mgm136044/kobi-robot/media/stills/kobi_v2_gesture_demo_f1630.png

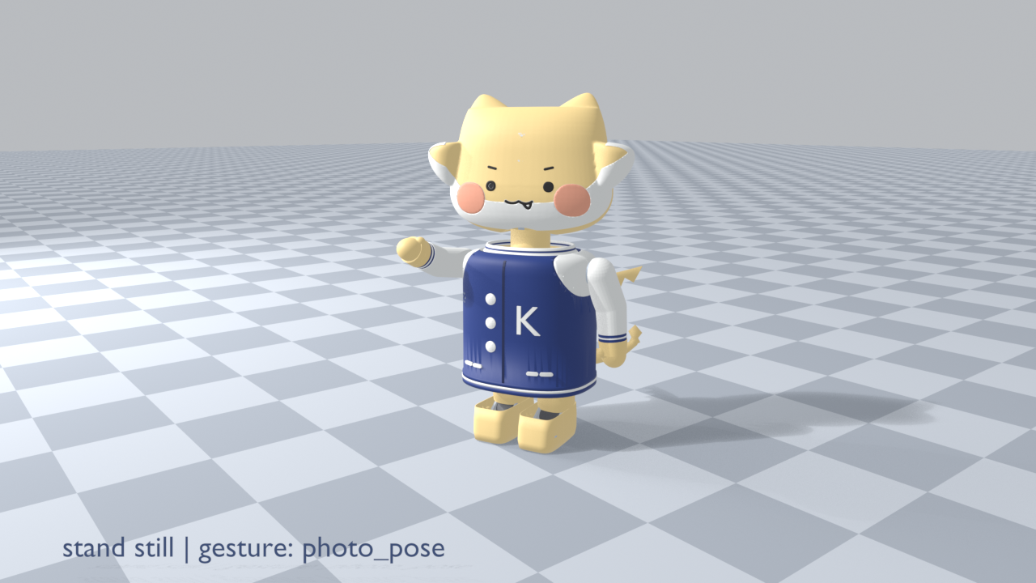
media/stills/kobi_v2_gesture_demo_f1630.png
