mgm136044/kobi-robot/README.md

# 코비(Kobi) 로봇: 소프트웨어 팀 인계 자료

코비는 키 약 0.6 m, 무게 2.78 kg의 작은 두 발 로봇입니다. 오픈소스 로봇 "Open Duck Mini v2"의 다리와 몸통 뼈대를 쓰고, 그 위에 대학 캐릭터 "코리"의 옷(외피)을 입혔습니다. 이 저장소에는 코비의 로봇 모델 파일(URDF, MuJoCo), 3D 프린트 파일, 학습된 걷기 및 몸짓 정책, 정책을 돌려 보는 도구, 시연 영상이 들어 있습니다.

이 문서는 소프트웨어 팀이 코비를 시뮬레이션에서 움직이고, 정책을 다른 소프트웨어(리타게팅, 실기 제어 등)에 연결할 수 있도록 쓴 설명서입니다. 모든 숫자는 이 저장소 안의 파일이나, 저장소 밖에 있는 개발 기록 파일에서 읽은 값이며, 각 절 끝의 "출처" 줄에 파일 이름을 적었습니다. 직접 다시 돌려서 확인한 값은 그렇게 표시했습니다.

**꼭 알아 둘 점: 이 저장소의 모든 성능 숫자는 시뮬레이션에서 잰 값입니다. 실제 로봇에서 정책을 돌린 기록은 이 저장소에 없습니다.**

## 목차

1. 용어 풀이
2. 로봇 소개
3. 폴더 지도
4. 관절 14개
5. 좌표계와 단위
6. URDF와 MuJoCo 장면 불러오기
7. 정책의 입출력 규칙
8. 도구 실행 방법
9. 최종 정책의 측정 결과
10. 알려진 문제
11. 학습 환경은 어떻게 다른가
12. LCD 얼굴 판
13. 라이선스와 출처
14. 애니메이션용 스켈레톤(리그) 파일

## 1. 용어 풀이

- **URDF**: 로봇의 뼈대(링크와 관절), 질량, 관성, 모양을 적는 XML 파일 형식입니다. 많은 로봇 소프트웨어가 읽습니다.
- **MJCF**: MuJoCo 물리 엔진이 쓰는 XML 파일 형식입니다. 이 저장소에서는 `kobi_scene.xml`이 MJCF입니다.
- **MuJoCo**: 로봇 물리 시뮬레이터입니다. 이 저장소의 도구는 MuJoCo 3.14.0으로 확인했습니다.
- **MJX**: MuJoCo를 GPU에서 대량으로 돌리게 해 주는 JAX 버전입니다. 정책은 MJX 3.3.4와 brax PPO로 학습했습니다.
- **PPO**: 강화학습 알고리즘 하나입니다.
- **ONNX**: 학습된 신경망을 프레임워크와 상관없이 실행하게 해 주는 파일 형식입니다. `onnxruntime`으로 읽습니다.
- **정책(policy)**: 관측값 101개를 받아 행동값 14개를 내놓는 신경망입니다.
- **백래시(backlash)**: 기어 사이의 헐거움 때문에 서보 축이 조금 흔들리는 현상입니다. 학습용 장면에는 이를 흉내 낸 가짜 관절이 들어 있습니다.
- **STS3215, MG90S**: 코비가 쓰는 서보 모터 모델 이름입니다. STS3215는 다리와 목, MG90S는 어깨에 씁니다.
- **홈 자세(home pose)**: 코비가 가만히 서 있는 기준 자세입니다. MJCF의 키프레임 `home`으로 정의되어 있습니다.
- **제어 주기**: 정책이 행동을 새로 내놓는 간격입니다. 코비는 초당 50번(50 Hz, 한 번에 0.02초)입니다.

## 2. 로봇 소개

- 뼈대: Open Duck Mini v2(Antoine Pirrone, Apache-2.0)의 다리와 몸통 구조에서 엉덩이 간격을 좁힌 것입니다. 자세한 변경점은 `NOTICE.md`에 있습니다.
- 외피: 3D 프린트로 만든 "코리" 캐릭터 옷(재킷, 꼬리, 날개, 머리 껍데기, 흰 얼굴, 팔 소매, 발 덮개 등)입니다.
- 무게: MJCF의 모든 몸체 질량을 합치면 2.7789782 kg입니다.
- 크기: 홈 자세에서 외형 메시(겉모양 3D 모델)를 모두 모아 재면 높이 0.595 m, 좌우 폭 0.354 m, 앞뒤 길이 0.227 m입니다(이 저장소의 MJCF로 직접 쟀습니다).
- 구동기 14개: 다리 서보 10개(STS3215), 목 서보 2개(좌우 돌리기 `neck_yaw`, 끄덕임 `neck_pitch`, STS3215), 어깨 마이크로 서보 2개(MG90S).
- 정책: MuJoCo 시뮬레이터에서 MJX와 brax PPO로 151,388,160 걸음(약 1억 5,100만 걸음) 학습했습니다. 걷기와 14가지 몸짓(목과 어깨 움직임)을 함께 합니다.

출처: `printed_face/mujoco/kobi_scene.xml`(질량 합과 크기는 직접 계산), 학습 걸음 수는 `코비_학습/TODO.md`와 개발 기록 `kobi_v2_training_results`(둘 다 저장소 밖 파일).

## 3. 폴더 지도

```
kobi-robot/
  README.md                  이 문서
  NOTICE.md                  출처, 라이선스, 우리가 바꾼 점
  LICENSES/Apache-2.0.txt    Open Duck Mini의 Apache-2.0 라이선스 원문
  printed_face/              인쇄 얼굴 판(현재 완성된 코비)
    urdf/                      kobi.urdf(메시 포함), kobi_gait.urdf(목, 어깨 고정, 메시 없음), assets/(STL 60개 + 내려받는 11개)
    mujoco/                    kobi_scene.xml, kobi_scene_backlash.xml(학습용), assets/(STL 80개 + 내려받는 28개)
    print/                     3D 프린트용 STL 96개(body, face, head, mech 폴더)와 parts_table.json, fit_coupon.stl
    blender/kobi_v7.blend      블렌더 모델(61 MB, 코리 참고 그림 이미지와 개인 경로를 지움)
    skeleton/                  애니메이션용 스켈레톤: kobi_rig.blend/.fbx/.glb, kobi_skeleton.bvh, skeleton.json, README.md(14절)
  policy/
    kobi_v2_final_151M.onnx              최종 정책
    lcd_face/                            LCD 얼굴 판 정책(ONNX 1개)과 평가 결과 JSON 5개(12절)
    polynomial_coefficients_kobi.pkl     기준 걸음 데이터(학습 때 모방 대상)
    kobi_gestures.py                     몸짓 14가지(거울 대칭 포함 22개) 정의
  tools/                     정책 재생기, 평가기, URDF 생성기와 검사기
    skeleton/                  스켈레톤 추출, 리그 생성(Blender), 검증 도구(14절)
  media/                     시연 영상 MP4 2개와 정지화면 8장
  lcd_face/                  LCD 얼굴 판(모델 7b판, 2차 공개): MuJoCo 장면, 프린트 파일, Blender 모델, 부품표 v12, 인쇄 부품 질량(mass/), 시연 영상, 조립 설명서(manual/), 소프트웨어 인계 문서(SOFTWARE_HANDOFF.md), README(12절)
```

`printed_face/mujoco/` 한 폴더에 일반 장면(`kobi_scene.xml`)과 학습용 장면(`kobi_scene_backlash.xml`)을 함께 두었습니다. 두 장면이 쓰는 메시 파일이 바이트 단위로 같고 `kobi_scene.xml`도 두 원본이 같아서, 같은 `assets/` 폴더를 같이 씁니다.

저장소 밖의 생성 파일(`out/`)은 도구를 돌리면 저장소 맨 위에 생기며 `.gitignore`로 제외했습니다.

## 4. 관절 14개

정책의 관측, 행동, MJCF의 구동기 순서가 모두 아래 표의 순서(0부터 13)입니다. URDF의 관절 순서도 같지만, 다른 도구로 읽을 때는 순서에 기대지 말고 이름으로 찾는 것이 안전합니다.

| 번호 | 이름 | 하는 일 | 움직일 수 있는 범위 (도) | 범위 (라디안) | 홈 자세 값 (라디안) | 회전축(자기 몸체 기준) | 토크 한계 (N·m) |
|---|---|---|---|---|---|---|---|
| 0 | left_hip_yaw | 왼쪽 엉덩이 비틀기 | -30 ~ 30 | -0.5236 ~ 0.5236 | 0.002 | z | 1.91 |
| 1 | left_hip_roll | 왼쪽 엉덩이 옆으로 벌리기 | -25 ~ 25 | -0.4363 ~ 0.4363 | 0.053 | z | 1.91 |
| 2 | left_hip_pitch | 왼쪽 엉덩이 앞뒤 | -70 ~ 30 | -1.2217 ~ 0.5236 | -0.9303 | z | 1.91 |
| 3 | left_knee | 왼쪽 무릎 | -90 ~ 90 | -1.5708 ~ 1.5708 | 1.3812 | z | 1.91 |
| 4 | left_ankle | 왼쪽 발목 | -90 ~ 90 | -1.5708 ~ 1.5708 | -0.4815 | z | 1.91 |
| 5 | right_hip_yaw | 오른쪽 엉덩이 비틀기 | -30 ~ 30 | -0.5236 ~ 0.5236 | -0.003 | z | 1.91 |
| 6 | right_hip_roll | 오른쪽 엉덩이 옆으로 벌리기 | -25 ~ 25 | -0.4363 ~ 0.4363 | -0.065 | z | 1.91 |
| 7 | right_hip_pitch | 오른쪽 엉덩이 앞뒤 | -30 ~ 70 | -0.5236 ~ 1.2217 | 0.9353 | z | 1.91 |
| 8 | right_knee | 오른쪽 무릎 | -90 ~ 90 | -1.5708 ~ 1.5708 | 1.3922 | z | 1.91 |
| 9 | right_ankle | 오른쪽 발목 | -90 ~ 90 | -1.5708 ~ 1.5708 | -0.4871 | z | 1.91 |
| 10 | neck_yaw | 목 좌우 돌리기 | -30 ~ 30 | -0.5236 ~ 0.5236 | 0 | z | 1.91 |
| 11 | neck_pitch | 목 끄덕임 | -10 ~ 10 | -0.1745 ~ 0.1745 | 0 | y | 1.91 |
| 12 | shoulder_left | 왼쪽 어깨 | -135 ~ 25 | -2.356 ~ 0.4363 | 0 | y | 0.20 |
| 13 | shoulder_right | 오른쪽 어깨 | -135 ~ 25 | -2.356 ~ 0.4363 | 0 | y | 0.20 |

표를 읽을 때 알아 둘 점은 다음과 같습니다.

- **왼쪽과 오른쪽 다리는 부호가 거울처럼 반대인 관절이 있습니다.** 엉덩이 앞뒤(hip_pitch)는 왼쪽이 -0.93, 오른쪽이 +0.94가 홈 자세이고, 범위도 -70~30도와 -30~70도로 서로 뒤집혀 있습니다. 엉덩이 옆으로 벌리기(hip_roll)도 부호가 반대입니다(+0.053, -0.065). 무릎은 두 다리 모두 양수(약 1.38, 1.39), 발목은 두 다리 모두 음수(약 -0.48, -0.49)입니다.
- **토크 한계 1.91 N·m는 사용자가 정한 값입니다.** STS3215 서보의 7.4 V 정지 토크 자료값이며, URDF에는 effort 1.91로 들어 있습니다. 그런데 `kobi_scene.xml` 파일 안의 구동기 힘 범위는 ±3.23 N·m로 적혀 있습니다. 학습할 때는 코드(`tools/kobi_env_mirror.py`의 `apply_torque_limits`)가 시작할 때 다리와 목을 ±1.91, 어깨를 ±0.20으로 덮어씁니다. 정책을 재생하려면 이 덮어쓰기가 필요하므로, XML만 불러서 직접 돌리면 학습 때보다 힘이 큰 로봇이 됩니다.
- **어깨의 0.20 N·m는 근거를 확인하지 못한 값입니다.** MJCF에 적힌 값을 그대로 썼고, URDF 생성기 주석에도 "source unconfirmed(출처 미확인)"라고 되어 있습니다.
- 속도 한계는 URDF에 5.24 rad/s로 들어 있습니다. 이는 학습 환경이 모터 목표값을 바꿀 수 있는 최대 속도입니다.
- 서보의 위치 제어 세기(kp)는 다리와 목이 일반 장면(`kobi_scene.xml`)에서 13.37, 학습용 장면(`kobi_scene_backlash.xml`)에서 17.11이고, 어깨는 두 장면 모두 1.0입니다. 감쇠 0.56, 마찰 손실 0.068, 전기자 관성 0.027은 다리와 목 서보 공통 값입니다.
- 학습용 장면은 다리 관절 10개마다 백래시용 가짜 관절(이름 끝이 `_backlash`, 범위 ±0.5도, 구동기 없음)이 하나씩 더 붙어 관절이 25개(구동기는 여전히 14개)입니다.

출처: `printed_face/mujoco/kobi_scene.xml`, `kobi_scene_backlash.xml`(MuJoCo 3.14.0으로 읽어 직접 출력), `printed_face/urdf/kobi.urdf`, `tools/build_urdf.py`, `tools/kobi_env_mirror.py`.

## 5. 좌표계와 단위

- **월드(세계) 좌표계**: MuJoCo 기준의 오른손 좌표계입니다. x는 로봇이 바라보는 앞쪽, y는 로봇의 왼쪽, z는 위쪽입니다. 바닥은 z = 0이고 중력은 -9.81 m/s²입니다.
- **단위**: 길이는 미터(m), 질량은 킬로그램(kg), 시간은 초(s), 각도는 라디안(rad), 토크는 N·m입니다. 속도는 m/s와 rad/s입니다. 예외로 3D 프린트용 STL(`printed_face/print/`)은 밀리미터(mm)입니다(부품표에 `size_mm`로 적혀 있습니다).
- **메시 파일의 크기 배율**: 일부 메시는 밀리미터 단위로 저장되어 있어 파일 안에 배율 0.001이 적혀 있습니다. 다른 메시는 배율 1입니다. URDF와 MJCF의 `scale` 값을 무시하지 마세요.
- **MuJoCo의 `base`와 `trunk_assembly`**: 질량이 0인 `base` 몸체가 자유 관절 `floating_base`(위치 3개, 사원수 4개)를 갖고, 그 안에 `trunk_assembly`(몸통, 1.28934 kg)가 같은 위치에 있습니다. URDF는 이 둘을 합쳐 `trunk_assembly`를 뿌리 링크로 씁니다.
- **홈 자세의 몸체 위치**: 키프레임 `home`에서 자유 관절 위치는 (0.0353725, 0, 0.206397) m, 방향은 사원수 (w, x, y, z) = (1, 0, 0, 0)입니다.
- **사원수 순서**: MuJoCo는 (w, x, y, z)입니다. ROS 등은 (x, y, z, w)이므로 변환이 필요합니다.
- **관성 측정 장치(IMU)**: 자이로(각속도)와 가속도계는 `imu` 위치점에 달려 있고, 위치는 `trunk_assembly` 기준 (-0.08, 0, 0.05) m입니다. 관측값에 들어가는 자이로와 가속도 값은 이 점의 몸체 좌표입니다.
- **발 위치점**: `left_foot`, `right_foot`(URDF에는 `left_foot_frame`, `right_foot_frame`). 정책이 발 접촉을 판단할 때는 TPU 발바닥 메시 `left_foot_bottom_tpu`, `right_foot_bottom_tpu`와 바닥 `floor`의 접촉을 봅니다.
- **몸짓 부호 약속**: `neck_yaw`가 양수이면 머리가 로봇의 왼쪽으로 돌아갑니다. `neck_pitch`가 양수이면 고개를 숙입니다. 어깨는 음수이면 팔이 앞쪽 위로 올라가고, 양수이면 뒤로 젖혀집니다(양쪽 어깨 부호 약속이 같습니다).
- **블렌더 파일의 방향**: `kobi_v7.blend` 안의 코비는 MuJoCo의 +x가 아니라 -y 방향을 바라봅니다. MuJoCo 좌표에서 블렌더 좌표로 갈 때 z축 기준 -90도 회전이 필요합니다.

출처: `printed_face/mujoco/kobi_scene.xml`, `printed_face/urdf/kobi.urdf`, `policy/kobi_gestures.py`의 머리말, `코비_학습/video/README.md`(저장소 밖).

## 6. URDF와 MuJoCo 장면 불러오기

### 6.0 처음 한 번 할 일: 업스트림 메시 내려받기

**저장소를 받은 뒤 가장 먼저 아래 명령을 한 번 실행하세요.** 이 명령 없이 URDF나 MuJoCo 장면을 열면 메시 파일이 없다는 오류가 납니다.

```
python3 tools/fetch_upstream_meshes.py
```

이 명령은 `lcd_face/mujoco/assets/`에도 같은 28개를 내려받습니다(LCD 얼굴 판 장면이 같은 메시를 씁니다). 이유는 다음과 같습니다. 뼈대 부품 메시 28개(`printed_face/mujoco/assets/`, 그 가운데 11개는 `printed_face/urdf/assets/`에도 필요)는 Open_Duck_Playground 저장소에 있는 단순화된 파일인데, 그 저장소에 라이선스가 없어서 우리가 이 저장소에 담아 다시 배포할 수 없습니다. 그래서 이 스크립트가 GitHub의 고정된 커밋(`b9be205ac64488c23504ca42e5ec790337adeec3`)에서 정확히 그 파일들만 내려받고, 스크립트 안의 SHA-256 표와 하나씩 맞춰 본 뒤에만 저장합니다. 해시가 다르면 파일을 쓰지 않습니다. 이미 맞는 파일이 있으면 건너뜁니다. 파이썬 표준 라이브러리만 쓰며 인터넷이 필요합니다. `python3 tools/fetch_upstream_meshes.py --check`는 내려받지 않고 확인만 합니다. 자세한 사정은 `NOTICE.md` 3절에 있습니다.

### 6.1 불러오기

먼저 파이썬 환경을 만듭니다(전역 설치 없이 `uv`로 임시 환경을 씁니다).

```
uv run --no-project --python 3.12 --with mujoco==3.14.0 --with numpy --with onnxruntime python -I 스크립트.py
```

MuJoCo 장면 불러오기는 다음과 같습니다.

```python
import mujoco
model = mujoco.MjModel.from_xml_path("printed_face/mujoco/kobi_scene.xml")
data = mujoco.MjData(model)
key = mujoco.mj_name2id(model, mujoco.mjtObj.mjOBJ_KEY, "home")
mujoco.mj_resetDataKeyframe(model, data, key)
mujoco.mj_forward(model, data)
```

`tools/fetch_upstream_meshes.py`를 실행한 뒤, MuJoCo 3.14.0으로 직접 불러 본 결과(이 저장소의 폴더 배치 그대로)는 다음과 같습니다.

| 파일 | 몸체 수(nbody) | 관절 수(njnt) | 구동기 수(nu) | 비고 |
|---|---|---|---|---|
| `printed_face/mujoco/kobi_scene.xml` | 18 | 15 | 14 | 자유 관절 1개 + 14개, 상태 변수(nq) 21개 |
| `printed_face/mujoco/kobi_scene_backlash.xml` | 18 | 25 | 14 | 백래시 관절 10개 추가, nq 31개 |
| `printed_face/urdf/kobi.urdf` | 21 | 14 | 0 | 자유 관절이 없음(MuJoCo가 읽으면 고정 몸체), 메시 71개 |
| `printed_face/urdf/kobi_gait.urdf` | 21 | 10 | 0 | 목과 어깨 4개가 고정되어 관절 10개, 메시 없음 |

(몸체 수 18은 `world`, `base`, 몸통, 다리 몸체 10개, 목 2개, 팔 2개, 바닥 `floor`를 센 값입니다. URDF의 21은 `world`와 링크 20개입니다.)

URDF를 쓰는 방법과 주의할 점은 다음과 같습니다.

- `printed_face/urdf/kobi.urdf`의 메시 경로는 `assets/...`처럼 URDF 파일 위치 기준 상대 경로입니다. 파일을 옮길 때는 `assets/` 폴더를 같이 옮기세요.
- `kobi_gait.urdf`는 걸음 기준 데이터를 만드는 도구(placo)용입니다. 목과 어깨를 0도에 고정해서, 걸음 생성기가 무게 중심을 맞추려고 머리와 팔을 멋대로 움직이지 못하게 했습니다.
- 충돌 모양은 TPU 발바닥 두 개뿐입니다. MJCF의 다른 충돌 모양(캡슐, 타원체)은 URDF로 표현할 수 없어 뺐습니다.
- URDF는 MJCF를 읽어서 만든 것이고, 질량, 무게 중심, 관성은 MuJoCo가 실제로 시뮬레이션하는 값과 같습니다. `tools/check_urdf.py`가 이를 확인하며, 이 저장소에서 다시 돌려 통과했습니다(`"ok": true`; 무작위 관절 각도 200가지, 전체 질량 오차 0, 링크 자세 오차 약 1e-9 m, 메시 꼭짓점 오차 약 6.6e-7 m, 관성 상대 오차 약 2.6e-9).
- 개발 기록에는 pinocchio 4.1.0으로 URDF를 읽어도 질량과 무게 중심이 같았다고 적혀 있습니다(이번에 다시 확인하지는 않았습니다).
- 모델이 바뀌면 URDF를 다시 만드세요. `tools/build_urdf.py`를 돌린 뒤 `tools/check_urdf.py`를 돌립니다. 다시 만든 URDF는 이 저장소의 파일과 한 줄(맨 위 설명 주석) 말고는 같았습니다.

출처: `tools/check_urdf.py` 실행 결과(직접 실행), `tools/build_urdf.py`, 개발 기록 `kobi_urdf_export`(저장소 밖).

## 7. 정책의 입출력 규칙

정책 파일은 `policy/kobi_v2_final_151M.onnx`입니다(SHA-256 `3d5367279866c7e718c5d3fc22e51fb144d9ae5a6d753c0b865bd96dabc6cd6b`). 입력 이름은 `obs`, 모양은 [1, 101], 자료형은 float32입니다. 출력 이름은 `continuous_actions`, 모양은 [1, 14]입니다. 관측값 정규화는 ONNX 파일 안에 들어 있으므로 바깥에서 정규화하지 않습니다. 출력은 tanh를 거친 값이라 -1에서 1 사이입니다.

이 규칙은 학습 환경의 코드를 그대로 옮긴 `tools/kobi_env_mirror.py`에서 읽었습니다. 정책을 다른 소프트웨어에 붙일 때 이 파일을 기준 문서로 삼으세요.

### 7.1 시간 간격

- 제어 주기: 0.02초(50 Hz). 정책은 이 간격으로 한 번씩 행동을 냅니다.
- 물리 시뮬레이션 간격: 0.002초(500 Hz). 제어 한 번마다 물리를 10번 진행합니다.

### 7.2 관측 벡터 101개의 배치

| 위치 | 개수 | 이름 | 뜻 |
|---|---|---|---|
| [0:3] | 3 | gyro | IMU의 각속도(rad/s), 몸체 좌표 |
| [3:6] | 3 | accelerometer | IMU의 가속도(m/s²), 몸체 좌표 |
| [6:13] | 7 | command | 명령 7개: [vx, vy, wz, 목 좌우 목표, 목 끄덕임 목표, 왼쪽 어깨 목표, 오른쪽 어깨 목표] |
| [13:27] | 14 | joint_angles_minus_home | 관절 각도에서 홈 자세 값을 뺀 것(rad), 4절 표의 순서 |
| [27:41] | 14 | joint_velocity_x0.05 | 관절 속도(rad/s)에 0.05를 곱한 것 |
| [41:55] | 14 | last_action | 지난 행동 기록 첫째 칸(아래 주의 참고) |
| [55:69] | 14 | last_last_action | 지난 행동 기록 둘째 칸 |
| [69:83] | 14 | last_last_last_action | 지난 행동 기록 셋째 칸 |
| [83:97] | 14 | motor_targets | 직전에 모터에 준 목표 각도(rad, 속도 제한을 거친 값) |
| [97:99] | 2 | foot_contacts | 왼발, 오른발 발바닥이 바닥에 닿으면 1, 아니면 0 |
| [99:101] | 2 | imitation_phase | 걸음 주기의 위상 (cos, sin) |

합계는 3 + 3 + 7 + 14 + 14 + 14 + 14 + 14 + 14 + 2 + 2 = 101입니다.

각 항목에서 놓치기 쉬운 점입니다.

- **지난 행동 기록 세 칸은 직전 행동이 아닙니다.** 학습 환경은 관측을 만든 뒤에 행동 기록을 한 칸 밀기 때문에, 제어 단계 k의 관측에는 a(k-2), a(k-3), a(k-4)가 들어 있습니다. 가장 최근 행동 a(k-1)은 들어 있지 않습니다. 업스트림(원본 Open Duck Mini 런타임)의 `mujoco_infer.py`는 a(k-1), a(k-2), a(k-3)을 넣으므로, 그 코드를 그대로 쓰면 학습 때와 어긋납니다.
- **가속도계에 1.3을 더하지 마세요.** 업스트림 런타임은 가속도 x에 +1.3을 더하는데, 학습 환경에서는 그 덧셈이 버려져 학습 관측에는 없습니다.
- **관절 각도**: 시뮬레이션에서는 다리 관절 10개의 각도에 백래시 가짜 관절의 각도를 더한 값을 씁니다. 관절 속도에는 백래시 속도를 더하지 않습니다.
- **발 접촉**: 발바닥 메시가 바닥 면과 실제로 겹칠 때(거리가 0보다 작을 때) 1입니다.
- **걸음 위상**: 제어 단계마다 한 칸씩 늘어나는 번호 i를 쓰며 한 주기가 27단계(0.54초)입니다. 값은 (cos(2πi/27), sin(2πi/27))이고, 시작할 때는 (0, 0)입니다. 위상은 명령이 0이어도 계속 돕니다.
- **관측 잡음**: 학습할 때만 넣었습니다. 각 항목에 균등 분포로 ±(크기)를 더했고 크기는 자이로 0.1, 가속도 0.05, 엉덩이 각도 0.03, 무릎 각도 0.05, 발목 각도 0.08, 목과 어깨 각도 0.05, 관절 속도 2.5입니다. 재생 도구는 기본값 0이고 `--noise-level 1.0`으로 학습 때와 같게 할 수 있습니다.
- 학습할 때는 행동이 모터에 닿기까지 0~2단계(0, 20, 40 ms) 늦어지는 경우를 무작위로 섞었습니다. 재생 도구의 기본값은 0단계입니다.

### 7.3 행동 벡터 14개와 크기 조정

행동 14개의 순서는 4절 표의 번호와 같습니다.

- **다리(번호 0~9)**: 모터 목표 각도 = 홈 자세 값 + 0.25 × 행동. 행동이 ±1이면 홈에서 ±0.25 rad(약 14도) 움직입니다.
- **목과 어깨(번호 10~13)**: 모터 목표 각도 = clip(몸짓 목표 + 보정 크기 × 행동, 관절 범위). 보정 크기는 목 좌우 0.10 rad, 목 끄덕임 0.05 rad, 어깨 둘 다 0.15 rad입니다. 정책은 몸짓 목표를 중심으로 이만큼만 미세 조정할 수 있습니다. 목과 어깨를 정책에 직접 시키는 것이 아니라, 몸짓 목표를 따라가게 하는 구조입니다.
- **속도 제한**: 위에서 계산한 목표를 이전 목표에서 최대 5.24 rad/s × 0.02 s = 0.1048 rad까지만 바꿀 수 있게 자릅니다. 14개 모두에 적용됩니다.
- 모터에는 이 최종 목표를 위치 명령으로 줍니다.

### 7.4 명령 입력

관측의 command 일곱 칸 중 앞의 세 칸이 걷기 명령입니다.

| 칸 | 뜻 | 학습 범위 | 단위 |
|---|---|---|---|
| vx | 앞으로 가는 속도(뒤로 가려면 음수) | -0.15 ~ 0.15 | m/s |
| vy | 왼쪽으로 가는 속도(오른쪽은 음수) | -0.074 ~ 0.074 | m/s |
| wz | 위에서 봤을 때 반시계 방향 회전 속도 | -1.0 ~ 1.0 | rad/s |

- 범위를 벗어난 명령은 학습한 적이 없으므로 쓰지 마세요. vy를 ±0.074로 제한한 이유는, 기준 걸음 데이터의 옆걸음 격자가 거기까지이고 더 빠르면 발 덮개끼리 부딪히기 때문입니다.
- 학습 중 걷기 명령은 10%의 확률로 모두 0(제자리)이 됩니다.
- 속도는 몸체 좌표 기준입니다.

### 7.5 몸짓 입력

command의 뒤 네 칸(번호 3~6)은 "몸짓 목표 각도"입니다. 순서는 목 좌우, 목 끄덕임, 왼쪽 어깨, 오른쪽 어깨이며 절대 각도(라디안), 홈 자세는 0입니다. 정책에는 몸짓의 이름이나 번호를 알려 주지 않고, 매 제어 단계(50 Hz)마다 그 순간의 목표 각도 네 개를 넣어 줍니다. 몸짓은 걷기 명령과 독립이라서 서 있을 때도, 걸을 때도 할 수 있습니다.

`policy/kobi_gestures.py`가 몸짓을 정의합니다. 각 몸짓은 키프레임(시간, 목 좌우, 목 끄덕임, 왼쪽 어깨, 오른쪽 어깨, 단위는 도)의 목록이고, 사이는 코사인 곡선으로 부드럽게 잇습니다. `sample()` 함수가 50 Hz 목표 각도 배열(라디안)을 만들어 줍니다. 목표는 관절 범위 안쪽 2도 이내에 두고, 최대 속도는 초당 200도로 제한했습니다.

| 이름 | 뜻 | 길이(초) |
|---|---|---|
| idle | 대기 | 2.0 |
| look_left_right | 고개 좌우 시범 | 3.0 |
| nod | 끄덕임 | 1.9 |
| shake_no | 고개 젓기("아니야") | 1.5 |
| wave_right | 인사(오른손 흔들기) | 3.2 |
| bow | 꾸벅 인사 | 1.9 |
| guide_left | 안내(왼쪽) | 3.1 |
| cheer | 응원, 파이팅 | 3.6 |
| celebrate | 축하, 만세 | 3.4 |
| photo_pose | 사진 포즈 | 3.8 |
| surprise | 놀람 | 2.0 |
| look_far | 멀리 보기 | 4.2 |
| think | 생각하기, 관찰 | 2.6 |
| like | 좋아 | 2.4 |

위 14개에 거울 대칭 8개(`look_right_left`, `shake_no_mirror`, `wave_left`, `guide_right`, `cheer_mirror`, `photo_pose_mirror`, `look_far_mirror`, `think_mirror`)를 더해 모두 22개입니다. 거울 대칭은 목 좌우 부호를 바꾸고 양쪽 어깨를 맞바꾼 것입니다. 학습할 때는 몸짓을 0.8~1.25배 속도로 재생했고, 몸짓 사이에 대기(idle)를 1~3초 끼웠습니다.

### 7.6 기준 걸음 데이터

`policy/polynomial_coefficients_kobi.pkl`은 학습 때 "이렇게 걸어라" 하고 모방하게 한 기준 걸음입니다. 파이썬 pickle 파일이므로 신뢰하는 파일만 여십시오(pickle은 열 때 코드를 실행할 수 있습니다). 이 저장소의 도구는 이 파일에서 걸음 주기(0.54초, 50 Hz, 27단계)만 읽습니다. 내용은 속도 명령 격자 180칸(앞뒤 6가지, 옆 3가지, 회전 10가지)마다 다항식 계수가 28채널 들어 있습니다(다리 관절 위치 10, 속도 10, 발 접촉 2, 월드 선속도 3, 월드 각속도 3). 앞뒤 속도 격자는 -0.148~0.222 m/s, 옆 속도 격자는 -0.074, 0, 0.074 m/s, 회전 격자는 -1.111~1.222 rad/s입니다. 이 걸음은 `kobi_gait.urdf`를 걸음 생성기(placo 기반)에 넣어 만든 것입니다.

기준 걸음의 한계로 개발 기록에는 다음 값이 있습니다. 엉덩이 앞뒤 관절 목표가 관절 범위를 넘는 비율이 두 다리에서 각각 4.7%와 8.8%이고, 180칸 중 11칸에서 발 덮개가 최대 2.5 mm 겹칩니다.

출처: `tools/kobi_env_mirror.py`(관측 배치, 행동 규칙, 상수), `policy/kobi_gestures.py`, `policy/polynomial_coefficients_kobi.pkl`(직접 열어 확인), ONNX 입출력 모양(onnxruntime으로 직접 확인), 명령 범위는 학습 환경 `joystick.py`의 설정(저장소 밖)과 `tools/schedule.py` 주석, 기준 걸음 한계는 `코비_학습/playground_kobi/CHANGES.md`(저장소 밖).

## 8. 도구 실행 방법

모든 명령은 저장소 맨 위 폴더에서 실행합니다. 6.0절의 메시 내려받기(`python3 tools/fetch_upstream_meshes.py`)를 먼저 해야 합니다. 실행에 필요한 것은 `uv`와 인터넷(처음 한 번 패키지 내려받기)뿐입니다. 파이썬 3.12, `mujoco==3.14.0`, `numpy`, `onnxruntime`을 임시 환경으로 씁니다. 이 도구들은 학습에 쓴 MJX 3.3.4가 아니라 일반 MuJoCo(C 버전) 3.14.0으로 정책을 재생하므로, 접촉 계산이 미세하게 다를 수 있습니다.

### 8.1 정책 재생기: `tools/record_policy.py`

정책을 시뮬레이션에서 돌려 몸체 자세를 파일로 저장합니다.

```
uv run --no-project --python 3.12 --with onnxruntime --with mujoco==3.14.0 --with numpy python -I tools/record_policy.py \
    --policy policy/kobi_v2_final_151M.onnx --schedule walk_demo --out out/walk_demo.npz
```

- `--schedule`로 명령 일정을 고릅니다. `preview`(16.2초, 기본값), `walk_demo`(38초: 앞으로, 돌기, 뒤로, 옆걸음), `gesture_demo`(63.5초: 몸짓 14가지를 서서 한 뒤 걸으며 손 흔들기, 끄덕이기, 환호).
- `--dry-run`을 주면 정책 없이 행동 0으로 돕니다.
- 기본 저장 위치는 `out/policy_motion.npz`입니다. `--noise-level`(기본 0), `--action-delay`(기본 0, 0~2단계)로 학습 때 조건을 흉내 낼 수 있습니다.
- 저장 파일에는 몸체 위치 `xpos`(프레임 수 × 몸체 수 × 3), 방향 `xquat`(프레임 수 × 몸체 수 × 4, 순서 w x y z), 초당 프레임 수 `fps`(50), 그리고 관측 `obs`, 행동 `actions`, 모터 목표 `motor_targets`, 명령 `commands`, 몸짓 목표 `upper_targets`가 들어 있습니다.
- 직접 확인한 결과: 기본 일정(`preview`)은 이 Mac에서 약 4초에 끝나고 810프레임(16.2초)을 저장했으며, 넘어지지 않았습니다. 같은 일정을 원본 폴더의 원본 파일로 돌린 결과와 `xpos`, `xquat`, `obs`, `actions`가 모두 정확히 같았습니다.

### 8.2 정책 평가기: `tools/evaluate_policy.py`

속도 추종 11가지, 밀기 192회, 몸짓 88회를 한꺼번에 재고 결과를 JSON으로 저장합니다.

```
uv run --no-project --python 3.12 --with onnxruntime --with mujoco==3.14.0 --with numpy python -I tools/evaluate_policy.py \
    --policy policy/kobi_v2_final_151M.onnx --tag final --workers 6 --no-motions
```

- 결과는 `out/eval_final.json`에 저장됩니다. `--quick`은 조건마다 한 번만 돌립니다. `--action-delay 1`이나 `2`로 행동 지연을 줄 수 있습니다.
- 학습 때처럼 관측 잡음 1.0, 행동 지연 0, 홈 자세에서 시작하는 결정적 출발을 기본으로 합니다. 넘어짐은 몸통이 60도보다 더 기울면 넘어진 것으로 칩니다.
- 이 Mac(Apple 실리콘)에서 346회 전체가 작업자 6개로 약 6.6초 걸렸습니다.

### 8.3 제자리 서기 검사기: `tools/stand_still_probe.py`

걷기 명령이 0일 때 발이 바닥에 얼마나 닿는지 잽니다(10절의 "제자리 걸음" 근거).

```
uv run --no-project --python 3.12 --with onnxruntime --with mujoco==3.14.0 --with numpy python -I tools/stand_still_probe.py
```

### 8.4 URDF 생성기와 검사기: `tools/build_urdf.py`, `tools/check_urdf.py`

```
uv run --no-project --python 3.12 --with mujoco==3.14.0 --with numpy python -I tools/build_urdf.py
uv run --no-project --python 3.12 --with mujoco==3.14.0 --with numpy python -I tools/check_urdf.py
```

생성기는 `printed_face/urdf/`의 파일을 덮어씁니다. 확인만 하려면 검사기만 돌리세요.

### 8.5 이 저장소에 없는 도구

블렌더로 MP4를 렌더링하는 스크립트(`animate_motion.py`, `render_motion.py`), 환경 거울이 학습 환경과 같은지 검사하는 `check_env_mirror.py`는 넣지 않았습니다. 뒤의 것은 학습 환경 소스(라이선스가 없는 업스트림을 바탕으로 한 것이라 이 저장소에 넣지 않았습니다)를 읽어야 돌아가기 때문입니다. 시연 영상은 `media/`에 이미 렌더된 것이 있습니다.

### 8.6 경로를 바꾼 곳

도구는 원본을 복사한 것이며 아래 경로 설정만 이 저장소 배치에 맞게 고쳤습니다. 계산 코드는 바꾸지 않았습니다.

- `tools/kobi_env_mirror.py`: 학습 환경 폴더의 절대 경로(내 컴퓨터 경로)를 저장소 안의 상대 경로(`printed_face/mujoco/kobi_scene_backlash.xml`, `policy/polynomial_coefficients_kobi.pkl`)로 바꿨습니다. 머리말 설명에서도 절대 경로를 뺐습니다.
- `tools/record_policy.py`: 기본 저장 위치를 저장소 맨 위의 `out/`으로 바꾸고, 머리말의 실행 예를 새 경로로 고쳤습니다.
- `tools/evaluate_policy.py`: 기본 저장 폴더를 `out/`으로 바꿨습니다.
- `tools/schedule.py`: 몸짓 정의를 `policy/kobi_gestures.py`에서 찾도록 경로를 바꿨습니다.
- `tools/build_urdf.py`, `tools/check_urdf.py`: MJCF와 URDF 위치를 `printed_face/` 아래로 바꿨습니다. `build_urdf.py`가 URDF 첫머리에 쓰는 설명 주석의 경로도 같이 고쳤습니다.
- `tools/stand_still_probe.py`와 `tools/fetch_upstream_meshes.py`는 이번에 새로 쓴 도구입니다.

출처: `tools/` 폴더의 각 파일(직접 실행), 개발 기록 `kobi_video_pipeline`(저장소 밖).

## 9. 최종 정책의 측정 결과

정책은 `policy/kobi_v2_final_151M.onnx`(학습 1억 5,138만 걸음)입니다. 1억 4,000만 걸음 정책과 같은 방식으로 비교해, "최종이 뚜렷이 나쁘지 않으면 최종을 쓴다"는 정해 둔 규칙에 따라 최종을 골랐습니다(밀기에서 넘어진 횟수가 1억 4,000만 걸음 정책 84회, 최종 77회로 우연으로 볼 만한 차이였습니다).

**측정 조건**: 시뮬레이션(MuJoCo 3.14.0, 백래시 장면), 관측 잡음 1.0, 행동 지연 0, 홈 자세에서 출발, 346회 전체. 이 표는 이 저장소의 `tools/evaluate_policy.py`로 다시 돌려서 확인했고, 개발 기록의 값과 모두 같았습니다.

### 9.1 쓰러지지 않고 따라가는가

| 시험 | 횟수 | 넘어진 횟수 |
|---|---|---|
| 속도 추종(11가지 명령, 가지마다 6회) | 66 | 0 |
| 몸짓(22가지, 서서와 0.1 m/s로 걸으며, 2회씩) | 88 | 0 |
| 밀기(아래) | 192 | 77 |

몸짓 시험에서 목과 어깨가 목표를 따라가는 오차는 22가지 몸짓 중 가장 큰 관절별 평균 오차가 0.061 rad이고, 한 순간 가장 크게 벗어난 값은 0.123 rad였습니다. 몸통 기울기는 몸짓 시험에서 최대 7.2도였습니다.

### 9.2 명령한 속도와 실제 속도

10초 동안 잰 몸체 좌표 평균 속도입니다(6회 평균).

| 명령 | 실제 vx (m/s) | 실제 vy (m/s) | 실제 wz (rad/s) |
|---|---|---|---|
| 앞으로 vx = 0.05 | 0.058 | 0.014 | -0.009 |
| 앞으로 vx = 0.10 | 0.119 | 0.015 | -0.031 |
| 앞으로 vx = 0.15 | 0.166 | 0.015 | -0.019 |
| 뒤로 vx = -0.10 | -0.102 | -0.008 | -0.015 |
| 왼쪽 옆걸음 vy = +0.074 | 0.007 | 0.087 | -0.008 |
| 오른쪽 옆걸음 vy = -0.074 | 0.008 | -0.064 | 0.030 |
| 회전 wz = +0.5 | 0.010 | 0.037 | 0.502 |
| 회전 wz = -0.5 | 0.003 | -0.025 | -0.459 |
| 회전 wz = +1.0 | 0.018 | 0.071 | 0.977 |
| 회전 wz = -1.0 | 0.009 | -0.071 | -0.953 |
| 정지 (0, 0, 0) | 0.003 | 0.013 | 0.015 |

읽는 법: 앞으로 가는 속도는 명령보다 조금 빠르게(0.10을 시키면 0.119) 걷고, 걸을 때 옆으로 약 0.015 m/s씩 흘러갑니다. 회전은 명령과 가깝습니다. 정지 명령에서도 작은 떠돌이 속도(약 0.003~0.015)가 남습니다. 회전 명령에서도 옆 속도(vy)가 최대 0.071 m/s 남는데, 원인은 확인하지 않았습니다.

### 9.3 밀었을 때 버티는가

"밀기"는 로봇 몸체의 속도를 갑자기 바꾸는 시험입니다(학습 환경의 밀기와 같은 방식). 세기 0.25, 0.5, 0.75, 1.0 m/s를 로봇이 보는 방향 기준 8방향(45도 간격)으로 줍니다. 3초 안에 넘어지지 않으면 성공입니다. 서 있을 때 96회, 0.1 m/s로 걸을 때 96회, 모두 192회입니다.

| 세기 | 서 있을 때 성공 | 걸을 때 성공 |
|---|---|---|
| 0.25 m/s | 100% | 100% |
| 0.5 m/s | 92% | 83% |
| 0.75 m/s | 58% | 29% |
| 1.0 m/s | 12% | 4% |

넘어진 횟수는 서 있을 때 33/96, 걸을 때 44/96으로 합계 77/192(약 40%)입니다. 방향에 따라 편차가 있어서, 270도 방향이 가장 약했습니다(서 있을 때 성공 42%, 걸을 때 33%). 이 시험은 일부러 아주 세게 밀기 때문에 넘어짐이 많은 것이 정상입니다. 학습에서 쓴 밀기 세기 범위는 0.1~1.0 m/s였습니다. 정책은 2.78 kg 로봇이 서 있을 때 0.5 m/s 밀기까지는 대부분 버티지만, 0.75 m/s 이상에서는 자주 넘어집니다.

### 9.4 서보 토크와 발 덮개

- 속도 추종 시험에서 무릎 서보가 토크 한계(1.91 N·m)에 닿아 있는 시간이 약 18%(왼쪽 18.3%, 오른쪽 18.0%)입니다. 엉덩이 앞뒤는 약 7~8%, 발목은 약 4~6%입니다. 무릎에는 토크 여유가 거의 없다는 뜻입니다.
- 걸을 때 발 덮개가 바닥에 닿는 비율: 앞뒤와 옆걸음에서 왼쪽 덮개 8.3%, 오른쪽 덮개 26.9%(제어 단계 기준), 회전에서 각각 10.0%, 21.1%입니다. 가장 깊게 눌린 값은 약 1.8~2.4 mm였습니다. 두 발 덮개끼리나 덮개와 반대쪽 발바닥이 부딪힌 경우는 없었습니다.

출처: 직접 다시 돌린 `tools/evaluate_policy.py` 결과와 같은 값이 `코비_학습/video/out/eval_v2_final_151M.json`(저장소 밖)에 있습니다. 개발 기록 `kobi_v2_training_results`(저장소 밖)도 같은 값을 적고 있습니다.

## 10. 알려진 문제

1. **다리 보호대가 외투 뒤판의 스위치 판에 닿습니다.** 외피의 다리 보호대(`Leg_L_guard`, `Leg_R_guard`) 뒤쪽 끝이 걷는 동안 재킷 뒤판에 붙은 스위치와 충전 단자 판(service plate)과 겹칩니다. 최종 정책으로 측정한 겹침 깊이의 상한은 다음과 같습니다. 걸을 때(앞 0.15 m/s 명령) 왼쪽 보호대가 최대 4.16 mm, 오른쪽이 최대 2.46 mm입니다. 서서 밀기 시험에서는 오른쪽 6.68 mm, 왼쪽 5.65 mm까지 나옵니다. 서 있거나 제자리에서 돌 때는 겹치지 않았습니다. 홈 자세에서는 9.1 mm 떨어져 있습니다. 겹침은 보호대를 아래로 옮기면 해소되는 것으로 계산되었습니다. 이 문제는 외피(하드웨어) 설계 판단이 필요해서 고치지 않았습니다. 스위치, 단자 기판, 전선은 모델에 들어 있지 않으므로 실제 영향은 알 수 없습니다. 이전 중간 정책(4,300만 걸음)으로 걷게 했을 때는 오른쪽이 최대 5.48 mm, 왼쪽이 2.64 mm였으므로, 어느 쪽이 더 깊이 겹치는지는 정책에 따라 달라집니다.
2. **걷기 명령이 0이어도 제자리 걸음을 합니다.** 정지 명령 10초 동안(2초 안정화 뒤, 관측 잡음 없음) 왼발바닥은 71%, 오른발바닥은 58%의 제어 단계에서만 바닥에 닿아 있었고, 두 발이 모두 닿은 시간은 29%뿐이었습니다. 발이 다시 닿는 횟수는 왼쪽 18번, 오른쪽 27번이었습니다(`tools/stand_still_probe.py`로 직접 측정, 관측 잡음 1.0에서도 비슷했음). 몸이 흘러가는 속도는 거의 0이고 쓰러지지도 않지만(9.2절), 발을 바닥에 붙이고 가만히 서 있게 하려면 정책 밖에서 별도 처리가 필요할 수 있습니다. 원인은 확인하지 못했습니다. 한 가지 짐작으로는 걸음 위상 입력이 명령이 0일 때도 계속 돌고 있기 때문일 수 있습니다.
3. **행동이 20~40 ms 늦어지면 밀기에서 더 많이 넘어집니다.** 행동 지연을 0, 1, 2단계(0, 20, 40 ms)로 주고 같은 192회 밀기를 하면 넘어진 횟수가 77, 93, 103회로 늘었습니다(서 있을 때 33, 46, 53회, 걸을 때 44, 47, 50회). 속도 추종 66회와 몸짓 88회는 지연이 있어도 넘어지지 않았습니다. 실제 로봇의 통신 및 계산 지연이 20 ms를 넘지 않게 해야 합니다. 학습은 0~2단계 지연을 섞어서 했지만 이 시험에서는 지연이 늘수록 약해졌습니다(직접 `--action-delay 1`, `2`로 확인).
4. **무릎 서보가 토크 한계에 자주 닿습니다**(18%). 실제 서보의 토크가 1.91 N·m보다 약하거나 전원 전압이 낮으면 시뮬레이션보다 더 불안정할 수 있습니다.
5. **토크 한계 설정이 파일마다 다릅니다.** 4절에서 설명했듯이 XML은 ±3.23이고 학습과 URDF는 1.91입니다.
6. **옆걸음은 ±0.074 m/s까지만 학습했습니다.** 더 빠르면 발 덮개가 서로 부딪히기 때문입니다.
7. **시뮬레이터 차이**: 학습은 MJX 3.3.4(GPU), 이 저장소의 재생은 MuJoCo C 3.14.0(CPU)입니다. 접촉 계산이 조금 다릅니다. 개발 기록에는 학습 환경(JAX)과 재생기가 1e-8까지 같다고 되어 있습니다. 이번에는 이 저장소의 도구로 속도와 넘어짐 수가 개발 기록과 같음을 다시 확인했을 뿐, MJX 학습 환경과 직접 비교하지는 않았습니다.
8. **실제 로봇 검증이 없습니다.** 서보의 실제 지연, 마찰, 전압 강하, 센서 잡음, 서보 영점은 학습에 일부 무작위로 섞었을 뿐 실기에서 확인된 값이 아닙니다.

출처: 1번은 `코비_학습/interference/out/guard_depth_*.json`과 `코비_학습/TODO.md`(저장소 밖), 2번과 3번은 이 저장소의 `tools/stand_still_probe.py`, `tools/evaluate_policy.py --action-delay`를 직접 실행한 값(3번은 `코비_학습/verify_final/eval_extra_delay*.json`과도 같음), 4번은 평가기 결과, 6번은 `코비_학습/playground_kobi/CHANGES.md`.

## 11. 학습 환경은 어떻게 다른가

학습 환경 소스(`playground_kobi`)는 이 저장소에 넣지 않았습니다. 바탕이 된 업스트림 저장소(Open_Duck_Playground)에 라이선스가 없어서 코드를 다시 배포할 수 없기 때문입니다. 업스트림 저장소는 `NOTICE.md`에 링크를 달았습니다. 우리가 업스트림과 달리 만든 부분을 말로 설명하면 다음과 같습니다.

- **로봇 모델**: 오리 로봇 대신 코비 모델(목 2개, 어깨 2개 추가, 엉덩이 간격 변경, 외피 질량 반영)을 씁니다.
- **행동 공간**: 다리 10개에 목 2개와 어깨 2개를 더해 행동이 14개, 관측이 101개입니다.
- **토크 한계**: 다리와 목 ±1.91 N·m, 어깨 ±0.20 N·m로 모델을 읽을 때 덮어씁니다.
- **몸짓**: 목과 어깨는 몸짓 보관소의 의미 있는 동작(인사, 안내, 응원 등)을 따라가게 했습니다. 몸짓은 명령 칸 3~6으로 들어오고, 정책은 그 목표 주위의 작은 보정만 합니다. 몸짓 확률 0.7, 속도 0.8~1.25배, 대기 1~3초를 무작위로 섞었습니다. 보상에 목과 어깨 목표 추종 항을 추가했습니다.
- **기준 걸음**: 코비 모델로 새로 만든 기준 걸음 데이터(`polynomial_coefficients_kobi.pkl`)를 모방 보상에 씁니다. 28채널입니다.
- **옆걸음 범위**: ±0.074 m/s로 줄였습니다.
- **종료 조건**: 몸통이 60도보다 많이 기울면 종료합니다.
- **버그 수정**: 업스트림의 몇 가지 번호 및 이름 문제(자유 관절 이름, 백래시 관절 거르기, 바닥과 몸통 번호 고정값)를 이름으로 찾도록 고쳤습니다.
- 업스트림 학습 방식은 그대로 두었습니다: PPO, 도메인 무작위화, 밀기, 행동 지연 0~2단계, 백래시.

출처: `코비_학습/playground_kobi/CHANGES.md`(저장소 밖), 개발 기록 `kobi_playground_env`(저장소 밖).

## 12. LCD 얼굴 판

인쇄한 얼굴 대신 머리 안의 5인치 HDMI 화면으로 표정을 보여 주는 코비의 모델 7b판이 `lcd_face/`에 있습니다(1차에 올렸던 6판 파일은 git 이력의 커밋 d46fc16에 있습니다). 머리 안에 Raspberry Pi 4를 두고, 카메라와 마이크는 이마에 있으며, 목에는 가는 선 7가닥만 지납니다. 폴더에는 MuJoCo 장면(`kobi_scene.xml`, `kobi_scene_backlash.xml`), 3D 프린트 파일, Blender 모델, 부품표 v12, 슬라이서로 잰 인쇄 부품 질량, 조립 설명서 PDF와 조립 영상, 시연 영상이 있고, `policy/lcd_face/`에는 이어서 학습한 정책과 평가 결과가 있습니다. 자세한 설명은 `lcd_face/README.md`를, 소프트웨어 팀이 하드웨어에서 알아야 할 것(관절 범위, 서보 번호, 핀 배치, 전원 주의, 게임패드, 질량)은 `lcd_face/SOFTWARE_HANDOFF.md`를 보세요.

꼭 알아 둘 점은 다음과 같습니다.

- **7b판 머리(모델 계산 636.2 g)는 정책이 학습한 머리 질량 범위(449.5~638.3 g)의 상한보다 2.06 g 아래입니다.** 실제 출력 설정으로 슬라이서가 계산한 추정으로는 보통 설정 589.4 g, 튼튼 설정 598.1 g이지만, 학습 때 상한 가까이의 질량은 표본이 적어(589.4 g 이상은 약 14%, 공식 (638.3 - m)² / 17408) 정책이 많이 본 질량은 아니고, 자석과 나사는 가정 값으로만 들어 있고(머리 3.6 g, 몸통의 선과 나사 60 g, 실제로 달아 확인 필요) 접착제와 마이크 커넥터는 모델에 없어서 실제 머리는 몇 g 더 무거울 수 있습니다. 7b판은 6판(머리 686.2 g)에서 껍데기 안쪽 피부를 0.9 mm로 얇게 하고 받침 부품에 구멍을 뚫어 가볍게 한 모델입니다. 정책은 인쇄 얼굴 판 정책(1억 5,100만 걸음)에서 이어서 약 6,000만 걸음 더 학습한 것이며, 6판이나 7b판 질량으로 다시 학습한 것은 아닙니다.
- 밀기 시험(192회)에서 넘어진 횟수는 3판 장면 103회, 5판 108회, 6판 105회, 7b판 108회입니다. 속도 추종 66회와 몸짓 88회는 네 장면 모두 넘어지지 않았습니다. 인쇄 얼굴 판 장면의 77회(9.3절)보다는 많습니다. 7b판 값은 이 저장소의 파일로 다시 돌려 확인하지는 않았습니다.
- 이 숫자도 모두 시뮬레이션 값입니다. LCD 얼굴 판 실물과 실기 시험 기록은 없습니다.
- 통풍구의 효과, 카메라 리본의 접점 면(A형, B형), 짧은 HDMI 케이블의 플러그 방향, 마이크 선 분리 커넥터(모델에 없음)는 아직 확인하지 못했습니다(`lcd_face/README.md` 3절).
- 이 폴더는 2차 공개입니다. 조립 설명서 PDF(`lcd_face/manual/`, 그림은 6판 모델이고 7b판에도 맞음)와 바로잡은 조립 영상(`lcd_face/manual/kobi_assembly_v6h.mp4`, 이 영상도 6판 모델 렌더이며 첫 2.5초 자막에 그렇게 적혀 있음)도 들어 있습니다. 1차에 뺐던 6판 조립 영상은 엉덩이 서보 순서가 틀린 것이었습니다.

출처: `lcd_face/README.md`, `policy/lcd_face/eval/`(1차 공개 때 이 저장소의 `tools/evaluate_policy.py`와 6판 장면(커밋 d46fc16)으로 6판 결과를 다시 돌려 같은 값을 확인했습니다. 7b판 결과는 원본 작업 폴더에서 돌린 JSON입니다).

## 13. 라이선스와 출처

자세한 내용은 `NOTICE.md`에 있습니다. 요약하면 다음과 같습니다.

- 뼈대 모델(다리와 몸통 구조, 이에서 만든 URDF와 MJCF)은 Antoine Pirrone(apirrone)의 Open Duck Mini v2에서 왔으며 Apache-2.0입니다. 라이선스 원문은 `LICENSES/Apache-2.0.txt`에 있습니다.
- 코리 캐릭터의 권리는 원 소유자(대학교)에게 있습니다.
- 뼈대 부품 메시 일부(`printed_face/mujoco/assets/`와 `lcd_face/mujoco/assets/`의 같은 28개)는 라이선스가 없는 Playground 저장소의 파일이라 이 저장소에 담지 않았고, `tools/fetch_upstream_meshes.py`로 내려받습니다(`NOTICE.md` 3절).
- 우리가 만든 파일에는 별도 오픈소스 라이선스를 붙이지 않았습니다. 따로 밝히지 않은 한 모든 권리가 유보됩니다. 이는 임시 표시이며 소유자가 바꿀 수 있습니다.
- 라이선스가 없는 업스트림 저장소(Open_Duck_Playground, Open_Duck_reference_motion_generator, Open_Duck_Mini_Runtime)의 코드는 넣지 않았습니다.

## 14. 애니메이션용 스켈레톤(리그) 파일

리타게팅과 애니메이션 팀을 위해, MuJoCo 모델에서 자동으로 뽑은 뼈대 파일을 `printed_face/skeleton/`에 넣었습니다. Blender 원본(`kobi_rig.blend`), FBX(`kobi_rig.fbx`), glTF 바이너리(`kobi_rig.glb`), 뼈대만 있는 BVH(`kobi_skeleton.bvh`), 숫자 원본(`skeleton.json`)입니다. 관절 14개는 정책 행동 번호 0~13과 같은 이름의 뼈에 대응하고, 각 관절은 자기 뼈의 로컬 Z축을 중심으로 돌며, 모든 각도가 0인 자세가 기준 자세입니다. 홈 자세는 `home` 동작에 따로 들어 있습니다.

- 파일별 사용처, 뼈 이름과 부모 구조, 좌표축 규칙(Blender는 Z 위, glTF는 Y 위, FBX 설정), 단위, 동작, 검증 오차, 다시 만드는 명령은 `printed_face/skeleton/README.md`에 있습니다.
- 우리가 만든 겉모양 메시 60개만 넣었습니다. 라이선스가 없는 업스트림 메시 28개(13절)의 모양은 어느 파일에도 들어 있지 않습니다.
- 만든 파일은 Blender 5.2.2에서 다시 읽어 MuJoCo 계산과 비교해 검증했습니다(뼈 머리 위치 최대 오차 7e-7 m 이하). Maya, Unity, MotionBuilder에서 직접 열어 본 것은 아닙니다.
- 도구는 `tools/skeleton/`(`extract_skeleton.py`, `build_rig.py`, `verify_rig.py`)에 있습니다. LCD 얼굴 판 MJCF(`lcd_face/mujoco/kobi_scene.xml`)로도 같은 도구에 그 경로를 주어 만들 수 있을 것으로 보이지만, 이번에 시도하지 않았습니다(12절).
