mgm136044/kobi-robot/lcd_face/README.md

# lcd_face: LCD 얼굴 판 (모델 7b판)

인쇄한 얼굴 대신 머리 안의 화면으로 표정을 보여 주는 코비입니다. 이 폴더에는 그 모델(MuJoCo 장면, Blender 파일), 3D 프린트 파일, 부품표(v12), 슬라이서로 잰 인쇄 부품 질량, 머리 질량이 늘어난 모델에 맞춰 이어서 학습한 정책과 평가 결과, 시연 영상, 조립 설명서가 들어 있습니다. 인쇄 얼굴 판(`../printed_face/`)과 같은 뼈대(다리, 몸통, 어깨)를 쓰고 머리만 다릅니다.

**소프트웨어 엔지니어(모션 리타게팅, 걷기 정책 학습, 실기 런타임)는 먼저 `SOFTWARE_HANDOFF.md`를 보세요.** 관절 범위, 서보 번호, 핀 배치, 전원 주의, 게임패드, 질량을 한곳에 모았습니다.

**이 폴더는 2차 공개입니다.** 1차(커밋 d46fc16)에는 모델 6판과 부품표 v11이 있었고, 2차에서 머리를 가볍게 한 **모델 7b판**, **부품표 v12**, 조립 설명서 PDF(`manual/`)로 바꿨습니다. 조립 영상 `manual/kobi_assembly_v6h.mp4`도 `manual/`에 있습니다(이 영상도 6판 모델 렌더이며 첫 2.5초 자막에 그렇게 적혀 있음, 8절). 6판 파일(모델, 부품표 v11, 6판 질량 표)은 이 폴더에서 빠졌고 git 이력의 커밋 d46fc16에 그대로 있습니다. 1차에서 올린 6판 정책 평가 JSON은 비교용으로 `../policy/lcd_face/eval/`에 남겼습니다.

**꼭 알아 둘 점 세 가지입니다.**

1. 이 폴더의 모든 성능 숫자는 시뮬레이션에서 잰 값입니다. LCD 판 실물을 만들었거나 실제 로봇에서 정책을 돌린 기록은 이 저장소에 없습니다.
2. 7b판 머리는 모델 계산(속이 꽉 찬 PLA)으로 636.2 g이라 정책이 학습할 때 본 머리 질량 범위(449.5~638.3 g)의 상한보다 2.06 g 아래이고, 실제 출력 설정으로 슬라이서가 계산한 추정(보통 설정 P1)은 589.4 g입니다. 다만 학습 때 589.4 g 이상이 나온 표본은 약 14%뿐이라 정책이 많이 본 질량은 아닙니다. 정책은 이 7b판 질량으로 다시 학습한 것이 아닙니다(3절과 4절).
3. 시연 영상(걷기, 몸짓)은 7b판이 아니라 더 가벼운 3판 머리(561.8 g) 장면에서 만든 것입니다(8절). 조립 설명서(`manual/`)의 그림은 6판 모델로 그렸고, 조립 순서와 그림은 7b판에도 그대로 맞습니다(8절).

## 목차

1. LCD 얼굴 판은 무엇인가
2. 모델 7b판과 검증 상태
3. 알려진 문제와 아직 확인하지 못한 것
4. 정책과 평가 결과
5. 폴더 지도
6. 시작하기
7. 인쇄 파일 쓰는 법
8. 영상, 부품표, 질량, 조립 설명서
9. 라이선스와 출처
10. 이 폴더에 넣지 않은 것과 손본 파일

## 1. LCD 얼굴 판은 무엇인가

- **머리 안에 Raspberry Pi 4(3GB)가 들어 있습니다.** 카메라, 마이크, 스피커, Wi-Fi, 얼굴 화면을 이 Pi 4가 맡습니다. 몸통의 Pi Zero 2 W는 걷기, 서보, IMU(몸 기울기 센서)를 맡습니다.
- **얼굴은 5인치 HDMI 화면(800x480) 하나입니다.** 눈, 눈썹, 입을 화면에 그려서 표정을 바꿉니다. 인쇄 얼굴 판의 눈, 눈썹, 입, 송곳니 부품은 이 판의 인쇄 목록에 없습니다(볼 홍조는 계속 인쇄합니다). 화면과 Pi 4는 머리 안의 30 cm 짧은 HDMI 케이블로 잇습니다.
- **카메라와 마이크는 이마에 있습니다.** 카메라 모듈 3 Wide와 INMP441 마이크를 머리 껍데기 오른쪽 반쪽에 달았고, 증폭기(MAX98357A)와 5 V 변환기도 머리 안에 있습니다.
- **목을 지나는 선은 가는 7가닥 묶음뿐입니다.** 7.4 V 전원 2가닥(22 AWG), UART 3가닥, 스피커 2가닥(28 AWG)이며, 머리 안에서 JST SM 7핀 분리 커넥터로 끊을 수 있습니다. 화면 신호(HDMI)는 목을 지나지 않습니다.
- 부품끼리는 나사 없이 자석, 다월(맞춤 핀), 스냅핏으로 잇는다는 인쇄 얼굴 판의 규칙을 그대로 따릅니다.

이렇게 바꾼 이유는 앞선 판에서 Pi 4를 몸통에 두고 1 m HDMI 케이블이 목과 몸통을 지나게 했더니 엉덩이 쪽 간섭과 비틀림이 풀리지 않았기 때문입니다(`bom/` 부품표 머리말).

출처: `bom/코비_BOM_오픈덕미니v2_LCD_v12_20261104.md`, 7b판 모델 README(저장소 밖). 이 절의 내용(Pi 4, 화면, 카메라, 목 선 7가닥)은 6판과 7b판이 같습니다.

## 2. 모델 7b판과 검증 상태

7b판은 6판에서 이어진 7판의 변형입니다. 머리를 가볍게 하려고 껍데기 안쪽 피부만 얇게 했고 바깥면과 부품 특징은 그대로입니다. 아래 두 표는 6판에서 한 일(7b판도 그대로 물려받음)과 7b판에서 바뀐 것입니다.

**7b판에서 6판과 달라진 것.**

| 항목 | 6판 | 7b판 |
|---|---|---|
| 머리 껍데기(`A_HeadShell`) | 안쪽 벽 1.2 mm | 안쪽 피부만 0.9 mm로 얇게 함. 바깥면은 그대로이고, 특징 꼭짓점 둘레 5 mm와 이음 면(x=0) 둘레 5 mm는 1.2 mm 그대로 |
| 머리 틀(`Head_frame_LCD`) | 구멍 없음 | 가로판에 폭 2 mm x 길이 55 mm 구멍 4개(팔 구멍은 없음) |
| 파이 받침(`Pi4_head_bracket`) | 구멍 없음 | 쟁반 밑면에 구멍 1개(64 x 23 mm, 깊이 1.4 mm) |
| 화면 받침(`LCD_mount`) | 창 없음 | 가운데 판에 둥근 창 3개 |
| 머리 질량(꽉 찬 PLA 계산) | 686.2 g | 636.2 g(49.98 g 감소) |
| 로봇 전체 | 3012.1 g | 2962.1 g |

감소분 49.98 g의 내역은 껍데기 43.41 g(280.98에서 237.57 g), 머리 틀 1.62 g(32.56에서 30.94 g), 파이 받침 2.55 g(22.24에서 19.69 g), 화면 받침 2.39 g(17.36에서 14.97 g)입니다. 케이블, 선, 산 부품(LCD 162.5 g, 파이 4 등)의 질량은 바꾸지 않았습니다.

**6판에서 한 일(7b판도 그대로).** 6판은 5판에 대한 독립 검증이 찾은 문제를 고친 판입니다. 5판에서 6판으로 바뀐 것은 다음과 같습니다.

| 항목 | 6판에서 한 일 |
|---|---|
| 카메라 기둥 위치 | 공식 도면대로 고침(구멍 두 줄 x -33.9, -46.4 mm). 5판은 7.3 mm 어긋나 있었음 |
| 마이크 방향 | 바닥 구멍형 마이크라서 기판 구멍 쪽이 소리관을 보도록 뒤집음 |
| 조립 순서 | 오른쪽 반쪽에 카메라와 마이크를 달고 선을 접어 둔 채 끼운 다음, 열린 왼쪽으로 손을 넣어 선을 꽂고 왼쪽 반쪽을 끼움. 150 mm 리본이 91 mm에서 팽팽해지는 문제를 피함 |
| 빠진 배선 | 마이크 6가닥, 증폭기 5가닥, UART 3가닥, 7핀 커넥터에서 변환기와 증폭기로 가는 4가닥을 모델에 넣고 틈을 쟀음. 모두 1 mm 이상 |
| 통풍구 | 뒤쪽 위 2 x 12 mm 구멍 6개와 턱 밑 흡입구 2개, 열린 면적 합계 192 mm2 |
| 짧은 HDMI 케이블 | 20 cm에서 30 cm(Coms BS359)로 바꾸고, 남는 약 105 mm는 반지름 20 mm 이상의 고리로 말아 둠 |
| 목 분리 커넥터 | JST-XH에서 JST SM 7핀 일체형 짝으로 바꿈 |

**모델의 질량(`mujoco/sim_report.json`, 7b판).** 로봇 전체 2962.1 g, 머리 636.2 g(6판 686.2 g, 5판 673.6 g, 3판 561.8 g)입니다. 이 폴더의 두 MJCF의 몸체 질량(`inertial mass`)을 XML에서 읽어 더하면 2962.1 g이고 머리 몸체는 0.636237 kg입니다(MuJoCo로 불러서 확인한 것은 아니고 XML을 직접 읽은 값입니다). 머리 무게중심은 머리 몸체 좌표에서 (17.5, 2.3, 28.3) mm입니다. 서 있기 시험에서 안 넘어지고(앞뒤 여유 46.9 mm와 56.3 mm), 목 끄덕임 서보 토크 최대는 0.1384 N·m로 예산 0.25 N·m 안입니다. 인쇄 부품은 63개, 합계 1260.6 g입니다(`print/parts_table_full.json`).

**검증 상태.** 7b판은 6판에서 통과한 검사 14개(상속 검사)와 검증 21개가 모두 통과했고, 새로 넣은 껍데기 두께 검사(`skin_check`)와 받침 구멍 검사(`support_check`)도 통과했습니다. 여유 폭 검사(`keepout_check`)는 꼭짓점 기준 5 mm(최소 5.04 mm)와 "표면 기준 0.95 mm 이하" 두 항목이 통과했지만, 한 항목은 통과하지 못했습니다. 특징 면의 표면에서 재면 0.05 mm 이상 얇아진 곳이 3.10 mm 거리부터 시작합니다(4.97 mm 거리의 꼭짓점 하나가 0.267 mm 얇아짐). 표면 기준 5 mm를 글자 그대로 지키려면 가중치를 바꾼 새 판이 필요합니다(질량 차이 약 0.04 g, 추정). 평범한 구역 6,000점의 껍데기 두께는 최소 0.879 mm, 중앙값 0.901 mm, 최대 0.9253 mm입니다. 6판은 작업자와 다른 독립 검증 에이전트(2026-11-03)가 모델을 읽기 전용으로 내보내 다시 쟀고 결론은 **치명 문제 없음**이었으며, 5판에서 지적된 카메라 기둥, 조립 순서, 마이크 방향, 빠진 배선이 고쳐진 것을 확인했습니다. 7b판의 여유 폭 수치도 2026-11-04 독립 검증(Opus)에서 6판과 꼭짓점을 1대1로 비교해 다시 쟀고, 위 한 항목은 그 검증이 찾은 것입니다. 6판 검증에서 남은 중대 2건 가운데 머리 질량 문제는 7b판에서 모델 값 기준으로 범위 안으로 들어왔고(3절), 나머지 한 건은 7b판에도 그대로입니다.

- 카메라 영상이 세로로 찍힙니다. 공식 도면에서 102도 시야는 보드의 25 mm 폭 방향이고 67도는 23.862 mm 방향인데, 모델은 25 mm 폭을 세로로 세웠습니다. 그래서 로봇의 가로 시야가 67도, 세로 시야가 102도입니다. 소프트웨어로 영상을 90도 돌려도 이 시야는 그대로입니다. 가로 영상이 필요하면 보드를 돌려 달아야 합니다. 카메라 위치와 방향은 7b판에서 바뀌지 않았습니다.

경미한 지적도 있습니다(Pi 전원선과 이더넷 단자 모서리 0.91 mm, 카메라 리본과 HDMI 플러그 사이 1.10 mm, 갈고리가 보드를 0.2 mm만 걸어 잡음 등). 검증 보고서와 검사 스크립트는 이 저장소에 넣지 않았습니다(10절).

출처: 7b판 모델 README 0절, 1절, 2절, 3절, 6절과 `report.json`(`mass`, `neck_torque`, `standing_test`, `print_files`), 6판 모델 README와 독립 검증 보고서(모두 저장소 밖), `mujoco/sim_report.json`, `mujoco/kobi_scene.xml`(이 폴더), `print/parts_table_full.json`(이 폴더, 63개 합 1260.6 g을 직접 더함).

## 3. 알려진 문제와 아직 확인하지 못한 것

1. **머리 질량은 학습 범위 안이지만 상한 가까이입니다.** 정책이 학습한 무작위 머리 질량 범위는 학습 식(기본 543.9 g x U(0.9, 1.1) + U(-40, +40) g)으로 계산하면 449.5~638.3 g입니다(앞선 판의 문서에 있던 "약 454~642 g"은 학습 코드 주석의 근사값이었습니다). 6판 머리는 모델 계산(속이 꽉 찬 PLA)으로 686.2 g이라 상한보다 47.9 g 무거웠습니다. 사용자는 정책을 다시 학습하지 않고 머리를 가볍게 하기로 정했고(2026-11-04), 그 결과가 7b판입니다. 7b판 머리는 모델 계산으로 636.2 g(상한보다 2.06 g 아래, 하한 449.5 g보다 186.7 g 위)이고, 슬라이서로 잰 실제 출력은 보통 설정(P1) 589.4 g, 튼튼 설정(P2) 598.1 g으로 상한보다 각각 48.9 g, 40.2 g 가볍습니다(`mass/`, `SOFTWARE_HANDOFF.md` 9절). **범위 안이라고 해서 학습한 질량은 아닙니다.** 학습 질량은 사다리꼴 분포라서 질량 m(558.3 g 이상) 이상인 학습 표본의 비율은 (638.3 - m)의 제곱 / 17,408입니다. 이 식으로 589.4 g(P1)은 약 14%, 598.1 g(P2)은 약 9%, 636.2 g(모델 값)은 약 0.02%입니다. 자석과 나사는 모델에 가정 값으로만 들어 있고(머리 3.6 g, 몸통의 선과 나사 60 g, 실제로 달아 확인 필요) 접착제와 마이크 SM 6핀 커넥터는 모델에 없어서 실제 머리는 몇 g 더 무거울 수 있습니다. 슬라이서 추정이 실제와 10% 어긋나 출력 부품이 10% 무거워도 머리는 약 621.6 g(589.4 + 321.5 x 0.1)으로 상한 안입니다. 정책을 이 질량으로 다시 학습하지 않았고, 시뮬레이션 밀기 시험의 넘어짐은 7b판 장면에서도 6판과 같은 수준이었습니다(4절).
2. **7b판 껍데기와 받침의 강도는 재어 보지 않았습니다.** 0.9 mm 껍데기와 구멍 뚫린 머리 틀, 파이 받침, 화면 받침의 강도는 계산하지도 출력해 보지도 않았습니다. 파이 받침의 새 구멍 천장은 64 x 23 mm 면을 23 mm 다리 놓기(브리징)로 출력해야 하고 이것도 해 보지 않았습니다. 시험 조각 두 개(`print/test_coupons/`)를 먼저 뽑아 0.9 mm 설정을 확인하세요(7절). 슬라이서는 0.9 mm 벽에서 벽 수를 스스로 줄이므로 껍데기의 슬라이서 질량 추정은 6판의 1.2 mm보다 불확실합니다. 껍데기 반쪽 하나를 저울로 달아 보는 것이 가장 좋습니다(`mass/README.md`).
3. **통풍구의 효과는 시험하지 않았습니다.** 닫힌 PLA 머리 안에서 Pi 4가 얼마나 뜨거워지는지는 실물을 만들어 재야 압니다. 192 mm2 구멍으로 충분한지는 모릅니다. 팬이나 방열 보강이 필요할 수 있어 부품표에는 선택 품목으로 팬이 있습니다.
4. **카메라 리본의 접점 면(A형인지 B형인지)을 모릅니다.** 카메라 모듈 3 단자의 접점 면은 공식 도면에도 없습니다. 그래서 부품표에서 둘 다 사도록 했습니다.
5. **짧은 HDMI 케이블(Coms BS359)의 플러그 방향이 확인되지 않았습니다.** 판매 페이지에는 마이크로 쪽이 "아래로 꺾임"이라고만 있습니다. 실제 플러그 크기, 꺾이는 방향이 Pi 4 단자에 맞는지는 실물로 확인해야 합니다. 케이블 질량(18 g)은 20 cm 케이블의 1.5배로 가정한 값입니다.
6. **마이크 선 분리 커넥터는 모델에 없습니다.** 부품표 v7이 모델을 바꾸지 않고 독립 검증에서 나온 "마이크 선을 끊을 수 있는 커넥터"를 더했고, v8부터는 목 7핀과 바꿔 꽂히지 않도록 SM 6핀 커넥터로 바꿨습니다. 이 커넥터의 크기와 질량은 7b판 모델이나 위의 머리 질량에 반영되어 있지 않습니다.
7. 그 밖에 실물이 있어야 정해지는 것: 실제 INMP441 모듈의 구멍과 패드 위치(시험 조각 2개를 `print/test_coupons/`에 두었으니 머리 전체를 뽑기 전에 먼저 출력), 카메라 렌즈 몸체 높이, SM 케이블의 실제 길이와 굵기, 변환기와 증폭기 패드 위치, 목 선 묶음의 비틀림 수명, 갈고리와 기둥이 반복 분리에서 부러지지 않는지, PLA 머리 안 Wi-Fi 수신 세기입니다. 6판 README의 14절에 10개로 모아 두었습니다(저장소 밖).
8. 이 판은 URDF를 만들지 않았습니다. `tools/build_urdf.py`로 `mujoco/kobi_scene.xml`에서 만들 수 있을 것으로 보이지만 이번에 시도하지 않았습니다.

## 4. 정책과 평가 결과

**정책 파일: `../policy/lcd_face/2026_11_03_143411_61931520.onnx`** (884,177바이트, SHA-256 `24ecbee41edb3ef6411ba7ef7a1effb042d0cf8486480cc6b6433a86422a3565`)

- 인쇄 얼굴 판의 최종 정책(`../policy/kobi_v2_final_151M.onnx`, 1억 5,100만 걸음)에서 이어서 약 6,000만 걸음을 더 학습했고, 파일 이름의 마지막 숫자 61,931,520이 체크포인트의 걸음 수입니다. 학습 환경은 머리 질량을 449.5~638.3 g 범위(학습 식으로 계산한 값)에서 무작위로 바꾸도록 고친 것입니다.
- 입력(관측 101개)과 출력(행동 14개)의 규칙은 인쇄 얼굴 판 정책과 같습니다(`../README.md` 7절). 같은 도구(`tools/evaluate_policy.py`)로 읽히고 돌아갑니다.

**측정 조건.** 시뮬레이션(MuJoCo 3.14.0, 백래시 장면), 관측 잡음 1.0, 행동 지연 0, 홈 자세에서 출발, 346회입니다. 방법은 `../README.md` 9절과 같습니다. 밀기 시험은 192회로, 서 있을 때 96회와 0.1 m/s로 걸을 때 96회에 속도 변화 0.25, 0.5, 0.75, 1.0 m/s를 8방향으로 주고 3초 안에 넘어졌는지 봅니다.

| 장면(머리 질량) | 정책 | 밀기에서 넘어짐 (192회 중) | 서 있을 때 / 걸을 때 | 속도 추종 넘어짐 (66회 중) | 몸짓 넘어짐 (88회 중) |
|---|---|---|---|---|---|
| 3판(561.8 g) | LCD 이어서 학습 정책 | **103** | 51 / 52 | 0 | 0 |
| 5판(673.6 g) | LCD 이어서 학습 정책 | **108** | 52 / 56 | 0 | 0 |
| 6판(686.2 g) | LCD 이어서 학습 정책 | **105** | 54 / 51 | 0 | 0 |
| **7b판(636.2 g, 이 폴더의 모델)** | LCD 이어서 학습 정책 | **108** | 52 / 56 | 0 | 0 |
| 3판(561.8 g) | 옛 151M 정책 | 102 | 50 / 52 | 0 | 0 |

읽는 법은 다음과 같습니다.

- **걷기 속도를 따라가는 시험(66회)과 몸짓 시험(88회)에서는 다섯 줄 모두 한 번도 넘어지지 않았습니다.** 7b판 장면에서도 서서 걷고 몸짓을 하는 보통 동작은 시뮬레이션에서 안 넘어졌습니다.
- **일부러 아주 세게 미는 시험에서는 넘어짐이 많습니다.** 192회 중 102~108회(약 53~56%)입니다. 7b판 장면의 108회는 6판 105회, 5판 108회와 같은 수준입니다. 머리가 가벼워졌다고 눈에 띄게 좋아지지도 나빠지지도 않았고(정책 하나에 시드 3개이며 통계 검정은 하지 않았고, 반복 횟수가 적어 이 차이가 우연을 넘는 것인지는 이번 표만으로 알 수 없습니다), 이전 판의 7판 장면에서는 105회였습니다(7b판 모델 README 7절).
- **이어서 학습한 정책이 옛 정책보다 낫다는 증거는 이 표에 없습니다.** 같은 3판 장면에서 새 정책 103회, 옛 정책 102회로 차이가 없습니다. 옛 정책은 3판 장면에서만 재 보았고, 머리가 더 무거운 5판, 6판, 7b판에서는 재 보지 않아서 두 정책을 무거운 머리에서 견주는 값은 없습니다.
- 참고로 인쇄 얼굴 판 장면에서 옛 정책의 밀기 넘어짐은 77회였습니다(`../README.md` 9.3절). LCD 판 장면에서는 어느 정책이든 100회를 넘습니다. 이유는 따져 보지 않았습니다(머리 질량 말고도 장면의 다른 점이 있습니다).

7b판 줄의 값은 `eval_ft61931520_on_v7b.json`에서 읽었습니다(밀기 넘어짐 108 = 서 있을 때 52 + 걸을 때 56, 속도 추종 66회와 몸짓 88회에서 넘어짐 0). 이 JSON은 원본 작업 폴더에서 아래 3단계 명령과 같은 방식으로 돌린 결과 파일이며, 이 저장소의 파일만으로 7b판을 다시 돌려 보는 일은 아직 하지 않았습니다. 6판 줄은 1차 공개 때 이 저장소의 파일만으로 다시 돌려 같은 값이 나오는 것을 확인했습니다.

출처: `../policy/lcd_face/eval/`의 JSON 5개(아래 5절 지도), 학습 기록(저장소 밖, 학습 명령과 체크포인트 걸음 수 `runs/kobi_lcd_ft/jobs/provenance.txt`, 머리 질량 범위는 학습 환경 `randomize.py` 주석), 3판과 5판 머리 질량은 각 판의 `sim_report.json`(저장소 밖).

## 5. 폴더 지도

```
kobi-robot/
  lcd_face/                              이 폴더
    README.md                              이 문서
    SOFTWARE_HANDOFF.md                    소프트웨어 팀 인계 문서(관절, 서보 번호, 핀, 전원, 질량)
    mujoco/                                MuJoCo 모델(7b판)
      kobi_scene.xml                         일반 장면
      kobi_scene_backlash.xml                평가에 쓴 백래시 장면(이 7b판 장면은 평가에만 썼고, 학습은 머리 543.9 g의 별도 모델에서 함)
      sim_report.json                        머리와 로봇 질량 요약
      assets/                                STL 57개 + 내려받는 28개(6절). 6판과 다른 것은 kobi_A_HeadShell.stl, kobi_Pi4_head_bracket.stl 둘
    print/                               3D 프린트 파일(7b판)
      body/ face/ head/ mech/                바뀌었거나 새로 생긴 부품의 STL 18개(반쪽 파일 포함). 6판과 다른 STL은 head/ 3개, mech/ 3개와 시험 조각 2개
      parts_table.json                       바뀐 부품 12개의 크기, 질량, 출력 방향
      parts_table_full.json                  7b판 인쇄 부품 63개 전체의 크기와 질량(합계 1260.6 g)
      test_coupons/                          시험 조각 2개(카메라 고정부, 마이크 고정부)와 coupons_build.json
      extra/                                 63개 밖의 좁은 엉덩이 판 2개(kori_roll_to_pitch_left/right_print_mm.stl)와 SHA256SUMS.txt
    blender/kobi_v7_lcd_v7b.blend        7b판 Blender 모델(22 MB, 개인 경로와 코리 참고 그림을 지움)
    bom/                                 부품표 v12: .md, .csv, 사진/(표 그림 PNG)
    mass/                                인쇄 부품 질량(슬라이서 측정, 7b판): parts.csv(63개), parts_changed_v7b.csv(바뀐 부품의 6판·7판·7b판 비교), bodies.csv, skeleton_parts.csv, settings/, README.md
    media/                               영상 2개(3판 걷기, 3판 몸짓)와 stills/(정지화면 8장)
    manual/                              조립 설명서 PDF(v6h, 111쪽, 51 MB)와 조립 영상 kobi_assembly_v6h.mp4
  policy/lcd_face/                       LCD 판 정책
    2026_11_03_143411_61931520.onnx        이어서 학습한 정책
    eval/                                  평가 JSON 5개(3판, 5판, 6판, 7b판 장면의 새 정책과 3판 장면의 옛 정책)
  printed_face/ policy/ tools/ media/      인쇄 얼굴 판과 공용 도구(`../README.md` 3절)
```

평가 JSON은 `eval_ft_2026_11_03_143411_61931520_on_v3.json`, `eval_ft_2026_11_03_143411_61931520_on_v5.json`, `eval_ft61931520_on_v6.json`, `eval_ft61931520_on_v7b.json`, `eval_old151M_on_v3.json`입니다. 모두 `tools/evaluate_policy.py`가 만든 파일 형식이며, 쓴 장면 파일 경로는 JSON 안의 `settings.xml`에 있습니다(3판, 5판 장면은 이 저장소에 없고, 6판 장면은 커밋 d46fc16에만 있습니다. 7b판 JSON의 `lcd_variant_v7b/sim/xmls/...` 경로는 `lcd_face/mujoco/`와 같은 파일입니다).

## 6. 시작하기

모든 명령은 저장소 맨 위 폴더에서 실행합니다.

**1단계. 업스트림 메시를 한 번 내려받습니다.** 인쇄 얼굴 판과 마찬가지로 라이선스가 없는 Open_Duck_Playground의 단순화 메시 28개는 이 저장소에 넣지 않았습니다(9절).

```
python3 tools/fetch_upstream_meshes.py
```

이 명령은 `lcd_face/mujoco/assets/`에도 같은 28개를 내려받습니다(고정된 커밋에서 받고, 스크립트에 적힌 SHA-256과 맞을 때만 저장합니다). `--check`를 주면 내려받지 않고 확인만 합니다. 이 폴더를 준비하면서 실제로 내려받아 28개가 모두 해시와 맞는 것을 확인했습니다. LCD 장면이 쓰는 업스트림 메시는 인쇄 얼굴 판과 같은 28개이고, 해시도 같았습니다.

**2단계. 장면을 불러옵니다.**

```python
import mujoco
model = mujoco.MjModel.from_xml_path("lcd_face/mujoco/kobi_scene.xml")
data = mujoco.MjData(model)
key = mujoco.mj_name2id(model, mujoco.mjtObj.mjOBJ_KEY, "home")
mujoco.mj_resetDataKeyframe(model, data, key)
mujoco.mj_forward(model, data)
```

몸체 수와 관절 수는 1차 공개 때 MuJoCo 3.14.0으로 불러 본 값입니다(7b판도 구조가 같습니다). 질량 합 2962.1 g은 두 XML의 질량을 더한 값이고, 바이트 단위로 같은 XML을 mujoco 3.14.0으로 불러 만든 7b판 `sim_report.json`의 값과 같습니다.

| 파일 | 몸체 수 | 관절 수 | 구동기 수 | 상태 변수 | 질량 합 |
|---|---|---|---|---|---|
| `lcd_face/mujoco/kobi_scene.xml` | 18 | 15 | 14 | 21 | 2962.1 g |
| `lcd_face/mujoco/kobi_scene_backlash.xml` | 18 | 25 | 14 | 31 | 2962.1 g |

관절 14개의 번호, 이름, 순서는 인쇄 얼굴 판과 같습니다(`../README.md` 4절). 인쇄 얼굴 판 장면과 다른 점은 직접 비교해 확인했습니다.

- 머리 몸체(`kobi_head`)의 질량이 0.403 kg에서 0.636 kg으로, 무게중심과 관성이 새 머리에 맞게 바뀌었습니다. 머리 겉모양 메시도 화면, 화면 테두리, Pi 4와 받침, 카메라 렌즈로 바뀌었습니다(인쇄 얼굴 판의 눈, 눈썹, 입, 송곳니 메시는 없음).
- 몸통 본체의 질량이 1.289 kg에서 1.238 kg으로, 목 링크가 0.0803 kg에서 0.0819 kg으로 바뀌었습니다.
- `home` 자세의 엉덩이 앞뒤, 무릎, 발목 값이 인쇄 얼굴 판과 조금 다릅니다(가장 큰 차이 0.0219 rad, 약 1.3도). 무게중심이 앞으로 옮겨 간 것에 맞춘 값입니다. 목과 어깨 값은 같습니다(모두 0). 이 폴더의 정책 평가는 이 `home` 자세에서 출발합니다.

**3단계(선택). 정책을 평가합니다.** 아래는 7b판 장면에서 새 정책을 346회 평가합니다(작업자 4개, 이 Mac에서 약 7초).

```
uv run --no-project --python 3.12 --with onnxruntime --with mujoco==3.14.0 --with numpy python -I tools/evaluate_policy.py \
    --policy policy/lcd_face/2026_11_03_143411_61931520.onnx --xml lcd_face/mujoco/kobi_scene_backlash.xml \
    --tag lcd_v7b --workers 4 --no-motions
```

결과는 `out/eval_lcd_v7b.json`에 저장됩니다. `tools/kobi_env_mirror.py`의 기본 장면은 인쇄 얼굴 판이라서, LCD 장면으로 돌릴 때는 꼭 `--xml`을 주세요.

## 7. 인쇄 파일 쓰는 법

7b판 인쇄 부품은 63개(1260.6 g, 꽉 찬 PLA 계산)입니다. 이 가운데 인쇄 얼굴 판과 달라진 12개(바뀐 6개와 새 6개, 합계 580.3 g)만 `print/`에 있고, 나머지 51개는 `../printed_face/print/`의 같은 이름 파일을 그대로 씁니다. 51개가 원래 인쇄 파일(`print_v8`)과 바이트 단위로 같음을 확인했습니다.

- **바뀐 부품 6개**: `Arm_L_mitten`, `Arm_R_mitten`, `Neck`, `Face_WhiteFace`, `A_HeadShell`(머리 껍데기, 통풍구와 카메라, 마이크 구멍), `Top_plate`.
- **새 부품 6개**: `Face_LCD_bezel`, `Head_frame_LCD`, `LCD_mount`, `LCD_mount_pin`, `Neck_gap_shield`, `Pi4_head_bracket`.
- **반쪽 파일**: 머리 껍데기, 흰 얼굴, 화면 테두리는 `_L`과 `_R` 반쪽 파일이 따로 있습니다. 한 덩어리(`_whole`)로는 프린터 판(256 mm)에 안 들어가는 부품(머리 껍데기는 가로 348 mm)이 있어서, 반쪽 파일은 판에 들어가게 나눈 것입니다. 반쪽 파일은 부품 질량 합계에 다시 세지 않습니다.
- **인쇄 목록의 기준은 `print/parts_table_full.json`(63개)입니다.** 다만 조립 설명서는 63개 밖의 출력물도 요구합니다. 좁은 엉덩이 판 2개(`print/extra/`, 설명서 기준 PLA로 각 약 48.7 g), 맞춤 시험 조각(`../printed_face/print/fit_coupon.stl`), 시험 조각 2개(`print/test_coupons/`)입니다. `../printed_face/print/`에는 있지만 이 목록에 없는 파일이 있습니다. 눈, 눈썹, 입, 송곳니(`Face_Eye`, `Face_Brow`, `Face_Mouth`, `Face_Fang`)는 화면이 대신합니다. `Head_frame`, `Head_pad`, `Pi4_bracket`도 목록에 없고, 머리 안 구조는 새 `Head_frame_LCD`와 `Pi4_head_bracket`이 맡습니다. 주의: `print/parts_table.json`의 `files.removed_from_print_set`(42개)에는 볼 홍조, 날개, 다리 판, 어깨 연결부처럼 63개 목록에 그대로 있는 부품도 들어 있어서, 그 목록은 믿지 말고 `parts_table_full.json`을 보세요.
- **시험 조각을 먼저 뽑으세요.** `print/test_coupons/`의 `camera_mount_coupon.stl`(4.05 g)와 `mic_mount_coupon.stl`(2.74 g)은 카메라와 마이크 고정부만 떼어 낸 것입니다(7b판 껍데기에서 다시 잘랐고, 기둥과 갈고리는 6판과 같고 가장자리 피부만 0.9 mm입니다). 실제 모듈의 구멍 위치가 도면 값과 맞는지, 갈고리가 부러지지 않는지, 0.9 mm 설정이 되는지 확인한 다음 머리 전체를 뽑는 순서를 권합니다.
- **7b판 머리 부품 출력 권장(실제로 출력해 확인한 값이 아닙니다).** 0.9 mm 피부는 0.4 mm 노즐에서 선 너비 0.45 mm로 둘레 2줄입니다. 껍데기 반쪽(`A_HeadShell_L`, `A_HeadShell_R`)은 이음 면을 침대에 놓고(왼쪽은 x가 위, 오른쪽은 -x가 위), 평범한 벽은 둘레 2줄, 특징 둘레 5 mm 띠와 이음 띠, 기둥과 탭은 가변 선 너비(Arachne 계열)를 켜거나 둘레를 3줄로 올립니다. 바닥과 천장 층은 3층(0.6 mm) 이하여야 0.9 mm 벽에 들어갑니다. 머리 틀은 가로판을 침대에 놓고 둘레 3줄로 하며 55 x 2 mm 구멍은 얇은 벽 감지와 갭 채움을 끕니다. 파이 받침은 바닥판을 침대에 놓고 새 구멍 천장의 23 mm 다리 놓기에 속도와 냉각을 맞추며, 처지면 구멍 가운데에 2 mm 리브를 넣거나 지지대를 켭니다. 슬라이서 질량 추정은 P1 바깥 벽 0.42 mm 설정이라 0.9 mm 벽에서는 슬라이서가 줄 수를 스스로 줄입니다. 출처: 7b판 모델 README 10절.

## 8. 영상, 부품표, 질량, 조립 설명서

**영상(`media/`).** `코비_LCD_v3_걷기_새정책.mp4`(38초)와 `코비_LCD_v3_몸짓_새정책.mp4`(63.5초)는 이어서 학습한 정책으로 **LCD 3판 장면**(머리 561.8 g)을 돌려 만든 1280x720 영상입니다. 6판이나 7b판 장면이 아닙니다(6판 모델의 렌더가 아니라서 이번 모델 교체로 틀려진 것은 없습니다). 3판 머리 모양은 7b판과 다르며, 정책의 학습 범위 안의 질량입니다. 정지화면 8장(걷기 4장, 몸짓 4장)은 `media/stills/`에 있고 이 두 영상에서 뽑은 것입니다. 1차에서 뺀 옛 6판 조립 영상(`kobi_assembly_v6.mp4`)은 엉덩이 서보를 다는 순서가 틀린 것이었고, 바로잡은 최신 조립 영상은 `manual/kobi_assembly_v6h.mp4`입니다(아래 조립 설명서 항목).

**부품표(`bom/`).** `코비_BOM_오픈덕미니v2_LCD_v12_20261104.md`와 같은 이름의 `.csv`, 표를 그림으로 만든 `사진/코비_BOM_LCD_v12_표_20261104.png`입니다. 모델은 7b판이고, 국내 판매처 기준 2026-11-02~04 가격입니다. v11은 이 폴더에서 빠졌고 git 이력(커밋 d46fc16)에 있습니다.

- **금액.** 부품 합계 2,228,890원(로봇 1대 조립분 1,241,531원과 여분 987,359원), 배송비 추정 30,200원을 더한 총액 2,259,090원, 예산 2,280,000원에서 남는 금액 20,910원입니다. 표는 63행이고, 그중 54행이 합계에 들어가며 9행은 선택 품목(합계에서 뺌)입니다. 서보 STS3215는 22개(로봇 12개와 여분 10개)입니다.
- **v7에서 v12까지 바뀐 것.** v8은 조립 설명서 검증을 반영해 마이크 선 분리 커넥터를 SM 6핀으로 바꾸고 빠진 부품(Pi Zero 핀 헤더, M2.5 너트, 머리 가지 퓨즈)을 더했습니다. v9는 주문일(2026-11-04)의 판으로 구입처를 모두 정했고 Pi Zero 2 W를 살 수 있는 아이씨뱅큐로 바꿨습니다. v10은 사용자 결정으로 공유기, Xbox 컨트롤러, 레깅스 원단을 사지 않기로 했습니다(선택 품목으로 남김, 대신할 방법은 `SOFTWARE_HANDOFF.md` 8절). v11은 여분 Pi Zero도 아이씨뱅큐에서 사서 Pi Zero 둘 다 아이씨뱅큐에서 사고, 남는 예산으로 서보 2개를 더했습니다. **v12는 v11과 사는 부품, 수량, 단가, 판매처, 금액이 모두 같고(총액 차이 0원)** 모델을 7b판으로 바꿔 출력 부품 4개(`A_HeadShell`, `Head_frame_LCD`, `Pi4_head_bracket`, `LCD_mount`)의 질량, 출력 부품 합계(1,310.6 g에서 1,260.6 g), 필라멘트 계산, 모델 수치 인용, 시험 조각 질량을 고쳤습니다. 필라멘트 롤 수는 그대로입니다. 위험 17(머리 질량)은 학습 범위 449.5~638.3 g과 7b판 머리(모델 636.2 g, 슬라이서 약 589.4 g)로 다시 썼고, 5V 모듈(행 16)과 앰프(행 34)의 자리를 오른쪽 받침에서 머리 받침 왼쪽(+x) 트레이로 바로잡았고, 위험 31(여분 서보 번호)도 고쳤습니다. 1차의 v11에 남아 있던 옛 학습 범위 근사값(약 454~642 g)은 v12에서 바로잡혔습니다.
- 이 부품표는 작업 폴더 이름(`코비_3D/...`, `코비_BOM/...`, `코비_학습/...`, `코비_조립설명서/...`)으로 자료와 옛 판 부품표를 가리키는데, 그 폴더들은 이 저장소에 없습니다.

**인쇄 부품 질량(`mass/`).** OrcaSlicer로 인쇄 부품 63개를 실제 출력 설정(P1: 벽 3겹, 속채움 15%, P2: 벽 4겹, 속채움 25%)으로 잘라 질량을 읽은 표입니다. MuJoCo 모델의 인쇄 부품 질량은 속이 꽉 찬 PLA 값이라, 머리 전체가 636.2 g(모델), 589.4 g(P1), 598.1 g(P2)로 나오고, 로봇 전체는 2962.1 g(모델), 2771.1 g(P1), 2813.1 g(P2)입니다(6판은 머리 686.2 / 635.1 / 644.4 g, 로봇 3012.1 / 2816.7 / 2859.4 g). 7b판에서 바뀐 인쇄 부품 4개와 시험 조각 2개만 새로 잘랐고 나머지는 6판 측정값을 그대로 썼습니다. 관성과 무게중심은 다시 계산하지 않았고 질량만 바꾼 표입니다. 읽는 법은 `mass/README.md`와 `SOFTWARE_HANDOFF.md` 9절에 있습니다.

**조립 설명서(`manual/`).** `코비_조립설명서_LCD_v6h_20261104.pdf`(111쪽, A4, 51 MB)는 모델 7b판과 부품표 v12를 기준으로 쓴 설명서입니다. 설명서 안의 그림은 6판 모델로 그린 것이고, 7b판은 껍데기 안쪽 피부와 받침 부품 구멍만 달라서 그림과 조립 순서가 그대로 맞습니다(그림에는 7b판의 새 구멍이 그려져 있지 않습니다). 조립 영상 `manual/kobi_assembly_v6h.mp4`가 같은 폴더에 함께 있습니다. 설명서는 스스로를 "초안"이라고 적고 있고, 실물로 확인해야 하는 것은 「정할 것」과 「실물로 확인」으로 표시했습니다.

설명서는 작업 폴더 이름으로 파일을 가리킵니다. 이 저장소에서는 다음 위치에 해당합니다.

| 설명서의 경로 | 이 저장소의 위치 |
|---|---|
| `코비_3D/lcd_variant_v7b/print/` | `lcd_face/print/` |
| `코비_3D/lcd_variant_v7b/kobi_v7_lcd_v7b.blend` | `lcd_face/blender/kobi_v7_lcd_v7b.blend` |
| `코비_3D/print_v8/` | `printed_face/print/` |
| `코비_3D/slicer_weights_v7b_20261104/` | `lcd_face/mass/` |
| `코비_BOM/코비_BOM_오픈덕미니v2_LCD_v12_20261104.md` | `lcd_face/bom/` 같은 이름 |
| `코비_조립설명서/print_extra/` | `lcd_face/print/extra/` |
| `코비_3D/print_v8/fit_coupon.stl` | `printed_face/print/fit_coupon.stl` |

6판 모델 폴더(`코비_3D/lcd_variant_v6/`)의 README와 검사 결과를 가리키는 곳, 설계 문서 번호(S03b, W11 등)는 이 저장소에 없는 자료입니다.

## 9. 라이선스와 출처

인쇄 얼굴 판과 같은 방식을 따릅니다. 자세한 내용은 `../NOTICE.md`에 있습니다.

- **Open Duck Mini v2(Antoine Pirrone, Apache-2.0)**: 다리와 몸통 뼈대 형상은 이 오픈소스 로봇에서 왔습니다. 이 폴더의 `mujoco/kobi_scene.xml`, `mujoco/kobi_scene_backlash.xml`, `mujoco/assets/`의 뼈대 부품 메시, `blender/kobi_v7_lcd_v7b.blend` 안의 Open Duck 뼈대 물체들이 같은 출처에 기대고 있습니다. 라이선스 원문은 `../LICENSES/Apache-2.0.txt`, 변경 표시는 `../NOTICE.md` 1절에 있습니다.
- **라이선스가 없는 업스트림 메시는 넣지 않았습니다.** Open_Duck_Playground의 단순화 메시 28개는 `tools/fetch_upstream_meshes.py`로 내려받습니다(6절). `.gitignore`에 그 경로가 있어서 내려받아도 저장소에 올라가지 않습니다. 내려받는 파일 이름과 해시는 그 스크립트에 있습니다.
- **코리 캐릭터**: 캐릭터와 그 모양의 권리는 원 소유자(대학교)에게 있습니다. 이 폴더의 외피 부품, 화면에 띄우는 얼굴 그림(`blender/` 파일 안에 포함), 영상, 조립 설명서 PDF와 조립 영상(`manual/`)에 그 캐릭터 모양이 들어 있으므로 공개나 재사용 전에 허락 범위를 확인해야 합니다. 캐릭터 원본 그림 파일은 넣지 않았습니다.
- **우리가 만든 파일**(모델 수정분, 프린트 파일, 정책, 영상, 이 문서 등)에는 별도 오픈소스 라이선스를 붙이지 않았고 모든 권리가 유보됩니다(임시 표시, `../NOTICE.md` 5절).

## 10. 이 폴더에 넣지 않은 것과 손본 파일

**넣지 않은 것.**

- 6판과 7b판 모델을 만들고 검사한 스크립트, 검사 결과 JSON(`checks/`), 독립 검증 보고서와 검사 스크립트, 렌더 그림(`renders/`), MuJoCo 모델 생성용 중간 파일(`.part` 파일, `parts.json` 등). 필요하면 작업 폴더에서 따로 가져와야 합니다.
- 6판 파일(모델 `kobi_v7_lcd_v6.blend`, 6판 MuJoCo 장면과 STL, 부품표 v11, 6판 질량 표 `parts.csv`, `bodies.csv`, `README.md`)은 2차에서 7b판으로 바꾸면서 이 폴더에서 뺐습니다. git 이력의 커밋 d46fc16에 있습니다. 모델 7판(7b판의 앞 단계)은 올리지 않았습니다.
- 질량 측정에 쓴 스크립트와 실행 기록(7b판 `scripts/`, `raw/`). 작업 컴퓨터의 절대 경로가 들어 있어 `mass/`에는 표와 설정만 넣었습니다.
- 인쇄 얼굴 판과 같은 URDF(3절 7번).

**이 폴더에 넣으면서 손본 파일.** 원본은 그대로 두고 복사본만 고쳤고, 모델과 데이터 값은 바꾸지 않았습니다.

- `blender/kobi_v7_lcd_v7b.blend`: 1차의 6판 파일과 같은 방법으로, 원본 복사본을 헤드리스 Blender 5.2.2로 열어 외부 파일을 가리키던 코리 참고 그림 이미지 1개를 지웠고, 화면 그림(`kori_face_800x480.png`, 파일 안에 포함됨)과 렌더 출력의 개인 컴퓨터 경로를 지웠습니다. 새 경로로 저장한 뒤 남은 옛 경로 조각이 없는지 압축을 푼 바이트에서 찾아 0건을 확인했고, 한 덩어리로 다시 압축해서 원본(64 MB, 174조각으로 나뉜 압축)보다 작아졌습니다(22 MB). 물체 303개, 메시 295개, 모든 꼭짓점 위치와 물체 변환 행렬은 원본과 같음을 Blender 5.2.2로 비교했습니다. 글꼴 하나의 상대 경로(`Library/Fonts/KoPubWorld-Batang-Medium.otf`)가 남아 있지만 개인 폴더 이름은 없습니다(1차 파일과 같습니다).
- `../policy/lcd_face/eval/*.json`(7b판 파일 `eval_ft61931520_on_v7b.json` 포함): 평가를 돌린 컴퓨터의 절대 경로가 `settings.xml`에 있어서 앞부분(사용자 폴더)을 잘랐습니다. 나머지 숫자는 그대로입니다.
- `bom/*.md`, `bom/*.csv`, `bom/사진/*.png`: 판매자 휴대전화 번호 1건(자석 행의 "결제 전 문의 010-...")을 "결제 전 판매처에 문의"로 바꿨고, 그림 파일은 그 번호 부분을 흰색으로 가렸습니다(그림은 메타데이터 없는 RGB PNG로 새로 저장했고 번호 자리 밖의 픽셀은 같습니다). 2차(v12)부터는 한 판매처의 대표 전화번호(Pi 4 대안 행)도 지웠습니다. 그 밖의 내용은 그대로입니다. 작성자 이름과 판매처 링크는 그대로 두었습니다.
- `mass/README.md`: 7b판 슬라이서 README와 1차의 측정 방법 설명을 합쳐 새로 썼고, 작업 컴퓨터의 절대 경로와 임시 폴더 경로를 평범한 설명으로 바꿨습니다. `mass/parts.csv`는 1차의 63개 표에서 7b판으로 바뀐 부품 4개 행의 숫자만 7b판 값으로 바꾼 것입니다(`mass/README.md`).
- `manual/*.pdf`: 파일은 원본 그대로 복사했습니다(바이트 단위로 같음).
- `media/stills/*.png`: Blender가 넣은 텍스트 정보(원본 파일 경로, 날짜, 장면 이름 등)를 지웠습니다. 그림 픽셀은 그대로입니다.
