mgm136044/kobi-robot/lcd_face/SOFTWARE_HANDOFF.md

# 소프트웨어 팀 인계 문서: LCD 얼굴 판 코비 (2차, 모델 7b판)

이 문서는 코비의 소프트웨어를 맡는 세 팀(모션 리타게팅, 걷기 정책 학습, 실기 런타임)이 하드웨어에서 알아야 할 것을 한곳에 모은 것입니다. 쉬운 말로 썼고, 숫자마다 어느 파일에서 읽었는지 적었습니다. 출처 표기는 두 가지입니다. 저장소 안 파일은 저장소 맨 위 폴더 기준 경로로, 저장소 밖 파일은 "저장소 밖 설계 문서"로 적었습니다(저장소 밖 문서는 이 저장소에 없으므로, 필요하면 하드웨어 담당에게 요청해야 합니다).

**이 문서의 단계.** 지금은 2차입니다. 1차(커밋 d46fc16)는 모델 6판과 부품표 v11 기준이었고, 2차에서 머리를 가볍게 한 **모델 7b판**, **부품표 v12**, 조립 설명서 PDF(`lcd_face/manual/`)와 조립 영상으로 바꿨습니다. 6판 파일은 git 이력의 커밋 d46fc16에 있습니다(10절). 이 문서의 숫자는 모두 시뮬레이션 값이거나 설계 문서의 값이고, 실물 로봇에서 잰 값은 없습니다.

## 목차

1. 한눈에 보기
2. 관절 14개와 움직일 수 있는 범위
3. 서보 번호(ID)와 통신
4. 어깨 서보(MG90S)
5. 컴퓨터 2대의 핀 배치
6. 목 7핀 커넥터와 마이크 6핀 커넥터
7. 전원 경로와 전압 주의
8. 게임패드와 명령 보내는 길
9. 질량과 정책
10. 확정된 것, 2차에서 바뀐 것, 남은 것
11. 이 문서에서 확인하지 못한 것

## 1. 한눈에 보기

- **하드웨어 구성.** 몸통의 Raspberry Pi Zero 2 W가 걷기, 서보, 기울기 센서(IMU), 발 스위치를 맡고, 머리 안의 Raspberry Pi 4가 카메라, 마이크, 스피커, 얼굴 화면을 맡습니다. 두 컴퓨터는 UART(직렬 통신) 3가닥으로 이어집니다. 출처: `lcd_face/README.md` 1절, 설계 문서 배선 표 W11.
- **정책 파일.** `policy/lcd_face/2026_11_03_143411_61931520.onnx`입니다. 관측 101개를 받아 행동 14개를 냅니다. 입출력 규칙은 인쇄 얼굴 판과 같아 저장소 맨 위의 `README.md` 7절을 그대로 따릅니다. 출처: `lcd_face/README.md` 4절.
- **모델 파일.** `lcd_face/mujoco/kobi_scene.xml`(일반), `lcd_face/mujoco/kobi_scene_backlash.xml`(평가용 백래시 장면. 이 7b판 장면은 평가에만 썼고, 정책 학습은 머리 543.9 g의 별도 모델에서 했습니다). 메시 28개는 처음에 `python3 tools/fetch_upstream_meshes.py`로 내려받아야 열립니다. 출처: `lcd_face/README.md` 6절.
- **가장 중요한 주의.** 7b판 머리 질량은 모델 계산(꽉 찬 PLA)으로 636.2 g이라 정책이 학습한 범위(449.5~638.3 g)의 상한 바로 아래이고, 실제 출력(슬라이서 보통 설정)으로는 약 589.4 g입니다. 범위 안이지만 학습 때 이 근처 질량의 표본은 적었습니다. 9절에 정확한 범위와 비율을 적었습니다.

## 2. 관절 14개와 움직일 수 있는 범위

정책의 관측, 행동, MuJoCo 구동기(actuator)의 순서는 모두 아래 표의 번호(0부터 13)입니다. 다른 도구에서 읽을 때는 순서보다 이름으로 찾는 것이 안전합니다. 출처: 범위와 홈 자세는 `lcd_face/mujoco/kobi_scene.xml`의 관절 정의와 `home` 키프레임, 각도 환산(라디안에 180/π)은 이 문서에서 계산했습니다.

| 번호 | 이름 | 범위(도) | 범위(라디안) | 7b판 모델의 홈(라디안) | 서보 |
|---|---|---|---|---|---|
| 0 | left_hip_yaw | -30 ~ 30 | -0.5236 ~ 0.5236 | 0.002 | STS3215, ID 20 |
| 1 | left_hip_roll | -25 ~ 25 | -0.4363 ~ 0.4363 | 0.053 | STS3215, ID 21 |
| 2 | left_hip_pitch | -70 ~ 30 | -1.2217 ~ 0.5236 | -0.9093 | STS3215, ID 22 |
| 3 | left_knee | -90 ~ 90 | -1.5708 ~ 1.5708 | 1.3820 | STS3215, ID 23 |
| 4 | left_ankle | -90 ~ 90 | -1.5708 ~ 1.5708 | -0.5034 | STS3215, ID 24 |
| 5 | right_hip_yaw | -30 ~ 30 | -0.5236 ~ 0.5236 | -0.003 | STS3215, ID 10 |
| 6 | right_hip_roll | -25 ~ 25 | -0.4363 ~ 0.4363 | -0.065 | STS3215, ID 11 |
| 7 | right_hip_pitch | -30 ~ 70 | -0.5236 ~ 1.2217 | 0.9143 | STS3215, ID 12 |
| 8 | right_knee | -90 ~ 90 | -1.5708 ~ 1.5708 | 1.3930 | STS3215, ID 13 |
| 9 | right_ankle | -90 ~ 90 | -1.5708 ~ 1.5708 | -0.5090 | STS3215, ID 14 |
| 10 | neck_yaw | -30 ~ 30 | -0.5236 ~ 0.5236 | 0 | STS3215, ID 32 |
| 11 | neck_pitch | -10 ~ 10 | -0.1745 ~ 0.1745 | 0 | STS3215, ID 30 |
| 12 | shoulder_left | -135 ~ 25 | -2.356 ~ 0.4363 | 0 | MG90S, PWM(번호 없음) |
| 13 | shoulder_right | -135 ~ 25 | -2.356 ~ 0.4363 | 0 | MG90S, PWM(번호 없음) |

읽는 법과 주의는 다음과 같습니다.

- **왼쪽과 오른쪽 다리는 hip_pitch의 범위와 홈 부호가 서로 뒤집혀 있습니다**(왼쪽 -70~30도에 홈 -0.9093, 오른쪽 -30~70도에 홈 +0.9143). hip_roll도 홈 부호가 반대입니다. 리타게팅할 때 좌우를 같은 부호로 가정하면 안 됩니다. 출처: `lcd_face/mujoco/kobi_scene.xml`.
- **목 끄덕임(neck_pitch)은 위아래로 겨우 ±10도입니다.** 사람이나 캐릭터의 고개 숙임을 그대로 옮기면 거의 항상 한계에 걸립니다. 출처: 같은 파일.
- **홈 자세 값은 판마다 조금씩 다릅니다**(예: 왼쪽 hip_pitch가 인쇄 얼굴 판 -0.9303, 6판 모델 -0.9106, 7b판 모델 -0.9093). 위 표의 홈은 7b판 모델 파일의 값입니다(1차의 6판 모델과는 hip_pitch와 ankle이 최대 0.0013 rad 다릅니다). **정책이 학습할 때 쓴 홈은 이것이 아니라 학습용 모델(저장소 밖)의 홈**이고, 아래 표처럼 7b판 모델과 최대 약 0.0025 rad 다릅니다. 관측의 "관절 각도 - 홈"과 다리 행동의 "홈 + 0.25 x 행동"은 학습용 모델의 홈 기준이므로, 런타임은 아래 학습용 홈 값을 써야 합니다. 출처: `lcd_face/README.md` 6절, `lcd_face/mujoco/kobi_scene.xml`의 `home` 키프레임, 학습용 모델(저장소 밖)의 `home` 키프레임, 차이는 이 문서에서 계산했습니다. 참고: `tools/kobi_env_mirror.py`는 불러온 모델의 `home` 키프레임을 읽는 것으로 보여(160~162행), 7b판 장면으로 평가하면 학습 때와 최대 0.0025 rad 다른 홈에서 평가한 셈일 수 있습니다(직접 실행해 확인하지는 않았습니다).

| 번호 | 이름 | 학습용 모델의 홈(라디안) | 7b판 모델의 홈(라디안) | 차이(학습용 - 7b판) |
|---|---|---|---|---|
| 0 | left_hip_yaw | 0.002 | 0.002 | 0 |
| 1 | left_hip_roll | 0.053 | 0.053 | 0 |
| 2 | left_hip_pitch | -0.906761 | -0.909286 | +0.002525 |
| 3 | left_knee | 1.38197 | 1.38204 | -0.00007 |
| 4 | left_ankle | -0.505834 | -0.503379 | -0.002455 |
| 5 | right_hip_yaw | -0.003 | -0.003 | 0 |
| 6 | right_hip_roll | -0.065 | -0.065 | 0 |
| 7 | right_hip_pitch | 0.911761 | 0.914286 | -0.002525 |
| 8 | right_knee | 1.39297 | 1.39304 | -0.00007 |
| 9 | right_ankle | -0.511443 | -0.508988 | -0.002455 |
| 10~13 | neck_yaw, neck_pitch, shoulder_left, shoulder_right | 0 | 0 | 0 |

(목과 어깨의 "홈"은 0이지만, 정책의 목과 어깨 행동은 홈이 아니라 몸짓 목표를 중심으로 합니다. 아래 "정책의 어깨 행동" 설명과 저장소 맨 위 `README.md` 7.3절을 보세요.)

- **구동기의 힘 범위.** XML에는 다리와 목이 ±3.23 N·m, 어깨가 ±0.2 N·m로 적혀 있습니다. 학습 환경은 모델을 읽을 때 다리와 목을 ±1.91 N·m로 덮어씁니다(저장소 맨 위 `README.md` 4절, `tools/kobi_env_mirror.py`). XML만 읽어 직접 돌리면 학습 때보다 힘이 센 로봇이 됩니다. 위치 제어 세기(kp)는 다리와 목이 일반 장면 13.37, 백래시 장면 17.11이고, 어깨는 kp 1, 속도 감쇠 항 0.03(구동기 `biasprm 0 -1 -0.03`), 관절 damping 0.01입니다. 출처: `lcd_face/mujoco/kobi_scene.xml`, `lcd_face/mujoco/kobi_scene_backlash.xml`.
- **MuJoCo 장면이 서로 다른 점.** 백래시 장면은 다리 관절 10개마다 백래시용 가짜 관절이 붙어 관절이 25개(구동기는 14개)입니다. 출처: `lcd_face/README.md` 6절 표.
- **모양이 같은 인쇄 얼굴 판의 스켈레톤 파일**(`printed_face/skeleton/`)은 관절 14개의 이름과 순서가 같아 리타게팅에 참고할 수 있습니다. 다만 LCD 판 전용 스켈레톤은 만들지 않았습니다. 출처: 저장소 맨 위 `README.md` 14절.

## 3. 서보 번호(ID)와 통신

- **ID 배정.** 오른다리 10~14, 왼다리 20~24(각 다리는 엉덩이 요, 엉덩이 롤, 엉덩이 피치, 무릎, 발목 순서), 목 피치 30, 목 요 32입니다. 목 요 32는 원본 오리 런타임의 `head_yaw` 번호이고, 코비의 `neck_yaw`가 여기에 대응합니다. 출처: 설계 문서 조립 설명서 S03b(서보 설정). 원본 오리 런타임 v2의 `rustypot_position_hwi.py`(공개 저장소의 `v2` 가지, 2026-11-04에 열어 확인)에도 같은 번호가 있습니다(왼다리 20~24, 오른다리 10~14, neck_pitch 30, head_yaw 32). 원본에는 head_pitch 31, head_roll 33도 있지만 코비에는 그 서보가 없습니다. **원본 런타임의 관절 순서(왼다리, 목과 머리, 오른다리)는 이 정책의 순서(왼다리, 오른다리, 목, 어깨)와 다릅니다.** 순서에 기대지 말고 이름으로 대응시켜야 합니다. 출처: 위 원본 파일, 2절 표.
- **서보 종류.** FEETECH STS3215(ST-3215-C001, 7.4 V판) 22개를 삽니다. 12개는 로봇에 쓰고(다리 10, 목 2) 10개가 여분입니다. 출처: `lcd_face/bom/코비_BOM_오픈덕미니v2_LCD_v12_20261104.md` 부품표 1번. 정지 토크는 6 V에서 16.5, 7.4 V에서 19.5 kg·cm, 정지 전류는 각각 2 A와 2.5 A입니다. 출처: 저장소 밖 설계 문서(조립 설명서 내용 메모, 서보 데이터시트 값).
- **연결 방법.** 서보 12개가 직렬 버스(한 가닥 선에 사슬로 연결) 하나로 Waveshare Bus Servo Adapter (A) 보드에 이어지고, 이 보드가 Pi Zero 2 W의 마이크로 USB로 이어집니다. 통신 속도는 1,000,000 bps이고, 보드의 점퍼는 USB로 쓸 때 B 위치입니다. 출처: 설계 문서 배선 표 W05, W06. 원본 런타임의 기본 포트는 `/dev/ttyACM0`, 속도는 1,000,000입니다(위 원본 파일).
- **ID를 쓰는 방법.** 원본 런타임 저장소의 `scripts/configure_motor.py --id 20`처럼 서보를 한 개씩만 연결하고 씁니다. 새 서보의 번호는 1입니다. 출처: 설계 문서 조립 설명서 S03b.
- **아직 안 정해진 것.** 코비 14관절과 서보 번호의 대응표를 원본 런타임 설정에 옮기는 방법은 확정되지 않았습니다. 설계 문서는 그 전에 원본의 `check_motors`와 `find_soft_offsets` 스크립트를 돌리지 말라고 적었습니다. 서보 영점이 서보 가운데 값 2048과 같은지, 코비용 하드웨어 런타임(14관절)과 보정 절차는 설계 문서 부록 "정할 것 목록" 2번과 3번에 열려 있습니다. 엉덩이 피치 서보를 어느 방향으로 달아야 영점이 맞는지는 S08에서 실물로 확인할 것입니다. 좌우 다리의 부호와 오프셋을 정하는 규칙은 설계 문서에 따로 정해져 있지 않으므로 소프트웨어 팀이 정해야 합니다. 출처: 설계 문서 S03b, S08, 부록 2번과 3번.

## 4. 어깨 서보(MG90S)

- **PWM 신호 핀.** 왼쪽 어깨 GPIO 12(40핀 헤더의 물리 32번), 오른쪽 어깨 GPIO 13(물리 33번)입니다. 둘 다 Pi Zero 2 W이고 50 Hz 펄스를 씁니다. 출처: 설계 문서 배선 표 W09(설계 문서가 정한 값). 주의: 물리 13번은 GPIO 27(오른발 스위치)이므로, GPIO 13과 물리 13을 혼동하면 안 됩니다. 출처: 설계 문서 S04 주의.
- **중립.** 펄스 폭 1.5 ms가 서보의 가운데이고, 이때 팔이 -55도(앞쪽 위로 55도)에 놓이도록 조립합니다. -55도는 어깨 범위 -135~25도의 한가운데입니다. 출처: 설계 문서 W09, `lcd_face/mujoco/kobi_scene.xml`의 어깨 범위.
- **전원.** 어깨 서보 전원은 팔 서보용 5 V 모듈에서 따로 받습니다. 신호선만 Pi Zero가 줍니다. 출처: 설계 문서 W09, W17.
- **정해지지 않은 것.** 펄스 폭 범위(후보 0.5~2.5 ms)와 양 끝점, 펄스가 길어질 때 팔이 앞위 중 어느 쪽으로 가는지(반대면 신호 부호를 뒤집어야 함), 소프트웨어 PWM의 흔들림(pigpio 같은 하드웨어 방식 검토). 출처: 설계 문서 S12, S22, 부록의 정할 것.
- **정책의 어깨 행동은 각도가 아닙니다.** 모터 목표 = clip(몸짓 목표 + 0.15 rad x 행동, 관절 범위)이고(목은 좌우 0.10 rad, 끄덕임 0.05 rad), 다리는 학습용 홈 + 0.25 x 행동입니다. 출처: 저장소 맨 위 `README.md` 7.3절. 그 목표 각도(-135~25도)를 MG90S의 펄스 폭으로 바꾸는 식은 아직 정해지지 않았습니다.

## 5. 컴퓨터 2대의 핀 배치

두 컴퓨터 모두 40핀 헤더를 씁니다. 번호는 칩 쪽 GPIO 번호가 아니라 헤더의 위치(물리 번호)입니다. 출처: 설계 문서 40핀 헤더 표(두 보드가 같은 배치).

**Pi Zero 2 W (몸통).**

| 물리 핀 | 용도 |
|---|---|
| 2 | 몸통 5 V 모듈의 +5 V(전원 입력) |
| 6 | 몸통 5 V 모듈의 접지 |
| 8, 10 | UART TXD(GPIO 14)와 RXD(GPIO 15). 목 커넥터 2번(송신)과 6번(수신)으로 감 |
| 20 | UART 신호 접지(목 커넥터 5번) |
| 1, 3, 5, 9 | 기울기 센서 BNO055: 3.3 V, SDA(GPIO 2), SCL(GPIO 3), 접지 |
| 13, 15, 14 | 발 스위치: 오른발 GPIO 27(13번), 왼발 GPIO 22(15번), 공통 접지(14번) |
| 32, 33 | 어깨 서보 PWM: GPIO 12, GPIO 13 |

**Pi 4 (머리).**

| 물리 핀 | 용도 |
|---|---|
| 2, 6 | 머리 5 V 변환기에서 오는 +5 V와 접지(Pi 4의 유일한 전원 입력) |
| 4 | 앰프(MAX98357A)의 VIN 5 V |
| 8, 10, 14 | UART TXD(GPIO 14), RXD(GPIO 15), 접지. 목 커넥터 6번(Pi 4 송신), 2번(수신), 5번(접지)으로 감 |
| 12 | I2S 비트 클록(GPIO 18). 앰프 BCLK와 마이크 SCK가 한 단자 |
| 35 | I2S 좌우 클록(GPIO 19). 앰프 LRC와 마이크 WS가 한 단자 |
| 38 | I2S 데이터 입력(GPIO 20). 마이크 SD |
| 40 | I2S 데이터 출력(GPIO 21). 앰프 DIN |
| 39 | 앰프 접지 |
| 17, 34, 30 | 마이크 3.3 V, 마이크 접지, 마이크 L/R(접지에 묶어 왼쪽 채널) |

- UART는 3.3 V 신호이고 두 컴퓨터의 송신과 수신을 엇갈려 잇습니다. **통신 속도, 메시지 형식, 직렬 콘솔 끄기는 아직 정하지 않았습니다.** 두 컴퓨터 사이에서 정책 결과, 센서 값, 명령을 주고받는 규약은 소프트웨어 팀이 정해야 합니다. 출처: 설계 문서 W11, 40핀 표 아래 주.
- 헤더에서 핀 번호가 겹치지 않는 것을 설계 문서가 확인했습니다(UART 8, 10, 20은 기울기 센서 1, 3, 5, 9, 발 스위치 13, 14, 15, 어깨 32, 33과 안 겹침). 출처: 설계 문서 S17 미확인 항목.
- 기울기 센서가 앞으로 기울 때 값이 어느 방향으로 변하는지는 실물로 확인할 항목으로 남아 있습니다(관측의 gyro와 accelerometer 부호에 영향). 출처: 설계 문서 S09 미확인 항목(S24a에서 시험).
- 거리 센서(VL53L1X)의 핀은 아직 문서에 없습니다. 출처: 설계 문서 W10.

## 6. 목 7핀 커넥터와 마이크 6핀 커넥터

머리를 몸통에서 떼려면 머리 안의 커넥터를 끊습니다. 목을 지나는 선은 7가닥뿐입니다. 출처: 설계 문서 W11, W18, W20, S17.

**목 JST SM 7핀(몰드에 새겨진 칸 번호 기준).**

| 핀 | 신호 |
|---|---|
| 1 | 스피커 + |
| 2 | Pi Zero 송신 → Pi 4 수신 |
| 3 | 전원 접지 |
| 4 | 스위치 뒤 배터리 + (7.4 V, 머리 5 V 변환기로 감) |
| 5 | 신호 접지 |
| 6 | Pi 4 송신 → Pi Zero 수신 |
| 7 | 스피커 - |

**마이크 SM 6핀 분리 커넥터(v8부터).**

| 핀 | 신호 |
|---|---|
| 1 | 3.3 V |
| 2 | 접지 |
| 3 | L/R(접지에 묶음) |
| 4 | SD(데이터) |
| 5 | WS(좌우 클록) |
| 6 | SCK(비트 클록) |

- 마이크 쪽은 작은 플러그(SMP, 파란 표시), Pi 쪽은 리셉터클(SMR)이라 목의 7핀 플러그가 이 6핀에 들어가지 않게 했습니다. 출처: 설계 문서 W21.
- 스피커 두 가닥은 어느 쪽도 접지에 잇지 않습니다. 출처: 설계 문서 W20.
- 몰드에 새겨진 칸 번호가 위 순서와 같은지는 실물에서 통전으로 확인해야 합니다. 마이크 커넥터는 모델에 없는 부품입니다. 출처: 설계 문서 S17 미확인 항목, W21.
- 목 커넥터의 접점 정격: JST 원본은 접점당 3 A인데 이 제품은 호환품이라 정격을 확인하지 못했습니다. 머리 가지의 최대 전류는 설계 문서의 계산으로 약 3.5 A입니다. 출처: 설계 문서 W18.

## 7. 전원 경로와 전압 주의

**전원이 흐르는 순서.** 18650 셀 2개(직렬, 2S) → 보호회로(BMS) → 토글 스위치 → XT30 → 7.4 V 공급선 → 가지(서보 보드, 몸통 5 V 모듈 2개, 머리 가지). 머리 가지는 5 A 퓨즈를 거쳐 목 7핀 커넥터의 3번, 4번으로 머리 5 V 변환기에 갑니다. 팩 전압은 6~8.4 V(완충 8.4 V)입니다. 출처: 설계 문서 W01, W02, W04, W17, W18, W23.

**소프트웨어가 알아야 할 서보 전원 사실.**

- Waveshare Bus Servo Adapter (A)는 입력 전압을 조정하지 않고 서보에 그대로 보냅니다. 보드의 제어 회로는 USB 5 V로 켜집니다. 위키의 "입력 9~12.6 V"는 12 V 서보용 값이고, 제조사 문서는 5~8.4 V도 된다고 답합니다. 보드 최대 전류는 5 A입니다. 출처: `lcd_face/bom/코비_BOM_오픈덕미니v2_LCD_v12_20261104.md` 위험 32.
- 전원은 극성 반대 보호가 있는 **나사 단자**로 넣고, 원형 DC 잭은 쓰지 않습니다(보호가 없어서). 출처: 위 BOM 위험 32.
- STS3215 7.4 V판의 사용 전압은 4~7.4 V인데 완충 팩은 8.4 V입니다. 서보의 과전압 보호가 힘을 풀 수 있어서, 7.4 V와 완충 8.4 V에서 서보 12개의 응답과 전압 오류를 책상에서 먼저 시험해야 합니다. 서보 안의 전압 관련 기록 칸(아래 표)은 **제3자 자료에서 가져왔고 실물로 확인하라고 표시된 값**입니다. 출처: 위 BOM 위험 32, 설계 문서 S03b.
- **걷기 전에 지킬 규칙(조립 설명서 v6h, 숫자는 설명서가 정한 값).** (1) 가득 충전한 8.4 V 팩으로는 S03b 전압 시험 c(8.4 V에서 서보 12개 응답 100번, 0x41 비트 0이 1이 되지 않고 힘이 풀리지 않음)의 결과가 나오기 전에 걷기 시험을 하지 않습니다. 시험 c에서 보호가 작동하면 선택지는 두 가지(매번 팩이 약 8.0 V 아래로 내려온 뒤 시작하기, 팀이 정한 뒤 0x0E 올리기)이고 아직 정해지지 않았습니다. (2) 첫 걷기 시험에서는 서보 전압 0x3E를 1초에 50번(50 Hz) 이상 기록하고, 서보 사슬 전압의 최솟값이 약 6 V보다 높고 보호회로(BMS)가 전원을 끊지 않아야 합니다. 출처: 설계 문서 S03b 시험 c와 e, S24.

| 서보 메모리 주소 | 뜻(제3자 자료, 실물로 확인할 것) |
|---|---|
| 0x3E | 현재 전압(0.1 V 단위) |
| 0x41 | 상태(비트 0이 전압 이상) |
| 0x0E | 최대 입력 전압 한계(단위는 0x0F와 같은 0.1 V로 "보이지만" 확인 못 함). **팀이 정하기 전에는 바꾸지 마세요.** 올리면 7.4 V용 서보를 정격 위에서 쓰게 됩니다(설명서 S03b의 열린 결정) |
| 0x0F | 최소 입력 전압 한계(기본 40, 곧 4.0 V) |
| 0x13 | 힘이 풀리는 조건(비트 0이 전압 보호) |

- **팩이 6.4 V(셀당 3.2 V)까지 내려가면 멈추고 충전하라**는 값은 조립 설명서를 쓰는 쪽이 정한 값이며 설명서 v6h에 들어 있습니다. 서보 메모리를 읽는 방법은 설명서에서 아직 "정할 것"이지만, 원본 오리 런타임 v2에는 `scripts/check_voltage.py`가 있습니다(공개 저장소의 `v2` 가지, 2026-11-04에 열어 확인). 이 스크립트는 pypot의 `FeetechSTS3215IO`로 `/dev/ttyACM0`(1,000,000 bps)를 열고 서보의 현재 전압(0.1 V 단위 값에 0.1을 곱해 V로)을 **한 번 읽어 출력**합니다. 그런데 코비에 없는 ID 31과 33도 함께 읽으므로 **쓰기 전에 ID 목록을 코비에 맞게 고쳐야 합니다.** 이 스크립트가 50 Hz 연속 기록을 하는 것은 아닙니다. 출처: 설계 문서 S03b, S24, 위 원본 파일.
- 전원 스위치는 교류 125 V 3 A 정격만 있고 직류 정격이 없습니다. 모든 부하 전류가 이 스위치를 지나므로, 선을 만지거나 커넥터를 꽂을 때는 스위치가 아니라 **XT30을 뽑아** 전원을 끊습니다. 출처: BOM 위험 33.

**머리(Pi 4) 합격 기준.** 설계 문서의 값입니다. 머리 5 V 변환기는 고정 5 V 모듈이라 맞추는 나사가 없습니다.

| 항목 | 기준 | 출처 |
|---|---|---|
| 변환기 무부하 출력 | 5.00~5.20 V | 설계 문서 S03a, S04 |
| Pi 4 핀 2와 6 사이(부하 중) | 4.90~5.20 V | 설계 문서 S24a |
| 전원 부족 기록 `vcgencmd get_throttled` | 0x0 | 설계 문서 S24a, S24 |
| CPU 온도 | 75도 미만. 머리 껍데기를 닫고 찬 상태에서 켜서 영상과 카메라를 동시에 돌리면서 15분 이상, 온도가 안정될 때까지 지켜봄 | 설계 문서 S24 |

## 8. 게임패드와 명령 보내는 길

- **Xbox 컨트롤러는 사지 않습니다**(사용자 결정, 2026-11-04). 걷기 명령과 운영자 정지에 쓰던 것이라 대신할 방법이 필요합니다. 공유기와 레깅스 원단도 사지 않습니다. 출처: BOM 위험 34.
- 원본 오리 런타임 v2의 `xbox_controller.py`는 `pygame.joystick.Joystick(0)`, 곧 처음 연결된 게임패드를 읽습니다(공개 저장소의 `v2` 가지, 2026-11-04에 열어 확인). 그래서 갖고 있는 게임패드가 블루투스로 Pi Zero 2 W에 붙는다면 동작할 수 있습니다. 다만 코드가 읽는 번호는 Xbox 컨트롤러 기준(축 0~3은 스틱, 4와 5는 트리거, 버튼 0, 1, 3, 4, 6, 7, 십자 키 1개)이라 **다른 게임패드는 버튼 번호가 달라 설정을 고쳐야 할 수 있습니다.** 출처: 위 원본 파일, BOM 위험 34.
- 안 되면 노트북에서 Wi-Fi로 걷기 명령(vx, vy, wz)과 정지 명령을 보내는 길을 소프트웨어 팀이 만들어야 합니다. 정책이 학습한 명령 범위는 vx -0.15~0.15 m/s, vy -0.074~0.074 m/s, wz -1~1 rad/s입니다. 출처: BOM 위험 34, 저장소 맨 위 `README.md` 7.4절.
- **물리적으로 확실한 전원 차단은 XT30을 뽑는 것뿐입니다.** 게임패드나 Wi-Fi 정지는 모두 소프트웨어 정지입니다. 출처: BOM 위험 33, 34.
- 공유기 없이 행사장 Wi-Fi를 쓰면 접속 제한이나 혼잡으로 끊길 수 있어 휴대폰 핫스팟을 예비로 두라고 적혀 있습니다. 출처: BOM 위험 34.

## 9. 질량과 정책

### 9.1 질량이 두 가지로 있습니다

MuJoCo 모델의 인쇄 부품 질량은 부피에 PLA 밀도(1.24 g/cm3)를 곱한 "속이 꽉 찬(솔리드)" 값입니다. 실제 출력은 벽 몇 겹에 성근 속채움이라 더 가볍습니다. 그래서 OrcaSlicer로 인쇄 부품 63개를 실제 설정으로 잘라 질량을 읽었습니다(`lcd_face/mass/`). 설정은 두 가지입니다.

- **P1 "보통"**: 벽 3겹, 속채움 15%(자이로이드 무늬).
- **P2 "튼튼"**: 벽 4겹, 속채움 25%.

오리 뼈대(업스트림) 부품의 질량은, 업스트림 문서(`docs/sim2real.md`와 `print_guide.md`)에 따르면 이미 PLA 15% 속채움을 반영한 슬라이서 추정값입니다(업스트림 문서가 그렇게 적었다는 뜻이고, 여기서 직접 재거나 몸통 질량에서 그 몫을 떼어 확인하지는 못했습니다). 그런데 코비가 새로 만든 인쇄 부품(머리, 외피 등)은 솔리드로 계산되어 있습니다. 그래서 P1로 바꾸면 두 쪽의 기준이 같아집니다. **관성(회전하기 어려운 정도)과 무게중심은 다시 계산하지 않았습니다.** 질량만 바꾼 표입니다. 가장 간단한 근사는 새 몸체 질량에 비례해 관성도 줄이는 것입니다. 출처: `lcd_face/mass/README.md` 1절, 7절.

| MuJoCo 몸체 | XML(솔리드) | P1 | P2 | 인쇄 부품 수 |
|---|---|---|---|---|
| trunk_assembly(몸통) | 1237.7 g | 1122.7 g | 1149.0 g | 36 |
| kobi_head(머리, 전자부품 포함) | 636.2 g | 589.4 g | 598.1 g | 9 |
| kobi_neck_link | 81.9 g | 78.7 g | 79.9 g | 2 |
| kobi_arm_left | 71.2 g | 62.5 g | 64.9 g | 6 |
| kobi_arm_right | 71.2 g | 62.4 g | 65.0 g | 6 |
| foot_assembly(왼발) | 113.8 g | 110.0 g | 110.3 g | 1 |
| foot_assembly_2(오른발) | 114.3 g | 110.4 g | 110.8 g | 1 |
| knee_and_ankle_assembly_2(왼쪽 종아리) | 98.1 g | 97.8 g | 97.8 g | 1 |
| knee_and_ankle_assembly_4(오른쪽 종아리) | 98.1 g | 97.7 g | 97.8 g | 1 |
| 로봇 전체 | 2962.1 g | 2771.1 g | 2813.1 g | 63 |

나머지 몸체 6개(엉덩이 롤 2개, 롤-피치 2개, 무릎 2개)는 인쇄 부품이 없어 그대로입니다. 표는 모델 7b판 기준입니다(1차의 6판은 머리 686.2 / 635.1 / 644.4 g, 로봇 3012.1 / 2816.7 / 2859.4 g). 출처: `lcd_face/mass/bodies.csv`, `lcd_face/mass/README.md` 6절. 부품별 값은 `lcd_face/mass/parts.csv`(7b판에서 바뀐 부품의 6판, 7판, 7b판 비교는 `parts_changed_v7b.csv`), 오리 뼈대 부품의 참고용 슬라이스는 `lcd_face/mass/skeleton_parts.csv`(몸체 질량에는 반영 안 함), 쓴 설정은 `lcd_face/mass/settings/`입니다.

한계: 슬라이서 추정은 실제 저울값과 5~10% 어긋날 수 있습니다. 머리 반쪽 하나와 윗판 하나만 실제로 달아 보면 보정 비율을 얻을 수 있습니다. 출처: `lcd_face/mass/README.md` 7절. 특히 7b판 껍데기는 안쪽 피부가 0.9 mm라 슬라이서가 벽 수를 줄여 채우므로 6판의 1.2 mm보다 추정이 불확실합니다.

### 9.2 정책이 학습한 머리 질량 범위

학습 환경은 머리 질량을 `기본 543.9 g x U(0.9, 1.1) + U(-40, +40) g`로 무작위로 바꿨습니다(U는 구간 안 균등 분포). 이 식으로 계산하면 449.5~638.3 g입니다. 같은 환경이 무게중심도 축마다 ±5 mm 흔들고, 다른 몸체 질량은 x0.9~1.1, 몸통은 ±100 g 바꿉니다. 출처: 저장소 밖 설계 문서(학습 환경 `randomize.py`와 학습용 모델 XML의 머리 질량 0.543889 kg), 계산은 이 문서에서 했습니다.

앞선 문서에 있던 "약 454~642 g"은 학습 코드 주석의 근사값이어서, 이 저장소의 `lcd_face/README.md`, 루트 `README.md`, `lcd_face/mass/README.md`는 449.5~638.3 g으로 고쳤습니다. 부품표도 v12의 위험 17에서 449.5~638.3 g으로 바로잡혔습니다(1차의 v11에는 옛 근사값 약 454~642 g이 남아 있었습니다).

**"범위 안"이라고 해서 학습한 질량은 아닙니다.** 범위 전체에 표본이 고르게 있는 것이 아니라 사다리꼴 분포입니다. 기본값에 곱하는 항(0.9~1.1배)이 폭 108.8 g(= 543.9 x 0.2)이고 더하는 항(±40 g)이 폭 80 g이라서, 두 균등 분포를 더하면 다음 모양이 됩니다.

- 449.5~529.5 g: 표본이 직선으로 늘어나는 구간(폭 80 g)
- 529.5~558.3 g: 표본이 가장 많고 평평한 구간(폭 28.8 g)
- 558.3~638.3 g: 표본이 직선으로 줄어드는 구간(폭 80 g)

그래서 질량 m(558.3 g 이상)보다 무거운 학습 표본의 비율은 **(638.3 - m)의 제곱 / 17,408**입니다(17,408 = 2 x 108.8 x 80). 난수 200만 개로 뽑아 확인한 값과 같았습니다.

| 머리 | 질량 | 학습 범위 상한(638.3 g)과의 차이 | 학습 표본 중 이 질량 이상의 비율 |
|---|---|---|---|
| 6판, 솔리드 | 686.2 g | +47.9 g(범위 밖) | 0% |
| 6판, 슬라이서 P1 | 635.1 g | -3.2 g(범위 끝자락) | 약 0.06%(사실상 학습하지 않음) |
| 6판, 슬라이서 P2 | 644.4 g | +6.1 g(범위 밖) | 0% |
| 7판 초안(올리지 않음), P1 | 582.7 g | -55.6 g | 약 18% |
| **7b판, 솔리드(모델 값)** | 636.2 g | -2.1 g | 약 0.02% |
| **7b판, 슬라이서 P1** | 589.4 g | -48.9 g | 약 14% |
| **7b판, 슬라이서 P2** | 598.1 g | -40.2 g | 약 9% |

출처: 6판, 7판 초안, 7b판 질량은 모두 `lcd_face/mass/bodies.csv`(열 이름 "6판 body mass P1 g", "7판 body mass P1 g", "7b판 body mass P1 g" 등)와 `lcd_face/mass/README.md` 1절이고, 차이와 비율은 이 문서에서 계산했습니다. 슬라이서 추정이 실제와 10% 어긋나 출력 부품이 10% 무거워도 7b판 머리는 약 621.6 g으로 상한 안입니다(`lcd_face/mass/README.md` 7절).

**모델과 슬라이서 질량에 들어 있지 않은 것.** 자석과 나사는 가정 값으로만 들어 있습니다(머리 3.6 g, 몸통의 선과 나사 60 g). 접착제와 마이크 SM 6핀 분리 커넥터는 모델에 없습니다. 그래서 실제 머리는 위 표의 값보다 몇 g 더 무거울 수 있습니다. 부품을 받으면 저울로 재서 고쳐야 합니다. 출처: `lcd_face/mass/README.md` 7절, `lcd_face/README.md` 3절 5번.

**머리의 무게중심.** 머리 몸체 좌표계(머리 몸체의 `inertial pos`)에서의 질량 중심은 7b판에서 (17.5, 2.3, 28.3) mm입니다(6판은 (16.0, 2.4, 28.9) mm). 출처: `lcd_face/mujoco/kobi_scene.xml`의 `kobi_head` 몸체(0.0175271, 0.00231551, 0.0282727 m). `lcd_face/mujoco/sim_report.json`의 `blender_head_com_mm` (2.3, 39.5, 463.3) mm는 Blender 세계 좌표의 값이라 몸체 좌표가 아니고, 같은 파일의 `head_subtree_com_world_mm` (-39.5, 2.3, 471.8) mm는 MuJoCo 세계 좌표의 값입니다(어느 자세에서 쟀는지는 파일에 없습니다). 서로 좌표계가 다르니 섞어 쓰지 마세요.

정책을 다시 학습할지는 이 표를 보고 정하면 됩니다. 정책은 6판이나 7b판 질량으로 학습한 것이 아닙니다(학습 범위 449.5~638.3 g).

학습용 모델은 몸통 질량도 7b판과 다릅니다. 학습용 XML의 몸통(`trunk_assembly`)은 1294.3 g, 7b판은 1237.7 g으로 56.6 g 가볍고, 이 차이는 학습 때 몸통 무작위화(링크 질량 x0.9~1.1 다음에 ±100 g, `LINK_MASS_SCALE_RANGE` (0.9, 1.1)와 `TORSO_MASS_OFFSET_KG_RANGE` (-0.1, 0.1)) 범위 안입니다. 머리 무게중심은 7b판 (17.5, 2.3, 28.3) mm, 학습용 모델 (19.3, 0.4, 27.8) mm로 축마다 2 mm 아래로 다르고, 학습 때 머리 무게중심 흔들기(`HEAD_COM_JITTER_M` 0.005, 즉 ±5 mm) 안입니다. 7b판으로 다시 학습한다면 이 저장소의 `lcd_face/mujoco/kobi_scene_backlash.xml`에 학습 때 쓴 홈 자세를 적용해 쓰거나, 하드웨어 담당에게 학습용 XML(이 저장소에 없음)을 요청하세요.

### 9.3 정책 파일과 평가

- **`policy/lcd_face/2026_11_03_143411_61931520.onnx`**(884,177바이트). 인쇄 얼굴 판 최종 정책(1억 5,100만 걸음)에서 약 6,000만 걸음 더 학습했고, 파일 이름의 61,931,520이 체크포인트 걸음 수입니다. 출처: `lcd_face/README.md` 4절.
- **평가 결과**(`policy/lcd_face/eval/`의 JSON 5개). 시뮬레이션(MuJoCo 3.14.0, 백래시 장면, 관측 잡음 1.0, 행동 지연 0, 346회)에서 일부러 세게 미는 시험 192회 중 넘어진 횟수는 3판 머리(561.8 g) 103회, 5판(673.6 g) 108회, 6판(686.2 g) 105회, **7b판(636.2 g) 108회**입니다(7b판은 서 있을 때 52, 걸을 때 56). 걷기 속도 추종 66회와 몸짓 88회는 네 장면 모두 한 번도 넘어지지 않았습니다. 7b판 JSON은 이 저장소의 파일로 다시 돌려 확인하지는 않았습니다. 이어서 학습한 정책이 옛 정책보다 낫다는 증거는 이 표에 없습니다(3판 장면에서 103회 대 102회). 출처: `lcd_face/README.md` 4절.
- 평가를 다시 돌리는 명령과 읽는 법은 `lcd_face/README.md` 4절과 6절에 있습니다. 실물 로봇에서 정책을 돌린 기록은 없습니다.

## 10. 확정된 것, 2차에서 바뀐 것, 남은 것

**확정(1차에서 올렸고 2차에서도 같음).**

- 관절 14개의 이름, 순서, 범위(2절). 모델 7b판에서도 관절 구조는 같습니다. 홈 자세 값은 7b판 모델에서 hip_pitch, knee, ankle이 6판과 조금 달라졌고(최대 0.0013 rad) 2절 표에 7b판 값을 적었습니다.
- 서보 ID와 통신 방식(3절), 어깨 PWM 핀과 중립(4절), 두 컴퓨터의 핀 배치(5절), 목 7핀과 마이크 6핀의 핀 순서(6절). 단, 설계 문서가 "실물로 확인" 또는 "정할 것"으로 표시한 항목은 각 절에 적었습니다.
- 부품표 v12(`lcd_face/bom/`): 부품 합계 2,228,890원, 배송비 추정 포함 총액 2,259,090원, 63행(합계에 넣는 행 54, 선택 품목 9). 서보 22개. 사는 부품과 금액은 1차의 v11과 같습니다. 출처: `lcd_face/bom/코비_BOM_오픈덕미니v2_LCD_v12_20261104.md`, `.csv`.

**2차에서 바뀐 것.**

- **모델이 6판에서 7b판으로 바뀌었습니다.** 머리 껍데기 안쪽 피부를 0.9 mm로 얇게 하고(특징 둘레 5 mm와 이음 둘레 5 mm는 그대로), 머리 틀, 파이 받침, 화면 받침에 구멍을 뚫었습니다. 머리 질량은 모델 686.2 g에서 636.2 g, 로봇 전체는 3012.1 g에서 2962.1 g이 되었고, 슬라이서 추정 머리는 보통 설정 589.4 g입니다(9절). 사는 부품에는 영향이 없습니다. 출처: `lcd_face/README.md` 2절, 7b판 모델 README(저장소 밖).
- 바뀐 파일: `lcd_face/blender/kobi_v7_lcd_v7b.blend`, `lcd_face/mujoco/`의 두 장면과 `sim_report.json`과 STL 2개, `lcd_face/print/`의 껍데기, 머리 틀, 파이 받침, 화면 받침, 시험 조각 2개와 `print/test_coupons/coupons_build.json`, 부품 표 JSON 2개, 새로 들어온 `print/extra/`(좁은 엉덩이 판 2개), `lcd_face/mass/`(7b판 질량), `lcd_face/bom/`(v12), `policy/lcd_face/eval/eval_ft61931520_on_v7b.json`(새 파일).
- 조립 설명서 PDF(`lcd_face/manual/코비_조립설명서_LCD_v6h_20261104.pdf`)와 조립 영상(`lcd_face/manual/kobi_assembly_v6h.mp4`, 이 영상도 6판 모델 렌더이며 첫 2.5초 자막에 그렇게 적혀 있음)이 `lcd_face/manual/`에 들어왔습니다. 설명서의 그림은 6판 모델이고 조립 순서와 그림은 7b판에도 맞습니다. 설명서가 스스로 "초안"이라고 적었으니 실물과 대조하며 쓰세요. 이 문서 7절의 전원 규칙(팩 6.4 V 정지 기준, 8.4 V 시험 c 전 걷기 금지, 0x3E 50 Hz 기록, 여분 서보 10개)은 설명서 v6h에 그대로 들어 있습니다.
- 1차에서 부품표 v11의 위험 17에 남아 있던 옛 학습 범위(약 454~642 g, 44.2 g)는 v12에서 449.5~638.3 g으로 바로잡혔습니다.
- 1차의 6판 파일(모델, 6판 MuJoCo 장면, 6판 인쇄 STL, 부품표 v11, 6판 질량 표)은 이 폴더에서 빠졌고 git 이력의 커밋 d46fc16에 있습니다.

**남은 것.** 정책을 7b판 머리 질량으로 다시 학습하지 않았습니다(학습 범위 안이지만 589.4 g 이상인 표본은 약 14%). 0.9 mm 껍데기와 구멍 뚫린 받침의 실제 강도, 파이 받침 구멍 천장의 23 mm 다리 놓기, 슬라이서 질량의 실제 저울 대조는 모두 재어 보지 않았습니다(`lcd_face/README.md` 3절).

## 11. 이 문서에서 확인하지 못한 것

- 코비 14관절과 서보 번호의 대응을 런타임 설정으로 옮기는 방법, 서보 영점과 보정 절차(3절, 설계 문서 부록 2번과 3번). 좌우 다리의 부호와 오프셋 규칙은 설계 문서에도 없습니다.
- UART 속도와 메시지 형식, 두 컴퓨터가 주고받는 내용(5절). 어깨 PWM의 펄스 범위와 방향(4절).
- 서보 메모리 주소(7절 표)의 출처 주소와 0x0E의 단위. 완충 8.4 V에서 서보 과전압 보호가 걸리는지(S03b 시험 c의 결과가 아직 없음). `check_voltage.py`를 코비에 맞게 고쳐 실제로 돌려 본 기록도 없습니다.
- 보드 최대 5 A, 서보 정지 전류 2.5 A(서보 하나), 머리 가지 약 3.5 A의 실제 걷기 전류는 잰 적이 없습니다.
- 머리 합격 기준 중 "변환기를 5.10 V로 맞춘다"는 상담 메모가 있으나, 설명서(v6c와 v6h 모두)는 고정 5 V 모듈이라 맞추는 곳이 없다고 적혀 있어 이 문서에는 5.00~5.20 V(무부하)만 넣었습니다.
- 통풍구가 충분한지, 카메라 리본의 접점 면(A형, B형), 짧은 HDMI 케이블의 플러그 방향은 실물이 있어야 정해집니다(`lcd_face/README.md` 3절).
- 인쇄 부품 합계는 `lcd_face/print/parts_table_full.json`이 1260.6 g, `lcd_face/mass/`의 솔리드 합이 1259.9 g으로 0.7 g 다릅니다(원인은 확인하지 않았습니다. 부품마다 반올림한 값 때문일 수 있습니다).
