mgm136044/kobi-robot/lcd_face/mass/settings/applied_settings_P1_from_gcode_header.txt

layer_height = 0.2
initial_layer_print_height = 0.2
wall_loops = 3
top_shell_layers = 5
bottom_shell_layers = 4
top_shell_thickness = 0
bottom_shell_thickness = 0
sparse_infill_density = 15%
sparse_infill_pattern = gyroid
line_width = 0.42
outer_wall_line_width = 0.42
inner_wall_line_width = 0.45
sparse_infill_line_width = 0.45
internal_solid_infill_line_width = 0.45
top_surface_line_width = 0.42
initial_layer_line_width = 0.45
nozzle_diameter = 0.4
filament_diameter = 1.75
filament_density = 1.24
filament_flow_ratio = 0.98
enable_support = 0
brim_type = no_brim
skirt_loops = 0
enable_prime_tower = 0
printable_area = 0x0,256x0,256x256,0x256
printable_height = 256
gcode_flavor = marlin
detect_thin_wall = 0
only_one_wall_top = 0
only_one_wall_first_layer = 0
ensure_vertical_shell_thickness = ensure_all
ironing_type = no ironing
seam_position = aligned
spiral_mode = 0
