mgm136044/kobi-robot/lcd_face/media/stills/v3_ft61931520_gesture_demo_f0525.png

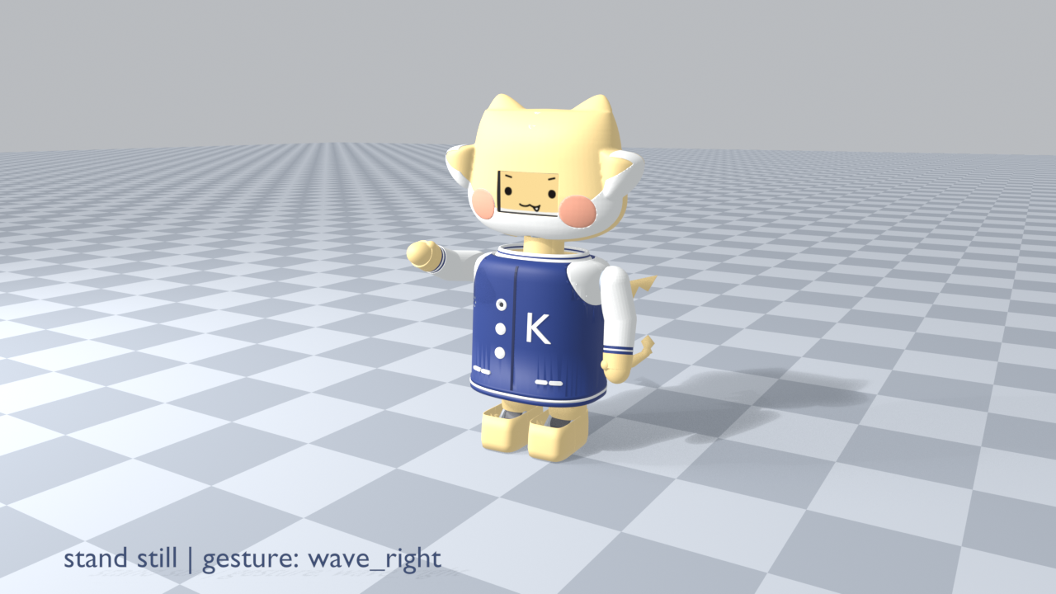
lcd_face/media/stills/v3_ft61931520_gesture_demo_f0525.png
