mgm136044/kobi-robot/lcd_face/media/stills/v3_ft61931520_walk_demo_f0250.png

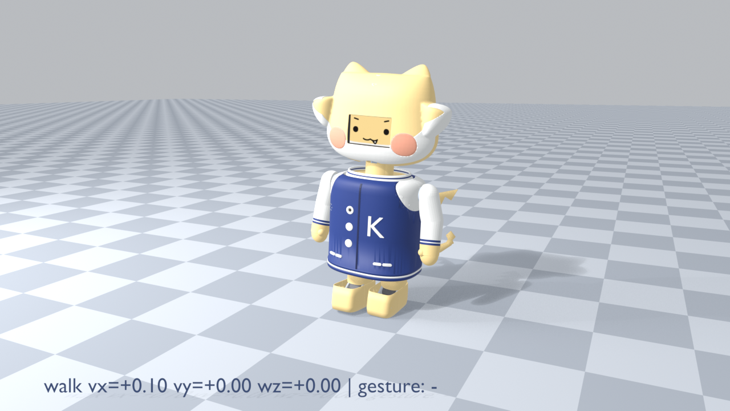
lcd_face/media/stills/v3_ft61931520_walk_demo_f0250.png
