mgm136044/kobi-robot/media/stills/kobi_v2_gesture_demo_f0525.png

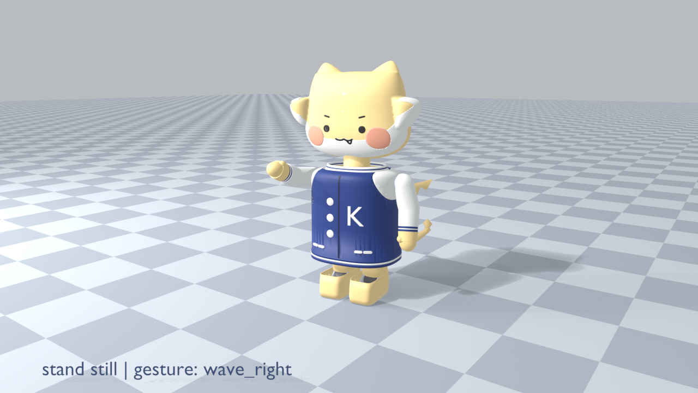
media/stills/kobi_v2_gesture_demo_f0525.png
