mgm136044/kobi-robot/media/stills/kobi_v2_gesture_demo_f1220.png

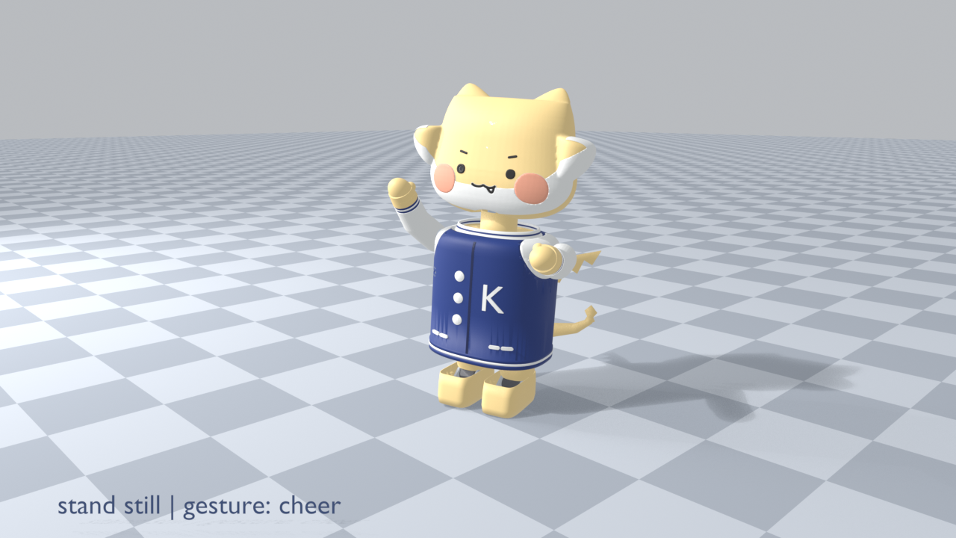
media/stills/kobi_v2_gesture_demo_f1220.png
