mgm136044/kobi-robot/media/stills/kobi_v2_walk_demo_f0250.png

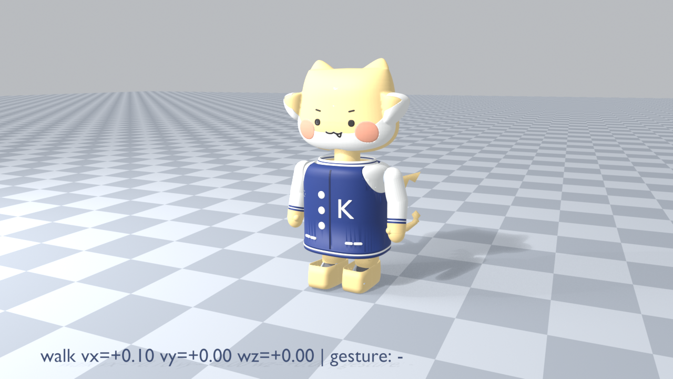
media/stills/kobi_v2_walk_demo_f0250.png
