mgm136044/kobi-robot/lcd_face/bom/코비_BOM_오픈덕미니v2_LCD_v11_20261104.md

# 코비 BOM LCD 얼굴 판 v11 (주문용, 모델 6판, Pi 4를 머리에, 설명서 검증 반영, HDMI 화면, 여분 늘림, Open Duck Mini v2 뼈대 + 코리 외피, 국내 판매처 전용)

- 작성: 민경민 (하드웨어 담당)
- 기준: 2026-11-02에 판매 페이지에서 직접 확인한 가격. 화면 전원선(28AWG), HDMI 화면, Pi 4 3GB, 짧은 HDMI 선, 카메라 리본, 7핀 분리 커넥터, 팬은 2026-11-03, Pi Zero 2개, 2핀 커넥터, 마커, 마이크 고리 재료는 2026-11-04 판매 페이지의 값이다. 이 판에는 구입처나 가격을 정하지 않은 행이 없다. 단가는 부가세 포함(엘레파츠·디바이스마트 별도가는 1.1을 곱함, 네이버 표시가는 그대로)
- 모델: 이 판은 `코비_3D/lcd_variant_v6/`(LCD 6판 모델)를 바탕으로 한다. 6판은 5판을 독립 검증해 나온 문제(카메라 기둥 위치, 껍데기를 여는 순서, 마이크 방향, 빠진 머리 안 배선)를 고치고 통풍구를 낸 판이다. 부품표 v7은 모델을 바꾸지 않고, 6판 독립 검증에서 나온 마이크 선 분리 커넥터와 조립 주의를 더한 판이다. 부품표 v8은 조립 설명서 독립 검증에서 나온 커넥터 바꿔 꽂힘 위험과 빠진 부품(Pi Zero 핀 헤더, M2.5 너트, 머리 가지 퓨즈)을 고친 판이다. 부품표 v9는 주문하는 날(2026-11-04)의 판으로, 구입처를 정하지 못한 행을 모두 정하고 Pi Zero를 오늘 살 수 있는 곳으로 바꿨다. 부품표 v10은 같은 날 사용자 결정으로 공유기, Xbox 컨트롤러, 레깅스 원단을 사지 않기로 한 판이다(세 행은 선택 품목으로 남김). 부품표 v11은 같은 날 여분 Pi Zero도 오늘 사고 남는 예산으로 서보 2개를 더한 판이다. 머리를 가볍게 하는 모델 7판(껍데기 0.9mm)은 출력물만 바꾸므로 사는 부품에는 영향이 없다. LCD 3판은 1m HDMI 선이 목과 몸통을 지났고, 4판(꺾인 플러그로 고친 모델, 부품표는 만들지 않음)에서도 엉덩이 쪽 간섭과 비틀림이 풀리지 않았다. 그래서 사용자 결정으로 Pi 4를 머리 안으로 옮겼다. 화면과 Pi 4는 머리 안의 30cm 선으로 잇고, 카메라·마이크·앰프·5V 모듈도 머리에 있으며, 목에는 가는 전선 7가닥 묶음만 지난다. 출력물끼리 나사 없이 자석·다월·핀·스냅핏으로 잇는 규칙은 그대로다(설계 문서 4-9). LCD 10판 부품표 `코비_BOM_오픈덕미니v2_LCD_v10_20261104.md`와 `.csv`, LCD 9판·8판·7판·6판·5판·3판·2판·1판 부품표, 인쇄 얼굴 판 BOM `코비_BOM_오픈덕미니v2_20261102.md`는 그대로 있다.
- 범위: 로봇 1대. 예산이 약 2,280,000원(배송비 포함)이라 이 판은 망가질 수 있는 부품의 여분을 넉넉히 넣었다. 각 행의 '그중 여분' 칸이 로봇에 들어가지 않고 남는 수량이다. 시나리오 1-2(코비 2대 경주)는 로봇이 2대 있어야 해서 이 수량으로는 할 수 없다. 2대 기준 판은 `2대기준_20261102/`에 있다. 학교 예산은 국내 구매만 가능해서 엘레파츠, 디바이스마트와 국내 판매자만 넣었다. 구매 대행과 해외 직구 상품은 넣지 않았고, 환율이나 해외 가격은 어느 합계에도 쓰지 않았다.
- 수량과 금액에서 "가정", "예상"으로 표시한 값은 실측 후 고친다.

## 요약

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

묶음별 부품 금액과 그중 여분 금액은 다음과 같다.

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

## 구매 전에 볼 위험

### 재고와 납기

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

### 사양

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

### 증빙

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

### 머리에 Pi 4를 넣은 판(LCD 5·6판)에서 생긴 위험

17. **머리가 걷기 정책이 학습한 범위보다 무겁다.** 6판 모델에서 머리 쪽은 686.2g, 로봇 전체는 3,012.1g이다. 5판 673.6g에 머리 안 선과 커넥터 약 13g이 더해졌다(LCD 3판 모델은 561.8g). 새로 이어 학습한 걷기 정책은 머리 무게를 약 454~642g 사이로 흔들며 배웠는데, 6판 머리는 그 위를 44.2g 넘는다. 시뮬레이션에서 센 밀기 192번 가운데 넘어진 횟수는 6판 장면 105번, 5판 장면 108번, LCD 3판 장면 103번이었고, 걷기 따라가기 66번과 몸짓 88번은 세 장면 모두 한 번도 넘어지지 않았다. 범위를 약 720g까지 넓혀 다시 학습할지, 머리를 44.2g 넘게 줄일지는 사용자가 정한다. 부품을 받으면 저울로 재서 모델을 고친다.
18. **머리 안이 더울 수 있다.** 6판 머리에는 뒤쪽 위 2 x 12mm 구멍 6개와 턱 밑 흡입구 2개(열린 면적 192mm²)를 냈다. 반쪽 이음, 자석 탭, 다월, 흰 얼굴 무늬, 카메라와 마이크는 건드리지 않았고 껍데기는 0.29g 가벼워졌다. Pi 4 둘레의 빈 공기는 337.1cm³(88.7%)이고, 머리 안 발열을 5~8W로 잡으면 닫힌 머리 안 공기가 주변보다 약 12~20K 높아진다는 대략 계산(5판 검증)이 있다. 구멍이 작아 이 통풍구로 몇 도 내려가는지는 모른다. 조립 뒤 머리를 닫고 부하를 걸어 Pi 4 온도와 속도 제한 여부를 재고, 뜨거우면 선택 품목인 30mm 팬을 단다.
19. **머리 안 5V 3A 모듈 하나가 Pi 4, 화면, 앰프를 함께 먹인다.** Pi 4는 최대 약 3A, 화면은 제조사 표기 235mA, 앰프는 소리가 클 때 최대 약 0.6A를 쓸 수 있어 순간 합이 3A를 넘을 수 있다. 전압이 떨어지면 여분 5V 모듈 하나를 앰프 전용으로 돌리거나 5A 모듈로 바꾼다. 배터리 사용 시간도 그만큼 줄어든다.
20. **짧은 HDMI 선은 모델로는 들어가지만 실물 확인이 남았다.** 5판 모델은 20cm 선을 가정했지만, 국내에서는 15·20cm 수-수 선도, 위로 꺾인 수-수 선도 찾지 못해 Coms BS359 30cm(마이크로 쪽 아래로 꺾임)를 넣었다. 6판 모델은 이 선을 경로 231.3mm와 플러그 안쪽 64.2mm로 놓아 4.5mm가 남고, 가장 짧은 경로보다 긴 약 106mm는 머리 안 오른쪽 위에 고리로 말았다(최소 휨 반지름 20.1mm, 껍데기 이마 안쪽과 1.67mm). 오른쪽 껍데기 반쪽을 끼우고 뺄 때 선과 걸리지 않는다. 실물로 확인할 것은 셋이다. '아래로 꺾임'이 Pi 4에 꽂았을 때 선이 기판에서 멀어지는 쪽인지(반대면 선이 기판 쪽으로 눌린다), 양끝이 수 플러그인지(사진으로만 봤다), 플러그 크기와 안쪽 길이(가정값)다. 방향이 맞지 않으면 대신 쓸 국내 제품을 아직 찾지 못했다. 6판 검증에서 이 고리를 묶어 둘 자리가 모델에 없다는 점도 나왔다. 선 길이가 ±10mm 다르면 고리 반지름이 약 2mm 변하므로, 받침 쪽 한 곳에 케이블 타이로 가볍게 묶는다(자리는 실물로 정한다).
21. **카메라 리본의 종류(A형·B형)를 아직 모른다.** 리본은 카메라 보드 뒤 단자에서 한 번 굽고 한 번 접혀 Pi 4 카메라 단자에 위에서 꽂힌다(6판 필요 길이 136.0mm, 150mm에서 14.0mm 남음). 양끝 접점이 같은 면(A형)이어야 하는지 반대 면(B형)이어야 하는지는 카메라 모듈 3 단자의 접점 면을 봐야 정해진다(공식 도면에도 접점 방향이 없다). 그래서 둘 다 5개 묶음으로 산다. 해외 재고 상품이라 평균 발송 9영업일이고 결제 뒤 취소가 안 되므로 서보와 함께 먼저 주문한다.
22. **목을 지나는 선 묶음은 계산만 했다.** 7가닥(7.4V 두 가닥은 22AWG, UART 세 가닥과 스피커 두 가닥은 28AWG)을 모델은 지름 3.6mm 묶음으로 넣었고, 목 안내물 고리 구멍은 4.8mm다. 가장 작은 굽힘 반지름은 머리 안 호에서 10.0mm, 머리와 목 사이 자유 고리에서 35.7mm다. 6판에서는 머리 안 납땜 구간 25mm가 더해져 모델 경로가 336.3mm가 됐고, 머리를 좌우 30도씩 돌릴 때 비틀림은 이 경로에 퍼진다고 보면 1m당 119.1도다. 가는 실리콘 전선의 한계로 둔 1m당 360도는 잰 값이 아니라 가정이다. 몸통에서 가장 가까운 움직이는 부품(어깨 커플러)과는 29.2mm 떨어진다(5판 측정, 몸통 구간은 그대로). 실제 묶음 굵기, 고리에 눌러 넣을 수 있는지, 반복 비틀림 수명은 실물로 시험한다. 28AWG 롤은 주문 상품이라 결제 뒤 취소가 안 된다.
23. **7핀 분리 커넥터는 호환품이다.** 6판 모델은 JST SM 7핀 공식 도면 크기(짝 맞춘 상태 19.7 x 20.5 x 7.5mm)로 짝을 받침 앞 오른쪽(로봇 기준, -x) 칸에 세웠고, 목 쪽 플러그를 -x로 당기면 걸림 없이 빠진다. 다만 플러그를 잡으러 들어가는 자리는 고정 부품과 0.45mm로 좁다(모델의 지름 15mm 막대 기준). 사는 것은 NW3 호환품이라 크기와 정격(JST 원본은 접점당 3A)을 받아서 확인한다. 목 쪽 22AWG 꼬리는 머리 안에서 짧게 잘라 목 묶음 전선에 납땜하고 열수축 튜브로 싼다(7가닥을 그대로 목에 보내면 묶음이 고리 구멍보다 굵어질 수 있다). 머리 전체 전력이 7.4V 한 쌍으로 지나는데, Pi 4·화면·앰프가 모두 최대일 때 5V 쪽 약 3.8A(19W)를 효율 90%, 방전 말기 6V로 나누면 약 3.5A가 되어 접점 정격을 넘을 수 있다(계산값, 평소에는 이보다 훨씬 작다). 처음 켤 때 커넥터 온도를 확인한다. 모델에는 플러그의 잠금 팔(약 3mm)과 리셉터클의 잠금 돌기(약 2mm)가 없다. 반대쪽 면이 칸 바닥에 닿으므로 잠금 팔이 위(+z)를 보게 놓는다.
24. **머리 안 Wi-Fi 세기를 모른다.** PLA 머리는 금속이 아니지만 Pi 4 가까이에 5V 모듈과 전선이 있다. 조립 뒤 머리를 닫고 공유기와의 신호 세기와 영상 전송이 끊기지 않는지 본다.
25. **카메라와 마이크는 시험 조각으로 먼저 맞춰 본다.** 5판 독립 검증에서 카메라 기둥이 공식 도면과 7.3mm 어긋난 것이 나와 6판에서 도면 위치로 고쳤다. 카메라 모듈 3 Wide는 시야 반각 60도가 필요하고, 모델은 렌즈 앞 소자 가장자리 기준으로 기준 깊이 66도, 0.5mm 더 깊으면 62도다. 렌즈 통 전체 가장자리로 재면 0.5mm 깊을 때 53도라, 렌즈를 깊게 앉히는 오차는 0.5mm 안으로 지켜야 한다. 렌즈 통은 껍데기 구멍에 3.0mm 걸리고 둘레 틈은 0.20mm다. 마이크는 바닥 구멍형이라 6판에서 기판을 뒤집었는데, 실제 모듈의 구멍 위치와 패드 자리는 모른다. 그래서 머리 전체를 뽑기 전에 기둥·갈고리·구멍만 있는 시험 조각 2개(카메라 4.12g, 마이크 2.76g)를 먼저 뽑아 실제 보드를 끼워 본다. 6판 검증에서 두 가지가 더 나왔다. 갈고리가 보드를 0.2mm만 걸어 잡아 출력 오차와 비슷하므로, 시험 조각에서 헐거우면 순간접착제나 테이프로 보탠다. 또 카메라 보드의 25mm 폭이 세로로 서 있어 영상이 세로로 찍힌다(가로 67도, 세로 102도, 3판부터 같음). 키 작은 로봇이 가까운 사람 얼굴을 담기에는 세로 시야가 유리하다는 Codex 의견에 따라 그대로 두고 소프트웨어에서 90도 돌린다. 가로 시야가 꼭 필요하면 보드를 돌린 새 모델이 필요하다.
26. **머리 받침 자석 4쌍이 Pi 4를 붙잡는지 모른다.** Pi 4와 열판은 약 50g이고, 머리가 빨리 끄덕이거나 넘어질 때 지름 5mm 자석 4쌍과 다월 2개가 받침째 이것을 붙잡아야 한다. 모델 검사는 당기는 힘을 보지 못하므로, 받침을 끼운 머리 틀을 손으로 흔들어 먼저 시험한다.
27. **화면 해상도와 얼굴 크기.** 화면이 저절로 800x480으로 켜지는지 모른다. 제조사 설명서의 config.txt 설정(hdmi_cvt 등)은 지금 Raspberry Pi OS(Bookworm)의 기본 화면 방식에서는 듣지 않는다. 화면이 해상도 정보를 스스로 알려 주면 그대로 켜지고, 아니면 부팅 설정(cmdline.txt의 video= 항목)으로 해상도를 정해 줘야 하니 조립 전에 책상에서 먼저 켜 본다. 눈·눈썹·입은 원화의 82% 크기로 그리며(LCD 2·3판과 같음), 켜지는 영역 108 x 64.8mm 안에 좌우 7.46mm, 위 5.06mm, 아래 2.86mm 여유가 남는다.
28. **머리 껍데기는 정해진 순서로만 열고 닫을 수 있다.** 카메라와 마이크가 오른쪽 껍데기 반쪽에 붙어 있어서, 리본이나 마이크 선을 Pi 4에 꽂은 채로는 오른쪽 반쪽이 리본 91mm, 마이크 선 43~52mm(6판 README 52mm, 6판 검증 43mm)까지만 움직인다(빼는 데는 122mm가 필요). 그래서 오른쪽 반쪽을 먼저 끝까지 끼운 뒤 열린 왼쪽으로 손을 넣어 리본과 마이크 선을 꽂고, 마지막에 왼쪽 반쪽을 끼운다. 분해는 왼쪽 반쪽부터 거꾸로 한다. 모델에서는 지름 15mm 막대가 카메라 단자 래치(틈 9.1mm)와 GPIO(6.4mm)에 닿았지만, 실제 손가락이나 핀셋으로 래치를 들 수 있는지는 해 봐야 안다. 6판 검증에서 더 나온 것이 있다. 마이크와 앰프가 핀 12·35를 함께 써서 두 선을 한 단자에 이으면 오른쪽 반쪽이 앰프에 묶이므로, 마이크 선 중간에 분리 커넥터(E 묶음의 SM 6핀 행)를 넣고 반쪽을 빼기 전에 먼저 뽑는다. 목 7핀과 바꿔 꽂히지 않도록 반쪽 방향을 정했고(그 행의 비고), 처음 켜기 전에 목 7.4V 선과 Pi 신호 핀 사이가 끊겨 있는지 잰다. 손가락은 HDMI 선을 넘어 65~72mm 깊이까지 들어가야 하고, 반쪽 아래쪽 GPIO 핀(2~17번)은 위에서 30~33mm 내려가야 닿는다. 리본의 45도 접힘은 머리 안에서 접기 어려워 작업대에서 미리 접는다. microSD 카드를 바꾸려면 양쪽 반쪽을 떼야 한다. 6판 모델 README는 Pi 4를 받침에서 들어 올려야 한다고 했지만, 6판 검증은 카드 자리 바깥을 막는 부품이 없어 들지 않고 뺄 가능성이 크다고 봤다(슬롯 위치는 실물로 확인). 여분 카드(위 microSD 행)는 미리 구워 둔다.

### 여분을 늘린 판에서 볼 것

29. **예산에서 남는 금액은 20,910원이다.** 가격은 2026-11-02~04 값이고 배송비 일부(아이씨뱅큐 등)는 가정값이다. 11판은 남는 돈 대부분으로 서보 2개를 더 샀고, 남은 금액은 아이씨뱅큐 배송비(가정)와 가격 변동을 받아 낼 몫이다. 주문 직전에 가격이 올라 예산을 넘으면 여분을 줄인다. 줄이는 순서는 Pi 4 여분(디바이스마트에서 1~2일이면 다시 살 수 있음, 151,800원), 서보 여분 2개(81,400원), 카메라 여분(56,100원)이다.
30. **서보는 한 번에 같은 상품으로 산다.** 같은 STS3215라도 전압과 기어비가 다른 판(C001, C044, C046 등)이 팔린다. 여분도 처음 주문에 같은 상품(ST-3215-C001, 7.4V)으로 함께 사야 다리마다 성질이 같다. 받으면 라벨을 확인한다.
31. **여분도 받자마자 한 번씩 켜 본다.** 여분을 상자에 둔 채로 두면 불량을 고장 난 뒤에야 안다. 서보는 ID를 미리 써 두고, microSD는 같은 이미지를 구워 두고, 보드와 화면은 한 번씩 켜 본다.

### 조립 설명서 검증에서 생긴 위험

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

### 9판 뒤 사용자 결정으로 생긴 위험

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

## 1. 자료 출처

- 제작자 원본 부품표(구글 시트, 합계 398.1유로): https://docs.google.com/spreadsheets/d/1gq4iWWHEJVgAA_eemkTEsshXqrYlFxXAPwO515KpCJc
- HDMI 화면: Waveshare 5inch HDMI LCD 자료 https://www.waveshare.com/wiki/5inch_HDMI_LCD (치수 도면, STEP 모델, 전류 235mA), 디바이스마트 판매 페이지 https://www.devicemart.co.kr/goods/view?no=16122791
- 짧은 HDMI 선: 엘레파츠 Coms BS359 판매 페이지 https://www.eleparts.co.kr/goods/view?no=6712688 (30cm, 마이크로 쪽 아래로 꺾임, 외경 표기 없음). 15·20cm와 위로 꺾인 수-수 선을 찾지 못한 것은 2026-11-03 엘레파츠·디바이스마트 조사 결과다(15·20cm 제품은 모두 HDMI 암 - 마이크로 수 젠더형).
- 카메라 리본: 엘레파츠 GUOCONN 15핀 1.0mm 150mm A형 https://www.eleparts.co.kr/goods/view?no=18512164 , B형 https://www.eleparts.co.kr/goods/view?no=18579625 (최소 주문 5개, 해외 재고).
- 7핀 분리 커넥터: 디바이스마트 NW3 SM 7핀 https://www.devicemart.co.kr/goods/view?no=1342794 , 정격 참고는 JST SM 자료 https://www.jst-mfg.com/product/pdf/eng/eSM.pdf (접점당 3A, 28~22AWG).
- Pi 4 3GB: 디바이스마트 https://www.devicemart.co.kr/goods/view?no=16063616 (방열판 포함 표기). 2GB 재고는 2026-11-03 엘레파츠·디바이스마트·메카솔루션·아이씨뱅큐 페이지로 확인했다.
- 공식 문서: Raspberry Pi 4 기계 도면 https://datasheets.raspberrypi.com/rpi4/raspberry-pi-4-mechanical-drawing.pdf , Camera Module 3 제품 요약서 https://datasheets.raspberrypi.com/camera/camera-module-3-product-brief.pdf
- 화면 전원선 판매 페이지: 엘레파츠 [SME] 실리콘 전선 AWG28 30m https://www.eleparts.co.kr/goods/view?no=16742931 (28AWG, 외경 0.83mm, 주문 상품)
- LCD 6판 모델: `코비_3D/lcd_variant_v6/`(README.md, report.json, print/parts_table.json, print/test_coupons/). 머리 안 배치와 틈, 짧은 HDMI 선과 리본 경로, 머리 안 배선, 목 묶음, 카메라 시야, 통풍구, 질량은 이 폴더의 모델 계산값이다. 5판 독립 검증은 `코비_3D/lcd_variant_v5/verification_v1/REPORT.md`, 6판 독립 검증은 `코비_3D/lcd_variant_v6/verification_v1/REPORT.md`이고, 카메라 방향과 마이크 선 분리 방법은 Codex 상담(2026-11-03)에서 정했다. 조립 설명서 독립 검증은 `코비_조립설명서/verification_v1/findings.json`이고, 서보 보드 입력 전압은 Waveshare 위키 https://www.waveshare.com/wiki/Bus_Servo_Adapter_(A) 다. 핀 헤더·너트·퓨즈·SM 6핀·직류 스위치는 2026-11-03~04 판매 페이지 조사 값이다. 센 밀기 넘어짐 횟수는 `코비_학습/runs/kobi_lcd_ft/eval/`의 6판·5판·3판 장면 평가 결과다.
- 여분 수량의 2차 의견: Codex(외부 모델) 상담, 2026-11-03. 고장률을 잰 자료가 아니라 판단이다.
- 9판 구입처: 2026-11-04 01:25~02:05 판매 페이지 조사(디바이스마트 no=1342790, 35192, 13004344, 15548740, 아이씨뱅큐 P016555267). 서보 보드 회로도 https://files.waveshare.com/wiki/Bus-Servo-Adapter-(A)/Bus%20Servo%20Adapter%20(A)-Sch.pdf , 문서 https://docs.waveshare.com/Bus_Servo_Adapter_A 와 FAQ, 서보 데이터시트 https://core-electronics.com.au/attachments/uploads/sts3215-smart-servo-datasheet-translated.pdf , 원본 저장소 이슈 https://github.com/apirrone/Open_Duck_Mini/issues/51
- Tnkr 조립 가이드: https://tnkr.ai/open-duck-mini/open-duck-mini-v2
- 하드웨어 저장소: https://github.com/apirrone/Open_Duck_Mini , 런타임 저장소: https://github.com/apirrone/Open_Duck_Mini_Runtime
- Growbotics 부품표는 구매처 칸이 비어 있고 베어링을 688ZZ로 적어(원본 링크 상품은 6804ZZ) 참고만 했다.
- 출력 부품 질량: `코비_BOM/scripts/lcd_v6_data/parts_table_lcd_v6.json`(LCD 6판 모델 빌드의 부품표 `print/parts_table_full.json`을 복사한 것. 모델 계산값이고 실물 저울 측정이 아님. PLA 밀도 1.24g/cm³, 벽 안쪽 채움 없음 기준). 출력 대상 63개, 합계 1,310.6g이다. 이 표에는 반쪽 파일(머리 껍데기, 흰 얼굴, 테두리의 L/R 반쪽)이 없고 부품마다 한 번만 있다. 이 가운데 머리 셸과 얼굴 부품 5개가 346.2g이고, 나머지 외피·기구 58개가 964.4g이다(부품마다 0.1g으로 반올림한 값을 더했다).
- 접합 부품 수와 자석 자리: `코비_3D/scripts`의 각 접합 코드(build_face_mount.py, build_mech.py, joint_jacket.py, joint_feet.py)와 같은 실행 기록의 RETENTIONREPORT·MECHRETENTION 줄. 화면 설치대 못(LCD_mount_pin)은 `코비_3D/lcd_variant_v3/scripts/build_lcd.py`, 머리 안 Pi 4 받침의 자석과 다월은 `코비_3D/lcd_variant_v6/scripts/head_params.py`(5판과 같은 값)다.

## 2. 부품표

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

### A. 서보·서보 제어

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

### B. 보드·센서

| 번호 | 품목 | 수량(1대 기준) | 그중 여분 | 판매처 | 단가(부가세 포함, 원) | 금액(원) | 납기 | 링크 | 비고 |
|---:|---|---:|---:|---|---:|---:|---|---|---|
| 4 | **[오늘 주문]** Raspberry Pi Zero 2 W 핀 헤더 납땜판, 상품명 SparkFun Zero 2 W with Headers (걷기·서보·IMU·발 스위치·ToF 담당) | 2 | 1 | 아이씨뱅큐 | 50,600 | 101,200 | 배송 1주 이내(국내 재고 표시, 2026-11-04) | [링크](https://www.icbanq.com/P016555267) | 로봇당 1개 + 여분 1개(11판에서 여분도 오늘 함께 사기로 함, 사용자 결정 2026-11-04). 걷기를 맡는 보드라 타면 로봇이 서지 못한다. 국내 다른 판매처가 모두 품절이라(위험 1) 오늘 살 수 있는 이 상품을 골랐다(사용자 결정 2026-11-04). 핀 헤더가 납땜되어 있어 납땜하지 않는다. 5V는 몸통 5V 모듈에서 핀 2로, 접지는 핀 6으로 넣는다(Codex 권고). 46,000원(부가세 별도)에 1.1을 곱한 값. 남은 수량 숫자와 배송비는 페이지에서 확인하지 못해, 2개가 한 번에 되는지 결제할 때 본다. 1개만 되면 여분은 아래 디바이스마트 2WH(선택 품목)로 산다 |
| 5 | Raspberry Pi Zero 2 WH 핀 헤더 포함 (선택, 아이씨뱅큐에서 2개를 못 살 때의 여분) | 1 | 0 | 디바이스마트 | 29,700 | (29,700) 선택, 합계 제외 | 일시 품절, 2026-11-13 입고 예정 | [링크](https://www.devicemart.co.kr/goods/view?no=15548740) | 선택 품목, 합계에서 뺌. 11판에서 여분도 아이씨뱅큐에서 오늘 사기로 해(사용자 결정 2026-11-04) 쓰지 않는다. 아이씨뱅큐에서 1개만 살 수 있으면 입고 뒤 이것을 여분으로 산다. 따로 주문하면 66,000원 미만이라 배송비가 붙는다 |
| 6 | 핀 헤더 2x20 2.54mm 곧은형 (선택, 헤더 없는 Zero 2 W를 살 때만) | 10 | 0 | 디바이스마트 | 242 | (2,420) 선택, 합계 제외 | 평균 준비 3~4일 | [링크](https://www.devicemart.co.kr/goods/view?no=1360971) | 선택 품목, 합계에서 뺌. 9판부터 두 Pi Zero가 모두 핀 헤더가 납땜된 판이라 필요 없다. 헤더 없는 Zero 2 W(디바이스마트 27,500원)를 사게 될 때만 함께 산다(최소 주문 10개). 페이지에 Raspberry Pi Zero W용으로 적혀 있고 Zero 2 W는 같은 40핀 자리다(추정). 220원(부가세 별도)에 1.1을 곱한 값 |
| 7 | Raspberry Pi 4 Model B 3GB (머리 안, 카메라·마이크·스피커·Wi-Fi·얼굴 화면 담당) | 2 | 1 | 디바이스마트 | 151,800 | 303,600 | 평균 준비 1~2일 | [링크](https://www.devicemart.co.kr/goods/view?no=16063616) | 로봇당 1개 + 여분 1개. 5·6판에서 머리 틀 위의 출력 받침(Pi4_head_bracket)에 M2.5 나사 4개로 앉는다. 2GB 판은 국내 어디서도 확실한 재고가 없어(2026-11-03: 엘레파츠 no=9003502 품절, 디바이스마트 no=12234533 재고 확보 중, 메카솔루션 품절, 아이씨뱅큐 한정 수량) 3GB 판으로 바꿨다. 메모리만 크고 단자와 크기는 같다. 행사 당일 이 보드가 타면 얼굴·카메라·음성이 모두 멈추고, 머리 안 강압 모듈과 바로 이어져 배선 실수 한 번에 탈 수 있어 여분을 넣었다. 디바이스마트 페이지 표기로 방열판 포함 |
| 8 | microSD 32GB SanDisk Ultra | 4 | 2 | USB하우스(네이버) | 15,200 | 60,800 | 11/4 도착 확률 96% | [링크](https://smartstore.naver.com/usb-house/products/13393298543) | 보드 2개에 1개씩 + 여분 2개. 배터리가 갑자기 끊기면 카드 내용이 깨질 수 있어, 미리 구워 둔 여분 카드로 바로 바꾼다. 네이버 표시가를 그대로 씀. 정품 여부는 사진으로 확인 불가 |
| 9 | BNO055 9축 IMU 모듈 GY-BNO055 | 3 | 2 | 원메이커스(네이버) | 12,700 | 38,100 | 오늘 출발 | [링크](https://smartstore.naver.com/wonmaker/products/13665262549) | 로봇당 1개 + 여분 2개. 몸통 안에 있어 넘어질 때 직접 부딪히지는 않지만, 복제 모듈일 수 있어 받자마자 불량인 것이 섞일 수 있다. 배송비 3,000원 별도. 정품급 대안은 엘레파츠 온시스텍 73,700원(대안 표) |
| 10 | 마이크로 스위치 오므론 SS-5 (핀 플런저, 발 접지 감지) | 8 | 4 | 부품하우스(네이버) | 1,200 | 9,600 | 11/4 도착 확률 94% | [링크](https://smartstore.naver.com/parts_house/products/11990799594) | 로봇당 4개 + 여분 4개. 걸음마다 눌리고 넘어질 때 발에서 충격을 받는다. 레버 없는 핀형이라 발 부품 모양에 맞는지 확인. 레버형 SS-5GL2는 1,400원 |
| 11 | ToF 거리 센서 VL53L1X (CJMCU-531) | 2 | 1 | 엘레파츠 | 19,580 | 39,160 | 24시간 이내 발송 | [링크](https://www.eleparts.co.kr/goods/view?no=9644476) | 로봇당 1개 + 여분 1개. 근접 안전 정지용. 없어도 걷기와 표정은 되지만, 싼 호환 모듈이라 받자마자 불량인 경우에 대비했다 |
| 12 | 쿨링 팬 5V 30x30x7mm SZH-AT002 (선택, 머리 안 Pi 4) | 1 | 0 | 디바이스마트 | 2,310 | (2,310) 선택, 합계 제외 | 평균 준비 4~5일 | [링크](https://www.devicemart.co.kr/goods/view?no=1361327) | 6판 머리에는 뒤쪽 위 2 x 12mm 구멍 6개와 턱 밑 흡입구 2개(열린 면적 192mm²)가 생겼지만 실제로 몇 도 내려가는지는 모른다. Pi 4 둘레 빈 공기는 337.1cm³다. 먼저 머리를 닫고 부하를 걸어 온도를 재고, 뜨거울 때만 단다(위험 18). 그래서 합계에서 뺐다. 5V 0.20A, 2선과 2핀 하우징(상품 사진 라벨 기준) |

### C. 전원

| 번호 | 품목 | 수량(1대 기준) | 그중 여분 | 판매처 | 단가(부가세 포함, 원) | 금액(원) | 납기 | 링크 | 비고 |
|---:|---|---:|---:|---|---:|---:|---|---|---|
| 13 | 18650 셀 삼성SDI 30Q 3000mAh (보호회로 내장) | 6 | 4 | 메가캐논 신아씨엔씨(네이버) | 7,700 | 46,200 | 11/4 도착 확률 95% | [링크](https://smartstore.naver.com/sacnc/products/652769727) | 로봇당 2개 + 여분 4개(옛 판과 같음). 두 쌍을 번갈아 충전해 쓰고 한 쌍이 남는다. 보호회로 때문에 셀이 조금 길어 홀더에 들어가는지 확인 필요. 옵션 2종(플랫/돌출)은 추가금 없음. 4개 이상 200원 할인 문구는 장바구니에서 확인 못 해 반영하지 않음 |
| 14 | 18650 2직렬 홀더 (스위치·전선 포함) | 2 | 1 | 디바이스마트 | 1,210 | 2,420 | 평균 준비 1~2일 | [링크](https://www.devicemart.co.kr/goods/view?no=14497608) | 로봇당 1개 + 여분 1개 |
| 15 | 2S 보호회로 8A (40x16mm) | 2 | 1 | 디바이스마트 | 1,320 | 2,640 | 평균 준비 3~4일 | [링크](https://www.devicemart.co.kr/goods/view?no=15743420) | 로봇당 1개 + 여분 1개. 납땜 중 과열이나 단락으로 망가지기 쉽다 |
| 16 | 5V 3A 강압 모듈 네오틱스 NP-DCDC-5V3A (입력 5~28V) | 6 | 3 | 엘레파츠 | 5,500 | 33,000 | 약 3일 | [링크](https://www.eleparts.co.kr/goods/view?no=17775271) | 로봇당 3개(머리 안 Pi 4·화면·앰프용, 몸통 Zero용, 팔 서보용) + 여분 3개. 5·6판에서 첫 번째 모듈은 머리 받침 오른쪽 칸에 앉고, 목을 지나는 7.4V 두 가닥을 받아 Pi 4(GPIO 핀 2·6), 화면(micro USB), 앰프를 먹인다. 셋의 순간 전류가 3A를 넘을 수 있어 모자라면 여분 하나를 앰프 전용으로 돌린다(위험 19). 입력 7V부터인 SZH-PWSD-016은 방전 말기(약 6V)에 부적합해 쓰지 않음. 5V 고정이라 Pi 4 권장 5.1V에는 못 미치므로 전압 강하 측정 필요 |
| 17 | 소형 토글 스위치 SPDT 3A (전원) | 2 | 1 | 디바이스마트 | 1,243 | 2,486 | 약 1일 | [링크](https://www.devicemart.co.kr/goods/view?no=10983) | 로봇당 1개 + 여분 1개. 정격은 교류 125V 3A 기준이고 직류 정격이 없어 서보 전류를 끊기에는 약하다(위험 33). 배선을 만지거나 커넥터를 꽂을 때는 이 스위치가 아니라 XT30을 뽑아 전원을 끊는다 |
| 18 | 직류 정격 전원 스위치 VCC VRS-1 (DC 14V 20A, 락커, 선택) | 1 | 0 | 엘레파츠 | 2,700 | (2,700) 선택, 합계 제외 | 평균 발송 4.5일(24시간 이내 발송 표시도 있음) | [링크](https://www.eleparts.co.kr/goods/view?no=17737895) | 선택 품목, 합계에서 뺌. 위 토글 스위치를 직류 정격이 확인된 것으로 바꾸고 싶을 때의 후보다(페이지 표기 DC 14V 20A, AC 125V 16A). 둥근 손잡이 지름이 약 20mm라 재킷 뒤판 서비스 판의 스위치 구멍을 바꿔야 해서 지금 모델에는 넣지 않았다 |
| 19 | USB-C 2S 8.4V 충전 모듈 2A | 2 | 1 | 디바이스마트 | 6,820 | 13,640 | 평균 준비 3~4일 | [링크](https://www.devicemart.co.kr/goods/view?no=15742534) | 로봇당 1개 + 여분 1개. 충전 단자는 꽂고 뽑을 때마다 힘을 받는다 |
| 20 | DC 5.5x2.1 플러그 (선택) | 4 | 0 | 디바이스마트 | 539 | (2,156) 선택, 합계 제외 | 평균 준비 1~2일 | [링크](https://www.devicemart.co.kr/goods/view?no=4581) | 선택 품목, 합계에서 뺌. 9판에서 서보 보드 전원을 극성 반대 보호가 있는 나사 단자로 넣기로 해(위험 32, 조립 설명서) 쓰는 곳이 없다. 원형 DC 잭으로 바꿀 일이 생길 때만 산다. 납땜형인지 페이지에 없음 |
| 21 | XT30 커넥터 암수 한 쌍 | 2 | 1 | 디바이스마트 | 1,100 | 2,200 | 평균 준비 1~2일 | [링크](https://www.devicemart.co.kr/goods/view?no=1153502) | 로봇당 1쌍 + 여분 1쌍 |
| 22 | 인라인 퓨즈 홀더 ATO(표준 블레이드) 방수형 SZH-FU005 (머리로 가는 7.4V 가지) | 2 | 1 | 디바이스마트 | 1,870 | 3,740 | 평균 준비 1주일 | [링크](https://www.devicemart.co.kr/goods/view?no=12170196) | 로봇당 1개 + 여분 1개. 머리로 가는 7.4V 가지를 스위치 뒤 배전점에서 나눌 때 그 시작에 넣는다(Codex 권고). 사진상 양쪽에 빨간 전선이 달린 방수 캡형이며 전선 굵기와 길이는 페이지에 없다. ATO 표준 크기 전용이라 미니 퓨즈는 맞지 않는다. 모델에는 없는 부품이라 몸통 안 자리는 실물로 정한다 |
| 23 | ATO 블레이드 퓨즈 32V 5A (10개) | 10 | 9 | 디바이스마트 | 110 | 1,100 | 평균 준비 1~2일 | [링크](https://www.devicemart.co.kr/goods/view?no=11509) | 로봇당 1개, 최소 주문 10개라 9개가 남는다. 머리 쪽 최대 전류는 계산으로 약 3.5A(위험 23)라 5A를 쓴다. 3A ATO는 디바이스마트에서 찾지 못했다 |
| 24 | 2핀 전선 연결 커넥터 NW3 SM 2핀-2핀 암수 케이블 20cm (전원 스위치·USB-C 선용) | 4 | 2 | 디바이스마트 | 550 | 2,200 | 평균 준비 2~3일 | [링크](https://www.devicemart.co.kr/goods/view?no=1342790) | 로봇당 2벌(전원 스위치 선, USB-C 충전 모듈 선) + 여분 2벌. 재킷 뒤판을 선이 걸리지 않게 완전히 떼려고 쓴다. 이 선들은 뒤판을 뗄 때 끌려가지 않도록 약 150mm의 여유가 있어야 한다. 목 7핀·마이크 6핀과 같은 SM 계열이라 잠금 걸쇠가 있고 압착 공구가 필요 없다. 전선은 AWG22, 옵션은 SM-F/M-20cm 하나다. 한 벌이 암·수 각 1개인지와 20cm가 한쪽 길이인지는 페이지 문구로만 판단해 받아서 확인한다. 정격 전류는 페이지에 없다(JST 원본 SM은 접점당 3A). 두 벌(스위치 선, 충전 선)이 같은 모양이라 서로 바꿔 꽂힐 수 있으니 색 표시를 다르게 하고 꽂기 전에 확인한다. 500원(부가세 별도)에 1.1을 곱한 값 |
| 25 | **[주문 상품]** [SME] 실리콘 전선 AWG28 30m 미니롤 (목 묶음 가는 선 5가닥과 화면 전원선, 적·흑 각 1롤) | 2 | 0 | 엘레파츠 | 14,520 | 29,040 | 평균 발송 2영업일(주문 상품) | [링크](https://www.eleparts.co.kr/goods/view?no=16742931) | 6판에서 쓰는 곳은 세 군데다. (1) 목을 지나는 7가닥 묶음 가운데 UART 3가닥(송신, 수신, 접지)과 스피커 2가닥(+, -)이다. 모델 경로 약 336mm에 몸통 자유 꼬리 약 150mm를 더해 한 가닥 약 0.5m다. (2) 머리 안 I2S 선이다. 마이크 6가닥과 앰프 5가닥을 각각 170mm로 잘라 Pi 4 GPIO의 듀퐁 단자까지 보낸다(모델 v6 README 7절). (3) 머리 안 강압 모듈 5V 출력에서 화면 micro USB 플러그까지 두 가닥, 양끝 포함 약 79mm다. 이 상품은 28AWG, 도체 0.12mm x 7가닥, 외경 0.83mm(페이지 표기)다. 30m 미니롤은 색 하나씩이라 적·흑 2롤이 최소이고, 필요한 길이는 약 4.5m라 크게 남는다(끊어지면 다시 잘라 쓰므로 여분을 따로 사지 않는다). 색이 둘뿐이라 가닥마다 양끝에 번호 표시를 붙여 구분한다. 주문 상품이라 결제 뒤 취소와 단순 변심 반품이 안 된다. 13,200원(부가세 별도)에 1.1을 곱한 값. 같은 엘레파츠 주문에 넣는다 |
| 26 | 18650 2구 충전기 메가캐논 M2-PLUS | 1 | 0 | 디바이스마트 | 17,710 | 17,710 | 평균 준비 2~3일 | [링크](https://www.devicemart.co.kr/goods/view?no=15826853) | 셀을 로봇 밖에서 충전. 1대 운용 기준 1개(망가지는 부품이 아니라 여분 없음) |

### D. 카메라·음성·화면

| 번호 | 품목 | 수량(1대 기준) | 그중 여분 | 판매처 | 단가(부가세 포함, 원) | 금액(원) | 납기 | 링크 | 비고 |
|---:|---|---:|---:|---|---:|---:|---|---|---|
| 27 | 카메라 Raspberry Pi Camera Module 3 Wide | 2 | 1 | 엘레파츠 | 56,100 | 112,200 | 24시간 이내 발송 | [링크](https://www.eleparts.co.kr/goods/view?no=12391455) | 로봇당 1개 + 여분 1개. 리본 단자가 약하고 렌즈가 머리 앞에 있어 앞으로 넘어질 때 충격을 받는다. 5·6판에서 머리 이마 오른쪽(오른쪽 껍데기 반쪽 안, 껍데기 구멍 뒤)에 기둥 4개와 갈고리 2개로 끼운다. 함께 오는 200mm 리본은 머리 안에서 너무 길어 쓰지 않고, 아래 150mm 리본(필요 길이 136.0mm)으로 Pi 4의 카메라 단자에 위에서 꽂는다. 6판에서 보드를 받치는 기둥을 공식 도면 위치로 고쳤고(5판은 7.3mm 어긋났음), 머리를 뽑기 전에 기둥·갈고리·렌즈 구멍만 있는 시험 조각(4.12g)으로 실제 보드가 맞는지 먼저 본다 |
| 28 | LCD Waveshare 5inch HDMI LCD 800x480 (얼굴 화면) | 2 | 1 | 디바이스마트 | 73,150 | 146,300 | 약 1주일 | [링크](https://www.devicemart.co.kr/goods/view?no=16122791) | 로봇당 1개 + 여분 1개. 눈·눈썹·입을 보여 주는 얼굴 화면이고 머리 맨 앞의 유리라서 앞으로 넘어지면 가장 먼저 깨질 수 있다. 표시 영역 108 x 64.8mm, 기판 121.11 x 89.37mm(귀퉁이 귀 포함), 무게 152g(제조사 표기). HDMI 단자가 위쪽 긴 변에 오도록 그대로 달아 화면을 돌릴 필요가 없다. 바로 뒤 머리 안의 Pi 4 micro HDMI 0번 단자와 아래 짧은 HDMI 선으로 잇고, 5V는 화면 뒷면 오른쪽 가장자리의 전원 전용 micro USB 단자로 머리 안 강압 모듈에서 받는다(GPIO 헤더는 설치판이 1.5mm 뒤에 있어 쓰지 않음, 제조사 표기 235mA). 터치는 쓰지 않는다. 기판 네 귀퉁이 구멍(지름 3mm)에 아래 M3 육각 서포트를 세워 설치대에 고정한다. 구성품은 화면, HDMI 연결 부품, 터치펜, 나사 4개이고 서포트는 들어 있지 않다(판매 페이지 상세 설명, 2026-11-03) |
| 29 | **[방향 확인]** HDMI 선 Coms BS359 마이크로 HDMI(아래로 꺾임) - HDMI 30cm (머리 안, 화면과 Pi 4 사이) | 2 | 1 | 엘레파츠 | 4,680 | 9,360 | 평균 발송 3.5일(페이지 표시) | [링크](https://www.eleparts.co.kr/goods/view?no=6712688) | 로봇당 1개 + 여분 1개. 선이 머리 밖으로 나가지 않아 목에서 비틀리지 않는다. 화면 쪽은 곧은 HDMI 플러그, Pi 4 쪽은 꺾인 마이크로 플러그가 필요하다. 곧은 마이크로 플러그는 몸체와 보호관이 앞으로 약 35mm 나와 화면 설치판에 부딪힌다. 국내 엘레파츠·디바이스마트에서 15·20cm 수-수 선과 위로 꺾인 수-수 선을 찾지 못해(2026-11-03 조사) 가장 짧은 이 30cm 선을 넣었다. 6판 모델은 이 선을 경로 231.3mm(플러그 안쪽 64.2mm 별도)로 놓고, 가장 짧은 경로보다 긴 약 106mm를 머리 안 오른쪽 위에 고리로 말았다(최소 휨 반지름 20.1mm, 껍데기와 1.67mm). '아래로 꺾임'이 Pi 4에 꽂았을 때 기판에서 멀어지는 쪽(위)인지와 양끝이 수 플러그인지는 사진으로만 봤으니 주문 전에 판매처에 묻는다(위험 20). 외경과 플러그 크기는 페이지에 없다 |
| 30 | **[취소 불가]** 카메라 리본 15핀 1.0mm 150mm A형(양끝 접점 같은 면) GUOCONN, 5개 묶음 | 5 | 4 | 엘레파츠 | 287 | 1,435 | 평균 발송 9영업일, 해외 재고 | [링크](https://www.eleparts.co.kr/goods/view?no=18512164) | 6판 모델의 필요 길이는 136.0mm라 150mm에서 14.0mm가 남는다. A형과 B형(양끝 접점이 반대 면) 가운데 어느 쪽이 맞는지는 카메라 모듈 3 단자의 접점 면을 봐야 알 수 있어(모델 v6 README 5절, 미확인. 공식 도면에도 접점 방향이 없음) 둘 다 산다. 둘 중 한 개만 로봇에 쓰고, 이 표는 A형 1개를 조립분으로 셌다(B형이면 두 행의 여분이 바뀌며 금액 차이는 3원). 최소 주문과 판매 단위가 5개다. 해외 재고 상품이라 결제 뒤 취소가 안 된다. 낱개 260.91원(부가세 별도)에 1.1을 곱해 반올림한 값 |
| 31 | **[취소 불가]** 카메라 리본 15핀 1.0mm 150mm B형(양끝 접점 반대 면) GUOCONN, 5개 묶음 | 5 | 5 | 엘레파츠 | 290 | 1,450 | 평균 발송 9영업일, 해외 재고 | [링크](https://www.eleparts.co.kr/goods/view?no=18579625) | 위 A형 행에 적은 까닭으로 함께 산다. 이 표는 A형을 조립분으로 셌으므로 이 행은 모두 여분이다. 최소 주문과 판매 단위가 5개, 해외 재고라 결제 뒤 취소가 안 된다. 낱개 263.64원(부가세 별도)에 1.1을 곱해 반올림한 값 |
| 32 | 화면 전원 케이블 Coms SP327 USB-A 수 - 마이크로 5핀 수 20cm 충전 전용 (잘라서 씀) | 3 | 2 | 엘레파츠 | 2,550 | 7,650 | 평균 발송 3.5일(페이지 표시) | [링크](https://www.eleparts.co.kr/goods/view?no=2923164) | 로봇당 1개 + 여분 2개. 화면의 전원 전용 micro USB 단자에 꽂는 플러그로 쓴다. USB-A 쪽을 잘라 플러그 뒤에 짧게 남긴 선의 5V·접지에 위 28AWG 두 가닥(머리 안 강압 모듈에서 오는 약 82mm)을 납땜하고 수축 튜브로 싼다. 0.65mm 간격 단자에 직접 납땜하는 조립형 플러그(엘레파츠 HIROSE ZX40, 2,510원, 덮개 별매)보다 쉽다. 선 굵기와 가닥 수는 페이지에 없어 받아서 확인한다 |
| 33 | I2S 마이크 INMP441 모듈 | 2 | 1 | 디바이스마트 | 8,250 | 16,500 | 평균 준비 2~3일 | [링크](https://www.devicemart.co.kr/goods/view?no=15366644) | 로봇당 1개 + 여분 1개. 머리 이마의 카메라 옆에 껍데기 기둥과 갈고리로 끼운다. 바닥 구멍형 마이크라 6판에서 기판을 뒤집어 기판 구멍이 있는 면이 껍데기 소리관(속 지름 2mm)을 보게 했다(5판 방향은 반대였을 가능성이 큼). 실제 모듈의 구멍 위치는 시험 조각(2.76g)으로 먼저 확인한다(위험 25). 페이지에 '호환 모델, 리비전 변경 가능' 안내 |
| 34 | I2S 앰프 MAX98357A | 2 | 1 | 엘레파츠 | 2,200 | 4,400 | 24시간 이내 발송 | [링크](https://www.eleparts.co.kr/goods/view?no=18016038) | 로봇당 1개 + 여분 1개. 5·6판에서 머리 받침 오른쪽 칸(강압 모듈 옆)에 앉고, 스피커 두 가닥만 목을 지나 몸통으로 간다. I2S 5가닥은 Pi 4 GPIO로 간다 |
| 35 | 스피커 40mm 3W 4옴 | 2 | 1 | 디바이스마트 | 2,090 | 4,180 | 평균 준비 3~4일 | [링크](https://www.devicemart.co.kr/goods/view?no=15960340) | 로봇당 1개 + 여분 1개. 몸통의 스피커 받침에 그대로 둔다. 얇은 진동판이 찢어지거나 선이 끊어지기 쉽다 |

### E. 출력물·체결·접착

| 번호 | 품목 | 수량(1대 기준) | 그중 여분 | 판매처 | 단가(부가세 포함, 원) | 금액(원) | 납기 | 링크 | 비고 |
|---:|---|---:|---:|---|---:|---:|---|---|---|
| 36 | PLA+ 노랑 1kg 1.75mm (머리 쉘·발·꼬리·날개·목·손·다리) | 2 | 1 | 삼디가게(네이버) | 19,000 | 38,000 | 11/4 도착 확률 91% | [링크](https://smartstore.naver.com/3d-gage/products/11021438704) | 부품 질량 544g, 여유 30% 더해 708g으로 1롤 + 여분 1롤. 1롤에는 292g만 남는데, 앞으로 넘어질 때 가장 먼저 깨질 머리 쉘이 281g이라 한 번 다시 뽑으면 바닥나서 여분을 더했다. 머리를 뽑기 전에 카메라·마이크 시험 조각 2개(합 6.9g, 위 질량에는 넣지 않음)를 먼저 뽑는다 |
| 37 | **[색 불일치]** PLA+ 파랑 1kg 1.75mm (재킷 앞·뒤 판·주머니·앞섶·소매 끝 고리) | 1 | 0 | 삼디가게(네이버) | 19,000 | 19,000 | 확인 못 함 | [링크](https://smartstore.naver.com/3d-gage/products/11021419865) | 부품 질량 287g, 여유 30% 더해 373g. 1롤에 627g이 남아 재킷 판을 다시 뽑을 몫이 되므로 여분 롤을 사지 않았다. 코리 재킷은 네이비인데 파랑으로 대체(색 차이). 국내에서 네이비를 못 찾음 |
| 38 | PLA+ 흰색 1kg 1.75mm (소매·얼굴 흰 부분·줄무늬·단추·K·칼라) | 1 | 0 | 삼디가게(네이버) | 19,000 | 19,000 | 확인 못 함 | [링크](https://smartstore.naver.com/3d-gage/products/11021437505) | 부품 질량 212g, 여유 30% 더해 276g. 1롤에 724g이 남아 소매와 흰 얼굴을 다시 뽑을 몫이 되므로 여분 롤을 사지 않았다. 칼라(23.6g)는 흰색-남색-흰색을 한 부품으로 출력하는 안이라 남색 띠는 같은 부품에서 필라멘트를 바꿔 쓴다. 한 부품 또는 세 부품은 결정 대기이며, 계산에는 칼라 전체를 흰색으로 넣었다 |
| 39 | PLA+ 검정 1kg 1.75mm (화면 테두리 + 오리 뼈대·기구 부품·핀·다월) | 2 | 1 | 삼디가게(네이버) | 19,000 | 38,000 | 확인 못 함 | [링크](https://smartstore.naver.com/3d-gage/products/11021418775) | 화면 테두리 9g + 기구 부품과 오리 뼈대(다리·몸통 하부) 747g, 여유 30% 더해 983g으로 1롤 + 여분 1롤. 기구는 안쪽이라 색이 상관없어 검정으로 합침. 1롤에는 17g만 남아 다리 뼈대나 발목 부품이 부러지면 다시 뽑을 몫이 없어서 여분을 더했다 |
| 40 | PLA+ 분홍 1kg 1.75mm (볼 홍조) | 1 | 0 | 삼디가게(네이버) | 19,000 | 19,000 | 확인 못 함 | [링크](https://smartstore.naver.com/3d-gage/products/11021434688) | 부품 질량 11g뿐이라 한 롤이 크게 남아 여분이 따로 필요 없다. 더 작은 분홍 필라멘트는 국내 판매처에서 못 찾음 |
| 41 | TPU 95A 1.75mm 1kg (발바닥 등, 목 서보 고정 패드) | 1 | 0 | 와리뷰(네이버) | 32,400 | 32,400 | 11/4 도착 확률 97% | [링크](https://smartstore.naver.com/wareview/products/12226265575) | 한 롤. 목 요 서보를 위에서 누르는 두께 0.8mm 패드(로봇당 4개)도 이 롤로 출력한다. 발바닥이 닳아도 같은 롤로 다시 뽑을 만큼 남는다고 보고 여분을 사지 않았다(발바닥 질량은 모델에서 따로 세지 않음) |
| 42 | M3 황동 열압입 인서트 5x5 (100개) | 100 | 0 | 쉽다이(네이버) | 60 | 6,000 | 오늘 출발, 평균 2일 이내 | [링크](https://smartstore.naver.com/shipdiy/products/12116196132) | 개당 60원. 상품이 100개 묶음이고 필요한 개수를 코비 모델에서 센 적이 없어 줄이지 않았다(남는 것이 여분 몫). 오리 뼈대 자체 조립용 수량으로 옛 판 그대로이며, 코비 외피·기구 접합에는 쓰지 않는다. '5x5'가 외경 5mm x 길이 5mm인지 페이지에 명시가 없고, 원본 규격은 외경 5.7 x 길이 4.6mm라 구매 전 확인 |
| 43 | M3 소켓 볼트 12종 세트 (이노공구 W101) | 1 | 0 | 디바이스마트 | 13,750 | 13,750 | 평균 준비 3~4일 | [링크](https://www.devicemart.co.kr/goods/view?no=16034645) | 오리 뼈대 조립과 배터리 고정, 화면을 육각 서포트에 붙이는 볼트 8개(로봇당)에 쓴다. 상세 이미지 기준으로 둥근머리 육각렌치 볼트(스테인리스) 길이 5, 6, 7, 10, 12, 15, 20, 25, 30, 40, 45, 50mm가 10개씩 들어 있다. 화면 앞 나사는 M3x6 4개(기판 1.6mm를 지나 서포트에 4.4mm 들어감)이고, 모델이 정한 뒤 나사 8mm는 세트에 없어 M3x7 4개를 쓴다(출력 판 2.4mm를 지나 4.6mm 들어감). 두 나사가 들어가는 길이를 합쳐 9.0mm라 15mm 서포트 안에 6.0mm가 남아 서로 닿지 않는다(모델 치수로 계산). M3x10도 닿지는 않지만(합 12.0mm) 서포트 나사산이 끝까지 나 있는지 몰라 짧은 쪽을 쓴다. 코비 모델에서 배터리를 잡는 것은 오리 원래의 M3 나사와 인서트이고, 모델의 배터리 받침 Battery_mount는 이를 대신하는 가짜 부품이라 출력하지 않는다. 오리 뼈대에 M3x6을 얼마나 쓰는지는 세지 않아, 모자라면 같은 길이를 더 산다 |
| 44 | M3 암암 육각 서포트 15mm 스틸 [아성] PS3-S15F (화면 기판 고정) | 8 | 4 | 엘레파츠 | 99 | 792 | 24시간 이내 발송 | [링크](https://www.eleparts.co.kr/goods/view?no=6934) | 로봇당 4개 + 여분 4개. 화면 기판 네 귀퉁이와 출력한 설치판 사이에 세우고 앞은 M3x6, 뒤는 M3x7 볼트(위 W101 세트)로 조인다. 양쪽이 암나사인 15mm짜리다(페이지 표기: 육각, 스틸, 암-암, M3, 15mm). 낱개 판매이고 최소 주문 4개. 90원(부가세 별도)에 1.1을 곱한 값. 모델은 황동으로 보고 개당 1.9g을 넣었는데 스틸도 무게가 비슷하다. 육각 폭은 페이지에 없어 받아서 잰다. 같은 길이라도 한쪽이 수나사인 제품(엘레파츠 Coms BB266)은 맞지 않는다 |
| 45 | M2·M2.5 소형 나사 세트 (스텐, 12종 240개) | 1 | 0 | 엘레파츠 | 9,900 | 9,900 | 24시간 이내 발송 | [링크](https://www.eleparts.co.kr/goods/view?no=7690851) | Pi Zero 보드 구멍 4개와 Pi 4 보드 구멍 4개에 M2.5 나사를 쓴다(로봇당 8개. 모델의 구멍 개수 기준, Pi 4는 머리 받침 기둥에 길이 6mm). 머리 안 강압 모듈과 앰프를 받침에 고정할 M2 나사 4개도 여기서 쓴다(양면 테이프로 대신할 수 있음, 실물에서 정함). 서보 혼 나사는 서보에 딸려 오는 것을 쓴다. 제목은 M2-M3. 십자 나사이고 M2.5가 들어 있는지·길이 구성은 확인 못 함. M2만 필요하면 둥근머리 800개(no=12633577) 7,700원 |
| 46 | **[가격 확인]** 스텐 육각 너트 M2.5 (100개 팩) 동화볼트 | 1 | 0 | 엘레파츠 | 3,850 | 3,850 | 24시간 이내 발송 | [링크](https://www.eleparts.co.kr/goods/view?no=10140148) | Pi Zero는 위판의 뚫린 구멍에 M2.5 나사로 달아 너트가 필요하다(Pi 4는 받침 기둥의 2.2mm 구멍에 나사가 스스로 나사산을 내며 들어감, 모델 head_params). 위 나사 세트에는 너트가 들어 있다는 표기가 없다. 상품명은 100개 팩인데 가격 칸에 개당 3,500원(부가세 별도)이라 적혀 있어 결제 전에 팩 가격인지 확인한다. 설명서 독립 검증에서 빠졌다고 나온 부품 |
| 47 | 네오디뮴 원형 자석 지름 5mm x 두께 2mm N35, 니켈-구리-니켈 도금 (낱개) | 100 | 26 | 좋은자석 | 50 | 5,000 | 주문 후 3~7일(주말·공휴일 제외) | [링크](https://nicemagnet.com/product/n35-%EB%84%A4%EC%98%A4%EB%94%94%EC%9B%80-%EA%B0%95%EB%A0%A5-%EC%9B%90%ED%98%95%EC%9E%90%EC%84%9D-5mm-x-2t/65/) | 로봇 1대 104개(자석 자리 52쌍) + 여분 약 25% = 130개가 필요하다. 사용자가 이미 30개를 갖고 있어(2026-11-02, 캘리퍼 실측 5.0 x 2.0mm) 100개만 산다(옛 판과 같음). 그중 여분 칸의 26개는 산 것에서 로봇에 쓰고 남는 수다. 개당 50원이라 깨지면 다시 사도 부담이 작아 늘리지 않았다. 판매처 표시 등급 N35, 공차 ±0.03(상세 이미지에만 있고 단위가 없어 결제 전 판매처에 문의). 모델의 자석 칸은 공차 ±0.05mm로 계산했다. 접합 부위별 개수는 설계 문서 4-9. 대안: 정신자석 D5X2T 개당 60원(배송 3,000원, 5만원 이상 무료). 극 방향은 마커로 표시해 맞추고 순간접착제로 칸에 고정 |
| 48 | 순간접착제 록타이트 401 20g (자석·다월 고정, 얼굴 부품 부착) | 2 | 1 | 디바이스마트 | 4,400 | 8,800 | 평균 준비 2~3일 | [링크](https://www.devicemart.co.kr/goods/view?no=9108) | 한 병 + 여분 한 병. 자석을 홈에 고정하고 다월은 한쪽 부품에 고정한다. 자석 104개와 다월 14개를 붙이는 데 쓰고 PLA 얼굴 부품 부착에도 쓴다. 한 병으로 충분한지 재 보지 않았고, 깨진 출력물을 고칠 때도 써서 한 병을 더 넣었다. 틈이 크면 젤형이 낫지만 디바이스마트 젤형은 찾지 못함 |
| 49 | 유성 마커 모나미 네임펜F 1.0mm (자석 극 표시용) | 1 | 0 | 디바이스마트 | 1,210 | 1,210 | 평균 준비 2~3일 | [링크](https://www.devicemart.co.kr/goods/view?no=35192) | 자석을 칸에 넣기 전 서로 끌어당기는 면을 정해 같은 쪽에 표시하는 용도. 디바이스마트 주문에 함께 넣어 배송비가 늘지 않는다. 색은 흑색·청색·빨강 중 고른다(흑색 권장). 페이지에 유성 표기는 없고, 네임펜이 유성 마커라는 것은 일반 판매 설명에 따른 것이다. 1,100원(부가세 별도)에 1.1을 곱한 값 |
| 50 | 나사 고정제 록타이트 243 10ml | 1 | 0 | 헨켈 록타이트 온라인몰(네이버) | 8,200 | 8,200 | 확인 못 함 | [링크](https://smartstore.naver.com/loctite_kr/products/12105840752) | 금속 나사에만 사용 |
| 51 | 볼 베어링 6804ZZ | 6 | 2 | 베어링스토어(네이버) | 1,550 | 9,300 | 11/4 도착 확률 96% | [링크](https://smartstore.naver.com/bearingstore/products/11471428883) | 로봇당 4개(기존 3개 + 목 요 축 1개) + 여분 2개. 모델의 목 요 축 베어링은 6804ZZ 1개(바깥지름 32mm, 안지름 20mm, 두께 7mm)이고, 이를 받치는 Yaw_bridge는 위판과 한 번에 출력한다. 넘어질 때 머리 쪽 충격이 이 베어링에 실린다 |
| 52 | 노란 신축 원단 ITY 폴리스판 (다리 레깅스, 선택) | 2 | 0 | 원단대장(네이버) | 5,800 | (11,600) 선택, 합계 제외 | 11/4 도착 확률 93% | [링크](https://smartstore.naver.com/wondandaejang/products/12350477659) | 선택 품목, 합계에서 뺌. 사용자 결정(2026-11-04)으로 사지 않는다. 레깅스를 만들지 않거나 갖고 있는 천을 쓴다. 레깅스가 없으면 오리 다리 뼈대가 그대로 보인다(위험 34). 사게 되면 로봇당 1개 + 여분 1개로 본 수량이고, 판매 단위(길이)와 폭은 페이지에서 확인하지 못했다 |
| 53 | **[사양 의심]** USB 케이블 micro-B 수 - USB-C 수 15cm (Zero 2 W - 서보 보드) | 2 | 1 | 디바이스마트 | 2,640 | 5,280 | 평균 준비 1주일 | [링크](https://www.devicemart.co.kr/goods/view?no=10918532) | 로봇당 1개 + 여분 1개. 제목은 15cm, 사양란은 25cm. 일반 케이블은 micro-B쪽 ID핀이 접지되지 않아 Pi 쪽 OTG 호스트로 동작하지 않을 수 있음 |
| 54 | 소켓 점퍼 케이블 40P 암-암 20cm (Pi 4 GPIO 쪽 단자: 전원, UART, I2S) | 1 | 0 | 디바이스마트 | 935 | 935 | 평균 준비 1~2일 | [링크](https://www.devicemart.co.kr/goods/view?no=1321192) | 6판 모델에서 Pi 4 GPIO에 꽂는 단자는 14자리(핀 2, 4, 6, 8, 10, 12, 14, 17, 30, 34, 35, 38, 39, 40)에 16가닥이다(모델 v6 README 7절의 배치). 핀 12(I2S 비트 클록)와 35(좌우 클록)는 마이크와 앰프가 함께 쓰므로, 앰프 선과 마이크 선 분리 커넥터의 Pi 쪽 선 두 가닥을 한 단자에 함께 납땜해 갈래를 만든다(마이크 쪽은 커넥터에서 떨어진다). 한 팩 40가닥을 반으로 자르면 단자 달린 끝이 80개라 압착 공구 없이 충분하고 나머지가 여분이다. 단자 쪽만 잘라 전선에 납땜하고 수축 튜브로 싼다. 선 굵기는 페이지에 없음 |
| 55 | **[크기 확인]** 7핀 분리 커넥터 케이블 NW3 SM 7핀-7핀 암수 (목 묶음을 머리에서 끊는 곳) | 2 | 1 | 디바이스마트 | 1,760 | 3,520 | 평균 준비 2~3일 | [링크](https://www.devicemart.co.kr/goods/view?no=1342794) | 로봇당 1벌 + 여분 1벌. 목을 지나는 7가닥(7.4V 두 가닥, UART 세 가닥, 스피커 두 가닥)을 머리 안에서 이 커넥터로 끊어, 머리를 뗄 때 플러그만 뽑으면 된다. 압착 공구 없이 쓰려고 선이 달린 SM 짝 케이블을 골랐다. 6판 모델은 JST SM 공식 도면의 크기(짝 맞춘 상태 19.7 x 20.5 x 7.5mm)로 이 짝을 받침 앞 오른쪽(로봇 기준, -x) 칸에 세웠고, 목 쪽 플러그를 -x로 당기면 걸림 없이 빠진다. 호환품이라 실제 크기는 받아서 맞춰 본다(위험 23). 머리 쪽 선은 길이에 맞춰 잘라 UART(GPIO), 강압 모듈 입력, 앰프 출력에 바로 잇는다. 딸린 전선은 22AWG라 7가닥을 그대로 목에 보내면 묶음이 굵어지므로, 머리 안에서 짧게 잘라 목 묶음 전선에 납땜한다. JST 원본 SM의 정격은 접점당 3A, 전선 28~22AWG이며 이 제품은 호환품이다. 30·80·100cm가 같은 가격이다. 몸통 쪽(배터리가 나오는 쪽)은 소켓 접점이 든 플러그(SMP), 머리 쪽은 핀 접점이 든 리셉터클(SMR)로 둔다. 핀 1부터 스피커+, Zero 송신(Pi 4 수신), 전원 접지, 배터리+(스위치 뒤), 신호 접지, Pi 4 송신(Zero 수신), 스피커-로 배터리+를 가운데 4번에 둔다(Codex 권고). 잘라 잇기 전에 몰드에 새겨진 칸 번호로 확인하고 통전을 잰다 |
| 56 | **[재고 확인]** 마이크 선 분리 커넥터 NW3 SM 6핀-6핀 암수 (오른쪽 껍데기 반쪽을 떼기 전에 뽑음) | 2 | 1 | 디바이스마트 | 1,430 | 2,860 | 평균 준비 2~3일, 30cm 품절(50·100cm 재고, 2026-11-04) | [링크](https://www.devicemart.co.kr/goods/view?no=1342793) | 로봇당 1벌 + 여분 1벌. 마이크 선 6가닥 중간에 넣어 오른쪽 껍데기 반쪽을 떼기 전에 뽑는다. 핀 12·35의 갈래는 커넥터의 Pi 쪽(고정된 쪽)에서 앰프 선과 한 단자로 묶는다. v7에서 목과 같은 7핀을 골랐더니, 조립 설명서 독립 검증이 머리 안에서 두 커넥터를 바꿔 꽂으면 배터리 7.4V가 Pi 4 신호 핀으로 들어간다고 지적해 6핀으로 바꿨다. 같은 SM 계열이지만 마이크 쪽에 작은 플러그(SMP), Pi 쪽에 리셉터클(SMR, 핀 접점)을 두면 7.4V가 실린 목의 몸통 쪽 7핀 플러그(폭 18mm)는 이 6핀 리셉터클(안쪽은 6핀 플러그 폭 15.5mm에 맞고 바깥 폭 18mm)에 일부도 들어가지 못한다. 핀 1부터 3.3V, 접지, L/R, SD, WS, SCK(Codex 권고). 두 커넥터에 다른 색 표시를 하고, 처음 켜기 전에 목 7.4V 선과 Pi 핀 12·17·35·38 사이가 끊겨 있는지 멀티미터로 잰다(위험 28). 페이지 맨 위 버튼이 품절로 보여 주문 전에 옵션 재고를 확인하고, 주문 제작 상품이라 모양과 색이 바뀔 수 있다는 안내가 있다. 딸린 22AWG 꼬리는 짧게 잘라 납땜한다. 모델에는 없는 부품이라 자리와 손이 닿는지는 실물로 맞춘다 |
| 57 | 케이블 타이 2.5 x 100mm 검정 (100개) 티테크놀로지 T-C2510B | 1 | 0 | 엘레파츠 | 438 | 438 | 평균 발송 2.5일 | [링크](https://www.eleparts.co.kr/goods/view?no=9100003) | 몸통 안 묶음 자유 꼬리와 배선을 정리한다. 목 안내물 구간과 머리-목 사이 자유 고리는 머리가 돌 때 움직여야 하므로 묶지 않는다. 100개 묶음 |
| 58 | 열수축 튜브 190세트 (1.5·3·6mm, 100mm, 흑·적) | 1 | 0 | 엘레파츠 | 5,280 | 5,280 | 24시간 이내 발송 | [링크](https://www.eleparts.co.kr/goods/view?no=8170310) | 28AWG 화면 전원선과 점퍼 단자·micro USB 선의 납땜 이음, 7핀 커넥터 꼬리와 목 묶음 전선의 이음 7곳(모델의 납땜 구간 25mm), I2S 선과 점퍼 단자의 이음을 싼다. 1.5mm와 3mm가 이 용도다. 5,280원은 13% 할인가라 할인이 끝나면 6,050원이 된다 |
| 59 | 22AWG 실리콘 전선 6색 36m 세트 | 1 | 0 | 엘레파츠 | 22,880 | 22,880 | 24시간 이내 발송 | [링크](https://www.eleparts.co.kr/goods/view?no=7695156) | 몸통 배선에 적·흑 합계 약 10m가 필요하다. 5·6판에서는 목 묶음의 7.4V 두 가닥(한 가닥 약 0.5m)과 머리 안 강압 모듈에서 Pi 4 GPIO 핀 2·6으로 가는 두 가닥(6판 모델 양끝 포함 약 169mm)도 이 전선이다(36m라 다시 배선할 몫이 남는다). 화면 전원선과 묶음의 UART·스피커 선은 위 28AWG 행이 맡는다. 22AWG 실리콘 전선은 피복 포함 지름이 보통 1.2mm를 넘고 이 세트의 외경은 페이지에서 확인하지 못해, 목 묶음 굵기(모델 3.6mm)는 받아서 다시 잰다 |
| 60 | **[재질 확인]** 마이크 소리관 고리 재료 써멀패드 0.5mm 100x100mm 티테크놀로지 T-TP05 (안지름 2mm·바깥지름 5mm로 오려 씀) | 1 | 0 | 디바이스마트 | 1,320 | 1,320 | 평균 준비 3~4일 | [링크](https://www.devicemart.co.kr/goods/view?no=13004344) | 6판 모델에서 마이크 소리관 끝과 기판 사이에 0.3mm 틈이 있어, 이 판에서 고리를 오려 틈을 막는다. 0.5mm 패드가 눌려 0.3mm가 되며 출력 오차를 받아 낸다. 한 장에서 고리가 수십 개 나와 여분은 따로 세지 않았다. 재질·경도·점착 여부는 페이지에 없어, 패드가 마이크를 밀어내지 않고 소리가 막히지 않는지 마이크 시험 조각으로 먼저 본다(모델 v6 README 6절). 1,200원(부가세 별도)에 1.1을 곱한 값. 맞지 않으면 대안 표의 0.3mm 실리콘 시트를 쓴다 |
| 61 | 나선 케이블 랩 4mm 25m (선택) | 1 | 0 | 캐롯베이(네이버) | 27,860 | (27,860) 선택, 합계 제외 | 확인 못 함 | [링크](https://smartstore.naver.com/rrottee/products/13581517060) | 약한 후보(간이 사업자, 가격 높음). 몸통 안 배선 정리용이며 없어도 조립 가능. 목 구간의 묶음은 머리가 돌 때 움직여야 하므로 감지 않는다. 합계에서 뺌 |

### F. 행사 운용

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

## 3. 판매처별 배송비 추정

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

## 4. 외피 출력 필라멘트 계산

`parts_table.json`의 부품 63개를 색으로 나눠 1대 합계에 여유 30%(실패와 지지대)를 더하고 1kg 롤 수를 올림으로 셌다. 오리 뼈대(다리·몸통 하부) 인쇄분은 옛 판의 근거(로봇당 약 500g)를 썼다. 이 표는 1대 질량 합계가 1,310.6g이며, 부품표 합계 1,310.6g과 같다(오리 뼈대 인쇄분 제외). 여분 롤은 깨진 부품을 다시 뽑을 몫이다.

| 색 | 포함 부품 | 1대 질량(g) | 여유 30% 포함(g) | 필요한 롤 수 | 여분 롤 |
|---|---|---:|---:|---:|---:|
| 노랑 | A_HeadShell, Neck, Foot_L_cover, Foot_R_cover, Leg_L_guard, Leg_R_guard, Tail_body, Wing_R, Wing_L, Arm_R_mitten, Arm_L_mitten | 544.4 | 708 | 1 | 1 |
| 파랑(네이비 대체) | Jacket_pocket_R0, Jacket_pocket_R1, Jacket_pocket_L0, Jacket_pocket_L1, Jacket_placket, Jacket_front, Jacket_back, Arm_R_cuff, Arm_R_cuff_top, Arm_L_cuff, Arm_L_cuff_top | 287.3 | 373 | 1 | 0 |
| 흰색 | Face_WhiteFace, Collar_ring, Jacket_button_0, Jacket_button_1, Jacket_button_2, Jacket_K, Jacket_hem_stripe_front, Jacket_hem_stripe_back, Jacket_raglan_L_front, Jacket_raglan_L_back, Jacket_raglan_R_front, Jacket_raglan_R_back, Arm_R_sleeve, Arm_R_cuff_stripe, Arm_L_sleeve, Arm_L_cuff_stripe | 212.1 | 276 | 1 | 0 |
| 검정(화면 테두리) | Face_LCD_bezel | 8.9 | 12 | 1 | - |
| 분홍 | Face_Blush_R, Face_Blush_L | 10.7 | 14 | 1 | 0 |
| 기구 부품 + 오리 뼈대(아무 색) | Foot_L_dowel_a, Foot_L_dowel_b, Foot_R_dowel_a, Foot_R_dowel_b, Seam_pin_L_round, Seam_pin_L_slot, Seam_pin_R_round, Seam_pin_R_slot, Shoulder_coupler_R, Shoulder_coupler_L, Top_plate, Yaw_lock_pin, Plate_leg_R, Plate_leg_L, Neck_yaw_yoke, Neck_gap_shield, Board_keeper_pin, Speaker_bracket, LCD_mount, LCD_mount_pin, Head_frame_LCD, Pi4_head_bracket, 오리 뼈대 인쇄분 500g(옛 판 근거) | 747.2 | 971 | 1 (검정 롤에 합침) | - |
| 검정 롤 합산 | 화면 테두리 + 기구 + 뼈대 | | 983 | 1 | 1 |

- 여분 롤은 노랑과 검정에만 넣었다. 노랑 1롤에는 292g만 남는데 머리 쉘이 281g이라 한 번 다시 뽑으면 바닥난다. 검정 1롤에는 17g만 남아 다리 뼈대를 다시 뽑을 몫이 없다. 파랑은 627g, 흰색은 724g이 남아 재킷 판과 소매를 다시 뽑을 수 있다.
- 분류 규칙에 없던 이름은 이렇게 정했다. 줄무늬(Jacket_hem_stripe_front, Jacket_hem_stripe_back)는 흰색, 꼬리 몸통(Tail_body)은 노랑으로 봤다. 소매 끝 고리 세 개(Arm_*_cuff, Arm_*_cuff_top은 파랑, Arm_*_cuff_stripe는 흰색)와 손(Arm_*_mitten, 노랑)은 팔마다 따로 출력한다. 칼라(Collar_ring, 23.6g)는 흰색-남색-흰색을 한 부품으로 출력하는 안이라 남색 띠를 따로 떼지 않고 전부 흰색으로 계산했다(결정 대기: 한 부품(필라멘트 교체) 또는 세 부품. 어느 쪽이든 재료 양은 같다). 어깨 연결부·위판·목 요크·목 닫는 고리(Neck_gap_shield)·위판 다리(Plate_leg)·머리 틀(Head_frame)·머리 안 Pi 4 받침(Pi4_head_bracket)·스피커 브래킷과 출력 핀·다월(Foot_*_dowel_*, Seam_pin_*, Yaw_lock_pin, Board_keeper_pin, 화면 설치대 못 LCD_mount_pin)은 기구 부품(아무 색)으로 봤다. 배터리 받침(Battery_mount)은 모델의 가짜 부품이라 출력하지 않아 표에 없다.
- LCD 5판에서 바뀐 출력 부품: 새로 든 것 없음, 빠진 것 없음, 질량이 바뀐 것 A_HeadShell 281.7g → 281.1g, Pi4_head_bracket 22.3g → 22.2g. 머리 껍데기는 카메라 기둥·갈고리를 옮기고 마이크 자리를 뒤집고 통풍구를 내서, 받침은 SM 커넥터 칸을 고쳐서 바뀌었다. 부품 수는 63개 그대로이고 합계는 1,311.3g에서 1,310.6g이 됐다. 이와 별도로 카메라·마이크 시험 조각 2개(`print/test_coupons/`, 합 6.9g)를 머리보다 먼저 뽑는다. 목의 선 묶음 고리 3벌은 목(Neck)과 한 번에 출력한다. 카메라와 마이크의 기둥·갈고리는 머리 껍데기와 한 번에 출력한다. 반쪽 파일(머리 껍데기, 흰 얼굴, 테두리 L/R)은 합계에 따로 세지 않는다.

## 5. 대안과 참고 (합계에 넣지 않음)

| 대상 | 대안과 가격 | 이유와 한계 | 링크 |
|---|---|---|---|
| 서보 STS3215 22개 | 모터킹(네이버) 37,000원 x 22 = 814,000원 + 배송 무료(10만원 이상) | 엘레파츠보다 81,400원 쌈. 빠른 배송이지만 '간이 사업자' 표시라 세금계산서가 안 나올 수 있음 | [링크](https://smartstore.naver.com/motorking/products/12905334619) |
| MG90S 정품 | 아이씨팩토리 13,200원 x 5 = 66,000원 + 배송 3,000원 | 호환품(4,400원)보다 비쌈. 정품이 필요할 때만 | [링크](https://icfactory.co.kr/product/detail.html?product_no=331) |
| BNO055 정품급 | 엘레파츠 온시스텍 OSTSen-B055 73,700원 x 2 = 147,400원 | 복제 위험을 피하려면. 배송 평균 2일 | [링크](https://www.eleparts.co.kr/goods/view?no=4299296) |
| Pi Zero 2개를 모두 11/13 디바이스마트 2WH로 | 29,700원 x 2 = 59,400원(이 판보다 20,900원과 아이씨뱅큐 배송비만큼 쌈) | 오늘 살 수 없고 입고일이 예정일일 뿐이라 쓰지 않았다(사용자 결정 2026-11-04). 엘레파츠 2W·2WH, 메카솔루션, 이듀이노는 품절 | [링크](https://www.devicemart.co.kr/goods/view?no=15548740) |
| 2핀 커넥터 대안 | 엘레파츠 Amass JST(M&F) 연장 케이블 세트 1,100원 x 4 = 4,400원 | 24시간 이내 발송이지만 사진상 잠금 걸쇠가 없는 마찰식이고 선 길이·굵기·정격이 페이지에 없다 | [링크](https://www.eleparts.co.kr/goods/view?no=3819922) |
| 마이크 고리 재료 대안 | 디바이스마트 Secraft 실리콘 시트 0.3mm 50x25mm 3장(한쪽 접착) 6,600원 | 설계 틈 0.3mm와 두께가 같고 접착면이 있지만 5,280원 비싸다 | [링크](https://www.devicemart.co.kr/goods/view?no=16081831) |
| 네이비에 가까운 PLA | 옥션 '뱀부랩 필라팜' Bambu Lab PLA Matte 다크 블루 20,900원 + 배송 3,000원 | 페이지에 해외·대행 문구는 없으나 실제 색과 정품 여부는 사진으로 확인하지 못함 | [링크](https://itempage3.auction.co.kr/DetailView.aspx?itemno=F502521803) |
| 5V 강압 모듈 대안 | 디바이스마트 SZH-EKBD-066(입력 6~40V, USB 출력) 1,300원(별도) = 1,430원 | 싸지만 입력 하한 6V가 방전 말기 전압과 같아 여유가 없음 | [링크](https://www.devicemart.co.kr/goods/view?no=1342939) |
| 짧은 HDMI 선, 곧은 플러그 | 디바이스마트 SZH-CAB19 마이크로 HDMI - HDMI 50cm 2,750원 | 싸지만 Pi 4 쪽이 곧은 플러그라 몸체와 보호관이 앞으로 약 35mm 나와 화면 설치판에 부딪힌다(모델 v5 README 4절). 쓰지 않는다 | [링크](https://www.devicemart.co.kr/goods/view?no=12497784) |
| 짧은 HDMI 선, 얇은 선 | 11번가 개인 판매자 초박형 마이크로 HDMI - HDMI 30cm(외경 3.2mm 표기) 20,800원 | 회원 전용 상품이고 개인 판매자라 증빙과 반품이 불확실하다. 꺾인 플러그가 아니라 BS359의 방향이 맞지 않을 때도 대안이 되지 못한다 | [링크](https://www.11st.co.kr/products/9727846428) |
| Pi 4 4GB | 레오콤 155,001원(재고 표시 있음, 방열판 없음, 전화 02-3211-1077). 엘레파츠·디바이스마트·아이씨뱅큐 4GB는 183,700원 | 3GB가 품절되면 쓴다. 레오콤은 방열판을 따로 사야 한다(디바이스마트 RBP-001 770원) | - |
| 7핀 커넥터 대신 XH 호환 2핀 + 5핀 | 엘레파츠 Adafruit 4872(2핀) + 4875(5핀) 각 1,700원 = 3,400원 | 모델이 가정한 XH 계열이지만 딸린 전선이 26AWG라 7.4V 전원 쌍에 병목이 되고, 평균 발송 6.5일에 해외 재고 안내가 있다 | [링크](https://www.eleparts.co.kr/goods/view?no=13195195) |
| 화면 전원 플러그 조립형 | 엘레파츠 HIROSE ZX40-B-5S-UNIT 2,510원 + 덮개(위·아래, 10개 묶음) | 선 없이 플러그만 사는 방법. 단자 간격이 0.65mm라 28AWG 납땜이 까다롭고 덮개를 따로 사야 한다 | [링크](https://www.eleparts.co.kr/goods/view?no=17566035) |

## 6. 옛 판에서 달라진 점

- LCD v11 (2026-11-04, 주문용, 모델은 6판 그대로): LCD v10 총액 2,159,790원에서 2,259,090원이 됐다(차이 99,300원). 사용자 결정으로 여분 Pi Zero도 오늘 아이씨뱅큐에서 사고(+50,600원, 디바이스마트 2WH 29,700원은 선택 품목으로 돌리고 그 2차 주문 배송비 3,000원은 없어짐), 남는 예산으로 서보 STS3215 2개(81,400원)를 더해 서보 여분이 10개가 됐다. 위험 1·29를 다시 썼다.
- LCD v10 (2026-11-04, 주문용, 모델은 6판 그대로, `코비_BOM_오픈덕미니v2_LCD_v10_20261104.md`, 그대로 둠): LCD v9 총액 2,277,030원에서 2,159,790원이 됐다(차이 -117,240원). 사용자 결정으로 공유기(42,840원), Xbox 컨트롤러(59,800원), 레깅스 원단(11,600원)을 사지 않기로 해 선택 품목으로 돌렸고, 원단대장 배송비 3,000원도 없어졌다. 대신할 것은 위험 34에 적었다.
- LCD v9 (2026-11-04, 주문용, 모델은 6판 그대로, `코비_BOM_오픈덕미니v2_LCD_v9_20261104.md`, 그대로 둠): LCD v8 총액 2,251,076원에서 2,277,030원이 됐다(차이 25,954원). Pi Zero 2 W를 아이씨뱅큐 핀 헤더 납땜판 1개(50,600원)와 디바이스마트 2WH 여분 1개(29,700원, 11/13 입고 뒤)로 바꾸고(+25,300원), 아이씨뱅큐 배송비 3,000원과 여분을 따로 사는 디바이스마트 2차 주문 배송비 3,000원(둘 다 가정)을 더했다. 2핀 커넥터는 디바이스마트 SM 2핀(4벌 2,200원, -1,800원), 마커는 모나미 네임펜F(1,210원, -290원), 마이크 고리 재료는 써멀패드 0.5mm(1,320원, 이제 합계에 듦)로 정했다. 핀 헤더(2,420원)와 DC 플러그(2,156원)는 선택 품목으로 돌렸다. 위험 1·29·32를 다시 썼고, 가격을 정하지 않았던 마이크 고리 위험(8판 34번)은 없어졌다.
- LCD v8 (2026-11-04, 모델은 6판 그대로, 조립 설명서 독립 검증 반영, `코비_BOM_오픈덕미니v2_LCD_v8_20261104.md`, 그대로 둠): LCD v7 총액 2,240,626원에서 2,251,076원이 됐다(차이 10,450원). 마이크 선 분리 커넥터를 SM 7핀에서 6핀으로 바꾸고(목 커넥터와 바꿔 꽂히는 위험), Pi Zero 핀 헤더, M2.5 너트, 머리 가지 퓨즈 홀더와 5A 퓨즈를 더했다. 직류 정격 스위치는 선택 품목으로 넣었다. 목 7핀과 마이크 6핀의 핀 순서와 반쪽 방향을 적고, 위험 32(서보 보드 입력 전압)와 33(스위치 정격과 퓨즈)을 새로 넣었다.
- LCD v7 (2026-11-03, 모델은 6판 그대로, 6판 독립 검증 반영, `코비_BOM_오픈덕미니v2_LCD_v7_20261103.md`, 그대로 둠): LCD v6 총액 2,237,106원에서 2,240,626원이 됐다(차이 3,520원). 마이크 선 분리 커넥터(SM 7핀 짝, 6핀만 사용) 2벌을 더하고 핀 12·35 갈래를 커넥터의 Pi 쪽으로 옮겨, 오른쪽 껍데기 반쪽이 앰프에 묶이지 않게 했다. 위험 20·23·25·28에 검증 결과(HDMI 고리 묶을 자리, SM 잠금 팔 방향, 세로 영상과 갈고리 걸림 0.2mm, 손이 닿는 깊이와 microSD)를 더했다.
- LCD v6 (2026-11-03, 5판 독립 검증 반영, `코비_BOM_오픈덕미니v2_LCD_v6_20261103.md`, 그대로 둠): LCD v5 총액 2,237,106원에서 2,237,106원이 됐다(차이 0원). 산 부품은 그대로이고, 가격을 정하지 않은 마이크 소리관 고리 행(합계 제외)을 더했다. 카메라 기둥 위치, 마이크 방향, 머리 안 I2S·UART 배선, 통풍구, 30cm HDMI 선 고리, SM 7핀 크기를 6판 모델에 넣어 행의 비고와 위험 17~27을 다시 썼고, 28(껍데기 여는 순서와 microSD)을 새로 넣었다. 머리 질량은 673.6g에서 686.2g이 됐다.
- LCD v5 (2026-11-03, Pi 4를 머리에, `코비_BOM_오픈덕미니v2_LCD_v5_20261103.md`, 그대로 둠): LCD v3 총액 2,189,811원에서 2,237,106원이 됐다. 차이는 47,295원이다. Pi 4를 2GB(119,900원)에서 3GB(151,800원)로 바꿔 2개에 63,800원이 늘었다. 1m HDMI 선 3개(30,600원)와 선 고정 받침(1,670원)을 빼고, 30cm 꺾인 HDMI 선 2개(9,360원), 카메라 리본 150mm A·B형 5개씩(2,885원), 7핀 분리 커넥터 2벌(3,520원)을 더했다. 30mm 팬(2,310원)은 선택 품목이라 합계에 넣지 않았다. 출력 부품은 Pi 4 브래킷이 머리 받침으로, 렌즈 단추가 평범한 단추로 바뀌었다. 위험 4·7·9·11·13을 고치고 17~27을 5판에 맞게 다시 썼다. LCD 4판 모델(꺾인 플러그로 고친 판)은 부품표를 만들지 않았다.
- LCD v3 (2026-11-03, `코비_BOM_오픈덕미니v2_LCD_v3_20261103.md`, 그대로 둠): LCD v2 총액 1,416,043원에서 2,189,811원이 됐다. 차이는 773,768원이다. 화면을 Raspberry Pi Touch Display 2(68,200원)에서 Waveshare 5인치 HDMI(73,150원)로, 50cm FFC 리본 2개(3,960원)를 HDMI 선 Coms IF700 1m(10,200원)로 바꾸고, 화면 고정용 M3 육각 서포트, 화면 전원 플러그용 케이블(SP327), 듀퐁 점퍼, 선 고정 받침과 케이블 타이, 수축 튜브를 더했다. 나머지 차이는 여분이다. 여분은 모두 865,809원어치이고, 서보 8개, Pi 4·Pi Zero·화면·카메라·서보 드라이버 각 1개, HDMI 선 2개, 전원·음성 부품 각 1~3개, 노랑·검정 PLA 각 1롤 등이다. 리본을 사지 않아 디바이스마트 공식스토어 배송비 2,700원이 없어졌다. 위험 9·17~25는 HDMI 판에 맞게 다시 썼고 26~30은 새로 넣었다.
- LCD v2 (2026-11-03, `코비_BOM_오픈덕미니v2_LCD_v2_20261103.md`, 그대로 둠): LCD v1 총액 1,387,003원에서 1,416,043원이 됐다. 목 안내물 홈에 들어갈 가는 화면 전원선(28AWG 2롤)을 더했다.
- LCD v1 (2026-11-03, `코비_BOM_오픈덕미니v2_LCD_20261103.md`, 그대로 둠): 인쇄 얼굴 판 총액 1,318,803원에서 1,387,003원이 됐다. 차이는 5인치 화면 68,200원이다.
- 1대 기준으로 변경(2026-11-03): 인쇄 얼굴 판의 2대 기준 총액 2,417,296원에서 1,318,803원으로 줄었다. 그 판의 수량은 로봇 1대 필요량에 2대 기준 여분의 절반(올림)을 더한 것이었다.
- 더 앞선 판의 변경(보드 구성, 셀, 자석 크기, 모델 v8~v11 반영)은 LCD 2판 문서 6절에 그대로 있다.

## 7. 금액에 넣지 않은 것

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
