mgm136044/kobi-robot/lcd_face/mass/parts_changed_v7b.csv

part | file (7b판 print/) | body | 6판 solid g | 6판 P1 g | 6판 P2 g | 7판 solid g | 7판 P1 g | 7판 P2 g | 7b판 solid g | 7b판 P1 g | 7b판 P2 g | 7b판 P1/solid | 7b판 P2/solid | 7b판-6판 solid g | 7b판-6판 P1 g | 7b판-6판 P2 g | 7b판-7판 P1 g | 7b판-7판 P2 g | 7b판 support g (P1) | 7판 support g (P1) | 6판 support g (P1) | notes
A_HeadShell (두 반쪽 합) | head/A_HeadShell_L.stl + _R.stl | kobi_head | 280.984 | 248.828 | 253.633 | 231.159 | 200.034 | 204.858 | 237.571 | 206.308 | 211.139 | 0.868 | 0.889 | -43.412 | -42.520 | -42.494 | 6.274 | 6.281 | 519.519 | 516.333 | 504.899 | 안쪽 피부 1.2 -> 0.9 mm, 특징 둘레 5 mm(7판 2 mm)와 이음 둘레 5 mm(7판 3 mm)는 1.2 mm 그대로
Head_frame_LCD | mech/Head_frame_LCD.stl | kobi_head | 32.559 | 25.838 | 28.092 | 29.934 | 24.814 | 26.671 | 30.936 | 25.244 | 27.218 | 0.816 | 0.880 | -1.624 | -0.594 | -0.873 | 0.430 | 0.548 | 36.010 | 36.106 | 36.010 | 가로판 구멍 4개(55 x 2 mm, 팔 구멍 없음). 7판은 66 mm 4개 + 팔 구멍 2개
Pi4_head_bracket | mech/Pi4_head_bracket.stl | kobi_head | 22.236 | 15.557 | 17.413 | 19.687 | 15.316 | 16.743 | 19.687 | 15.316 | 16.743 | 0.778 | 0.850 | -2.549 | -0.242 | -0.670 | 0.000 | 0.000 | 1.008 | 1.008 | 0.094 | 쟁반 밑면 구멍(7판과 같음)
LCD_mount | mech/LCD_mount.stl | kobi_head | 17.362 | 15.893 | 16.126 | 14.970 | 13.625 | 13.858 | 14.970 | 13.625 | 13.858 | 0.910 | 0.926 | -2.391 | -2.268 | -2.268 | 0.000 | 0.000 | 29.340 | 29.340 | 27.926 | 가운데 판에 창 3개(7판과 같음)
camera_mount_coupon (시험 조각, 로봇 질량 아님) | test_coupons/camera_mount_coupon.stl | - | 4.117 | 3.826 | 3.888 | 3.895 | 3.624 | 3.686 | 4.047 | 3.765 | 3.827 | 0.930 | 0.946 | -0.069 | -0.061 | -0.061 | 0.141 | 0.141 | 1.356 | 1.364 | 1.349 | 시험 조각. 6판·7판 파일은 7판 슬라이스 때 같은 설정으로 잘랐음
mic_mount_coupon (시험 조각, 로봇 질량 아님) | test_coupons/mic_mount_coupon.stl | - | 2.756 | 2.607 | 2.605 | 2.649 | 2.512 | 2.510 | 2.739 | 2.596 | 2.593 | 0.948 | 0.947 | -0.016 | -0.011 | -0.011 | 0.083 | 0.083 | 0.823 | 0.801 | 0.797 | 시험 조각. 6판·7판 파일은 7판 슬라이스 때 같은 설정으로 잘랐음
