mgm136044/kobi-robot/lcd_face/bom/사진/코비_BOM_LCD_v12_표_20261104.png

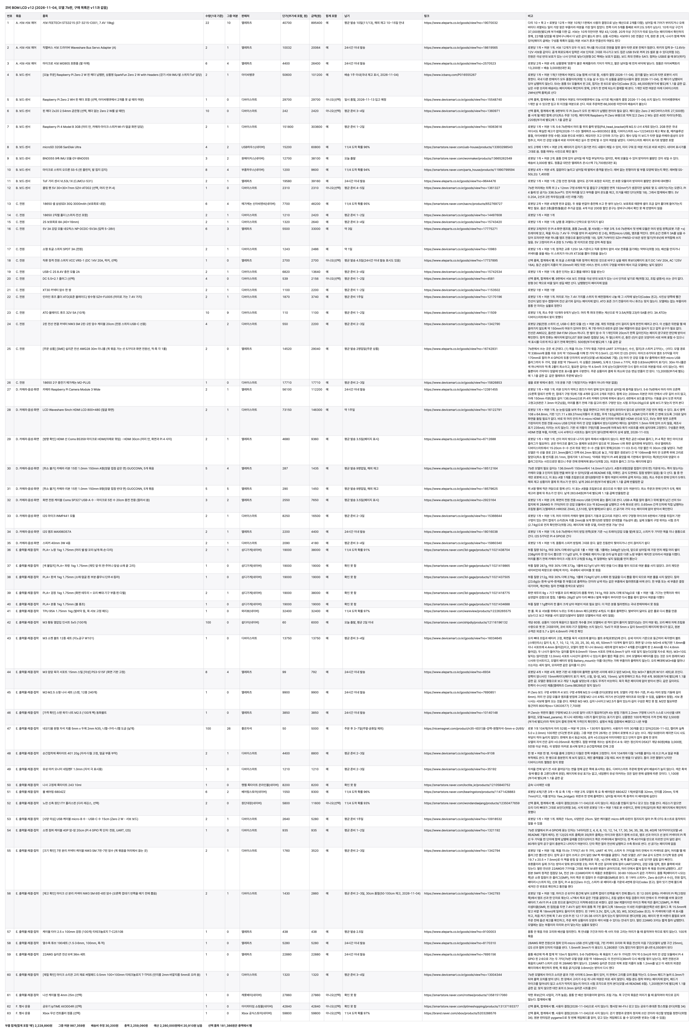
lcd_face/bom/사진/코비_BOM_LCD_v12_표_20261104.png
