mgm136044/kobi-robot/lcd_face/print/head/A_HeadShell_whole.stl

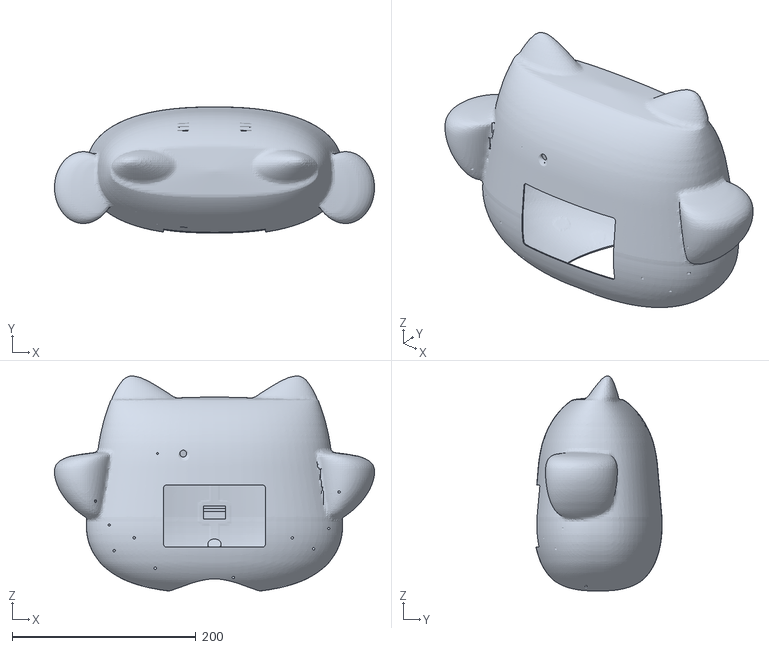
[picture p18: CAD file, 2026-11-03]
lcd_face/print/head/A_HeadShell_whole.stl
348.1 x 137.1 x 233.9
