mgm136044/kobi-robot/lcd_face/mujoco/assets/kobi_Pi4_head_bracket.stl

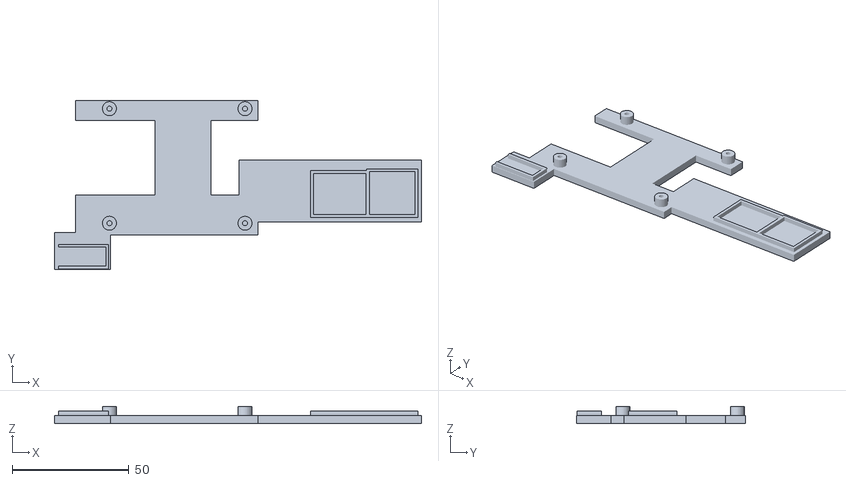
[picture p19: CAD file, 2026-11-03]
lcd_face/mujoco/assets/kobi_Pi4_head_bracket.stl
157.0 x 72.3 x 7.40
