mgm136044/kobi-robot/lcd_face/print/body/Arm_L_mitten.stl

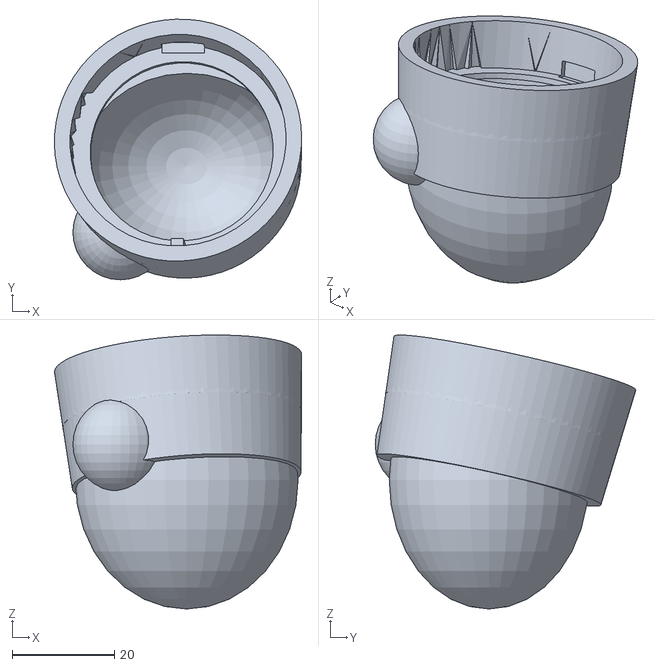
[picture p20: CAD file, 2026-11-03]
lcd_face/print/body/Arm_L_mitten.stl
48.5 x 51.1 x 53.7
