mgm136044/kobi-robot/lcd_face/print/extra/kori_roll_to_pitch_left_print_mm.stl

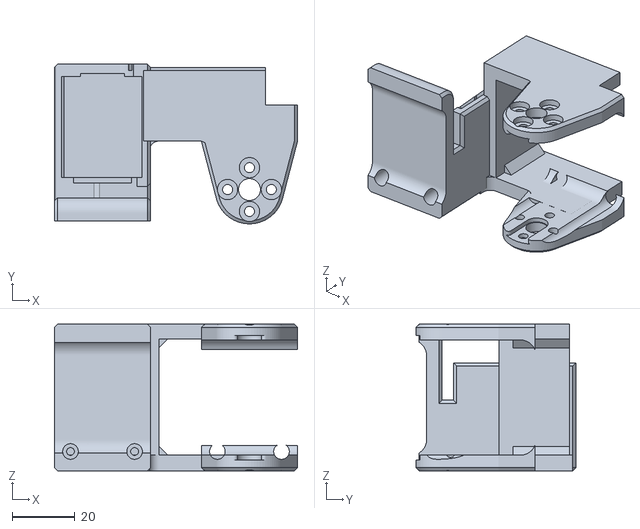
[picture p21: CAD file, 2026-11-03]
lcd_face/print/extra/kori_roll_to_pitch_left_print_mm.stl
77.7 x 51.1 x 46.9
