mgm136044/kobi-robot/lcd_face/print/face/Face_LCD_bezel_R.stl

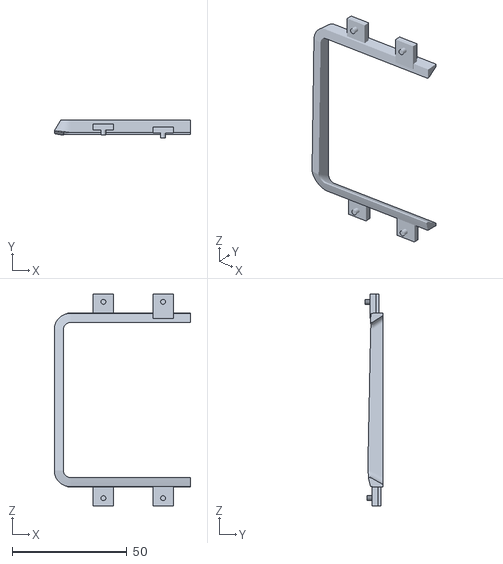
[picture p22: CAD file, 2026-11-03]
lcd_face/print/face/Face_LCD_bezel_R.stl
59.3 x 7.73 x 92.2
