mgm136044/kobi-robot/lcd_face/print/head/A_HeadShell_L.stl

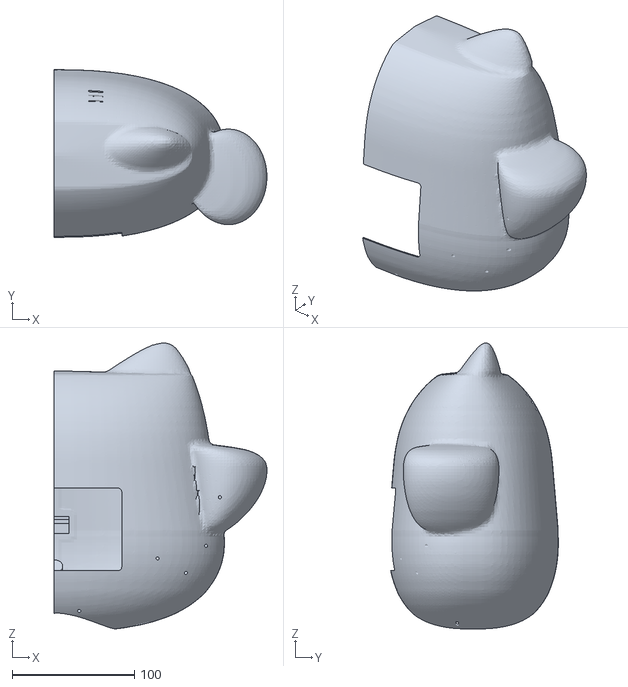
[picture p23: CAD file, 2026-11-03]
lcd_face/print/head/A_HeadShell_L.stl
174.0 x 137.1 x 233.9
