mgm136044/kobi-robot/lcd_face/print/mech/Head_frame_LCD.stl

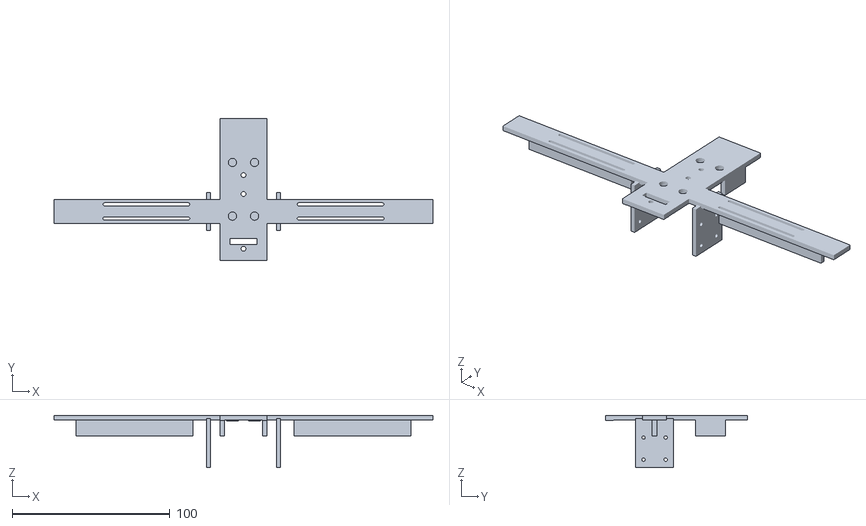
[picture p24: CAD file, 2026-11-03]
lcd_face/print/mech/Head_frame_LCD.stl
240.0 x 89.7 x 33.0
