mgm136044/kobi-robot/lcd_face/print/test_coupons/camera_mount_coupon.stl

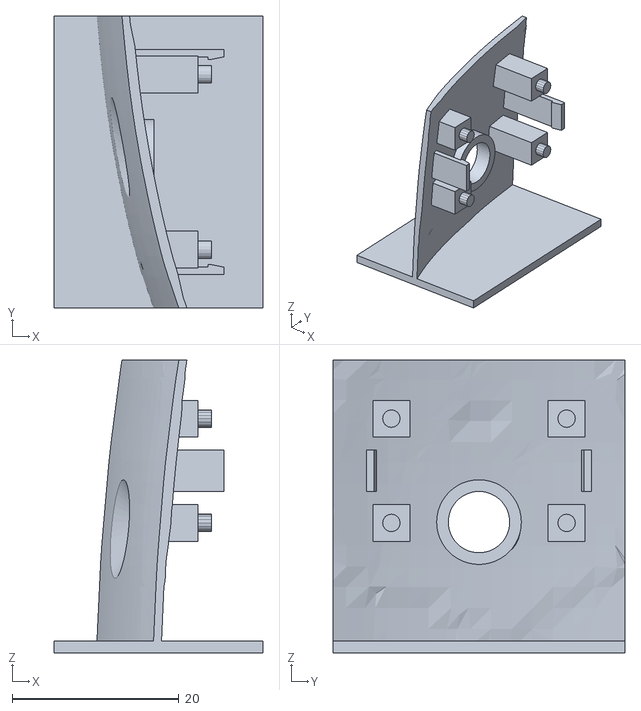
[picture p25: CAD file, 2026-11-03]
lcd_face/print/test_coupons/camera_mount_coupon.stl
25.0 x 35.0 x 35.1
