mgm136044/kobi-robot/printed_face/mujoco/assets/kobi_Tail_1.stl

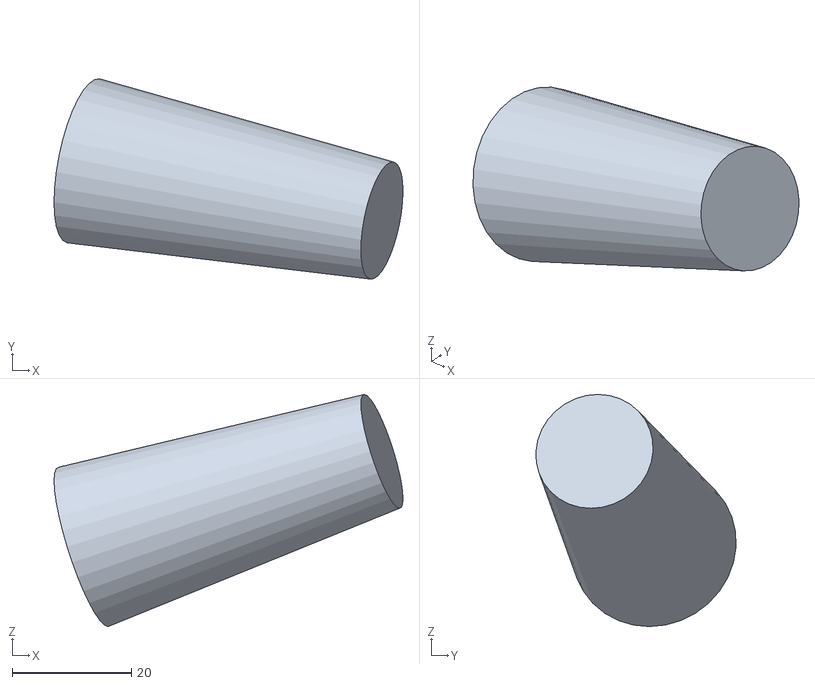
[picture p26: CAD file, 2026-11-03]
printed_face/mujoco/assets/kobi_Tail_1.stl
58.5 x 33.5 x 38.9
