mgm136044/kobi-robot/printed_face/print/body/Jacket_front.stl

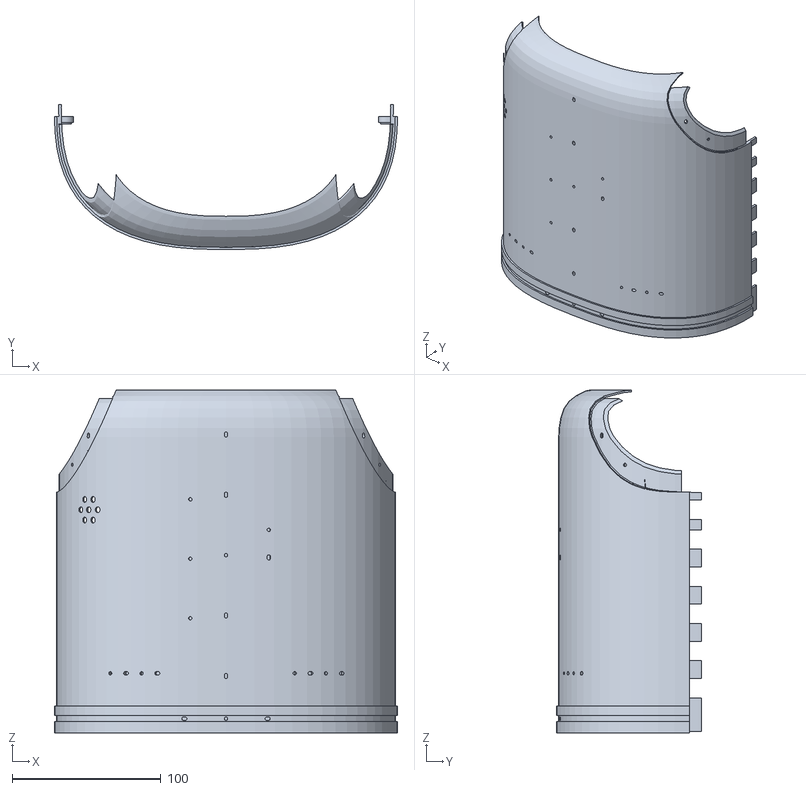
[picture p27: CAD file, 2026-11-03]
printed_face/print/body/Jacket_front.stl
230.7 x 97.6 x 230.4
