mgm136044/kobi-robot/printed_face/print/face/Face_Mouth.stl

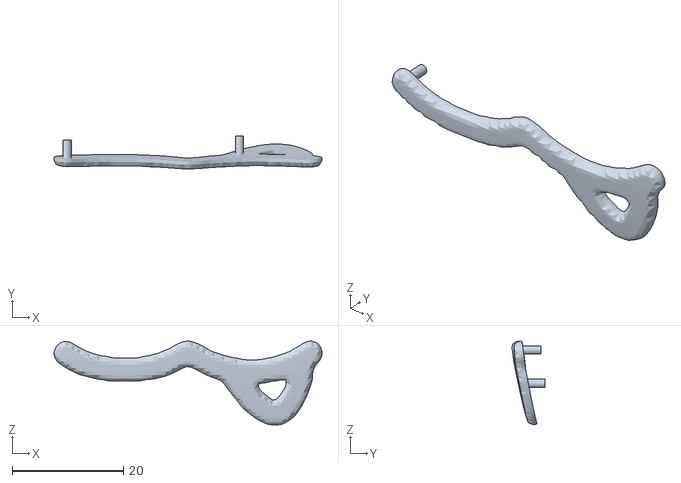
[picture p28: CAD file, 2026-11-03]
printed_face/print/face/Face_Mouth.stl
48.2 x 5.96 x 15.1
