mgm136044/kobi-robot/printed_face/print/fit_coupon.stl

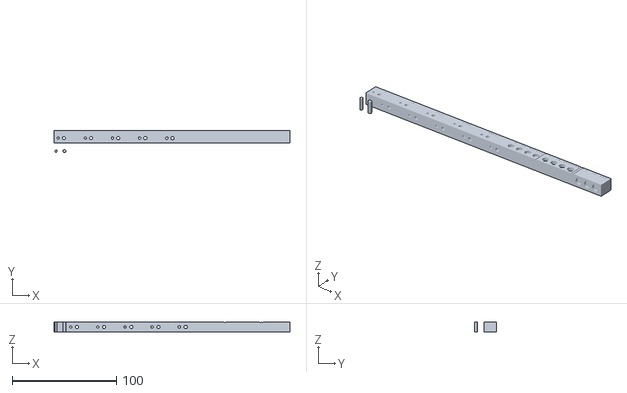
[picture p29: CAD file, 2026-11-03]
printed_face/print/fit_coupon.stl
226.0 x 21.5 x 10.0
