mgm136044/kobi-robot/printed_face/print/mech/Head_pad_left.stl

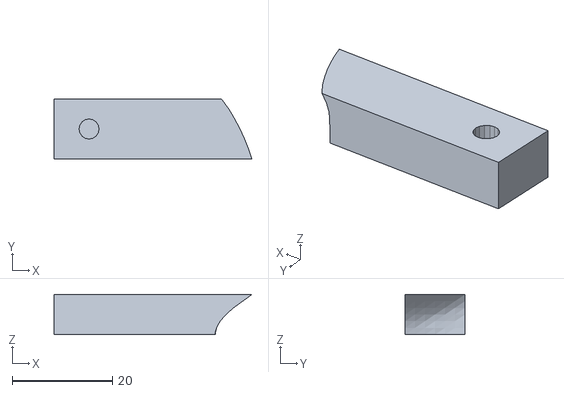
[picture p30: CAD file, 2026-11-03]
printed_face/print/mech/Head_pad_left.stl
39.5 x 12.0 x 8.00
