mgm136044/kobi-robot/printed_face/urdf/assets/kobi_Face_Fang.stl

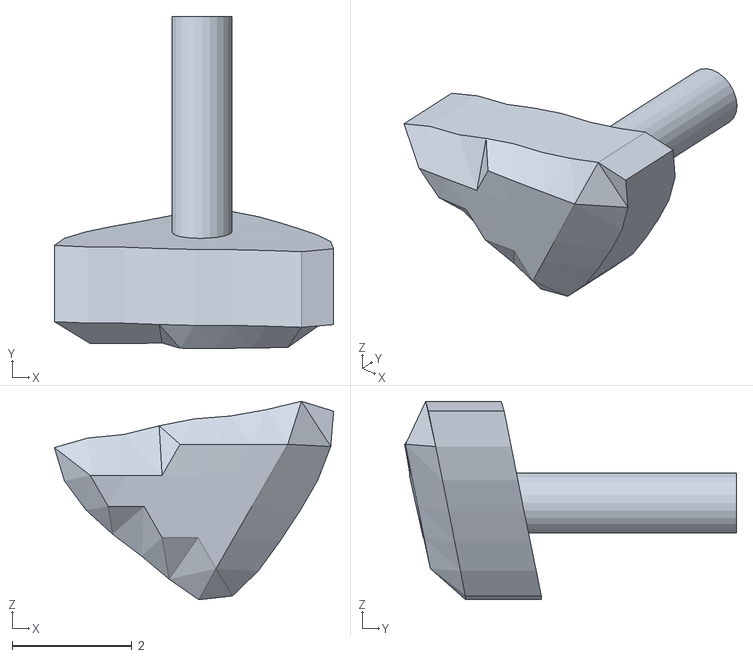
[picture p31: CAD file, 2026-11-03]
printed_face/urdf/assets/kobi_Face_Fang.stl
4.67 x 5.55 x 3.32
