mgm136044/kobi-robot/lcd_face/print/body/Neck.stl

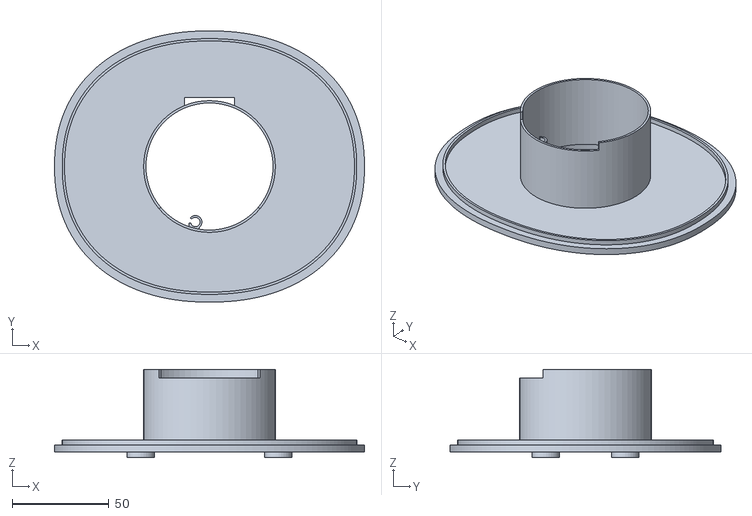
[picture p32: CAD file, 2026-11-03]
lcd_face/print/body/Neck.stl
160.0 x 140.0 x 45.5
