mgm136044/kobi-robot/lcd_face/print/mech/LCD_mount.stl

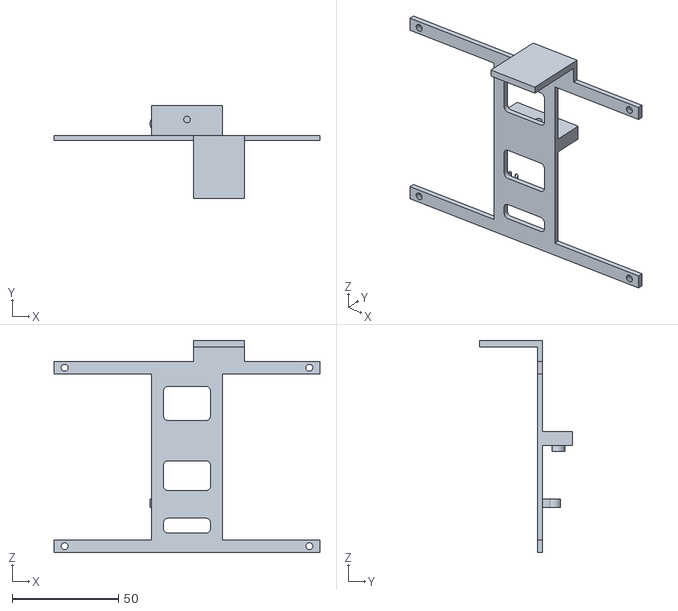
[picture p34: CAD file, 2026-11-03]
lcd_face/print/mech/LCD_mount.stl
125.1 x 43.6 x 99.7
