mgm136044/kobi-robot/lcd_face/print/test_coupons/mic_mount_coupon.stl

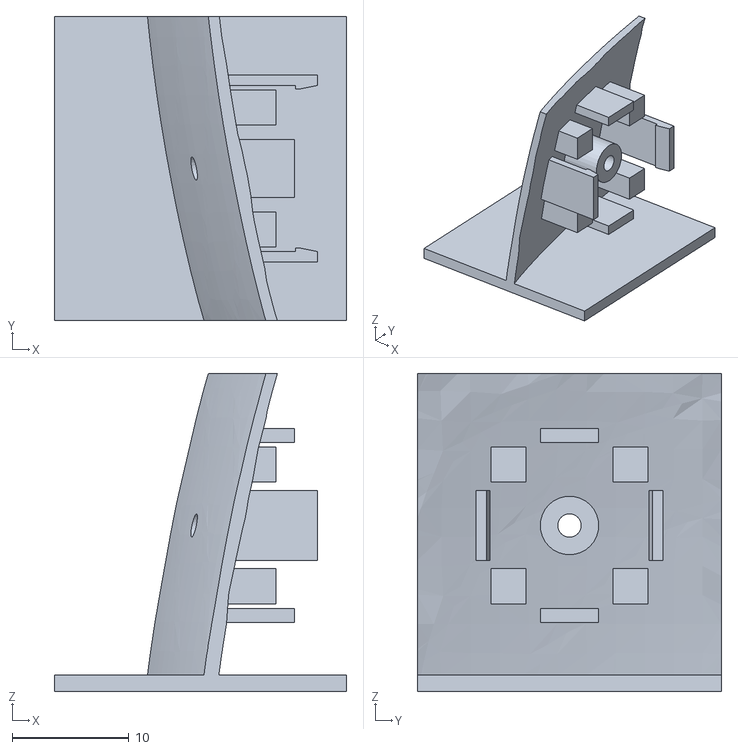
[picture p35: CAD file, 2026-11-03]
lcd_face/print/test_coupons/mic_mount_coupon.stl
25.0 x 26.0 x 27.2
