mgm136044/kobi-robot/printed_face/mujoco/assets/kobi_Jacket_hem_rib.stl

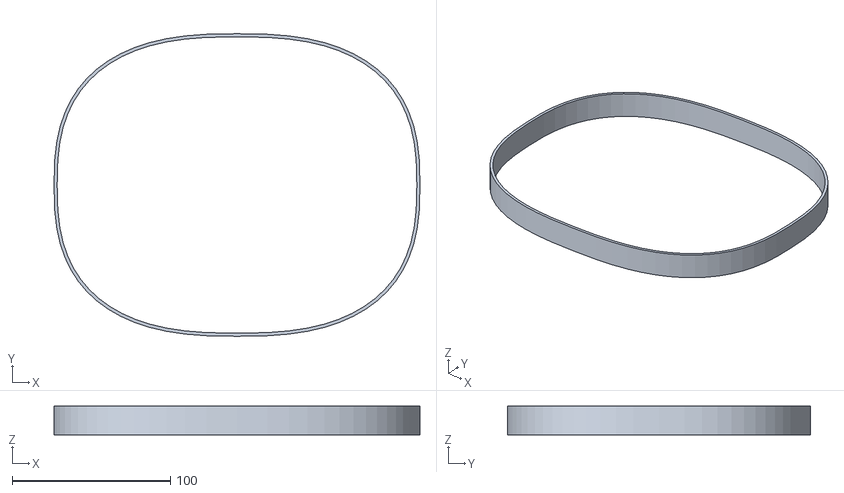
[picture p36: CAD file, 2026-11-03]
printed_face/mujoco/assets/kobi_Jacket_hem_rib.stl
231.0 x 191.0 x 18.0
