mgm136044/kobi-robot/printed_face/print/face/Face_Eye_L.stl

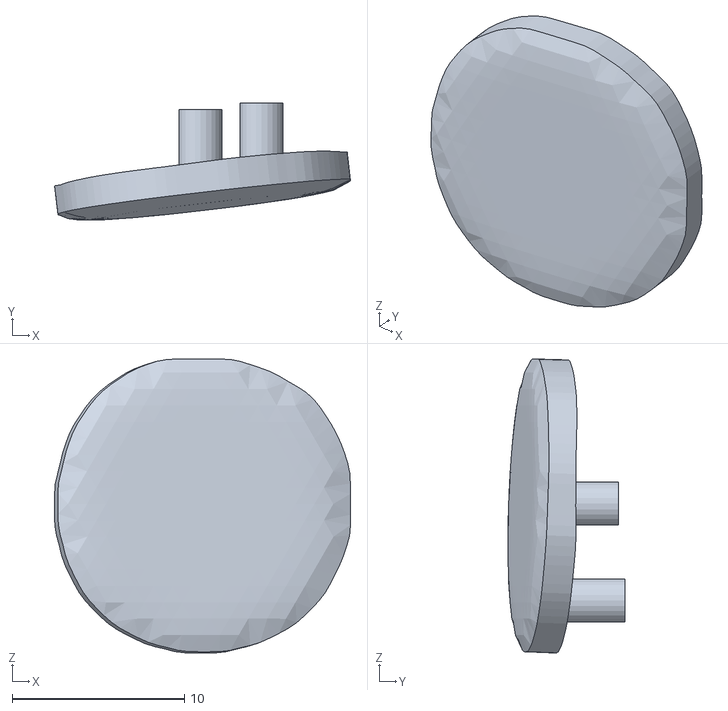
[picture p37: CAD file, 2026-11-03]
printed_face/print/face/Face_Eye_L.stl
17.2 x 6.81 x 17.1
