mgm136044/kobi-robot/printed_face/print/mech/Pi4_bracket.stl

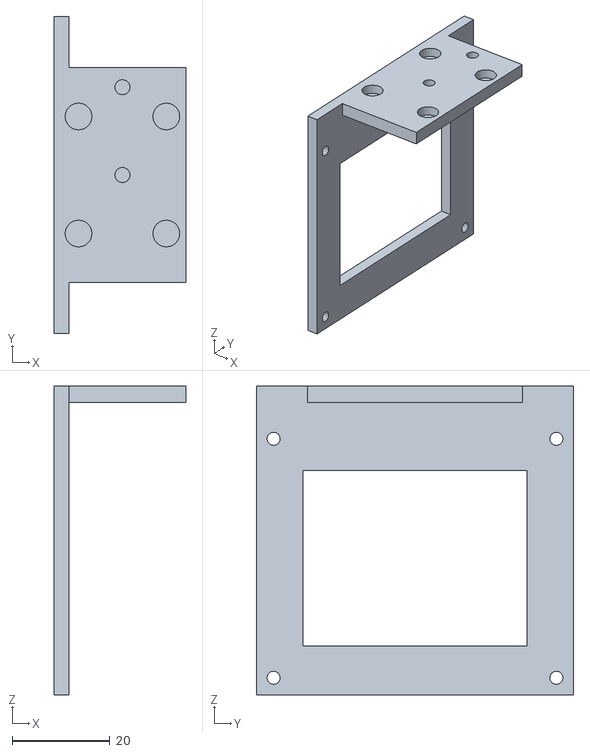
[picture p38: CAD file, 2026-11-03]
printed_face/print/mech/Pi4_bracket.stl
27.0 x 65.0 x 63.3
