mgm136044/kobi-robot/printed_face/urdf/assets/kobi_Face_Eye_R.stl

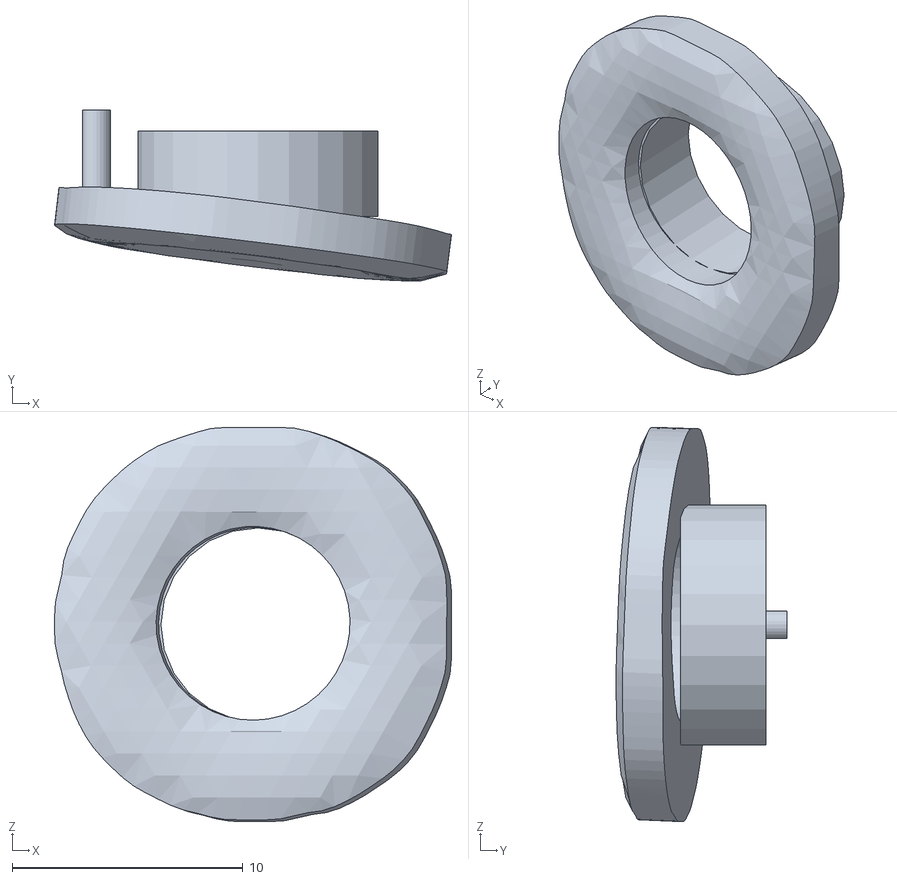
[picture p39: CAD file, 2026-11-03]
printed_face/urdf/assets/kobi_Face_Eye_R.stl
17.2 x 7.41 x 17.1
