mgm136044/kobi-robot/printed_face/mujoco/assets/kobi_Jacket_body.stl

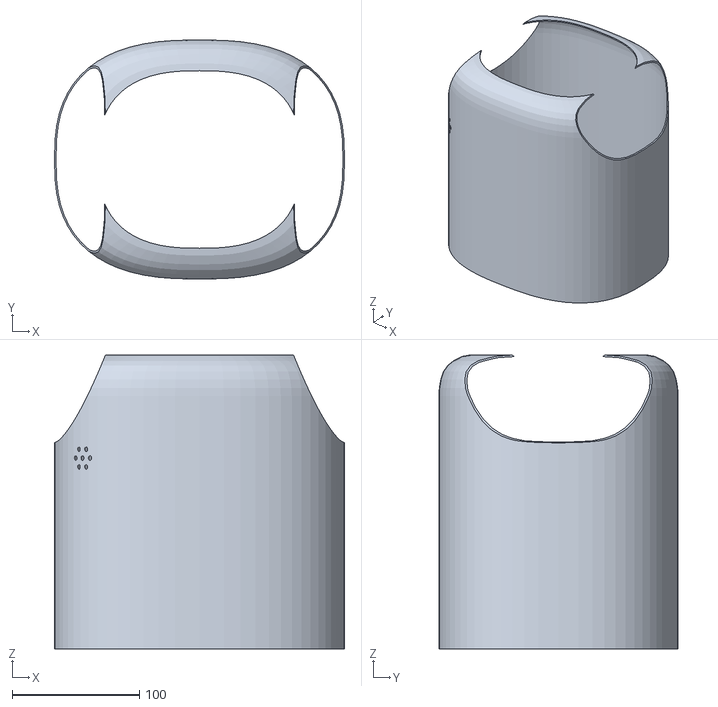
[picture p40: CAD file, 2026-11-03]
printed_face/mujoco/assets/kobi_Jacket_body.stl
228.0 x 188.0 x 231.0
