mgm136044/kobi-robot/printed_face/print/body/Jacket_raglan_L.stl

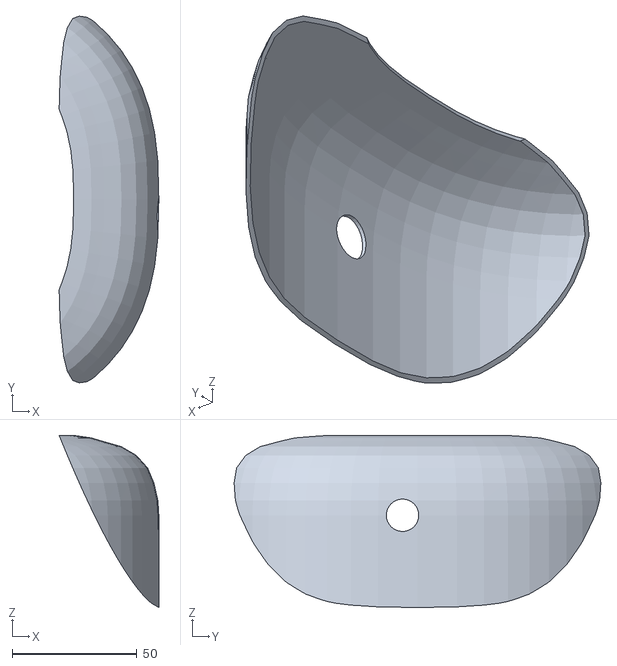
[picture p41: CAD file, 2026-11-03]
printed_face/print/body/Jacket_raglan_L.stl
40.0 x 147.1 x 69.0
