mgm136044/kobi-robot/printed_face/print/face/Face_WhiteFace_R.stl

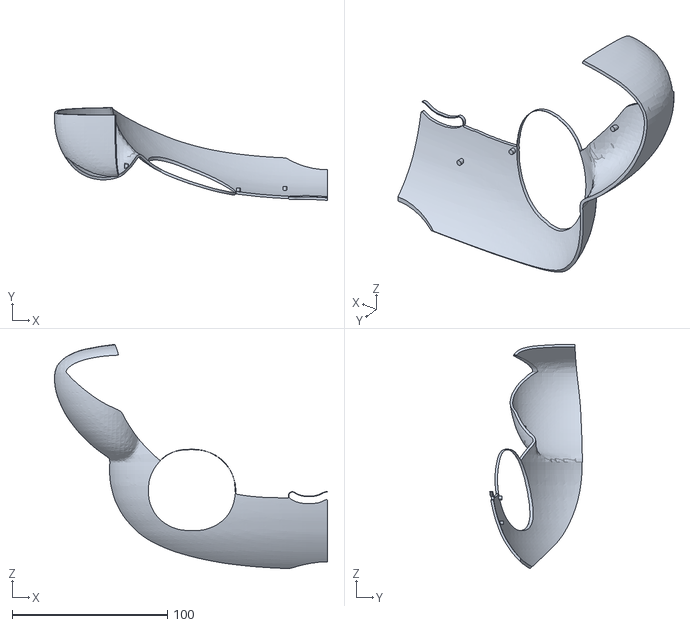
[picture p42: CAD file, 2026-11-03]
printed_face/print/face/Face_WhiteFace_R.stl
175.8 x 59.6 x 144.4
