mgm136044/kobi-robot/printed_face/print/mech/Jacket_rib_back_R.stl

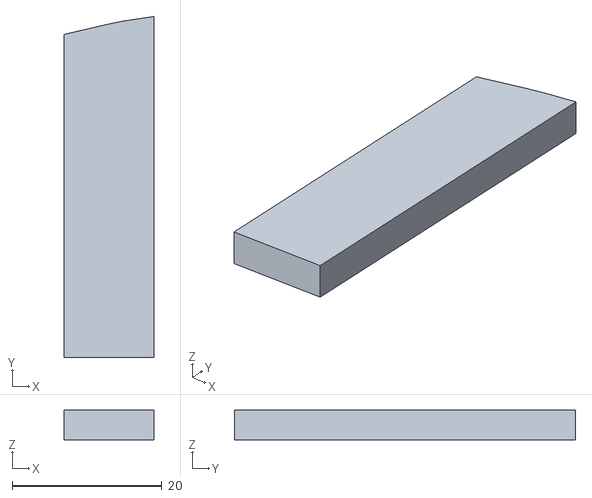
[picture p43: CAD file, 2026-11-03]
printed_face/print/mech/Jacket_rib_back_R.stl
12.0 x 45.6 x 4.00
