mgm136044/kobi-robot/lcd_face/mujoco/assets/kobi_Face_WhiteFace.stl

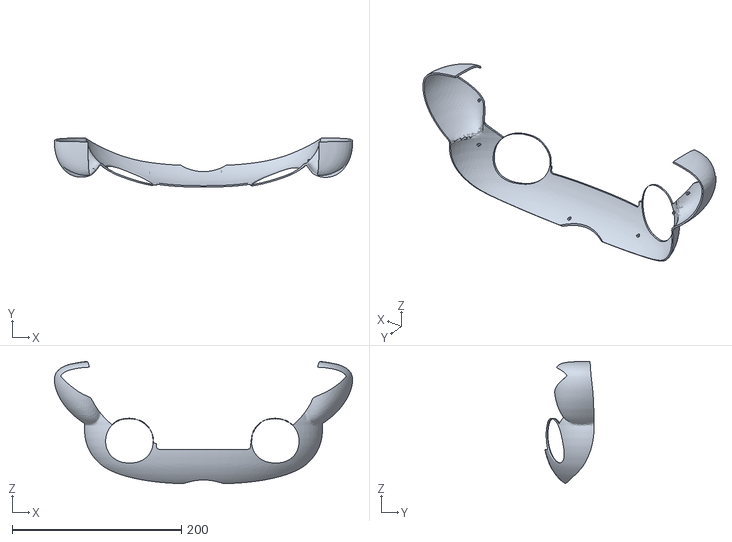
[picture p44: CAD file, 2026-11-03]
lcd_face/mujoco/assets/kobi_Face_WhiteFace.stl
351.7 x 58.2 x 144.4
