mgm136044/kobi-robot/lcd_face/print/face/Face_WhiteFace_L.stl

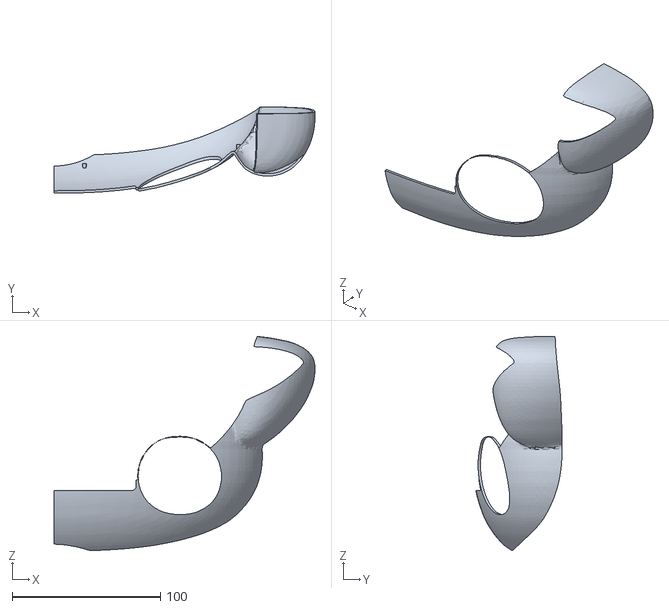
[picture p45: CAD file, 2026-11-03]
lcd_face/print/face/Face_WhiteFace_L.stl
175.8 x 58.2 x 144.4
