mgm136044/kobi-robot/lcd_face/print/mech/LCD_mount_pin.stl

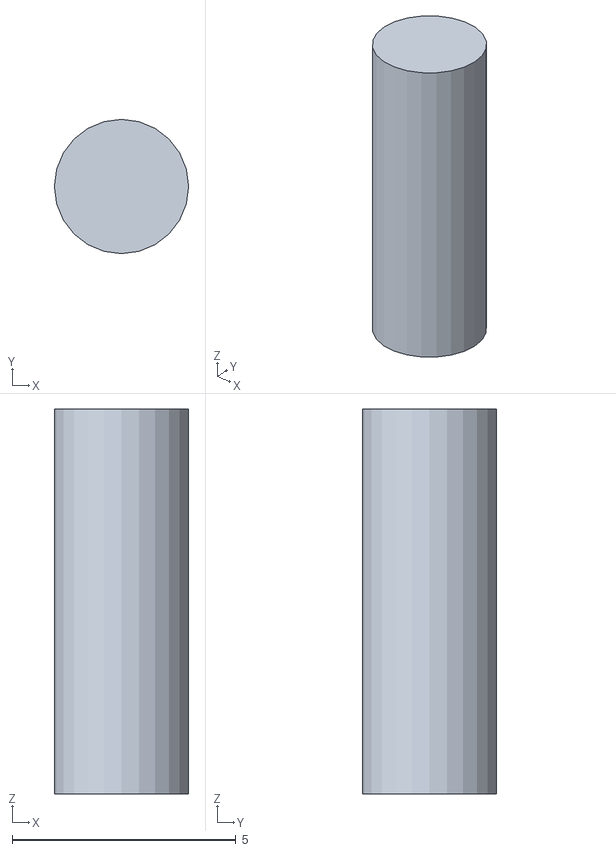
[picture p46: CAD file, 2026-11-03]
lcd_face/print/mech/LCD_mount_pin.stl
3.00 x 3.00 x 8.60
