mgm136044/kobi-robot/printed_face/mujoco/assets/kobi_Root_pin_wing_R.stl

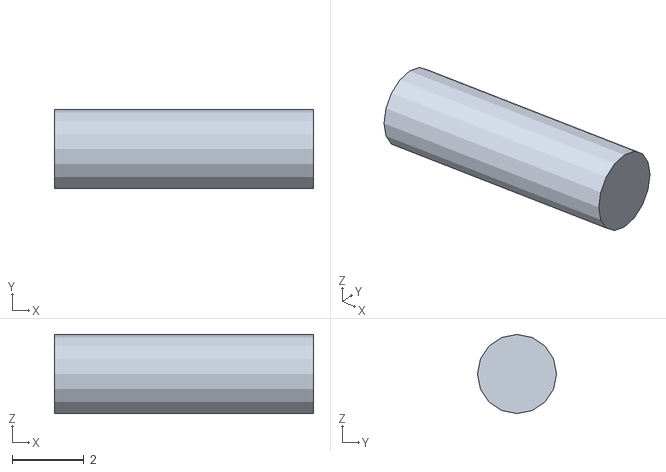
[picture p47: CAD file, 2026-11-03]
printed_face/mujoco/assets/kobi_Root_pin_wing_R.stl
7.20 x 2.20 x 2.20
