mgm136044/kobi-robot/printed_face/print/body/Collar_rib.stl

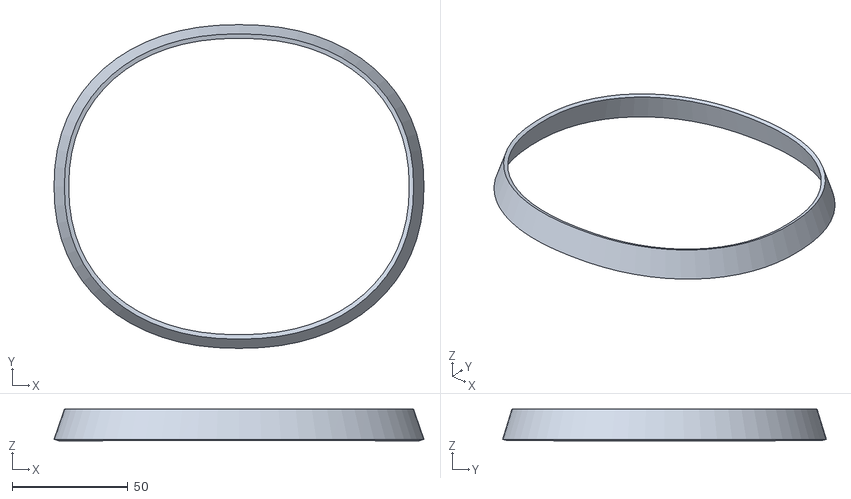
[picture p48: CAD file, 2026-11-03]
printed_face/print/body/Collar_rib.stl
160.0 x 140.0 x 13.7
