mgm136044/kobi-robot/printed_face/print/mech/Jacket_rib_front_R.stl

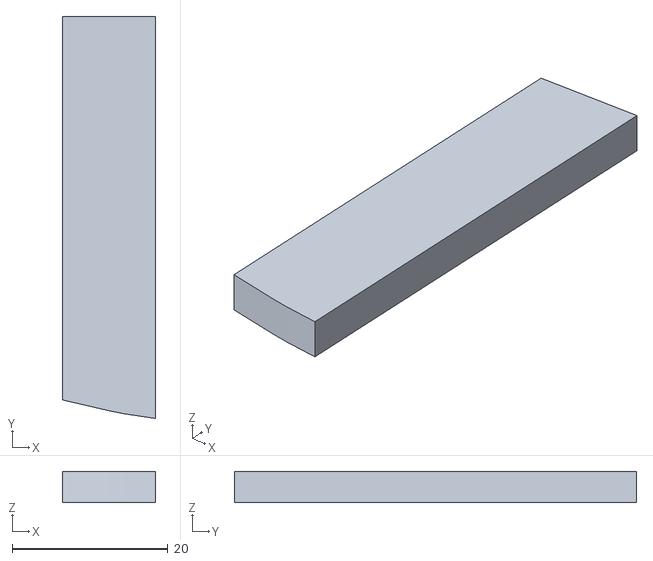
[picture p49: CAD file, 2026-11-03]
printed_face/print/mech/Jacket_rib_front_R.stl
12.0 x 51.6 x 4.00
