mgm136044/kobi-robot/printed_face/urdf/assets/kobi_Face_Mouth_R.stl

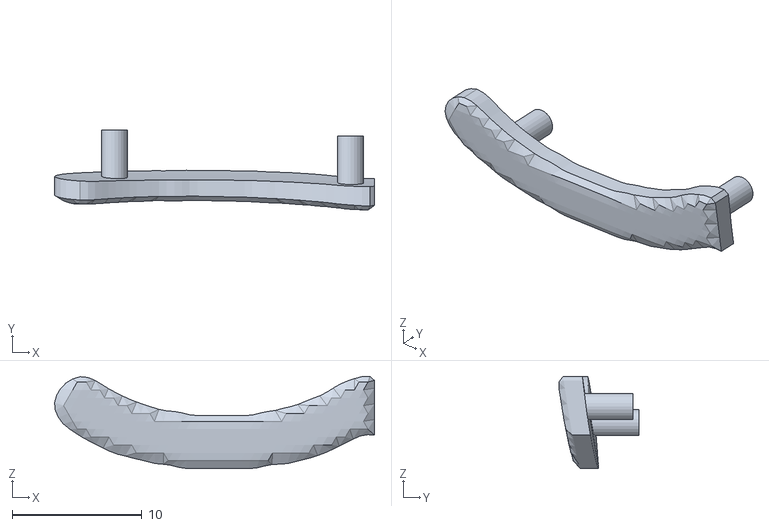
[picture p50: CAD file, 2026-11-03]
printed_face/urdf/assets/kobi_Face_Mouth_R.stl
24.6 x 6.18 x 7.10
