mgm136044/kobi-robot/lcd_face/print/mech/Top_plate.stl

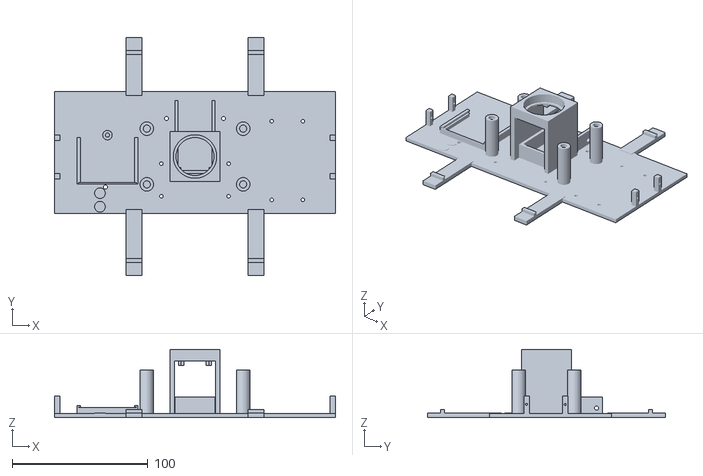
[picture p51: CAD file, 2026-11-03]
lcd_face/print/mech/Top_plate.stl
207.0 x 175.0 x 50.2
