mgm136044/kobi-robot/printed_face/print/body/Jacket_pocket_R1.stl

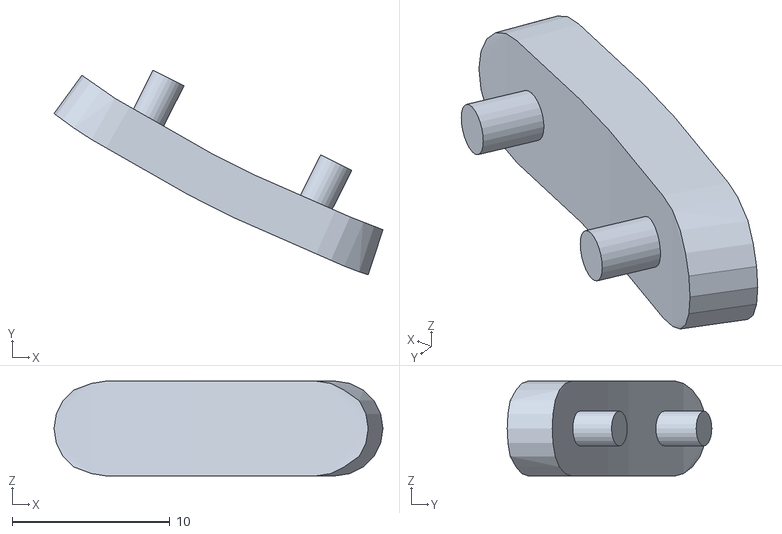
[picture p52: CAD file, 2026-11-03]
printed_face/print/body/Jacket_pocket_R1.stl
20.8 x 13.0 x 6.00
