mgm136044/kobi-robot/printed_face/print/face/Face_Brow_L.stl

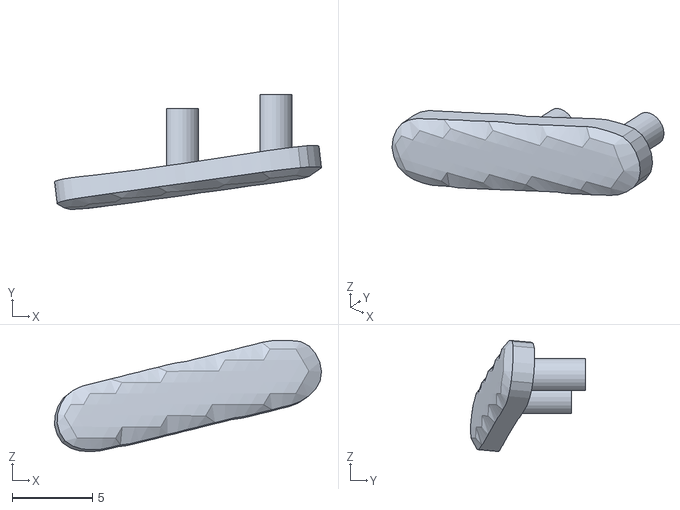
[picture p53: CAD file, 2026-11-03]
printed_face/print/face/Face_Brow_L.stl
16.6 x 7.16 x 6.91
