mgm136044/kobi-robot/printed_face/print/mech/Service_bracket.stl

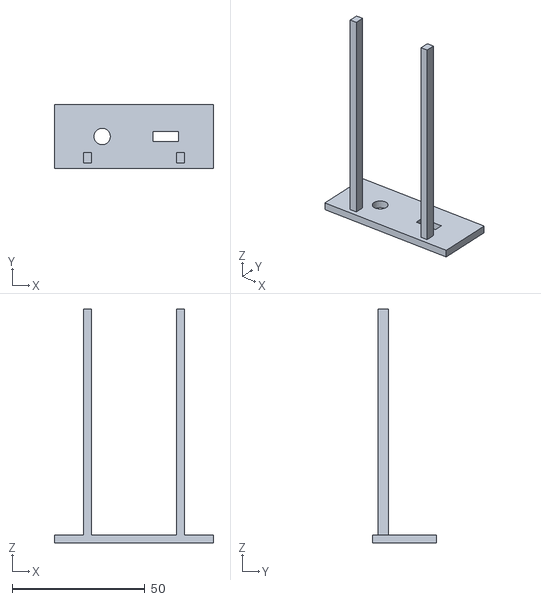
[picture p54: CAD file, 2026-11-03]
printed_face/print/mech/Service_bracket.stl
60.0 x 24.0 x 88.2
