mgm136044/kobi-robot/printed_face/urdf/assets/kobi_Face_Mouth_L.stl

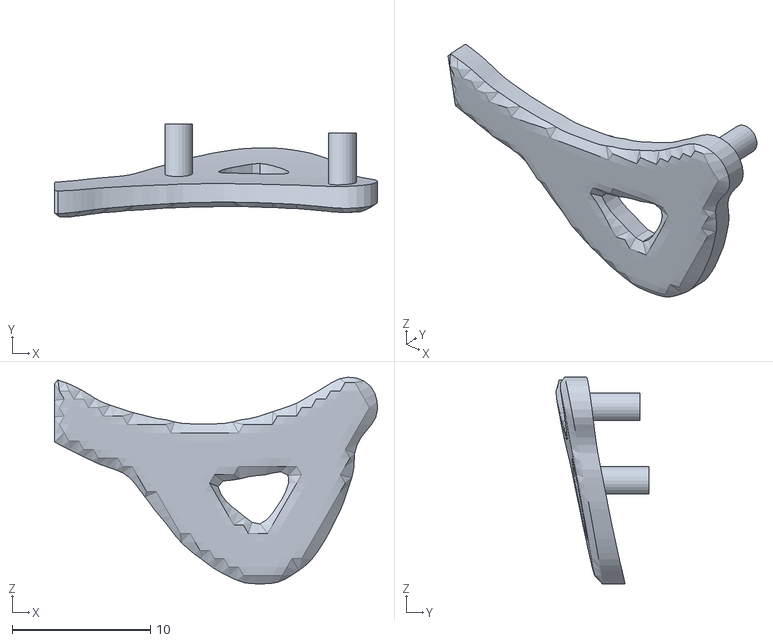
[picture p55: CAD file, 2026-11-03]
printed_face/urdf/assets/kobi_Face_Mouth_L.stl
23.3 x 6.73 x 14.9
