mgm136044/kobi-robot/lcd_face/mujoco/assets/kobi_Pi4_head.stl

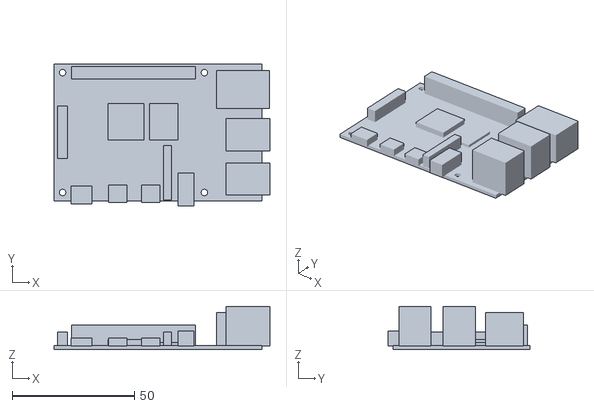
[picture p56: CAD file, 2026-11-03]
lcd_face/mujoco/assets/kobi_Pi4_head.stl
88.3 x 58.0 x 17.6
