mgm136044/kobi-robot/lcd_face/print/face/Face_LCD_bezel.stl

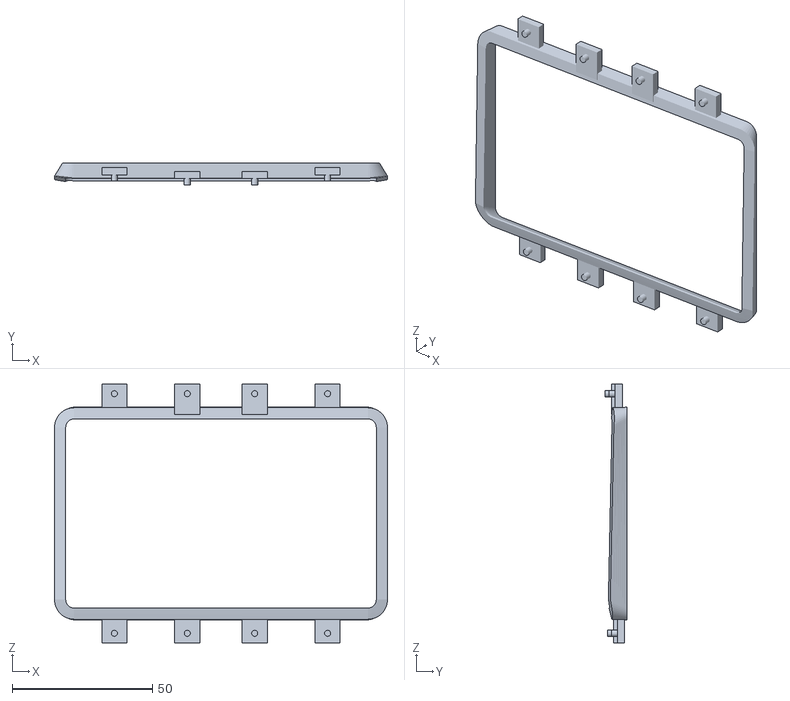
[picture p57: CAD file, 2026-11-03]
lcd_face/print/face/Face_LCD_bezel.stl
118.7 x 7.73 x 92.2
