mgm136044/kobi-robot/lcd_face/print/mech/Neck_gap_shield.stl

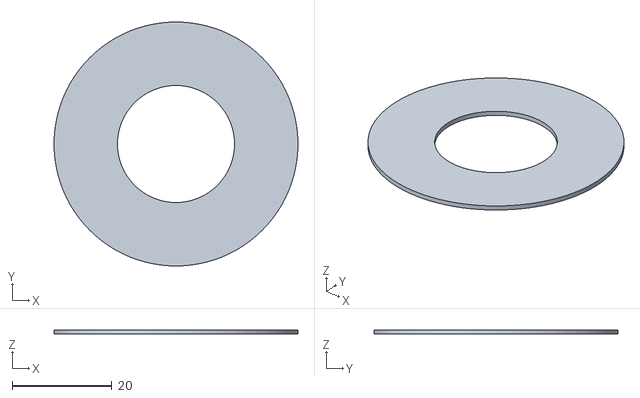
[picture p58: CAD file, 2026-11-03]
lcd_face/print/mech/Neck_gap_shield.stl
49.0 x 49.0 x 0.9
