mgm136044/kobi-robot/printed_face/print/body/Jacket_pocket_L0.stl

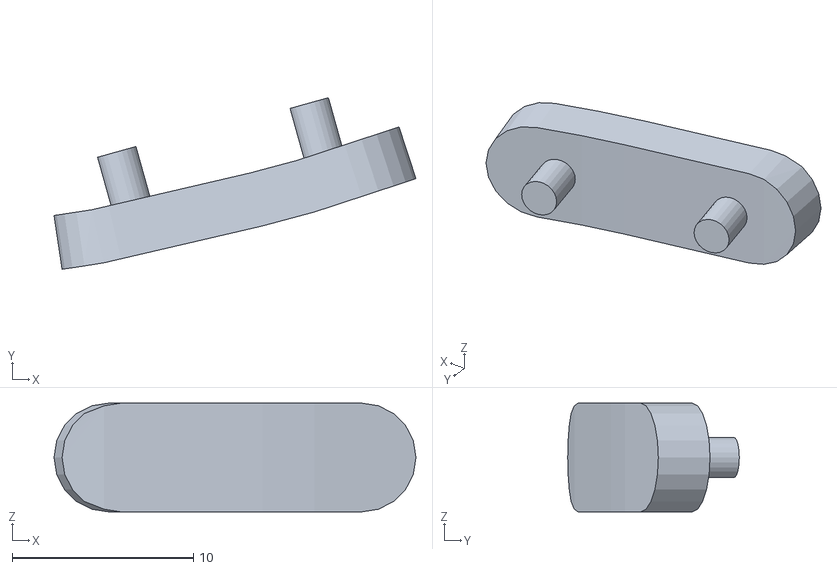
[picture p59: CAD file, 2026-11-03]
printed_face/print/body/Jacket_pocket_L0.stl
20.0 x 9.47 x 6.00
