mgm136044/kobi-robot/printed_face/print/mech/Head_pad_back.stl

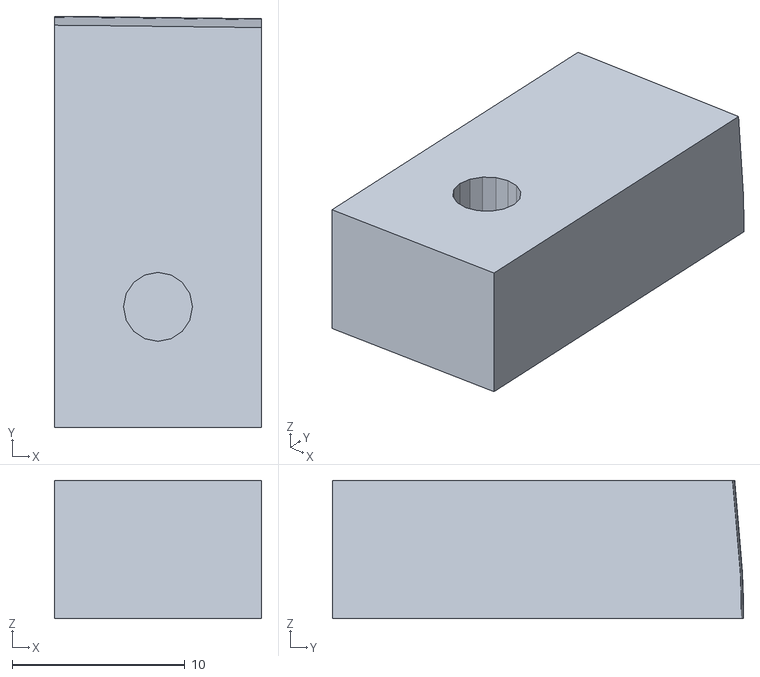
[picture p60: CAD file, 2026-11-03]
printed_face/print/mech/Head_pad_back.stl
12.0 x 23.8 x 8.00
