mgm136044/kobi-robot/printed_face/urdf/assets/kobi_Camera_lens.stl

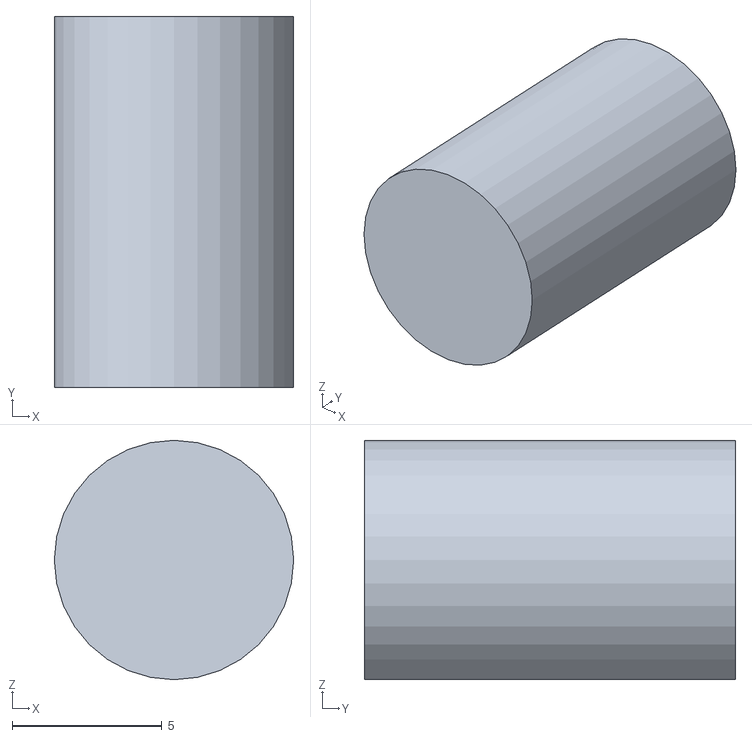
[picture p61: CAD file, 2026-11-03]
printed_face/urdf/assets/kobi_Camera_lens.stl
8.00 x 12.4 x 8.00
