mgm136044/kobi-robot/lcd_face/mujoco/assets/kobi_LCD_module.stl

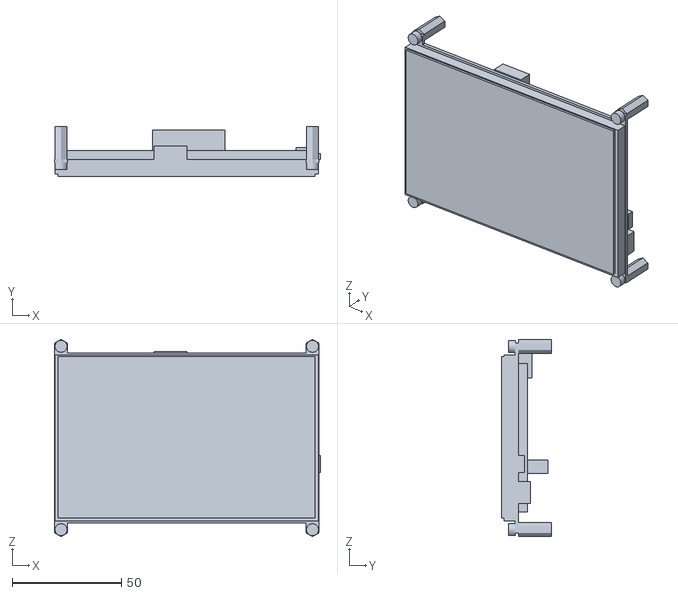
[picture p62: CAD file, 2026-11-03]
lcd_face/mujoco/assets/kobi_LCD_module.stl
121.8 x 22.8 x 90.3
