mgm136044/kobi-robot/printed_face/mujoco/assets/kobi_Tail_joint_1.stl

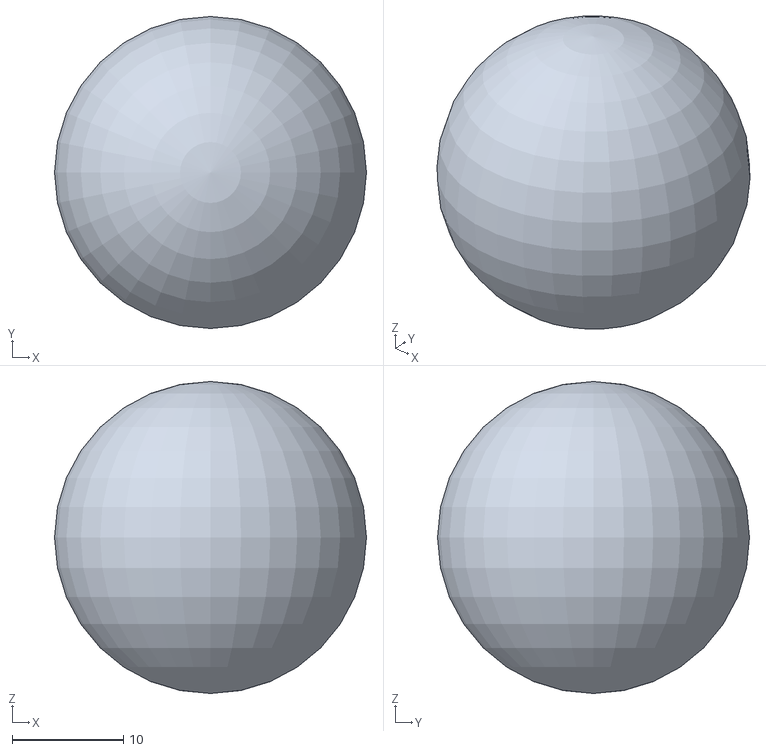
[picture p63: CAD file, 2026-11-03]
printed_face/mujoco/assets/kobi_Tail_joint_1.stl
28.0 x 28.0 x 28.0
