mgm136044/kobi-robot/printed_face/print/body/Arm_R_sleeve.stl

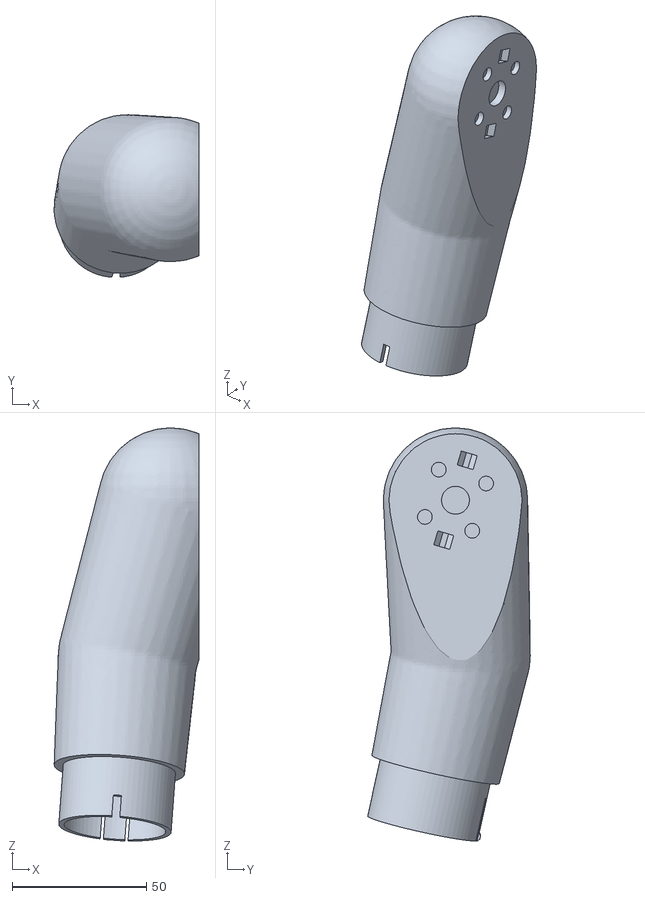
[picture p64: CAD file, 2026-11-03]
printed_face/print/body/Arm_R_sleeve.stl
53.9 x 60.6 x 153.9
