mgm136044/kobi-robot/printed_face/print/face/Face_WhiteFace.stl

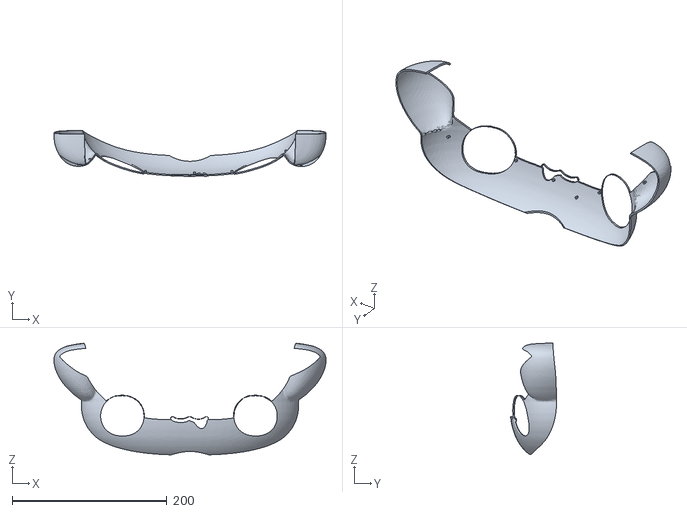
[picture p65: CAD file, 2026-11-03]
printed_face/print/face/Face_WhiteFace.stl
351.7 x 59.6 x 144.4
