mgm136044/kobi-robot/printed_face/print/mech/Yaw_lock_pin.stl

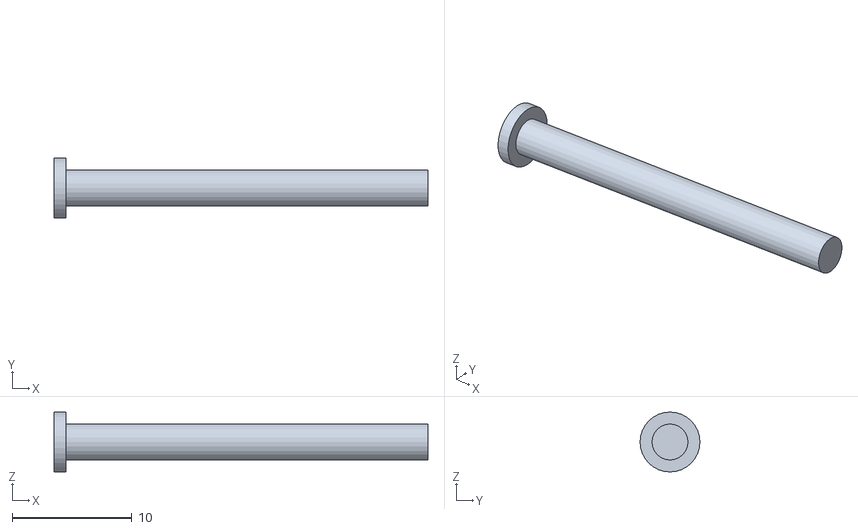
[picture p66: CAD file, 2026-11-03]
printed_face/print/mech/Yaw_lock_pin.stl
31.2 x 5.00 x 5.00
