mgm136044/kobi-robot/printed_face/urdf/assets/kobi_Face_Brow_R.stl

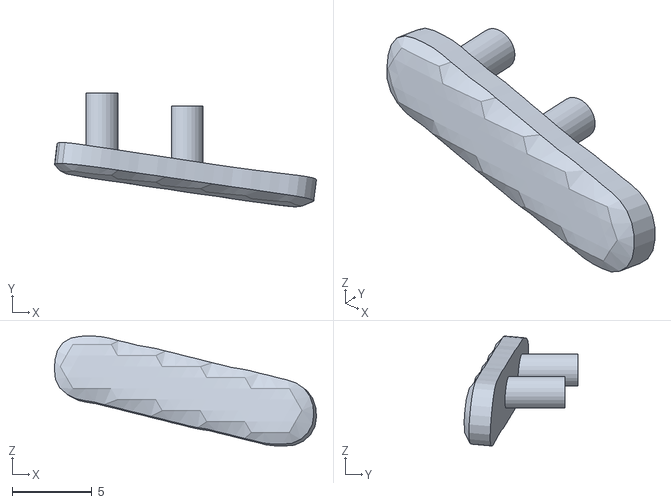
[picture p67: CAD file, 2026-11-03]
printed_face/urdf/assets/kobi_Face_Brow_R.stl
16.5 x 7.16 x 6.91
