mgm136044/kobi-robot/printed_face/print/body/Tail_body.stl

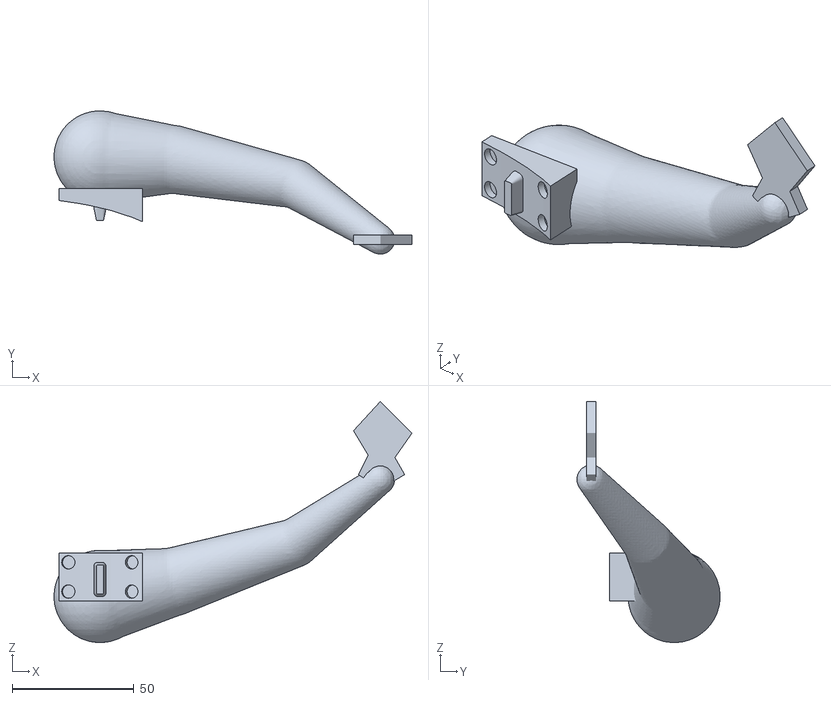
[picture p68: CAD file, 2026-11-03]
printed_face/print/body/Tail_body.stl
146.9 x 58.7 x 98.9
