mgm136044/kobi-robot/printed_face/print/mech/Battery_mount.stl

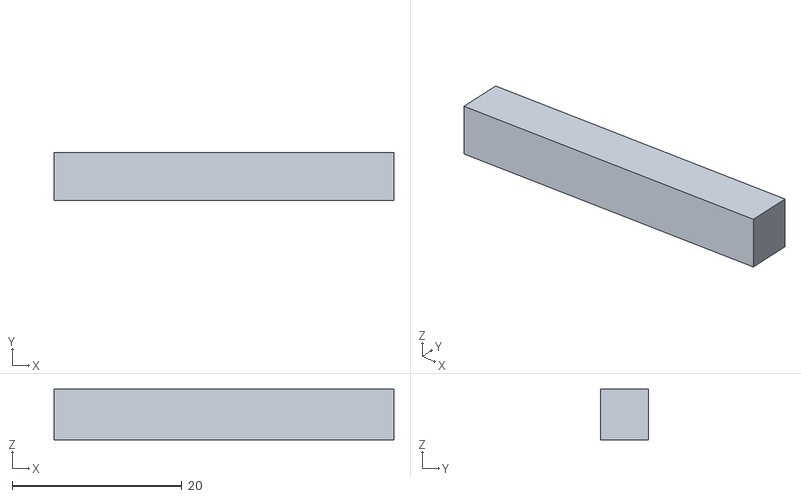
[picture p69: CAD file, 2026-11-03]
printed_face/print/mech/Battery_mount.stl
40.0 x 5.60 x 6.00
