mgm136044/kobi-robot/printed_face/print/mech/Speaker_bracket.stl

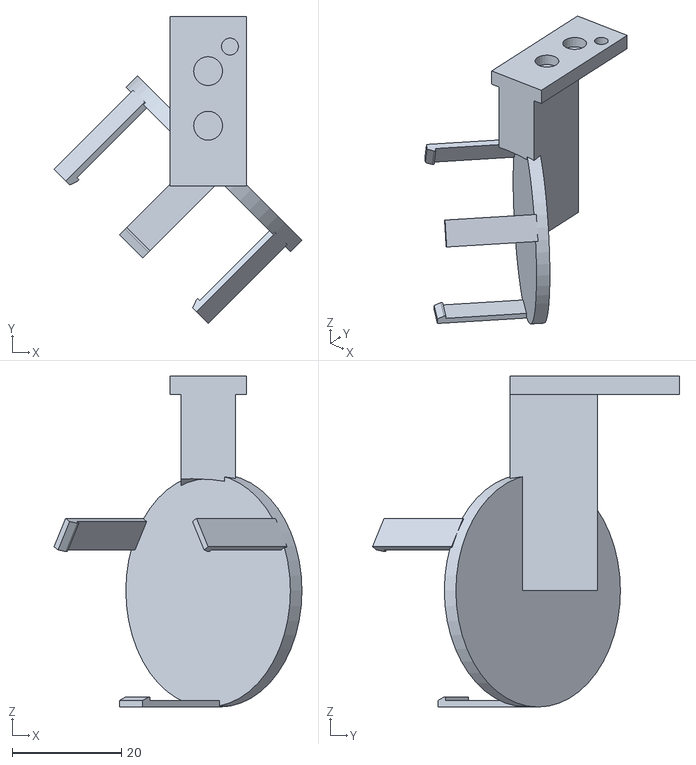
[picture p70: CAD file, 2026-11-03]
printed_face/print/mech/Speaker_bracket.stl
45.4 x 56.2 x 60.6
