mgm136044/kobi-robot/lcd_face/mujoco/assets/kobi_Camera_lens_head.stl

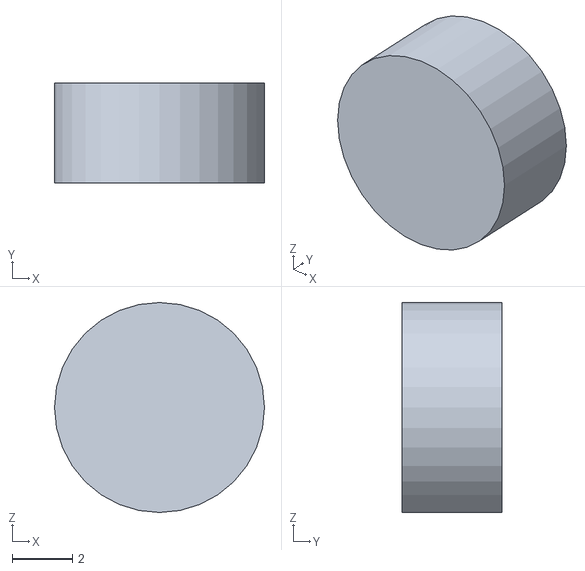
[picture p71: CAD file, 2026-11-03]
lcd_face/mujoco/assets/kobi_Camera_lens_head.stl
6.95 x 3.30 x 6.95
