mgm136044/kobi-robot/lcd_face/mujoco/assets/kobi_Seam_pin_R_slot.stl

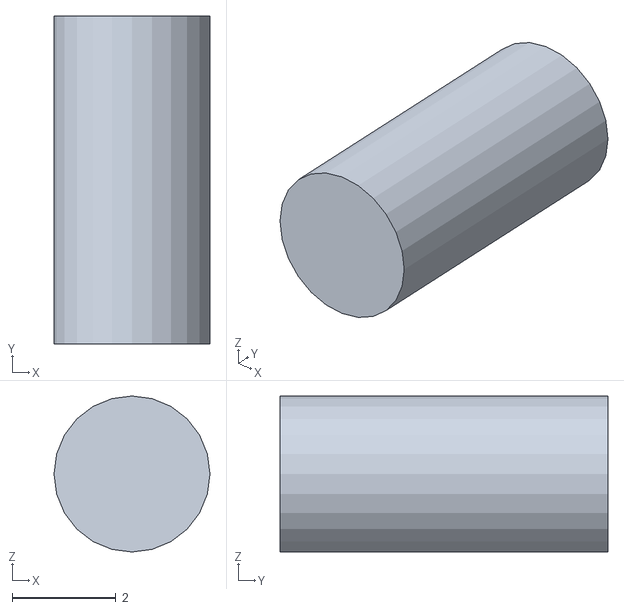
[picture p72: CAD file, 2026-11-03]
lcd_face/mujoco/assets/kobi_Seam_pin_R_slot.stl
3.00 x 6.30 x 3.00
