mgm136044/kobi-robot/printed_face/mujoco/assets/kobi_Jacket_hem_stripe.stl

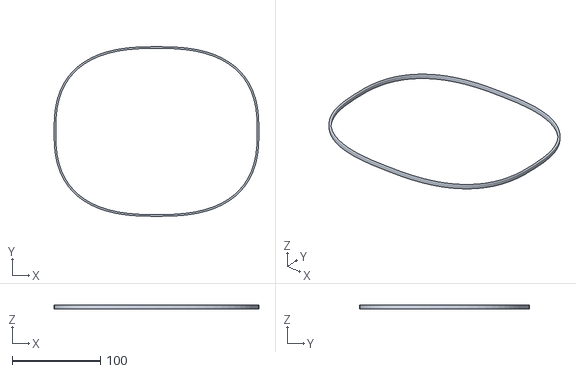
[picture p73: CAD file, 2026-11-03]
printed_face/mujoco/assets/kobi_Jacket_hem_stripe.stl
232.4 x 192.4 x 4.00
