mgm136044/kobi-robot/lcd_face/mujoco/assets/kobi_Arm_L_cuff.stl

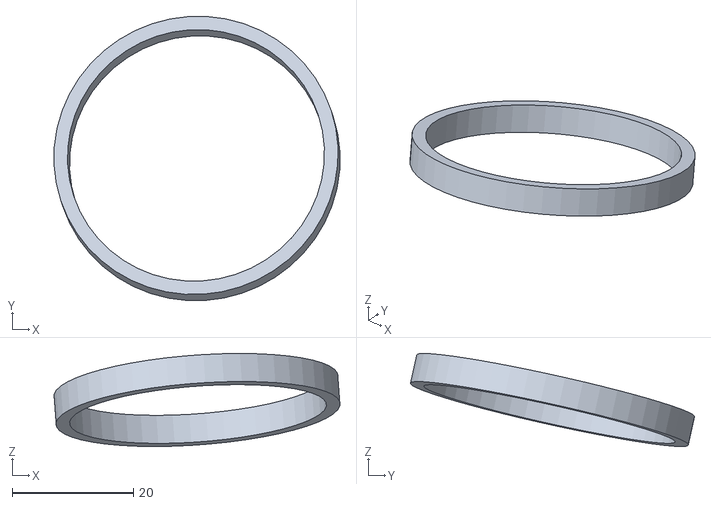
[picture p74: CAD file, 2026-11-03]
lcd_face/mujoco/assets/kobi_Arm_L_cuff.stl
47.2 x 46.8 x 15.3
