mgm136044/kobi-robot/printed_face/mujoco/assets/kobi_Tail_joint_2.stl

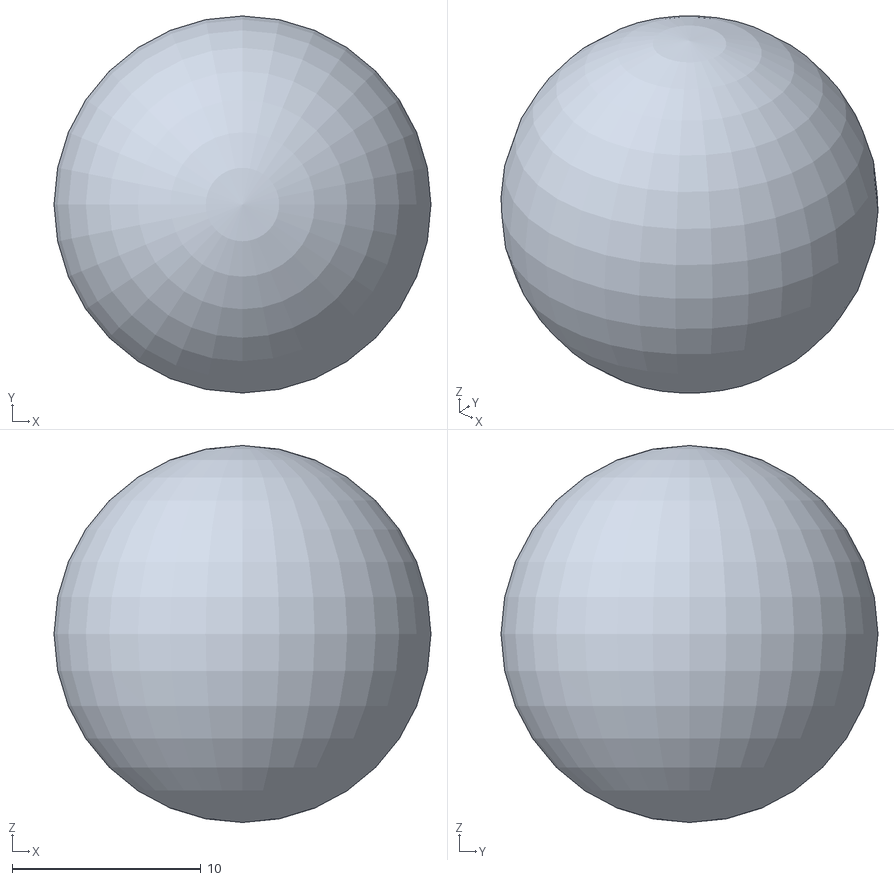
[picture p75: CAD file, 2026-11-03]
printed_face/mujoco/assets/kobi_Tail_joint_2.stl
20.0 x 20.0 x 20.0
