mgm136044/kobi-robot/printed_face/print/body/Collar_stripe.stl

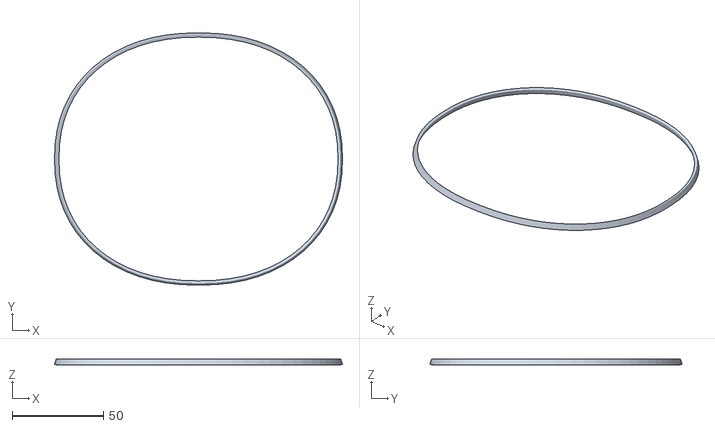
[picture p76: CAD file, 2026-11-03]
printed_face/print/body/Collar_stripe.stl
157.8 x 138.2 x 3.49
