mgm136044/kobi-robot/lcd_face/mujoco/assets/kobi_Foot_R_cover.stl

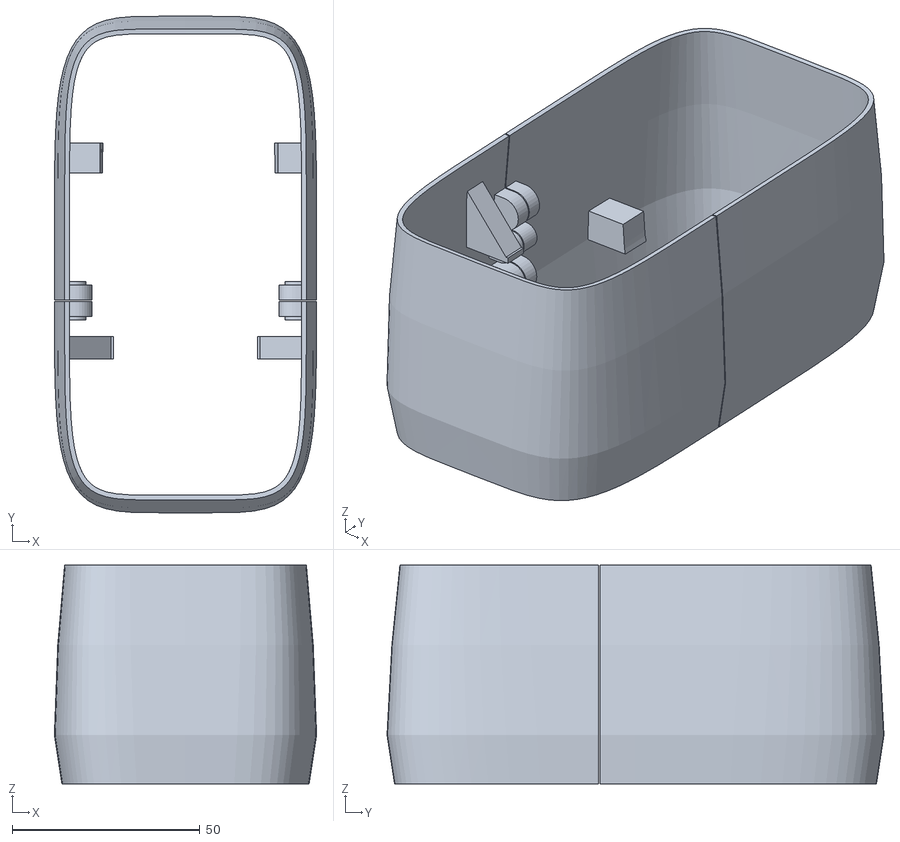
[picture p77: CAD file, 2026-11-03]
lcd_face/mujoco/assets/kobi_Foot_R_cover.stl
69.9 x 132.4 x 58.3
