mgm136044/kobi-robot/printed_face/mujoco/assets/kobi_Tail_tip.stl

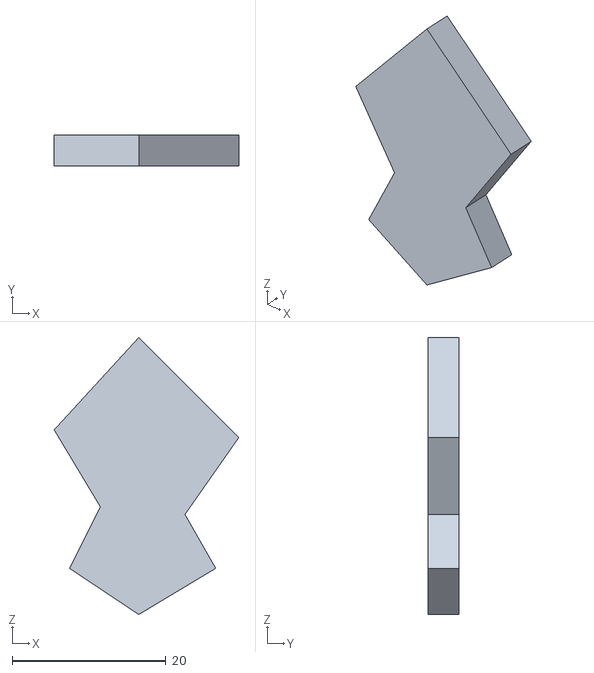
[picture p78: CAD file, 2026-11-03]
printed_face/mujoco/assets/kobi_Tail_tip.stl
24.0 x 4.00 x 36.0
