mgm136044/kobi-robot/printed_face/print/mech/Switch_tab.stl

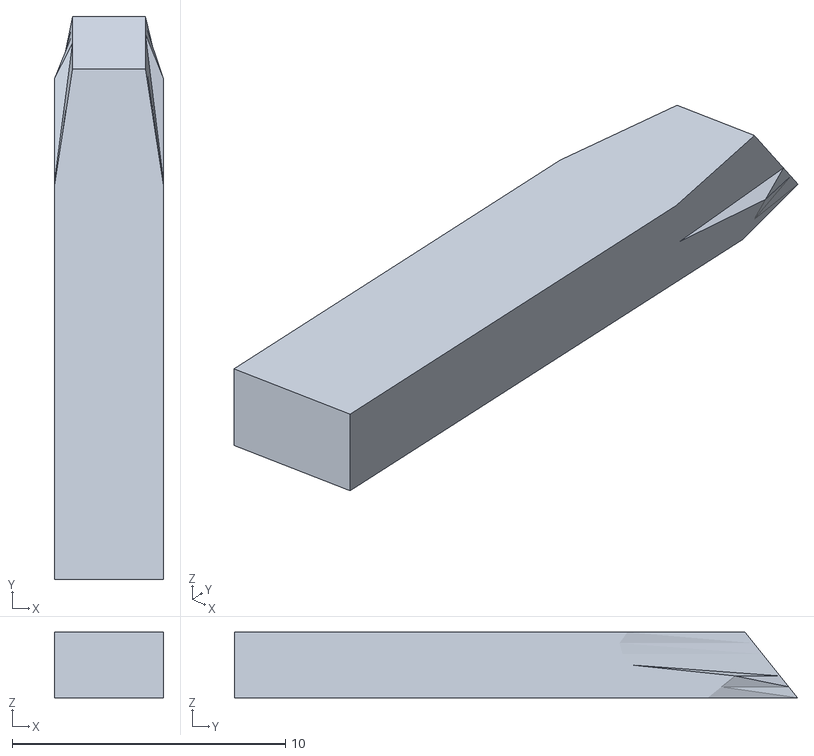
[picture p79: CAD file, 2026-11-03]
printed_face/print/mech/Switch_tab.stl
4.00 x 20.6 x 2.40
