mgm136044/kobi-robot/lcd_face/mujoco/assets/kobi_Jacket_K.stl

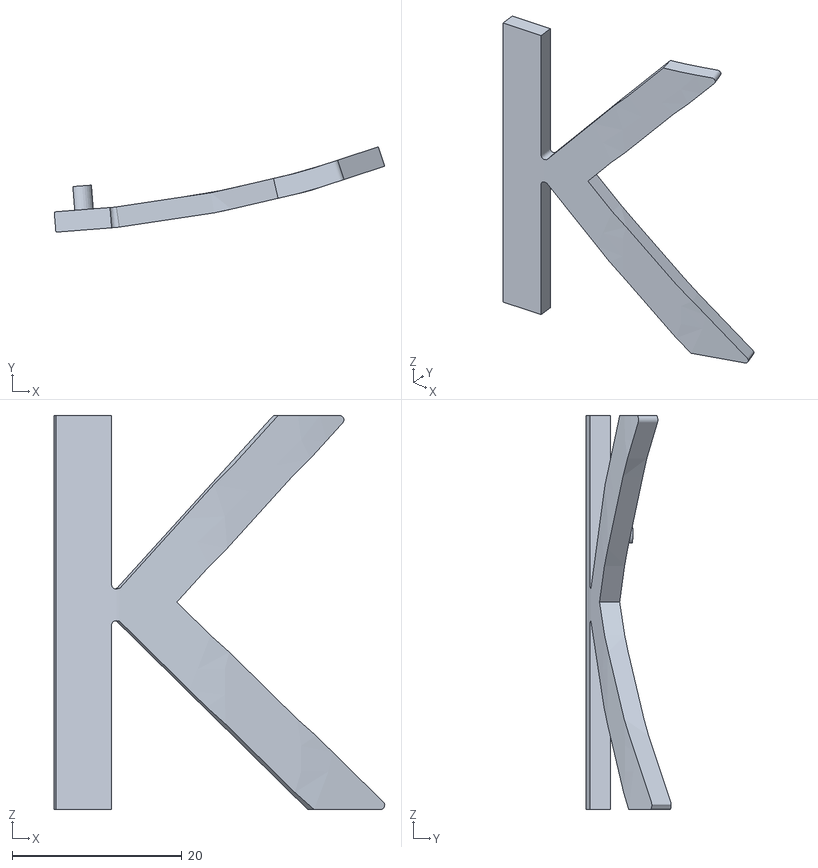
[picture p80: CAD file, 2026-11-03]
lcd_face/mujoco/assets/kobi_Jacket_K.stl
38.9 x 10.1 x 46.4
