mgm136044/kobi-robot/printed_face/print/mech/Top_plate.stl

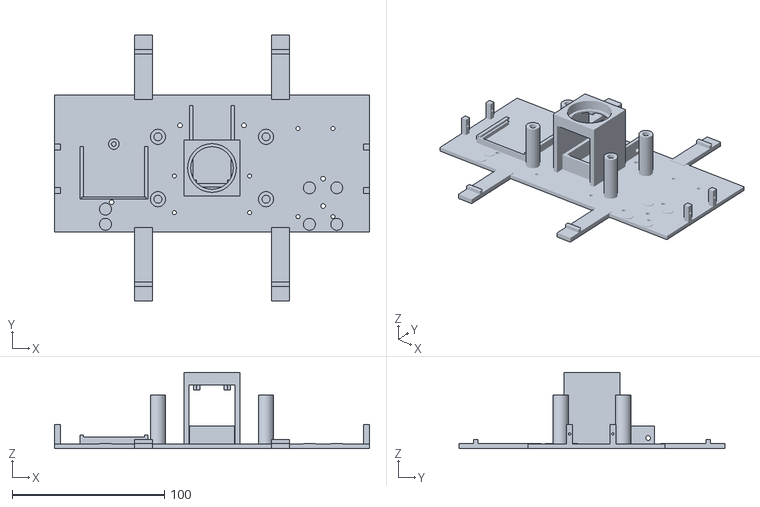
[picture p81: CAD file, 2026-11-03]
printed_face/print/mech/Top_plate.stl
207.0 x 175.0 x 50.2
