mgm136044/kobi-robot/printed_face/print/mech/Yaw_bridge.stl

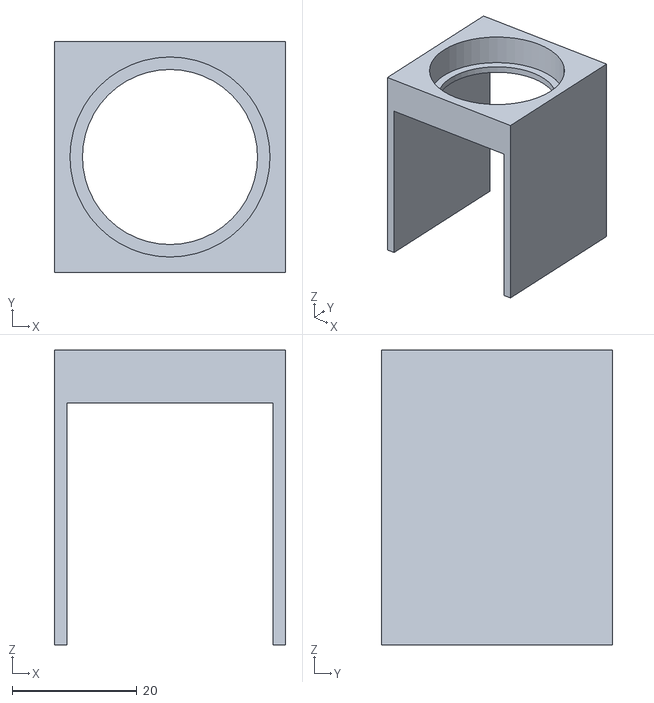
[picture p82: CAD file, 2026-11-03]
printed_face/print/mech/Yaw_bridge.stl
37.0 x 37.0 x 47.2
