mgm136044/kobi-robot/lcd_face/mujoco/assets/kobi_Collar_ring.stl

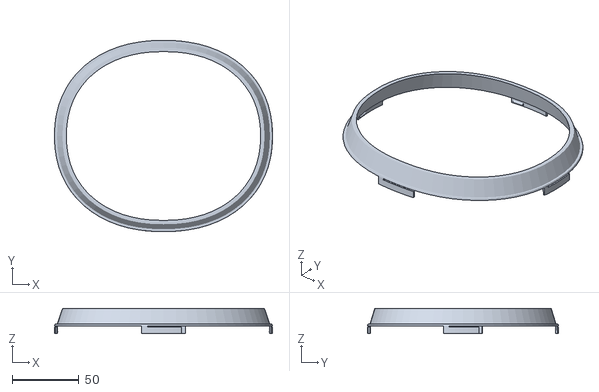
[picture p83: CAD file, 2026-11-03]
lcd_face/mujoco/assets/kobi_Collar_ring.stl
163.0 x 143.0 x 18.7
