mgm136044/kobi-robot/printed_face/mujoco/assets/kobi_Tail_0.stl

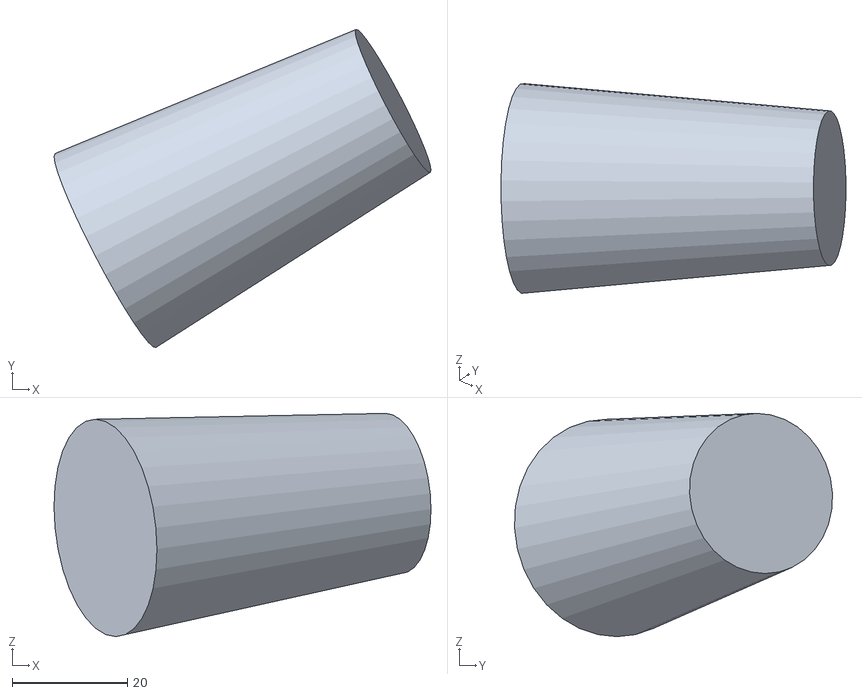
[picture p84: CAD file, 2026-11-03]
printed_face/mujoco/assets/kobi_Tail_0.stl
65.5 x 55.3 x 38.8
