mgm136044/kobi-robot/printed_face/print/body/Jacket_K_solid.stl

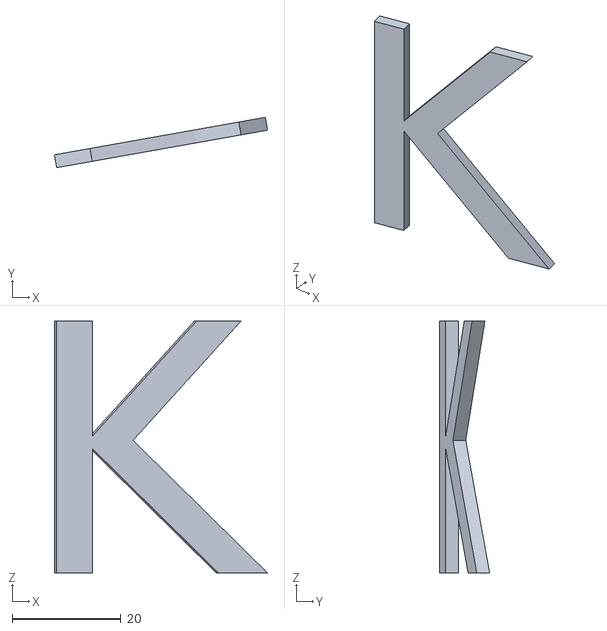
[picture p85: CAD file, 2026-11-03]
printed_face/print/body/Jacket_K_solid.stl
39.3 x 9.26 x 46.4
