mgm136044/kobi-robot/printed_face/print/mech/Shoulder_coupler_R.stl

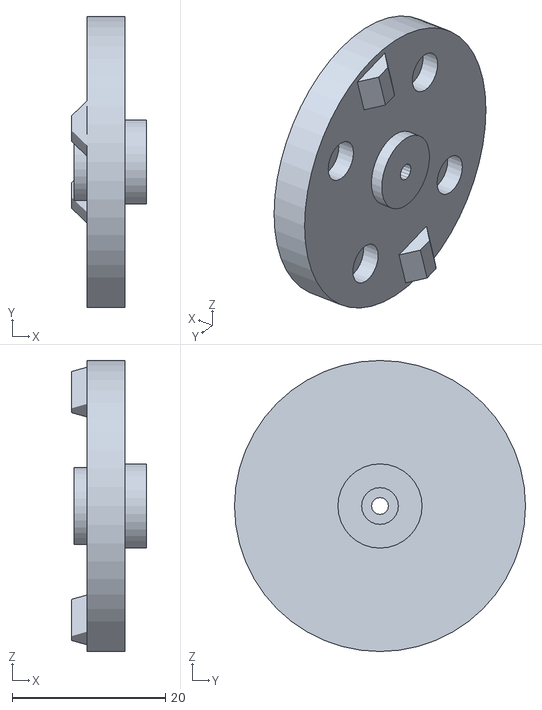
[picture p86: CAD file, 2026-11-03]
printed_face/print/mech/Shoulder_coupler_R.stl
9.80 x 38.0 x 38.0
