mgm136044/kobi-robot/lcd_face/mujoco/assets/kobi_Arm_R_cuff_top.stl

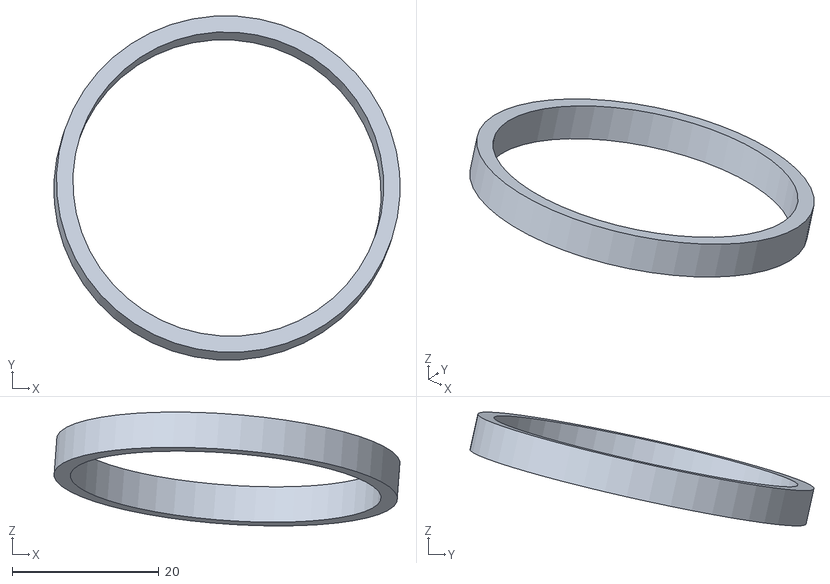
[picture p87: CAD file, 2026-11-03]
lcd_face/mujoco/assets/kobi_Arm_R_cuff_top.stl
47.2 x 46.9 x 15.5
