mgm136044/kobi-robot/printed_face/print/mech/Plate_leg_R.stl

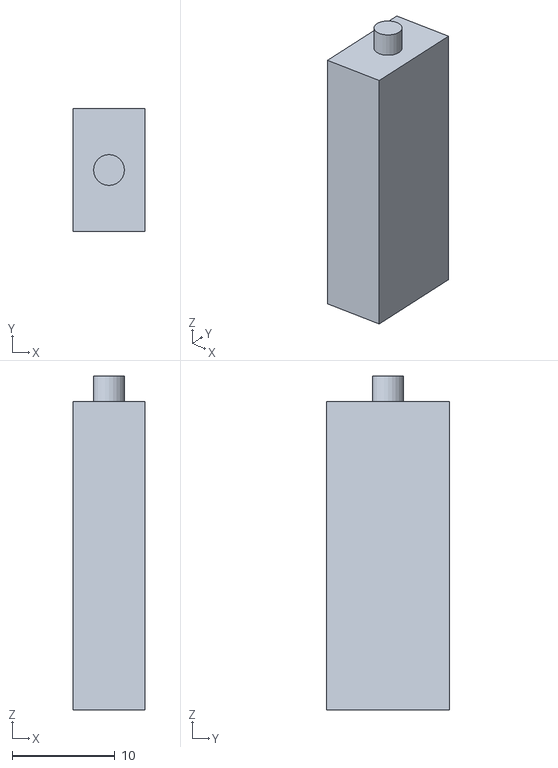
[picture p88: CAD file, 2026-11-03]
printed_face/print/mech/Plate_leg_R.stl
7.00 x 12.0 x 32.5
