mgm136044/kobi-robot/lcd_face/mujoco/assets/kobi_Fabric_L_legging.stl

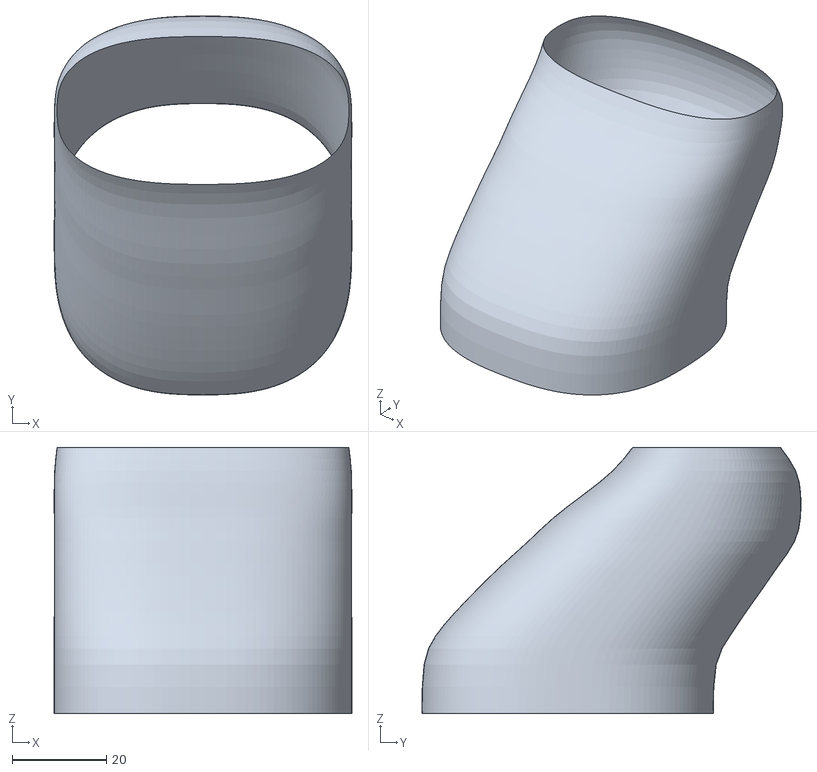
[picture p89: CAD file, 2026-11-03]
lcd_face/mujoco/assets/kobi_Fabric_L_legging.stl
63.1 x 80.4 x 56.5
