mgm136044/kobi-robot/printed_face/print/mech/Neck_yaw_yoke.stl

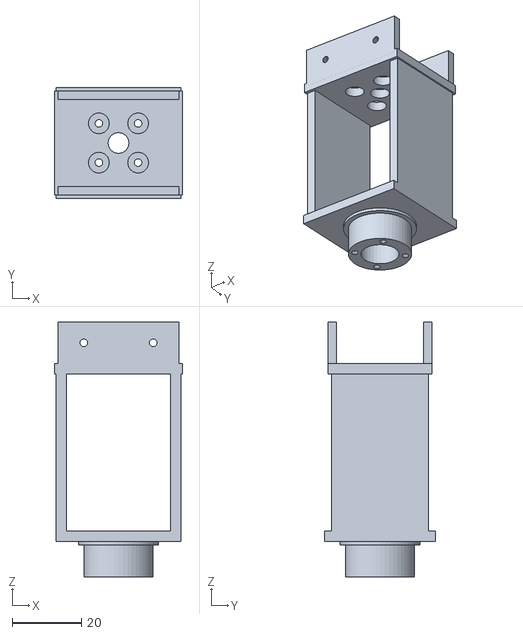
[picture p91: CAD file, 2026-11-03]
printed_face/print/mech/Neck_yaw_yoke.stl
37.0 x 32.0 x 73.5
