mgm136044/kobi-robot/printed_face/mujoco/assets/kobi_Arm_R_hub.stl

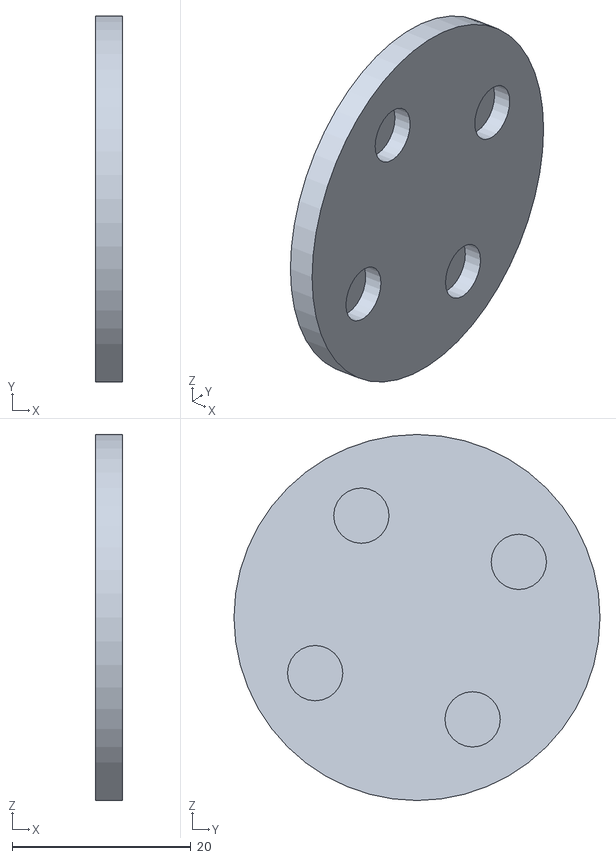
[picture p92: CAD file, 2026-11-03]
printed_face/mujoco/assets/kobi_Arm_R_hub.stl
3.00 x 41.0 x 41.0
