mgm136044/kobi-robot/printed_face/print/body/Jacket_back.stl

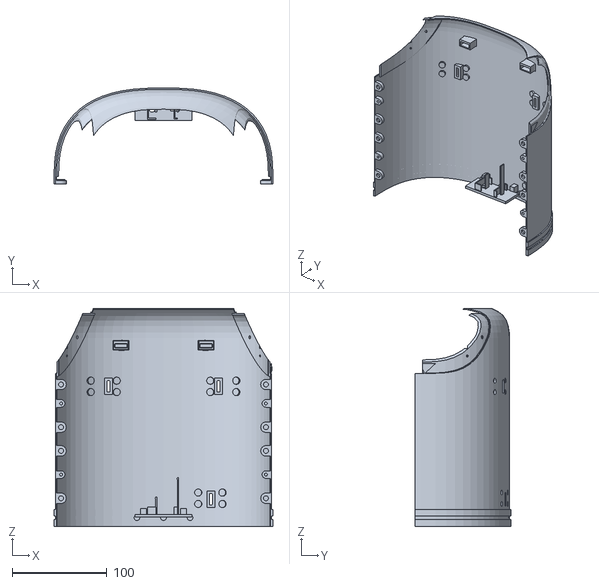
[picture p93: CAD file, 2026-11-03]
printed_face/print/body/Jacket_back.stl
231.0 x 101.4 x 230.4
