mgm136044/kobi-robot/printed_face/print/mech/Head_frame.stl

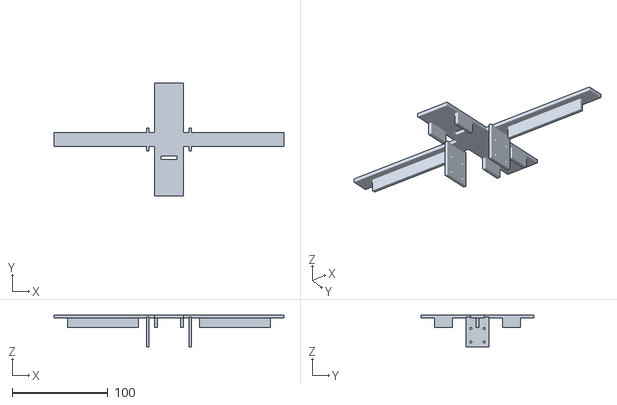
[picture p94: CAD file, 2026-11-03]
printed_face/print/mech/Head_frame.stl
240.0 x 117.5 x 33.0
