mgm136044/kobi-robot/printed_face/print/mech/Board_keeper_pin.stl

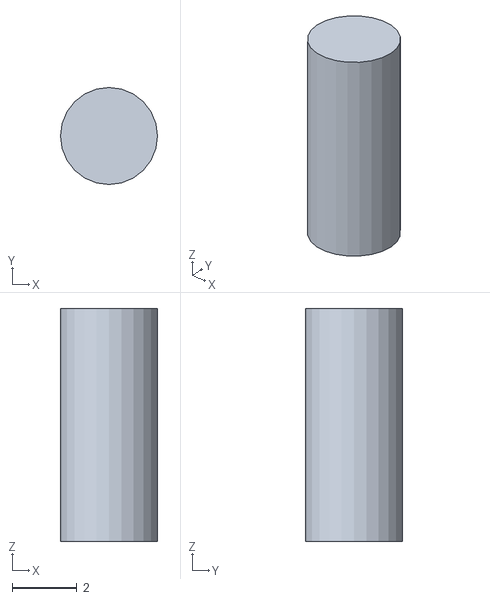
[picture p95: CAD file, 2026-11-03]
printed_face/print/mech/Board_keeper_pin.stl
3.00 x 3.00 x 7.20
