mgm136044/kobi-robot/lcd_face/mujoco/assets/kobi_Face_Blush_R.stl

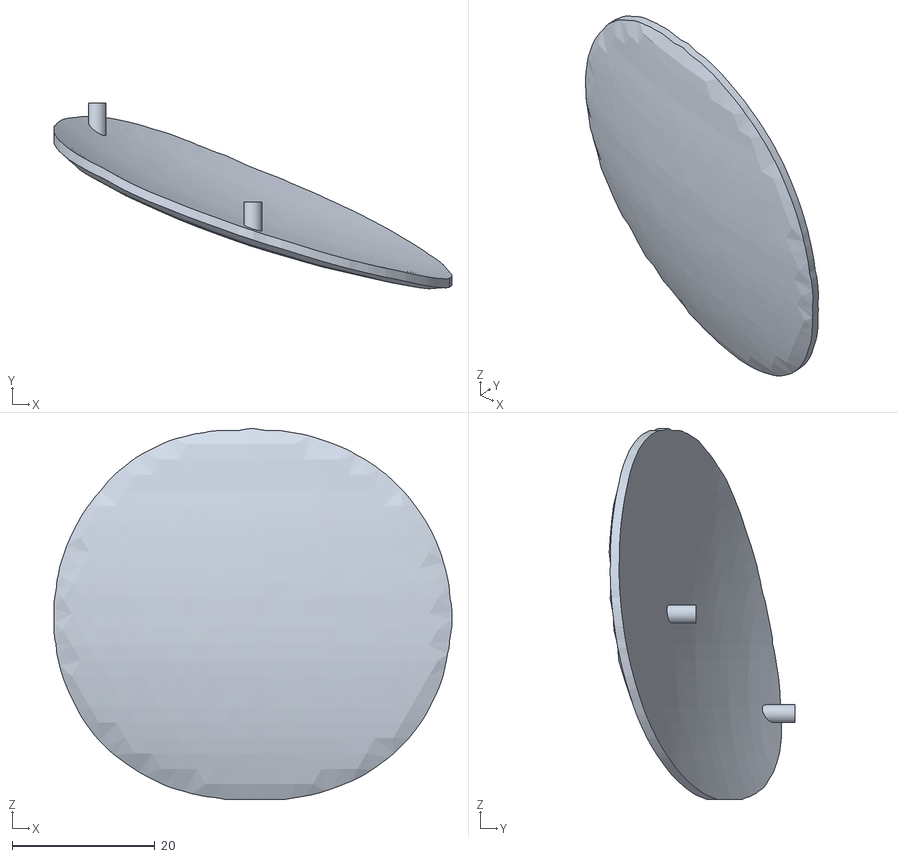
[picture p96: CAD file, 2026-11-03]
lcd_face/mujoco/assets/kobi_Face_Blush_R.stl
55.7 x 26.0 x 52.0
