mgm136044/kobi-robot/lcd_face/mujoco/assets/kobi_Foot_L_cover.stl

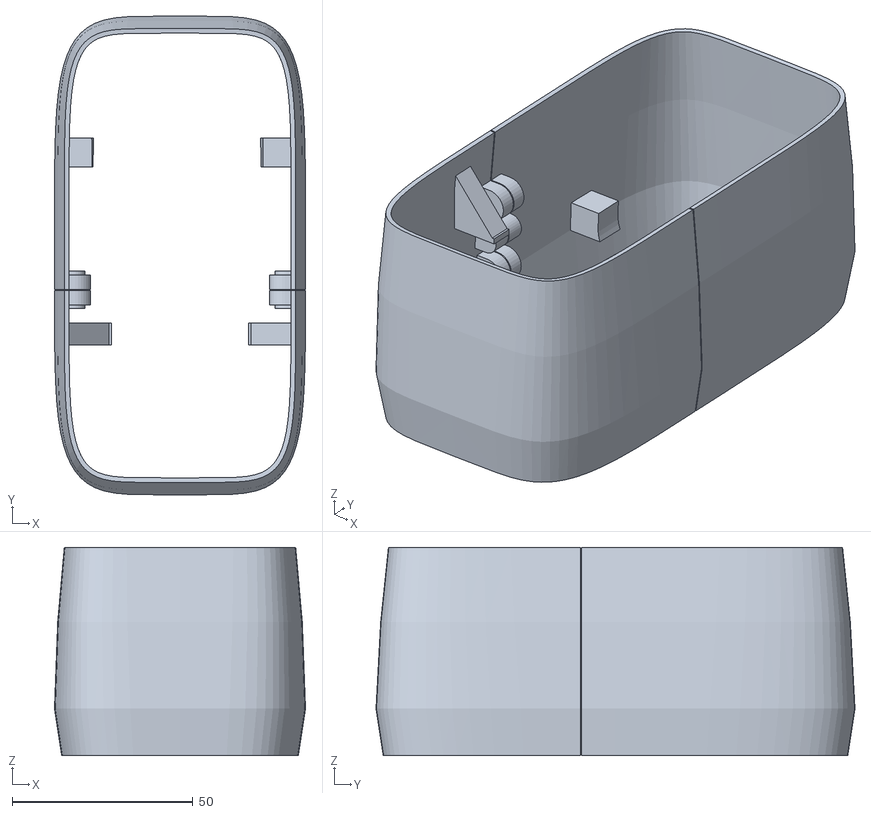
[picture p97: CAD file, 2026-11-03]
lcd_face/mujoco/assets/kobi_Foot_L_cover.stl
69.4 x 132.4 x 57.6
