mgm136044/kobi-robot/printed_face/mujoco/assets/kobi_Tail_2.stl

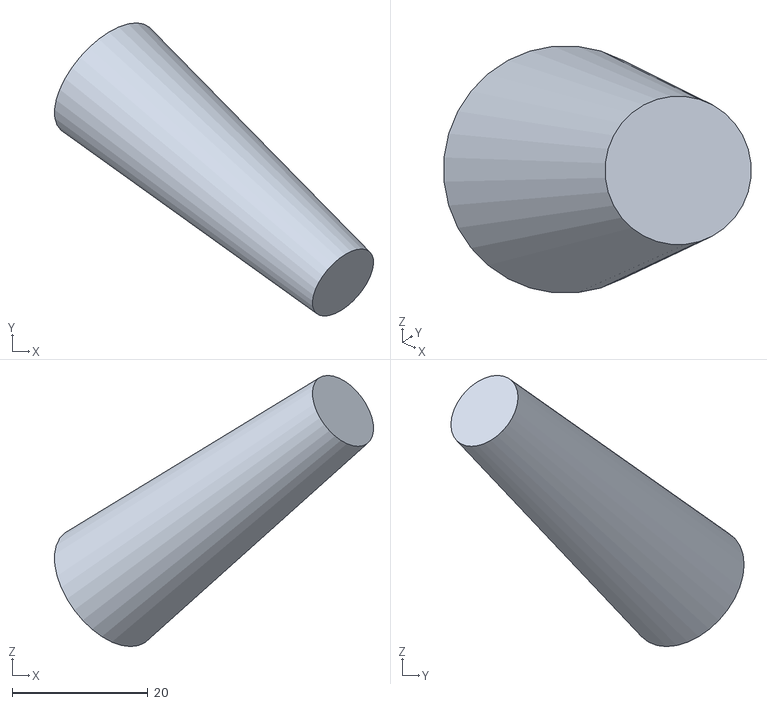
[picture p98: CAD file, 2026-11-03]
printed_face/mujoco/assets/kobi_Tail_2.stl
47.0 x 43.2 x 39.9
