mgm136044/kobi-robot/printed_face/print/body/Wing_R.stl

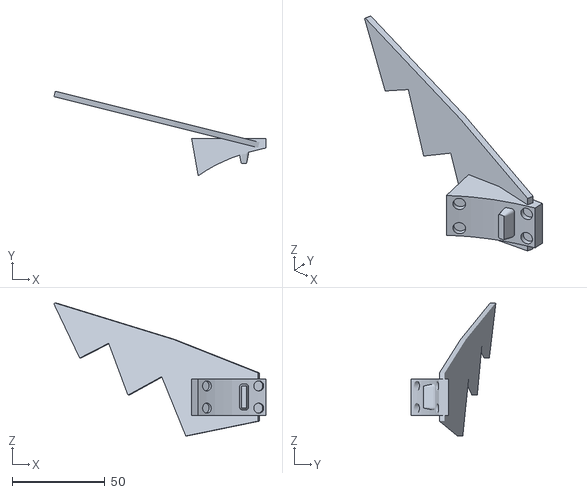
[picture p99: CAD file, 2026-11-03]
printed_face/print/body/Wing_R.stl
114.3 x 45.6 x 71.7
