mgm136044/kobi-robot/lcd_face/mujoco/assets/kobi_Jacket_pocket_R0.stl

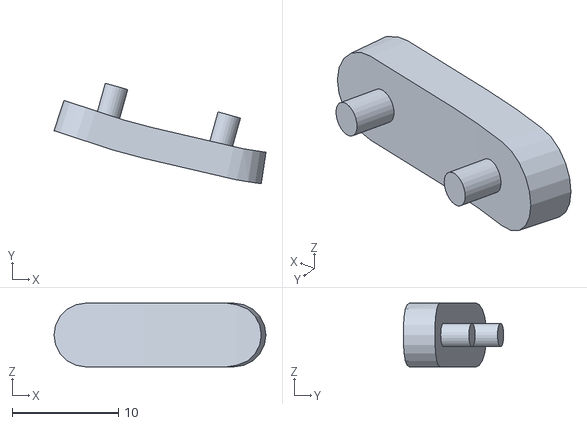
[picture p100: CAD file, 2026-11-03]
lcd_face/mujoco/assets/kobi_Jacket_pocket_R0.stl
20.0 x 9.47 x 6.00
