mgm136044/kobi-robot/lcd_face/mujoco/assets/kobi_Arm_R_cuff_stripe.stl

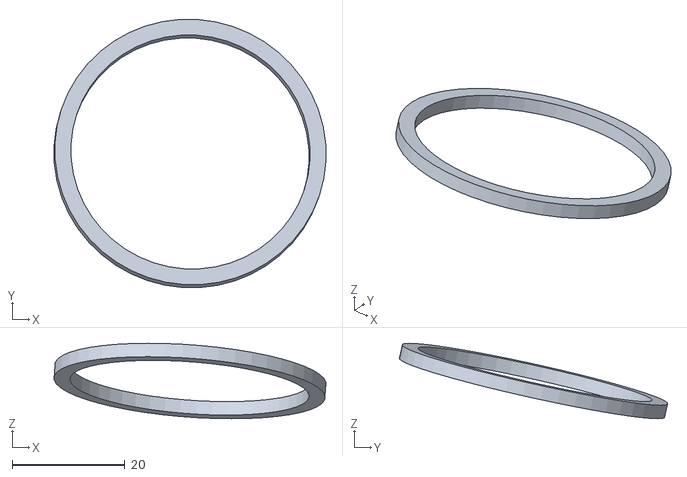
[picture p101: CAD file, 2026-11-03]
lcd_face/mujoco/assets/kobi_Arm_R_cuff_stripe.stl
48.2 x 47.5 x 13.4
