mgm136044/kobi-robot/lcd_face/mujoco/assets/kobi_Jacket_button_1.stl

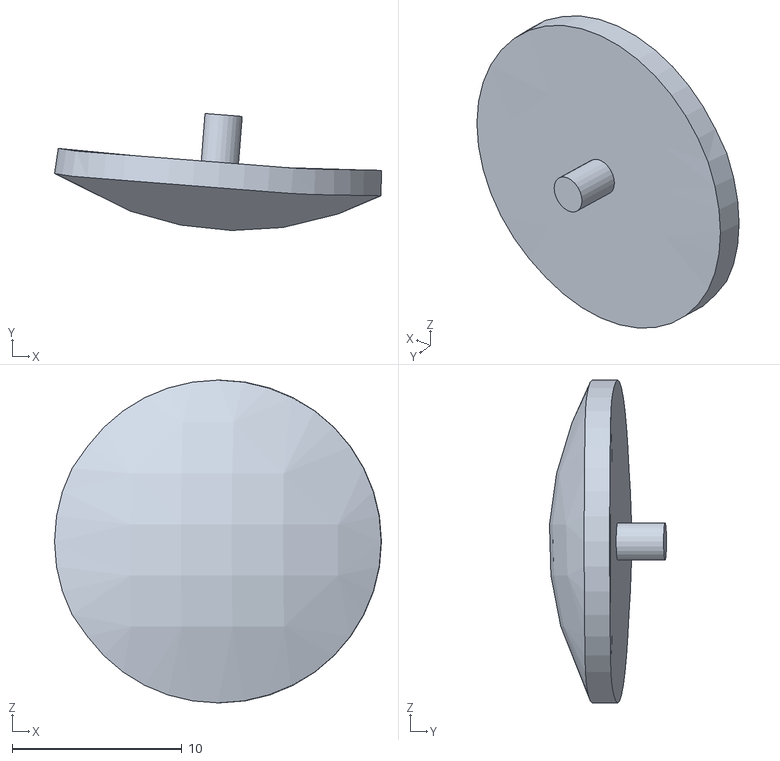
[picture p102: CAD file, 2026-11-03]
lcd_face/mujoco/assets/kobi_Jacket_button_1.stl
19.2 x 6.89 x 19.0
