mgm136044/kobi-robot/(list of files, cad)

Other CAD files:
lcd_face/mujoco/assets/kobi_A_HeadShell.stl
lcd_face/print/extra/kori_roll_to_pitch_right_print_mm.stl
lcd_face/print/body/Arm_R_mitten.stl
lcd_face/print/face/Face_LCD_bezel_L.stl
lcd_face/print/head/A_HeadShell_R.stl
lcd_face/mujoco/assets/kobi_Arm_R_mitten.stl
printed_face/mujoco/assets/kobi_Jacket_raglan_R.stl
lcd_face/mujoco/assets/kobi_Arm_L_mitten.stl
printed_face/print/body/Root_pin_tail.stl
printed_face/mujoco/assets/kobi_Root_pin_wing_L.stl
printed_face/print/body/Arm_L_mitten.stl
printed_face/print/face/Face_WhiteFace_L.stl
printed_face/print/mech/Jacket_rib_back_L.stl
printed_face/print/body/Arm_R_mitten.stl
printed_face/print/mech/Head_pad_front.stl
printed_face/print/mech/Head_pad_right.stl
printed_face/print/body/Jacket_raglan_R.stl
lcd_face/mujoco/assets/kobi_Seam_pin_L_slot.stl
printed_face/print/body/Root_pin_wing_L.stl
printed_face/mujoco/assets/kobi_Root_pin_tail.stl
lcd_face/mujoco/assets/kobi_Foot_L_dowel_a.stl
printed_face/print/body/Arm_L_sleeve.stl
printed_face/print/mech/Shoulder_coupler_L.stl
lcd_face/mujoco/assets/kobi_Arm_L_cuff_top.stl
lcd_face/mujoco/assets/kobi_Foot_R_dowel_a.stl
printed_face/print/body/Jacket_pocket_R0.stl
lcd_face/mujoco/assets/kobi_Jacket_front.stl
printed_face/print/mech/Jacket_rib_front_L.stl
printed_face/print/body/Neck.stl
printed_face/print/mech/Plate_leg_L.stl
lcd_face/mujoco/assets/kobi_Arm_R_sleeve.stl
printed_face/print/body/Jacket_pocket_L1.stl
printed_face/print/body/Wing_L.stl
lcd_face/mujoco/assets/kobi_Jacket_back.stl
printed_face/mujoco/assets/kobi_Arm_L_hub.stl
lcd_face/mujoco/assets/kobi_Jacket_pocket_L0.stl
lcd_face/mujoco/assets/kobi_Arm_R_cuff.stl
lcd_face/blender/kobi_v7_lcd_v7b.blend
lcd_face/mujoco/assets/kobi_Arm_L_cuff_stripe.stl
lcd_face/mujoco/assets/kobi_Arm_L_sleeve.stl
lcd_face/mujoco/assets/kobi_Fabric_R_legging.stl
lcd_face/mujoco/assets/kobi_Face_Blush_L.stl
lcd_face/mujoco/assets/kobi_Foot_L_dowel_b.stl
lcd_face/mujoco/assets/kobi_Foot_R_dowel_b.stl
lcd_face/mujoco/assets/kobi_Jacket_button_0.stl
lcd_face/mujoco/assets/kobi_Jacket_button_2.stl
lcd_face/mujoco/assets/kobi_Jacket_hem_stripe_back.stl
lcd_face/mujoco/assets/kobi_Jacket_hem_stripe_front.stl
lcd_face/mujoco/assets/kobi_Jacket_placket.stl
lcd_face/mujoco/assets/kobi_Jacket_pocket_L1.stl
lcd_face/mujoco/assets/kobi_Jacket_pocket_R1.stl
lcd_face/mujoco/assets/kobi_Jacket_raglan_L_back.stl
lcd_face/mujoco/assets/kobi_Jacket_raglan_L_front.stl
lcd_face/mujoco/assets/kobi_Jacket_raglan_R_back.stl
lcd_face/mujoco/assets/kobi_Jacket_raglan_R_front.stl
lcd_face/mujoco/assets/kobi_Leg_L_guard.stl
lcd_face/mujoco/assets/kobi_Leg_R_guard.stl
lcd_face/mujoco/assets/kobi_Seam_pin_L_round.stl
lcd_face/mujoco/assets/kobi_Seam_pin_R_round.stl
lcd_face/mujoco/assets/kobi_Tail_body.stl
lcd_face/mujoco/assets/kobi_Wing_L.stl
lcd_face/mujoco/assets/kobi_Wing_R.stl
lcd_face/mujoco/assets/kori_roll_to_pitch_left.stl
lcd_face/mujoco/assets/kori_roll_to_pitch_right.stl
printed_face/blender/kobi_v7.blend
printed_face/print/head/A_HeadShell_L.stl
printed_face/print/head/A_HeadShell_R.stl
printed_face/print/head/A_HeadShell_whole.stl
printed_face/skeleton/kobi_rig.blend
