mgm136044/kobi-robot/printed_face/urdf/kobi.urdf

<?xml version="1.0"?>
<!-- generated by tools/build_urdf.py from printed_face/mujoco/kobi_scene.xml; do not edit by hand -->
<robot name="kobi">
  <mujoco>
    <compiler meshdir="." discardvisual="false" fusestatic="false" strippath="false" />
  </mujoco>
  <link name="trunk_assembly">
    <inertial>
      <origin xyz="-0.0625077 0.00268046 0.050866" rpy="1.23198828 -0.788162287 -1.1614839" />
      <mass value="1.28934" />
      <inertia ixx="0.00753704" iyy="0.00812044" izz="0.00911296" ixy="0" ixz="0" iyz="0" />
    </inertial>
    <visual name="trunk_assembly_trunk_bottom">
      <origin xyz="-0.019 0 0.0648909" rpy="0 -0 0" />
      <geometry>
        <mesh filename="assets/trunk_bottom.stl" scale="1 1 1" />
      </geometry>
      <material name="trunk_assembly_trunk_bottom_material">
        <color rgba="0.180391997 0.180391997 0.180391997 1" />
      </material>
    </visual>
    <visual name="trunk_assembly_trunk_top">
      <origin xyz="-0.019 0 0.0648909" rpy="0 -0 0" />
      <geometry>
        <mesh filename="assets/trunk_top.stl" scale="1 1 1" />
      </geometry>
      <material name="trunk_assembly_trunk_top_material">
        <color rgba="0.180391997 0.180391997 0.180391997 1" />
      </material>
    </visual>
    <visual name="v_kobi_Neck">
      <origin xyz="0 0 -0.211516" rpy="0 -0 1.57079633" />
      <geometry>
        <mesh filename="assets/kobi_Neck.stl" scale="0.001 0.001 0.001" />
      </geometry>
      <material name="v_kobi_Neck_material">
        <color rgba="0.99000001 0.839999974 0.540000021 1" />
      </material>
    </visual>
    <visual name="v_kobi_Collar_ring">
      <origin xyz="0 0 -0.211516" rpy="0 -0 1.57079633" />
      <geometry>
        <mesh filename="assets/kobi_Collar_ring.stl" scale="0.001 0.001 0.001" />
      </geometry>
      <material name="v_kobi_Collar_ring_material">
        <color rgba="0.949999988 0.949999988 0.930000007 1" />
      </material>
    </visual>
    <visual name="v_kobi_Foot_L_dowel_a">
      <origin xyz="0 0 -0.211516" rpy="0 -0 1.57079633" />
      <geometry>
        <mesh filename="assets/kobi_Foot_L_dowel_a.stl" scale="0.001 0.001 0.001" />
      </geometry>
      <material name="v_kobi_Foot_L_dowel_a_material">
        <color rgba="0.699999988 0.699999988 0.699999988 1" />
      </material>
    </visual>
    <visual name="v_kobi_Foot_L_dowel_b">
      <origin xyz="0 0 -0.211516" rpy="0 -0 1.57079633" />
      <geometry>
        <mesh filename="assets/kobi_Foot_L_dowel_b.stl" scale="0.001 0.001 0.001" />
      </geometry>
      <material name="v_kobi_Foot_L_dowel_b_material">
        <color rgba="0.699999988 0.699999988 0.699999988 1" />
      </material>
    </visual>
    <visual name="v_kobi_Foot_R_dowel_a">
      <origin xyz="0 0 -0.211516" rpy="0 -0 1.57079633" />
      <geometry>
        <mesh filename="assets/kobi_Foot_R_dowel_a.stl" scale="0.001 0.001 0.001" />
      </geometry>
      <material name="v_kobi_Foot_R_dowel_a_material">
        <color rgba="0.699999988 0.699999988 0.699999988 1" />
      </material>
    </visual>
    <visual name="v_kobi_Foot_R_dowel_b">
      <origin xyz="0 0 -0.211516" rpy="0 -0 1.57079633" />
      <geometry>
        <mesh filename="assets/kobi_Foot_R_dowel_b.stl" scale="0.001 0.001 0.001" />
      </geometry>
      <material name="v_kobi_Foot_R_dowel_b_material">
        <color rgba="0.699999988 0.699999988 0.699999988 1" />
      </material>
    </visual>
    <visual name="v_kobi_Tail_body">
      <origin xyz="0 0 -0.211516" rpy="0 -0 1.57079633" />
      <geometry>
        <mesh filename="assets/kobi_Tail_body.stl" scale="0.001 0.001 0.001" />
      </geometry>
      <material name="v_kobi_Tail_body_material">
        <color rgba="0.99000001 0.839999974 0.540000021 1" />
      </material>
    </visual>
    <visual name="v_kobi_Wing_R">
      <origin xyz="0 0 -0.211516" rpy="0 -0 1.57079633" />
      <geometry>
        <mesh filename="assets/kobi_Wing_R.stl" scale="0.001 0.001 0.001" />
      </geometry>
      <material name="v_kobi_Wing_R_material">
        <color rgba="0.99000001 0.839999974 0.540000021 1" />
      </material>
    </visual>
    <visual name="v_kobi_Wing_L">
      <origin xyz="0 0 -0.211516" rpy="0 -0 1.57079633" />
      <geometry>
        <mesh filename="assets/kobi_Wing_L.stl" scale="0.001 0.001 0.001" />
      </geometry>
      <material name="v_kobi_Wing_L_material">
        <color rgba="0.99000001 0.839999974 0.540000021 1" />
      </material>
    </visual>
    <visual name="v_kobi_Jacket_button_0">
      <origin xyz="0 0 -0.211516" rpy="0 -0 1.57079633" />
      <geometry>
        <mesh filename="assets/kobi_Jacket_button_0.stl" scale="0.001 0.001 0.001" />
      </geometry>
      <material name="v_kobi_Jacket_button_0_material">
        <color rgba="0.949999988 0.949999988 0.930000007 1" />
      </material>
    </visual>
    <visual name="v_kobi_Jacket_button_1">
      <origin xyz="0 0 -0.211516" rpy="0 -0 1.57079633" />
      <geometry>
        <mesh filename="assets/kobi_Jacket_button_1.stl" scale="0.001 0.001 0.001" />
      </geometry>
      <material name="v_kobi_Jacket_button_1_material">
        <color rgba="0.949999988 0.949999988 0.930000007 1" />
      </material>
    </visual>
    <visual name="v_kobi_Jacket_button_2">
      <origin xyz="0 0 -0.211516" rpy="0 -0 1.57079633" />
      <geometry>
        <mesh filename="assets/kobi_Jacket_button_2.stl" scale="0.001 0.001 0.001" />
      </geometry>
      <material name="v_kobi_Jacket_button_2_material">
        <color rgba="0.949999988 0.949999988 0.930000007 1" />
      </material>
    </visual>
    <visual name="v_kobi_Jacket_K">
      <origin xyz="0 0 -0.211516" rpy="0 -0 1.57079633" />
      <geometry>
        <mesh filename="assets/kobi_Jacket_K.stl" scale="0.001 0.001 0.001" />
      </geometry>
      <material name="v_kobi_Jacket_K_material">
        <color rgba="0.949999988 0.949999988 0.930000007 1" />
      </material>
    </visual>
    <visual name="v_kobi_Jacket_pocket_R0">
      <origin xyz="0 0 -0.211516" rpy="0 -0 1.57079633" />
      <geometry>
        <mesh filename="assets/kobi_Jacket_pocket_R0.stl" scale="0.001 0.001 0.001" />
      </geometry>
      <material name="v_kobi_Jacket_pocket_R0_material">
        <color rgba="0.949999988 0.949999988 0.930000007 1" />
      </material>
    </visual>
    <visual name="v_kobi_Jacket_pocket_R1">
      <origin xyz="0 0 -0.211516" rpy="0 -0 1.57079633" />
      <geometry>
        <mesh filename="assets/kobi_Jacket_pocket_R1.stl" scale="0.001 0.001 0.001" />
      </geometry>
      <material name="v_kobi_Jacket_pocket_R1_material">
        <color rgba="0.949999988 0.949999988 0.930000007 1" />
      </material>
    </visual>
    <visual name="v_kobi_Jacket_pocket_L0">
      <origin xyz="0 0 -0.211516" rpy="0 -0 1.57079633" />
      <geometry>
        <mesh filename="assets/kobi_Jacket_pocket_L0.stl" scale="0.001 0.001 0.001" />
      </geometry>
      <material name="v_kobi_Jacket_pocket_L0_material">
        <color rgba="0.949999988 0.949999988 0.930000007 1" />
      </material>
    </visual>
    <visual name="v_kobi_Jacket_pocket_L1">
      <origin xyz="0 0 -0.211516" rpy="0 -0 1.57079633" />
      <geometry>
        <mesh filename="assets/kobi_Jacket_pocket_L1.stl" scale="0.001 0.001 0.001" />
      </geometry>
      <material name="v_kobi_Jacket_pocket_L1_material">
        <color rgba="0.949999988 0.949999988 0.930000007 1" />
      </material>
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
    </visual>
    <visual name="v_kobi_Seam_pin_R_round">
      <origin xyz="0 0 -0.211516" rpy="0 -0 1.57079633" />
      <geometry>
        <mesh filename="assets/kobi_Seam_pin_R_round.stl" scale="0.001 0.001 0.001" />
      </geometry>
      <material name="v_kobi_Seam_pin_R_round_material">
        <color rgba="0.699999988 0.699999988 0.699999988 1" />
      </material>
    </visual>
    <visual name="v_kobi_Seam_pin_R_slot">
      <origin xyz="0 0 -0.211516" rpy="0 -0 1.57079633" />
      <geometry>
        <mesh filename="assets/kobi_Seam_pin_R_slot.stl" scale="0.001 0.001 0.001" />
      </geometry>
      <material name="v_kobi_Seam_pin_R_slot_material">
        <color rgba="0.699999988 0.699999988 0.699999988 1" />
      </material>
    </visual>
  </link>
  <link name="hip_roll_assembly">
    <inertial>
      <origin xyz="0.000795081 -5.46541e-06 -0.03306" rpy="0.0373896768 0.00055783445 1.57010943" />
      <mass value="0.06648" />
      <inertia ixx="2.81818e-05" iyy="2.44554e-05" izz="1.42544e-05" ixy="0" ixz="0" iyz="0" />
    </inertial>
    <visual name="hip_roll_assembly_roll_motor_bottom">
      <origin xyz="0 -0.035 0.01905" rpy="0 -0 0" />
      <geometry>
        <mesh filename="assets/roll_motor_bottom.stl" scale="1 1 1" />
      </geometry>
      <material name="hip_roll_assembly_roll_motor_bottom_material">
        <color rgba="0.647059023 0.647059023 0.647059023 1" />
      </material>
    </visual>
    <visual name="hip_roll_assembly_roll_motor_top">
      <origin xyz="0 -0.035 0.01905" rpy="0 -0 0" />
      <geometry>
        <mesh filename="assets/roll_motor_top.stl" scale="1 1 1" />
      </geometry>
      <material name="hip_roll_assembly_roll_motor_top_material">
        <color rgba="0.901961029 0.901961029 0.901961029 1" />
      </material>
    </visual>
  </link>
  <link name="left_roll_to_pitch_assembly">
    <inertial>
      <origin xyz="0.0184606 0.042301 0.0203549" rpy="-0.284709665 0.0460563496 -0.326658022" />
      <mass value="0.0807079" />
      <inertia ixx="4.12125e-05" iyy="3.14387e-05" izz="2.99125e-05" ixy="0" ixz="0" iyz="0" />
    </inertial>
    <visual name="left_roll_to_pitch_assembly_kori_roll_to_pitch_left">
      <origin xyz="0 0 0" rpy="0 -0 0" />
      <geometry>
        <mesh filename="assets/kori_roll_to_pitch_left.stl" scale="1 1 1" />
      </geometry>
      <material name="left_roll_to_pitch_assembly_kori_roll_to_pitch_left_material">
        <color rgba="0.909803987 0.572548985 0.164706007 1" />
      </material>
    </visual>
  </link>
  <link name="knee_and_ankle_assembly">
    <inertial>
      <origin xyz="3.76952e-06 -0.0577561 0.0181195" rpy="1.57076041 -0.00310099155 -1.57020527" />
      <mass value="0.07257" />
      <inertia ixx="1.87015e-05" iyy="4.23318e-05" izz="4.98974e-05" ixy="0" ixz="0" iyz="0" />
    </inertial>
    <visual name="knee_and_ankle_assembly_leg_spacer">
      <origin xyz="0.01606 0.14365 0.10925" rpy="-1.57079633 0 0" />
      <geometry>
        <mesh filename="assets/leg_spacer.stl" scale="1 1 1" />
      </geometry>
      <material name="knee_and_ankle_assembly_leg_spacer_material">
        <color rgba="0.647059023 0.647059023 0.647059023 1" />
      </material>
    </visual>
    <visual name="knee_and_ankle_assembly_left_knee_to_ankle_right_sheet">
      <origin xyz="0.01606 0.14365 0.10915" rpy="-1.57079633 0 0" />
      <geometry>
        <mesh filename="assets/left_knee_to_ankle_right_sheet.stl" scale="1 1 1" />
      </geometry>
      <material name="knee_and_ankle_assembly_left_knee_to_ankle_right_sheet_material">
        <color rgba="0.223528996 0.219607994 0.219607994 1" />
      </material>
    </visual>
    <visual name="knee_and_ankle_assembly_left_knee_to_ankle_left_sheet">
      <origin xyz="0.01606 0.14365 0.10915" rpy="-1.57079633 0 0" />
      <geometry>
        <mesh filename="assets/left_knee_to_ankle_left_sheet.stl" scale="1 1 1" />
      </geometry>
      <material name="knee_and_ankle_assembly_left_knee_to_ankle_left_sheet_material">
        <color rgba="0.223528996 0.219607994 0.219607994 1" />
      </material>
    </visual>
  </link>
  <link name="knee_and_ankle_assembly_2">
    <inertial>
      <origin xyz="0.00115301 -0.0493688 0.0192712" rpy="1.56763005 0.0587614288 -1.54089227" />
      <mass value="0.098123" />
      <inertia ixx="3.77897e-05" iyy="8.097e-05" izz="9.38649e-05" ixy="0" ixz="0" iyz="0" />
    </inertial>
    <visual name="knee_and_ankle_assembly_2_leg_spacer">
      <origin xyz="0.01606 0.14365 0.10925" rpy="-1.57079633 0 0" />
      <geometry>
        <mesh filename="assets/leg_spacer.stl" scale="1 1 1" />
      </geometry>
      <material name="knee_and_ankle_assembly_2_leg_spacer_material">
        <color rgba="0.647059023 0.647059023 0.647059023 1" />
      </material>
    </visual>
    <visual name="knee_and_ankle_assembly_2_left_knee_to_ankle_right_sheet">
      <origin xyz="0.01606 0.14365 0.10915" rpy="-1.57079633 0 0" />
      <geometry>
        <mesh filename="assets/left_knee_to_ankle_right_sheet.stl" scale="1 1 1" />
      </geometry>
      <material name="knee_and_ankle_assembly_2_left_knee_to_ankle_right_sheet_material">
        <color rgba="0.223528996 0.219607994 0.219607994 1" />
      </material>
    </visual>
    <visual name="knee_and_ankle_assembly_2_left_knee_to_ankle_left_sheet">
      <origin xyz="0.01606 0.14365 0.10915" rpy="-1.57079633 0 0" />
      <geometry>
        <mesh filename="assets/left_knee_to_ankle_left_sheet.stl" scale="1 1 1" />
      </geometry>
      <material name="knee_and_ankle_assembly_2_left_knee_to_ankle_left_sheet_material">
        <color rgba="0.223528996 0.219607994 0.219607994 1" />
      </material>
    </visual>
    <visual name="v_kobi_Leg_L_guard">
      <origin xyz="-0.00876255 -0.130511 0.0628376" rpy="-0.0376676431 1.51776101 0.795075334" />
      <geometry>
        <mesh filename="assets/kobi_Leg_L_guard.stl" scale="0.001 0.001 0.001" />
      </geometry>
      <material name="v_kobi_Leg_L_guard_material">
        <color rgba="0.99000001 0.839999974 0.540000021 1" />
      </material>
    </visual>
    <visual name="v_kobi_Fabric_L_legging">
      <origin xyz="-0.00876255 -0.130511 0.0628376" rpy="-0.0376676431 1.51776101 0.795075334" />
      <geometry>
        <mesh filename="assets/kobi_Fabric_L_legging.stl" scale="0.001 0.001 0.001" />
      </geometry>
      <material name="v_kobi_Fabric_L_legging_material">
        <color rgba="0.99000001 0.839999974 0.540000021 1" />
      </material>
    </visual>
  </link>
  <link name="foot_assembly">
    <inertial>
      <origin xyz="0.0113236 -0.019557 0.018746" rpy="-1.50518856 -0.00264732108 0.0233439617" />
      <mass value="0.113809" />
      <inertia ixx="6.49858e-05" iyy="0.000147952" izz="0.000169905" ixy="0" ixz="0" iyz="0" />
    </inertial>
    <visual name="foot_assembly_foot_side">
      <origin xyz="0.01606 0.2223 0.10905" rpy="-1.57079633 0 0" />
      <geometry>
        <mesh filename="assets/foot_side.stl" scale="1 1 1" />
      </geometry>
      <material name="foot_assembly_foot_side_material">
        <color rgba="0.980391979 0.713724971 0.00392156979 1" />
      </material>
    </visual>
    <visual name="foot_assembly_foot_bottom_tpu">
      <origin xyz="0.01656 0.2228 0.10955" rpy="-1.57079633 0 0" />
      <geometry>
        <mesh filename="assets/foot_bottom_tpu.stl" scale="1 1 1" />
      </geometry>
      <material name="foot_assembly_foot_bottom_tpu_material">
        <color rgba="0.305882007 0.298038989 0.278430998 1" />
      </material>
    </visual>
    <visual name="left_foot_bottom_tpu">
      <origin xyz="0.01656 0.2228 0.10955" rpy="-1.57079633 0 0" />
      <geometry>
        <mesh filename="assets/foot_bottom_tpu.stl" scale="1 1 1" />
      </geometry>
      <material name="left_foot_bottom_tpu_material">
        <color rgba="0.305882007 0.298038989 0.278430998 1" />
      </material>
    </visual>
    <collision name="left_foot_bottom_tpu_collision">
      <origin xyz="0.01656 0.2228 0.10955" rpy="-1.57079633 0 0" />
      <geometry>
        <mesh filename="assets/foot_bottom_tpu.stl" scale="1 1 1" />
      </geometry>
    </collision>
    <visual name="foot_assembly_foot_bottom_pla">
      <origin xyz="0.01656 0.2228 0.10955" rpy="-1.57079633 0 0" />
      <geometry>
        <mesh filename="assets/foot_bottom_pla.stl" scale="1 1 1" />
      </geometry>
      <material name="foot_assembly_foot_bottom_pla_material">
        <color rgba="0.305882007 0.298038989 0.278430998 1" />
      </material>
    </visual>
    <visual name="foot_assembly_foot_top">
      <origin xyz="0.01606 0.2223 0.10905" rpy="-1.57079633 0 0" />
      <geometry>
        <mesh filename="assets/foot_top.stl" scale="1 1 1" />
      </geometry>
      <material name="foot_assembly_foot_top_material">
        <color rgba="0.980391979 0.713724971 0.00392156979 1" />
      </material>
    </visual>
    <visual name="v_kobi_Foot_L_cover">
      <origin xyz="0.030415 -0.0429097 0.0627376" rpy="-0.0377014367 1.51775495 1.57904209" />
      <geometry>
        <mesh filename="assets/kobi_Foot_L_cover.stl" scale="0.001 0.001 0.001" />
      </geometry>
      <material name="v_kobi_Foot_L_cover_material">
        <color rgba="0.99000001 0.839999974 0.540000021 1" />
      </material>
    </visual>
  </link>
  <link name="hip_roll_assembly_2">
    <inertial>
      <origin xyz="0.000795081 -5.46541e-06 -0.03306" rpy="0.0373896768 0.00055783445 1.57010943" />
      <mass value="0.06648" />
      <inertia ixx="2.81818e-05" iyy="2.44554e-05" izz="1.42544e-05" ixy="0" ixz="0" iyz="0" />
    </inertial>
    <visual name="hip_roll_assembly_2_roll_motor_bottom">
      <origin xyz="0 -0.035 0.01905" rpy="0 -0 0" />
      <geometry>
        <mesh filename="assets/roll_motor_bottom.stl" scale="1 1 1" />
      </geometry>
      <material name="hip_roll_assembly_2_roll_motor_bottom_material">
        <color rgba="0.647059023 0.647059023 0.647059023 1" />
      </material>
    </visual>
    <visual name="hip_roll_assembly_2_roll_motor_top">
      <origin xyz="0 -0.035 0.01905" rpy="0 -0 0" />
      <geometry>
        <mesh filename="assets/roll_motor_top.stl" scale="1 1 1" />
      </geometry>
      <material name="hip_roll_assembly_2_roll_motor_top_material">
        <color rgba="0.901961029 0.901961029 0.901961029 1" />
      </material>
    </visual>
  </link>
  <link name="right_roll_to_pitch_assembly">
    <inertial>
      <origin xyz="-0.0184606 0.042292 0.0203549" rpy="-0.280113214 -0.0467536355 0.32278281" />
      <mass value="0.0807079" />
      <inertia ixx="4.12431e-05" iyy="3.14545e-05" izz="2.99716e-05" ixy="0" ixz="0" iyz="0" />
    </inertial>
    <visual name="right_roll_to_pitch_assembly_kori_roll_to_pitch_right">
      <origin xyz="0 0 0" rpy="0 -0 0" />
      <geometry>
        <mesh filename="assets/kori_roll_to_pitch_right.stl" scale="1 1 1" />
      </geometry>
      <material name="right_roll_to_pitch_assembly_kori_roll_to_pitch_right_material">
        <color rgba="0.909803987 0.572548985 0.164706007 1" />
      </material>
    </visual>
  </link>
  <link name="knee_and_ankle_assembly_3">
    <inertial>
      <origin xyz="3.84267e-06 0.057755 0.0189927" rpy="1.57013252 -0.00430318785 -1.5713499" />
      <mass value="0.07257" />
      <inertia ixx="1.87007e-05" iyy="4.23382e-05" izz="4.99022e-05" ixy="0" ixz="0" iyz="0" />
    </inertial>
    <visual name="knee_and_ankle_assembly_3_leg_spacer">
      <origin xyz="0.01606 -0.14365 -0.07215" rpy="1.57079633 -0 0" />
      <geometry>
        <mesh filename="assets/leg_spacer.stl" scale="1 1 1" />
      </geometry>
      <material name="knee_and_ankle_assembly_3_leg_spacer_material">
        <color rgba="0.647059023 0.647059023 0.647059023 1" />
      </material>
    </visual>
    <visual name="knee_and_ankle_assembly_3_left_knee_to_ankle_right_sheet">
      <origin xyz="0.01606 -0.14365 -0.07205" rpy="1.57079633 -0 0" />
      <geometry>
        <mesh filename="assets/left_knee_to_ankle_right_sheet.stl" scale="1 1 1" />
      </geometry>
      <material name="knee_and_ankle_assembly_3_left_knee_to_ankle_right_sheet_material">
        <color rgba="0.223528996 0.219607994 0.219607994 1" />
      </material>
    </visual>
    <visual name="knee_and_ankle_assembly_3_left_knee_to_ankle_left_sheet">
      <origin xyz="0.01606 -0.14365 -0.07205" rpy="1.57079633 -0 0" />
      <geometry>
        <mesh filename="assets/left_knee_to_ankle_left_sheet.stl" scale="1 1 1" />
      </geometry>
      <material name="knee_and_ankle_assembly_3_left_knee_to_ankle_left_sheet_material">
        <color rgba="0.223528996 0.219607994 0.219607994 1" />
      </material>
    </visual>
  </link>
  <link name="knee_and_ankle_assembly_4">
    <inertial>
      <origin xyz="0.00119435 -0.0491325 0.0172761" rpy="1.55716308 -0.0439107376 -1.54947401" />
      <mass value="0.0980927" />
      <inertia ixx="3.71621e-05" iyy="8.23054e-05" izz="9.48851e-05" ixy="0" ixz="0" iyz="0" />
    </inertial>
    <visual name="knee_and_ankle_assembly_4_leg_spacer">
      <origin xyz="0.01606 0.14365 0.10925" rpy="-1.57079633 0 0" />
      <geometry>
        <mesh filename="assets/leg_spacer.stl" scale="1 1 1" />
      </geometry>
      <material name="knee_and_ankle_assembly_4_leg_spacer_material">
        <color rgba="0.647059023 0.647059023 0.647059023 1" />
      </material>
    </visual>
    <visual name="knee_and_ankle_assembly_4_left_knee_to_ankle_right_sheet">
      <origin xyz="0.01606 0.14365 0.10915" rpy="-1.57079633 0 0" />
      <geometry>
        <mesh filename="assets/left_knee_to_ankle_right_sheet.stl" scale="1 1 1" />
      </geometry>
      <material name="knee_and_ankle_assembly_4_left_knee_to_ankle_right_sheet_material">
        <color rgba="0.223528996 0.219607994 0.219607994 1" />
      </material>
    </visual>
    <visual name="knee_and_ankle_assembly_4_left_knee_to_ankle_left_sheet">
      <origin xyz="0.01606 0.14365 0.10915" rpy="-1.57079633 0 0" />
      <geometry>
        <mesh filename="assets/left_knee_to_ankle_left_sheet.stl" scale="1 1 1" />
      </geometry>
      <material name="knee_and_ankle_assembly_4_left_knee_to_ankle_left_sheet_material">
        <color rgba="0.223528996 0.219607994 0.219607994 1" />
      </material>
    </visual>
    <visual name="v_kobi_Leg_R_guard">
      <origin xyz="-0.00967907 -0.131018 -0.0233988" rpy="3.09553735 1.50572771 -2.36094934" />
      <geometry>
        <mesh filename="assets/kobi_Leg_R_guard.stl" scale="0.001 0.001 0.001" />
      </geometry>
      <material name="v_kobi_Leg_R_guard_material">
        <color rgba="0.99000001 0.839999974 0.540000021 1" />
      </material>
    </visual>
    <visual name="v_kobi_Fabric_R_legging">
      <origin xyz="-0.00967907 -0.131018 -0.0233988" rpy="3.09553735 1.50572771 -2.36094934" />
      <geometry>
        <mesh filename="assets/kobi_Fabric_R_legging.stl" scale="0.001 0.001 0.001" />
      </geometry>
      <material name="v_kobi_Fabric_R_legging_material">
        <color rgba="0.99000001 0.839999974 0.540000021 1" />
      </material>
    </visual>
  </link>
  <link name="foot_assembly_2">
    <inertial>
      <origin xyz="0.0112842 -0.0195427 0.0189918" rpy="-1.62214032 0.00387282346 0.0267604732" />
      <mass value="0.114296" />
      <inertia ixx="6.60796e-05" iyy="0.000149426" izz="0.00017163" ixy="0" ixz="0" iyz="0" />
    </inertial>
    <visual name="foot_assembly_2_foot_side">
      <origin xyz="0.01606 0.2223 0.10905" rpy="-1.57079633 0 0" />
      <geometry>
        <mesh filename="assets/foot_side.stl" scale="1 1 1" />
      </geometry>
      <material name="foot_assembly_2_foot_side_material">
        <color rgba="0.980391979 0.713724971 0.00392156979 1" />
      </material>
    </visual>
    <visual name="foot_assembly_2_foot_bottom_tpu">
      <origin xyz="0.01656 0.2228 0.10955" rpy="-1.57079633 0 0" />
      <geometry>
        <mesh filename="assets/foot_bottom_tpu.stl" scale="1 1 1" />
      </geometry>
      <material name="foot_assembly_2_foot_bottom_tpu_material">
        <color rgba="0.305882007 0.298038989 0.278430998 1" />
      </material>
    </visual>
    <visual name="right_foot_bottom_tpu">
      <origin xyz="0.01656 0.2228 0.10955" rpy="-1.57079633 0 0" />
      <geometry>
        <mesh filename="assets/foot_bottom_tpu.stl" scale="1 1 1" />
      </geometry>
      <material name="right_foot_bottom_tpu_material">
        <color rgba="0.305882007 0.298038989 0.278430998 1" />
      </material>
    </visual>
    <collision name="right_foot_bottom_tpu_collision">
      <origin xyz="0.01656 0.2228 0.10955" rpy="-1.57079633 0 0" />
      <geometry>
        <mesh filename="assets/foot_bottom_tpu.stl" scale="1 1 1" />
      </geometry>
    </collision>
    <visual name="foot_assembly_2_foot_bottom_pla">
      <origin xyz="0.01656 0.2228 0.10955" rpy="-1.57079633 0 0" />
      <geometry>
        <mesh filename="assets/foot_bottom_pla.stl" scale="1 1 1" />
      </geometry>
      <material name="foot_assembly_2_foot_bottom_pla_material">
        <color rgba="0.305882007 0.298038989 0.278430998 1" />
      </material>
    </visual>
    <visual name="foot_assembly_2_foot_top">
      <origin xyz="0.01606 0.2223 0.10905" rpy="-1.57079633 0 0" />
      <geometry>
        <mesh filename="assets/foot_top.stl" scale="1 1 1" />
      </geometry>
      <material name="foot_assembly_2_foot_top_material">
        <color rgba="0.980391979 0.713724971 0.00392156979 1" />
      </material>
    </visual>
    <visual name="v_kobi_Foot_R_cover">
      <origin xyz="0.0306487 -0.0435511 -0.0234988" rpy="3.09555044 1.50573421 -1.56493627" />
      <geometry>
        <mesh filename="assets/kobi_Foot_R_cover.stl" scale="0.001 0.001 0.001" />
      </geometry>
      <material name="v_kobi_Foot_R_cover_material">
        <color rgba="0.99000001 0.839999974 0.540000021 1" />
      </material>
    </visual>
  </link>
  <link name="kobi_neck_link">
    <inertial>
      <origin xyz="-1.22705e-09 -1.77851e-12 0.0704035" rpy="0 -1.57079633 -2.08002184e-10" />
      <mass value="0.0802777" />
      <inertia ixx="1.43204e-05" iyy="7.75222e-05" izz="8.23309e-05" ixy="0" ixz="0" iyz="0" />
    </inertial>
  </link>
  <link name="kobi_head">
    <inertial>
      <origin xyz="0.00910942 -0.000563872 0.0320893" rpy="1.74872357 0.00327732591 -1.56646702" />
      <mass value="0.403074" />
      <inertia ixx="0.00201388" iyy="0.00394392" izz="0.00451348" ixy="0" ixz="0" iyz="0" />
    </inertial>
    <visual name="v_kobi_A_HeadShell">
      <origin xyz="0.057 0 -0.435" rpy="0 -0 1.57079633" />
      <geometry>
        <mesh filename="assets/kobi_A_HeadShell.stl" scale="0.001 0.001 0.001" />
      </geometry>
      <material name="v_kobi_A_HeadShell_material">
        <color rgba="0.99000001 0.839999974 0.540000021 1" />
      </material>
    </visual>
    <visual name="v_kobi_Face_Eye_R">
      <origin xyz="0.057 0 -0.435" rpy="0 -0 1.57079633" />
      <geometry>
        <mesh filename="assets/kobi_Face_Eye_R.stl" scale="0.001 0.001 0.001" />
      </geometry>
      <material name="v_kobi_Face_Eye_R_material">
        <color rgba="0.0500000007 0.0399999991 0.0399999991 1" />
      </material>
    </visual>
    <visual name="v_kobi_Face_Eye_L">
      <origin xyz="0.057 0 -0.435" rpy="0 -0 1.57079633" />
      <geometry>
        <mesh filename="assets/kobi_Face_Eye_L.stl" scale="0.001 0.001 0.001" />
      </geometry>
      <material name="v_kobi_Face_Eye_L_material">
        <color rgba="0.0500000007 0.0399999991 0.0399999991 1" />
      </material>
    </visual>
    <visual name="v_kobi_Face_Brow_R">
      <origin xyz="0.057 0 -0.435" rpy="0 -0 1.57079633" />
      <geometry>
        <mesh filename="assets/kobi_Face_Brow_R.stl" scale="0.001 0.001 0.001" />
      </geometry>
      <material name="v_kobi_Face_Brow_R_material">
        <color rgba="0.0500000007 0.0399999991 0.0399999991 1" />
      </material>
    </visual>
    <visual name="v_kobi_Face_Brow_L">
      <origin xyz="0.057 0 -0.435" rpy="0 -0 1.57079633" />
      <geometry>
        <mesh filename="assets/kobi_Face_Brow_L.stl" scale="0.001 0.001 0.001" />
      </geometry>
      <material name="v_kobi_Face_Brow_L_material">
        <color rgba="0.0500000007 0.0399999991 0.0399999991 1" />
      </material>
    </visual>
    <visual name="v_kobi_Face_Mouth_R">
      <origin xyz="0.057 0 -0.435" rpy="0 -0 1.57079633" />
      <geometry>
        <mesh filename="assets/kobi_Face_Mouth_R.stl" scale="0.001 0.001 0.001" />
      </geometry>
      <material name="v_kobi_Face_Mouth_R_material">
        <color rgba="0.0500000007 0.0399999991 0.0399999991 1" />
      </material>
    </visual>
    <visual name="v_kobi_Face_Mouth_L">
      <origin xyz="0.057 0 -0.435" rpy="0 -0 1.57079633" />
      <geometry>
        <mesh filename="assets/kobi_Face_Mouth_L.stl" scale="0.001 0.001 0.001" />
      </geometry>
      <material name="v_kobi_Face_Mouth_L_material">
        <color rgba="0.0500000007 0.0399999991 0.0399999991 1" />
      </material>
    </visual>
    <visual name="v_kobi_Face_Fang">
      <origin xyz="0.057 0 -0.435" rpy="0 -0 1.57079633" />
      <geometry>
        <mesh filename="assets/kobi_Face_Fang.stl" scale="0.001 0.001 0.001" />
      </geometry>
      <material name="v_kobi_Face_Fang_material">
        <color rgba="0.949999988 0.949999988 0.930000007 1" />
      </material>
    </visual>
    <visual name="v_kobi_Face_Blush_R">
      <origin xyz="0.057 0 -0.435" rpy="0 -0 1.57079633" />
      <geometry>
        <mesh filename="assets/kobi_Face_Blush_R.stl" scale="0.001 0.001 0.001" />
      </geometry>
      <material name="v_kobi_Face_Blush_R_material">
        <color rgba="0.959999979 0.660000026 0.550000012 1" />
      </material>
    </visual>
    <visual name="v_kobi_Face_Blush_L">
      <origin xyz="0.057 0 -0.435" rpy="0 -0 1.57079633" />
      <geometry>
        <mesh filename="assets/kobi_Face_Blush_L.stl" scale="0.001 0.001 0.001" />
      </geometry>
      <material name="v_kobi_Face_Blush_L_material">
        <color rgba="0.959999979 0.660000026 0.550000012 1" />
      </material>
    </visual>
    <visual name="v_kobi_Face_WhiteFace">
      <origin xyz="0.057 0 -0.435" rpy="0 -0 1.57079633" />
      <geometry>
        <mesh filename="assets/kobi_Face_WhiteFace.stl" scale="0.001 0.001 0.001" />
      </geometry>
      <material name="v_kobi_Face_WhiteFace_material">
        <color rgba="0.949999988 0.949999988 0.930000007 1" />
      </material>
    </visual>
    <visual name="v_kobi_Camera_lens">
      <origin xyz="0.057 0 -0.435" rpy="0 -0 1.57079633" />
      <geometry>
        <mesh filename="assets/kobi_Camera_lens.stl" scale="0.001 0.001 0.001" />
      </geometry>
      <material name="v_kobi_Camera_lens_material">
        <color rgba="0.0299999993 0.0299999993 0.0299999993 1" />
      </material>
    </visual>
  </link>
  <link name="kobi_arm_left">
    <inertial>
      <origin xyz="0.00428363 0.0207285 -0.0607075" rpy="0.069652838 -1.35030798 -2.0241867" />
      <mass value="0.0712396" />
      <inertia ixx="3.30136e-05" iyy="0.000232211" izz="0.000234104" ixy="0" ixz="0" iyz="0" />
    </inertial>
    <visual name="v_kobi_Arm_L_sleeve">
      <origin xyz="0.051 -0.1195 -0.307" rpy="0 -0 1.57079633" />
      <geometry>
        <mesh filename="assets/kobi_Arm_L_sleeve.stl" scale="0.001 0.001 0.001" />
      </geometry>
      <material name="v_kobi_Arm_L_sleeve_material">
        <color rgba="0.949999988 0.949999988 0.930000007 1" />
      </material>
    </visual>
    <visual name="v_kobi_Arm_L_cuff">
      <origin xyz="0.051 -0.1195 -0.307" rpy="0 -0 1.57079633" />
      <geometry>
        <mesh filename="assets/kobi_Arm_L_cuff.stl" scale="0.001 0.001 0.001" />
      </geometry>
      <material name="v_kobi_Arm_L_cuff_material">
        <color rgba="0.0900000036 0.170000002 0.419999987 1" />
      </material>
    </visual>
    <visual name="v_kobi_Arm_L_cuff_stripe">
      <origin xyz="0.051 -0.1195 -0.307" rpy="0 -0 1.57079633" />
      <geometry>
        <mesh filename="assets/kobi_Arm_L_cuff_stripe.stl" scale="0.001 0.001 0.001" />
      </geometry>
      <material name="v_kobi_Arm_L_cuff_stripe_material">
        <color rgba="0.949999988 0.949999988 0.930000007 1" />
      </material>
    </visual>
    <visual name="v_kobi_Arm_L_cuff_top">
      <origin xyz="0.051 -0.1195 -0.307" rpy="0 -0 1.57079633" />
      <geometry>
        <mesh filename="assets/kobi_Arm_L_cuff_top.stl" scale="0.001 0.001 0.001" />
      </geometry>
      <material name="v_kobi_Arm_L_cuff_top_material">
        <color rgba="0.0900000036 0.170000002 0.419999987 1" />
      </material>
    </visual>
    <visual name="v_kobi_Arm_L_mitten">
      <origin xyz="0.051 -0.1195 -0.307" rpy="0 -0 1.57079633" />
      <geometry>
        <mesh filename="assets/kobi_Arm_L_mitten.stl" scale="0.001 0.001 0.001" />
      </geometry>
      <material name="v_kobi_Arm_L_mitten_material">
        <color rgba="0.99000001 0.839999974 0.540000021 1" />
      </material>
    </visual>
  </link>
  <link name="kobi_arm_right">
    <inertial>
      <origin xyz="0.00427901 -0.0207285 -0.0606837" rpy="3.07129695 -1.35024531 2.02379676" />
      <mass value="0.0712104" />
      <inertia ixx="3.29986e-05" iyy="0.000232103" izz="0.000233996" ixy="0" ixz="0" iyz="0" />
    </inertial>
    <visual name="v_kobi_Arm_R_sleeve">
      <origin xyz="0.051 0.1195 -0.307" rpy="0 -0 1.57079633" />
      <geometry>
        <mesh filename="assets/kobi_Arm_R_sleeve.stl" scale="0.001 0.001 0.001" />
      </geometry>
      <material name="v_kobi_Arm_R_sleeve_material">
        <color rgba="0.949999988 0.949999988 0.930000007 1" />
      </material>
    </visual>
    <visual name="v_kobi_Arm_R_cuff">
      <origin xyz="0.051 0.1195 -0.307" rpy="0 -0 1.57079633" />
      <geometry>
        <mesh filename="assets/kobi_Arm_R_cuff.stl" scale="0.001 0.001 0.001" />
      </geometry>
      <material name="v_kobi_Arm_R_cuff_material">
        <color rgba="0.0900000036 0.170000002 0.419999987 1" />
      </material>
    </visual>
    <visual name="v_kobi_Arm_R_cuff_stripe">
      <origin xyz="0.051 0.1195 -0.307" rpy="0 -0 1.57079633" />
      <geometry>
        <mesh filename="assets/kobi_Arm_R_cuff_stripe.stl" scale="0.001 0.001 0.001" />
      </geometry>
      <material name="v_kobi_Arm_R_cuff_stripe_material">
        <color rgba="0.949999988 0.949999988 0.930000007 1" />
      </material>
    </visual>
    <visual name="v_kobi_Arm_R_cuff_top">
      <origin xyz="0.051 0.1195 -0.307" rpy="0 -0 1.57079633" />
      <geometry>
        <mesh filename="assets/kobi_Arm_R_cuff_top.stl" scale="0.001 0.001 0.001" />
      </geometry>
      <material name="v_kobi_Arm_R_cuff_top_material">
        <color rgba="0.0900000036 0.170000002 0.419999987 1" />
      </material>
    </visual>
    <visual name="v_kobi_Arm_R_mitten">
      <origin xyz="0.051 0.1195 -0.307" rpy="0 -0 1.57079633" />
      <geometry>
        <mesh filename="assets/kobi_Arm_R_mitten.stl" scale="0.001 0.001 0.001" />
      </geometry>
      <material name="v_kobi_Arm_R_mitten_material">
        <color rgba="0.99000001 0.839999974 0.540000021 1" />
      </material>
    </visual>
  </link>
  <joint name="left_hip_yaw" type="revolute">
    <axis xyz="0 0 1" />
    <limit lower="-0.523599" upper="0.523599" effort="1.91" velocity="5.24" />
    <origin xyz="-0.019 0.035 0.0459409" rpy="0 -0 0" />
    <parent link="trunk_assembly" />
    <child link="hip_roll_assembly" />
  </joint>
  <joint name="left_hip_roll" type="revolute">
    <axis xyz="0 0 1" />
    <limit lower="-0.436332" upper="0.436332" effort="1.91" velocity="5.24" />
    <origin xyz="0.01905 0 -0.046015" rpy="-1.57079633 -0 1.57079633" />
    <parent link="hip_roll_assembly" />
    <child link="left_roll_to_pitch_assembly" />
  </joint>
  <joint name="left_hip_pitch" type="revolute">
    <axis xyz="0 0 1" />
    <limit lower="-1.22173" upper="0.523599" effort="1.91" velocity="5.24" />
    <origin xyz="0.03915 0.047 0.03511" rpy="0 1.57079633 3.14159265" />
    <parent link="left_roll_to_pitch_assembly" />
    <child link="knee_and_ankle_assembly" />
  </joint>
  <joint name="left_knee" type="revolute">
    <axis xyz="0 0 1" />
    <limit lower="-1.5708" upper="1.5708" effort="1.91" velocity="5.24" />
    <origin xyz="0 -0.07865 0.0001" rpy="0 -0 0" />
    <parent link="knee_and_ankle_assembly" />
    <child link="knee_and_ankle_assembly_2" />
  </joint>
  <joint name="left_ankle" type="revolute">
    <axis xyz="0 0 1" />
    <limit lower="-1.5708" upper="1.5708" effort="1.91" velocity="5.24" />
    <origin xyz="0 -0.07865 0.0001" rpy="0 -0 0" />
    <parent link="knee_and_ankle_assembly_2" />
    <child link="foot_assembly" />
  </joint>
  <joint name="right_hip_yaw" type="revolute">
    <axis xyz="0 0 1" />
    <limit lower="-0.523599" upper="0.523599" effort="1.91" velocity="5.24" />
    <origin xyz="-0.019 -0.035 0.0459409" rpy="0 -0 0" />
    <parent link="trunk_assembly" />
    <child link="hip_roll_assembly_2" />
  </joint>
  <joint name="right_hip_roll" type="revolute">
    <axis xyz="0 0 1" />
    <limit lower="-0.436332" upper="0.436332" effort="1.91" velocity="5.24" />
    <origin xyz="0.01905 0 -0.046015" rpy="-1.57079633 -0 1.57079633" />
    <parent link="hip_roll_assembly_2" />
    <child link="right_roll_to_pitch_assembly" />
  </joint>
  <joint name="right_hip_pitch" type="revolute">
    <axis xyz="0 0 1" />
    <limit lower="-0.523599" upper="1.22173" effort="1.91" velocity="5.24" />
    <origin xyz="-0.03915 0.047 0.03511" rpy="0 1.57079633 -0" />
    <parent link="right_roll_to_pitch_assembly" />
    <child link="knee_and_ankle_assembly_3" />
  </joint>
  <joint name="right_knee" type="revolute">
    <axis xyz="0 0 1" />
    <limit lower="-1.5708" upper="1.5708" effort="1.91" velocity="5.24" />
    <origin xyz="0 0.07865 0.037" rpy="3.14159265 -0 0" />
    <parent link="knee_and_ankle_assembly_3" />
    <child link="knee_and_ankle_assembly_4" />
  </joint>
  <joint name="right_ankle" type="revolute">
    <axis xyz="0 0 1" />
    <limit lower="-1.5708" upper="1.5708" effort="1.91" velocity="5.24" />
    <origin xyz="0 -0.07865 0.0001" rpy="0 -0 0" />
    <parent link="knee_and_ankle_assembly_4" />
    <child link="foot_assembly_2" />
  </joint>
  <joint name="neck_yaw" type="revolute">
    <axis xyz="0 0 1" />
    <limit lower="-0.5236" upper="0.5236" effort="1.91" velocity="5.24" />
    <origin xyz="-0.057 0 0.123784" rpy="0 -0 0" />
    <parent link="trunk_assembly" />
    <child link="kobi_neck_link" />
  </joint>
  <joint name="neck_pitch" type="revolute">
    <axis xyz="0 1 0" />
    <limit lower="-0.1745" upper="0.1745" effort="1.91" velocity="5.24" />
    <origin xyz="0 0 0.0997" rpy="0 -0 0" />
    <parent link="kobi_neck_link" />
    <child link="kobi_head" />
  </joint>
  <joint name="shoulder_left" type="revolute">
    <axis xyz="0 1 0" />
    <limit lower="-2.356" upper="0.4363" effort="0.2" velocity="5.24" />
    <origin xyz="-0.051 0.1195 0.0954844" rpy="0 -0 0" />
    <parent link="trunk_assembly" />
    <child link="kobi_arm_left" />
  </joint>
  <joint name="shoulder_right" type="revolute">
    <axis xyz="0 1 0" />
    <limit lower="-2.356" upper="0.4363" effort="0.2" velocity="5.24" />
    <origin xyz="-0.051 -0.1195 0.0954844" rpy="0 -0 0" />
    <parent link="trunk_assembly" />
    <child link="kobi_arm_right" />
  </joint>
  <link name="imu" />
  <joint name="imu_frame" type="fixed">
    <origin xyz="-0.08 0 0.05" rpy="0 -0 0" />
    <parent link="trunk_assembly" />
    <child link="imu" />
  </joint>
  <link name="trunk" />
  <joint name="trunk_frame" type="fixed">
    <origin xyz="-0.024 0 0.0881909" rpy="0 -0 0" />
    <parent link="trunk_assembly" />
    <child link="trunk" />
  </joint>
  <link name="left_foot" />
  <joint name="left_foot_frame" type="fixed">
    <origin xyz="0.0005 -0.036225 0.01955" rpy="-1.57079633 0 0" />
    <parent link="foot_assembly" />
    <child link="left_foot" />
  </joint>
  <link name="right_foot" />
  <joint name="right_foot_frame" type="fixed">
    <origin xyz="0.0005 -0.036225 0.01955" rpy="-1.57079633 0 0" />
    <parent link="foot_assembly_2" />
    <child link="right_foot" />
  </joint>
  <link name="head" />
  <joint name="head_frame" type="fixed">
    <origin xyz="0.087 0 0.025" rpy="0 -0 0" />
    <parent link="kobi_head" />
    <child link="head" />
  </joint>
</robot>
