mgm136044/kobi-robot/(commit log)

2026-11-03 Add Kobi robot handover repository (printed-face variant)
    URDF and MuJoCo models, printable STLs, Blender file, trained walking and
    gesture policy (ONNX), reference gait, playback and evaluation tools,
    demo videos, Korean README and NOTICE. LCD-face variant is a placeholder.
    Unlicensed upstream meshes are not included; tools/fetch_upstream_meshes.py
    downloads them at a pinned commit and verifies SHA-256.
    [A_HeadShell_L.stl, A_HeadShell_R.stl, A_HeadShell_whole.stl, Arm_L_cuff.stl, Arm_L_cuff_stripe.stl, Arm_L_cuff_top.stl, Arm_L_mitten.stl, Arm_L_sleeve.stl]
2026-11-03 Add animation skeleton (rig) files and generator tools
    - tools/skeleton: extract_skeleton.py (MJCF -> skeleton.json + MuJoCo FK
    reference), build_rig.py (Blender armature, rigid skin, rest/home actions,
    FBX/GLB/BVH export), verify_rig.py + raw_formats.py (re-import and raw
    file checks against MuJoCo, max error ~7e-7 m)
    - printed_face/skeleton: kobi_rig.blend/.fbx/.glb, kobi_skeleton.bvh,
    skeleton.json, README.md (Korean); upstream meshes are not included
    - README.md: folder map and section 14
    [kobi_rig.blend]
2026-11-03 Add LCD-face package, first stage (model edition 6, BOM v11, masses, software handoff)
    - lcd_face/: MuJoCo scenes and Blender model of LCD edition 6, print STLs,
    BOM v11 (final order edition), slicer-measured part and body masses (mass/),
    walking/gesture demo videos of the fine-tuned policy
    - lcd_face/SOFTWARE_HANDOFF.md: joints and ranges, servo IDs, pin map, connector
    pin orders, power rules and servo voltage test, gamepad, masses for training
    and retargeting, what is final and what changes in edition 7b
    - policy/lcd_face/: fine-tuned policy and evaluation results
    - Head-mass training range corrected to 449.5-638.3 g (computed from the
    randomisation formula) in all package docs
    -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
    [A_HeadShell_L.stl, A_HeadShell_R.stl, A_HeadShell_whole.stl, Arm_L_mitten.stl, Arm_R_mitten.stl, Face_LCD_bezel.stl, Face_LCD_bezel_L.stl, Face_LCD_bezel_R.stl]
2026-11-03 Update LCD-face package to model 7b, BOM v12 and final assembly manual (stage 2)
    - Replace the edition-6 model with 7b (lighter head: 0.9 mm inner shell skin and
    lightening holes in three brackets; head 636.2 g solid, robot 2962.1 g):
    Blender file, MuJoCo scenes and assets, print STLs, parts tables, slicer masses.
    - BOM v12 replaces v11 (same purchase, corrected risk notes and tray side).
    - Add the final assembly manual v6h (PDF) and assembly video v6h under
    lcd_face/manual/, plus the two narrow hip-plate print files the manual needs
    (lcd_face/print/extra/).
    - Add the policy evaluation on the 7b scene (push falls 108/192).
    - Update READMEs, SOFTWARE_HANDOFF.md and NOTICE.md; edition-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
    [A_HeadShell_L.stl, A_HeadShell_R.stl, A_HeadShell_whole.stl, Head_frame_LCD.stl, LCD_mount.stl, Pi4_head_bracket.stl, bodies.csv, camera_mount_coupon.stl]
